talsh123/tokenizer-vivado/HANDOFF.md

# Continuation prompt (RTFC) — FPGA WordPiece Tokenizer

Paste this into the new chat, or just tell the new chat: "read HANDOFF.md and continue."
(RTFC = Role · Task · Format · Context.)

---

## ⭐⭐⭐ CURRENT STATUS — 2026-06-22 (FINAL; READ THIS FIRST; supersedes everything below)

**The #2 correctness fix is VERIFIED ON SILICON — 66/66. The TEMAC license blocker is cleared and the
hardening pass is complete on hardware.** What happened:
- **License:** the build failed only because the Tri-Mode Ethernet MAC **Hardware-Eval** license wasn't
  active at build time. The node-locked eval (`IP:Hardware_Eval`, valid to 19-oct-2026, Version Limit
  2026.10) covers Vivado 2025.2; after a relaunch it was honored. `get_license_status` is not a Tcl
  command in 2025.2 — use the GUI License Manager.
- **Build:** full non-incremental run; `write_bitstream` succeeded (`design_1_wrapper.bit`, 9.7 MB).
  Netlist check: `word_done_count` cells = 6 (>0), `word_done_pending` = 0.
- **On-board (port 7):** all golden vectors correct; **#2 proofs pass** — `summarize a long`→
  `7680 7849 4697 1037 2146` (1037 alone), `vocab t vocab`→`29536 3540 2497 1056 29536 3540 2497`
  (1056 alone). #7 robustness confirmed (empty/punct-only → `boundary-only, skipped`, no hang).
- **Remaining:** apply the book §6 corrections (now real: 64/66→66/66, `word_done_pending`→
  `word_done_count`, 2 reversed vectors, stale file:line cites); user to push the local commits.

Full detail in `JOURNAL.md` → "#2 fix VERIFIED ON SILICON — 66/66".

---

## ⭐⭐ STATUS — 2026-06-22 (earlier; superseded by the FINAL block above)

**The #2 correctness fix is sim-verified 66/66 but NOT yet on silicon. One live blocker: the Ethernet
MAC license.** See `CONTINUATION_PROMPT.md` for the full pick-up brief. Quick state:

- **#2 fix** (`word_done_pending` 1-bit → `word_done_count` 2-bit saturating counter in `trie_engine.v`):
  sim-verified **66/66** (`tb_word_boundary` 8/8, full corpus 66/66, `inspect_mismatch.py` 0). The board
  still runs the **pre-fix** bitstream (returns `along`/`tvocab` for `summarize a long`/`vocab t vocab`).
- **Why not on silicon yet — two build problems, in order:**
  1. **Auto-incremental synthesis** was reusing a pre-fix tokenizer partition → bitstream kept old logic
     even after a "clean" rebuild. FIXED: deleted the stale reference
     `uart.srcs/utils_1/imports/synth_1/design_1_wrapper.dcp` + disable incremental
     (`set_property AUTO_INCREMENTAL_CHECKPOINT 0 [get_runs synth_1]`).
  2. **TEMAC license (LIVE BLOCKER):** the full re-synthesis re-processed `axi_ethernet_0`;
     `write_bitstream` fails `[Common 17-69] tri_mode_eth_mac requires > Design Linking license`. Need the
     free **Tri-Mode Ethernet MAC hardware-evaluation** license (AMD Product Licensing → add eval core →
     node-locked `.lic` → Vivado Help → Manage License → Load License). Eval = time-limited bitstream
     (fine for demo).
- **Verify the fix is in the bitstream BEFORE flashing** (the reliable way — do NOT grep `uart.runs`,
  the `.rpx` reports are binary): `open_run impl_1` then
  `get_cells -hierarchical -filter {NAME =~ *word_done_count*}` must be > 0.
- **Vitis #7/#8/#10** coded + committed (`a403add`, `7b400dc`); pending on-board reverify after the new
  `.xsa`/BSP rebuild (re-run `lwip_echo_server/src/phy_patch/apply_phy_patch.ps1` if the BSP regenerates).
- **Book** (`final_project_book.pdf`) audited: 2 reversed vectors (`tokenization`→`19204 3989`,
  `internationalization`→`2248 3989`), and it describes the pre-fix 64/66 state — update to 66/66 once on
  silicon. Detail in `JOURNAL.md` "Build saga + book verification".

**Next action:** load the TEMAC eval license → `reset_target all [get_files design_1.bd]` →
`generate_target all …` (do not interrupt) → build → `get_cells` check → flash → on-board reverify
(`summarize a long`→`7680 7849 4697 1037 2146`, `vocab t vocab`→`29536 3540 2497 1056 29536 3540 2497`).

---

## ⭐ CURRENT STATUS — 2026-06-21 (read this first; the RTFC below is the original, now stale)

**The entire code review is DONE and VERIFIED ON SILICON — H1, H2, M1, M2, M3, M4, P1, L1, L2, L3 —
plus the embed-class boundary fix and two synthesis-warning cleanups.** Full per-problem record with
verification evidence is in `JOURNAL.md`. Headlines:

- **RTL** (`trie_engine.v`, `pre_tokenizer.v`, `tokenizer_axi_lite.v`): H1/H2/M1 (trie greedy-match
  corner cases), M2 (output-FIFO overflow detect, STATUS bit 2), P1 (pure valid/ready flow control +
  trie input skid + boundary char capture — closes the wasted-handshake-cycles issue), M4 RTL
  (`pipeline_busy` STATUS bit 3), L3 (AXI read `read_addr_serviced` gate), plus the char_buf and
  tok_word_busy synthesis-warning cleanups.
- **Firmware** `echo.c`: M3 (raw-byte forwarding, no synthetic boundary) + M4 (drain-on-
  `pipeline_busy`, boundary-aware final drain — the blind ~500 µs delay is gone).
- **Memory generator** `vocab_parser.py` (in `...\OneDrive\...\BERT\flat_trie_compression`): L1
  (token-id `.mem` written 4-hex to match the 16-bit register).
- **Verification:** `tb_axi_pipeline` green (slow-cadence + new digit cases included); full xsim suite
  passes; **on-board over TCP every known vector is correct** and `2024`→`16798 2549`,
  `abc123`→`5925 12521 2509` match sim exactly with no `[UNK]`. Timing closes clean; the 32 char_buf
  and the token-id width synth warnings are gone.

**⭐ Optimization R2 (AXI-Stream + AXI DMA datapath) is DONE and VERIFIED ON-BOARD (2026-06-21).**
The byte-by-byte AXI-Lite send/drain in `echo.c` is replaced by an AXI DMA: MM2S streams bytes into
the tokenizer's new 8-bit `s_axis`, the 16-bit `m_axis` streams tokens back to S2MM, and firmware
reads the new `TOKEN_COUNT (0x0C)` register for the count. On-board, every golden vector is correct
and latency is **~14× faster than MMIO on the pangram** (~1000 µs → **70 µs**), with the gap widening
on longer input (DMA latency is *flat* ~54–72 µs; MMIO grew linearly). Full record — firmware final
form, the two bring-up bugs, and the results table — is in `JOURNAL.md` (“On-board bring-up &
verification (R2 complete)”). Two bring-up lessons worth carrying forward:
- **Stale/old bitstream masquerades as a hardware fault.** R2 first failed with `TOK_COUNT=0` exactly
  like a broken `s_axis`; two temporary firmware self-tests (MMIO-feed core test + DMA-from-known-DDR
  test) plus a `design_1.hwh` connectivity check proved the hardware was sound — the programmed
  bitstream simply wasn't the final one. Regenerate → re-read `.xsa` → re-apply PHY patches → rebuild.
- **Zero-token transfers hang the DMA.** `m_axis_tlast` rides on a token, so a boundary-only segment
  (telnet sends a word and its `\r\n` as separate TCP segments) produces no token → no TLAST → S2MM
  waits → the lwIP callback stalls → connection abort. Fix: `recv_callback` skips any segment with no
  word character (never launches a 0-token DMA), and the poll timeout was cut 100M→1M as a backstop.

**⭐ FPGA-vs-CPU evaluation is DONE (the report's "why FPGA" data, 2026-06-21).** Full pipeline in
`analysis/` (one shared 66-line corpus → CPU HuggingFace benchmark + FPGA xsim measurement TB →
merge → 5 figures). Headlines: **97% exact word-token match** vs bert-base-uncased (FPGA omits
13.6% punctuation tokens by design); CPU jitter up to **~255 µs** spikes vs FPGA **zero** (cycle-exact
determinism); and energy **~150–285× better per token** (tokenizer fabric **51 mW** via `report_power`
vs measured **~30 W** CPU package on a Ryzen 7 7435HS; 24.0 M vs 84.3 k tokens/Joule). Detail +
numbers + the figure list are in `JOURNAL.md` ("Power / energy result + plots"). **Known limitation
documented:** a one-character word immediately following a multi-subword word is merged with the next
word (`a long`→`along`, hit 2/66 lines) — residual backtracking/boundary state, an H1-class sibling;
deferred as optional (a fix only needs an xsim re-run, no re-flash).

**The embed `[UNK]` "open issue" from the previous handoff is RESOLVED — and it was never an RTL
bug.** The board was running a STALE bitstream: the Vitis run configuration programs a cached
`lwip_echo_server/_ide/bitstream/design_1_wrapper.bit` (it was a month old) while loading a fresh
ELF. **Lesson for next time: when on-board behavior contradicts a clean xsim run, suspect the
programmed bitstream first** — point the Vitis launch config at `uart.runs/impl_1/design_1_wrapper.bit`.

**BSP PHY patches — RE-APPLY AFTER EVERY BSP REGEN (a `.xsa` re-read wipes them):** `xadapter.c`
(`axieth_link_status` first_link/hardcode-100) and `xaxiemacif_physpeed.c` (`get_IEEE_phy_speed`
Realtek `0x001c` branch). Confirm before every board build.

---

## ⭐ HARDENING PASS (2026-06-21): #2 fixed, batch sealed, Vitis items pending

A six-item triage (#1 timing, #2 correctness, #7 zero-token DMA, #8 cache, #9 calib reset, #10 PHY).
Rule: verify all RTL/BD in sim → ONE implementation run → Vitis items. Status:

| # | Item | Resolution |
|---|---|---|
| #2 | 1-char-word merge | **FIXED, VERIFIED ON SILICON 66/66** (2026-06-22, `word_done_count` counter). |
| #1 | WNS −0.374 ns | **Documented benign** — ASYNC_REG CDC syncs inside the AMD Ethernet MAC; user logic +0.6 ns. No change. |
| #7 | zero-token DMA TLAST | **DONE in `echo.c`** (Vitis `a403add`): `has_word` guard kept + `tokenizer_dma_recover()` resets the DMA on MM2S/S2MM timeout. Pending on-board verify. |
| #9 | `init_calib_complete` | **DEFERRED** — correct fix is AND it with `clk_wiz_1/locked` into `rst_clk_wiz_1_100M/dcm_locked` (NOT the MIG reset block); reset surgery, theoretical race, deferred to protect the one run. BD restored to known-good. |
| #8 | cache invalidate `ntok×2` | **DONE in `echo.c`** (Vitis `a403add`): post-transfer invalidate sized to `ntok×2` (TOK_COUNT read first), not the full 2 KB. Pending on-board verify. |
| #10 | durable PHY patch | **DONE** (Vitis `a403add`/`7b400dc`): canonical `*.c.golden` copies in `lwip_echo_server/src/phy_patch/` + `apply_phy_patch.ps1` one-command re-apply after any BSP regen (`.golden` ext stops the IDE auto-adding them → would dup-link). |

**Phase-1 Vivado batch = just #2; Vitis #7/#8/#10 are coded + committed.**

**⚠️ CRITICAL build step (cost a whole build+flash cycle on 2026-06-21):** the tokenizer is a Vivado
`module_ref`. After editing `trie_engine.v`/`pre_tokenizer.v`/`tokenizer_axi_lite.v`, **Reset Output
Products → Generate Output Products (Global) → `reset_run synth_1`** BEFORE Generate Bitstream — else
synthesis reuses the cached pre-edit netlist and the bitstream silently keeps OLD logic (source + sim
look fixed; the board runs old behavior, and golden vectors mask it). **Verify before flashing** (use
`get_cells`, NOT grep — the `.rpx` reports are binary and false-match): `open_run impl_1` then
`get_cells -hierarchical -filter {NAME =~ *word_done_count*}` must be >0 and `*word_done_pending*` must
be 0. The actual root cause turned out to be auto-incremental synthesis (not module-ref caching) — see
memory `vivado-module-ref-stale-synth` and JOURNAL "stale module-ref synthesis catch".

**On-board reverify status — DONE (2026-06-22):** golden vectors confirmed on silicon
(tokenizer/DMA/Ethernet all good) **and** the #2 fix verified on the board —
`summarize a long`→`7680 7849 4697 1037 2146` and `vocab t vocab`→`29536 3540 2497 1056 29536 3540 2497`
(1037/1056 standing alone). **66/66 on silicon.** Full detail in `JOURNAL.md` ("#2 fix VERIFIED ON
SILICON" + "On-board reverify" + "Bug #2 fixed" + "Vitis hardening").

**Tooling (in `analysis/`):** `run_all_tbs.tcl` runs all 12 testbenches in one action with a PASS/FAIL
summary; `gen_reports.tcl` regenerates post-impl utilization + timing (+ copies the `constrs_1` xdc).
If a Generate-Bitstream run shows `CRITICAL WARNING [BD 41-759] … s_axis_tvalid tied-off`, the
DMA→tokenizer input came unwired (module-ref staleness) — reconnect `axi_dma_0/M_AXIS_MM2S →
tokenizer_axi_lite_0/s_axis` and re-validate before flashing.

---

## ⭐ STAGE 5 — Partner evidence pack (2026-06-21): WHERE EVERYTHING RAFI ASKED FOR IS SAVED

**All P0 (book-blocking) deliverables are DONE, plus P1 #11 (waveform).** The single source of truth
is **`analysis/evidence/EVIDENCE_INDEX.md`** — it maps every deliverable → status → file → book
chapter, and has a capture-checklist for anything still outstanding. Quick access map:

| Rafi's deliverable | Saved at | How to open / regenerate |
|---|---|---|
| Six graphs (data + scripts) | `analysis/figures/*.png`, data `analysis/results/*.csv`, scripts `analysis/*.py` | `py ./plot_results.py` (figures); §A of the index maps each figure→CSV→script |
| Energy calculation sheet | `analysis/evidence/ENERGY_CALCULATION.md` | open in any markdown viewer; inputs in `results/power.csv` + `results/power_fpga.rpt` |
| DMA latency sweep | sim: `analysis/results/fpga_results.csv` (66-pt); board: 54–72 µs (JOURNAL "R2 complete") | `py ./gen_corpus_tb.py` → run `tb_corpus_perf` in xsim |
| CPU benchmark (script/log/settings) | `analysis/evidence/BENCHMARK_SETUP.md` + `analysis/cpu_tokenizer_benchmark.py` + `results/cpu_results.csv`, `results/cpu_throughput.csv` | `py ./cpu_tokenizer_benchmark.py` |
| Corpus + 2/66 mismatch list | `analysis/corpus.txt` + `analysis/evidence/MISMATCH_REPORT.md` | `py ./inspect_mismatch.py` to re-decode |
| `report_utilization` | `analysis/results/utilization_impl.rpt`, `utilization_hier.rpt` | `source analysis/gen_reports.tcl` (Vivado, project open) |
| `report_timing_summary` + `.xdc` | `analysis/results/timing_summary.rpt`, `timing_worst_paths.rpt`, `Nexys-Video-Master.xdc` | same script; WNS **−0.374 ns** (does not fully close — see below) |
| Block design screenshot | `analysis/figures/block_design.jpg` | open image |
| Address Editor screenshot | `analysis/figures/address_editor.jpg` | open image |
| `tb_axi_dma` PASS transcript | `analysis/evidence/tb_axi_dma_transcript.txt` | re-run: set `tb_axi_dma` top → `restart; run all` (NOT a bare `run all` — that hits a stale-snapshot 5 ms timeout) |
| DMA waveform (m_axis_tlast/TOKEN_COUNT) | `analysis/figures/waveform.jpg` | open image |

**One-shot Vivado report dump:** `source c:/Users/talsh/.Xilinx/projects/uart/analysis/gen_reports.tcl`
(writes utilization + timing + copies the user `.xdc` into `analysis/results/`, prints headline WNS).

### Stage 5 OPEN ITEMS (remaining — none block the P0 book chapters)
- **P1 #12 — board TCP regression log:** optional; telnet the corpus, capture the UART `DMA total: …
  µs | Tokens: …` lines → `analysis/evidence/board_tcp_regression.txt`. Turns the 3-point board
  latency into a real sweep.
- **P1 #13 — Route B (Quartus/Icarus) artifacts:** the partner's *other* implementation route, NOT in
  this repo. Rafi/partner owns this.
- **P1 #14 — Mermaid → PNG/SVG:** the architecture diagrams live in the **book draft**, not this repo;
  export each via mermaid.live (PNG **and** SVG) for Word/PDF. Book-side task.
- **P2 #15 — board photo + demo screenshot:** optional, for the defense.
- **Waveform input EOP (cosmetic):** `figures/waveform.jpg` shows the output `m_axis_tlast`; an
  optional left-scroll snip of the input burst would also show `s_axis_tlast`.

### Documented honest limitation (state, don't hide, in the report)
1. **Timing does not fully close:** WNS −0.374 ns on 2 of 87,343 endpoints. The board runs correctly
   (those paths have margin under real conditions); full closure is future work. Inspect with
   `analysis/results/timing_worst_paths.rpt`.

(The former item 2 — the 1-char-word-after-multipiece bug, `a long`→`along`, `t vocab`→`tvocab` — is
**no longer a limitation: fixed and verified on silicon 2026-06-22** (`word_done_count` counter,
66/66). Detail in `MISMATCH_REPORT.md` and JOURNAL "#2 fix VERIFIED ON SILICON".)

---

## 🔜 OPEN ITEMS — handoff to Rafi

**✅ DONE — DMA instead of byte-by-byte AXI-Lite polling (optimization R2).** Verified on-board
2026-06-21 (~14× faster on the pangram; details above and in `JOURNAL.md`). The byte-banging is gone:
the tokenizer IP has 8-bit `s_axis` / 16-bit `m_axis` stream ports + a `TOKEN_COUNT (0x0C)` register,
an AXI DMA moves bytes/tokens, and `echo.c`'s `recv_callback` does one DMA round-trip per segment.
The remaining R2-adjacent niceties are optional (see below).

**✅ DONE — the three final-report "why FPGA" deliverables below are all COMPLETE** (2026-06-21; data
+ figures in `analysis/`, numbers in `JOURNAL.md` → "Power / energy result + plots"). The original
task descriptions are kept here for reference; what's left is report write-up only. Quick status:
(1) performance comparison ✅ (latency core-vs-overhead + throughput + jitter, real corpus);
(2) power/energy ✅ (`report_power` 51 mW vs measured CPU ~30 W → ~150–285× tokens/Joule);
(3) measurement→CSV→plots pipeline ✅ (`analysis/*.py`, `results/*.csv`, `figures/*.png`).

**Original task detail (now done — for reference; these were the report's "why FPGA" argument).
The CPU-vs-FPGA benchmark script lives at `analysis/cpu_tokenizer_benchmark.py`:**

1. **Fair FPGA-vs-CPU performance comparison (apples-to-apples).** The existing `tb_perf_measurement`
   number is NOT pure fabric latency despite its header: `hw_cycles` includes the AXI-Lite send
   cadence (`tok_send_byte` ~10 cyc/byte) and fixed `repeat(500)`/`repeat(2000)` wait loops, so it
   *over*-states FPGA latency (the real win is bigger). To make it fair:
   - **FPGA side:** measure the *true fabric latency* — first character into the trie
     (`pt_out_char_valid`) to the last token emitted (`tok_out_valid`), with input fed at full speed
     (1 byte/clock via the `s_axis` stream / DMA), not the slow AXI-Lite send. Needs a clean
     measurement TB (can reuse the 3 sentences below and the internal-signal probe approach).
   - **CPU side:** the benchmark script uses `BertTokenizer` (the SLOW pure-Python tokenizer) but the
     write-up calls it "Rust-accelerated" — that's `BertTokenizerFast`. Use `BertTokenizerFast` (or
     `AutoTokenizer`) for the fair comparison and **attach the actual console output** to the report.
   - **Framing:** state the CPU clock (~3-5 GHz) next to the FPGA's 100 MHz (the headline is
     specialized HW winning at ~1/30th the clock); fold in the Test-2 16-vs-15 sim artifact as a
     noted caveat (it inflates that test's cycle count).
   - Same 3 sentences as `tb_perf_measurement`: pangram (9 tok), "unquestionably the embedding..."
     (15 tok), "machine learning..." (44 tok). CPU baselines used so far: 26.7 / 99.5 / 180.4 us.

2. **Power-consumption comparison (perf-per-watt is the real FPGA argument).** Latency is only half
   the story; the stronger case for a specialized datapath is energy. To do:
   - **FPGA side:** Vivado **`report_power`** (post-implementation, ideally with realistic switching
     activity / a SAIF captured from the perf simulation) for the tokenizer's dynamic + static power;
     a board-level measurement if feasible.
   - **CPU side:** the CPU's power during tokenization (package power / TDP, or a measured figure).
   - Report it as **energy per tokenization** (latency x power) or tokens/Joule, not just watts — a
     100 MHz datapath should crush a multi-GHz CPU on energy even where latency is close.

3. **Automated measurement -> CSV -> plotting pipeline (the report's figures).** Tie tasks 1 and 2
   together with reproducible data + graphs:
   - **TB -> CSV:** the measurement testbench uses `$fopen`/`$fwrite`/`$fclose` to emit one row per
     test -- sentence name, char count, token count, fabric cycles, fabric latency (ns @ 100 MHz),
     throughput (chars/s, tokens/s). NOTE: the FPGA fabric is **deterministic** (identical cycle
     count every run -> zero jitter; a hard real-time guarantee). **Jitter is a CPU metric** -- get
     it from the Python benchmark's distribution (min/max/std over the 10000 runs).
   - **Python benchmark -> CSV:** per sentence, the `BertTokenizerFast` latency stats (avg, min, max,
     std).
   - **Vivado `report_power` -> FPGA power**; CPU package power/TDP for the CPU side (power is NOT
     available from simulation -- separate source merged in the script).
   - **Plotting script (pandas + matplotlib):** latency FPGA-vs-CPU (CPU with jitter error bars,
     FPGA as a deterministic point/line), speedup vs input length, and energy-per-tokenization /
     tokens-per-Joule. These become the headline report figures.

**OPTIONAL — NOT required for the final report (do only if time allows):**
- **R2 follow-up — tighten the post-transfer cache invalidate.** `tokenizer_dma_run` invalidates the
  full 2 KB token buffer (`MAX_TOKENS*2`) every call; invalidating only `ntok*2` bytes after the
  count is known would cut the fixed overhead that dominates the small-input latency (the flat
  ~54–72 µs), sharpening the DMA-vs-MMIO curve for the report.
- **R2 follow-up — cross-segment word reassembly in DMA mode.** The DMA `recv_callback` treats each
  TCP segment as self-contained (it appends `\n` to flush a mid-word segment), so a word *deliberately*
  split across two TCP segments tokenizes per-segment instead of being rejoined (the old MMIO M3
  behavior). Telnet/line-buffered input is unaffected; only matters for clients that split a word.
  Re-add by buffering received bytes until a real boundary before launching the DMA.
- **Connect `init_calib_complete`** in the Vivado block design (currently floating). Wiring it in —
  e.g. gating the processor/system reset — prevents the CPU touching DDR3 before the MIG finishes
  calibration. Real robustness fix, BD-level.
- **`tb_perf_measurement` Test 2 = 16 tokens vs 15** — a simulation-only timing artifact (hardware
  gives the correct 15). Now folded into the performance-comparison task above (note it as a caveat
  or fix the TB timing when redoing the measurement).
- **Elegant RTL8211E PHY bring-up** — the BSP patches are the pragmatic fix; a proper fix implements
  the full RTL8211E auto-negotiation register sequence so the stock-BSP-vs-RTL8211E mismatch is
  handled cleanly. Future work / report discussion only.
- **Relocate the 9 `.mem` files out of `C:/Users/talsh/Downloads/`** into the project tree. The
  `.xpr` sources them from `$PPRDIR/../../../Downloads/*.mem` — functional but fragile (a cleared
  Downloads folder breaks the build). Recommended before final submission.
- Cosmetic: remove the `===== TEMP DEBUG PROBE =====` block in `tb_axi_pipeline.v` for the final
  clean version (kept for now; harmless).

**Vivado/Vitis gotchas (still apply):** the editor buffer can overwrite disk on sim launch and xsim
reuses stale compiled snapshots — **Reset** the sim/run to force a real recompile, and close a file
in the Vivado editor before editing it externally. After any RTL change: regenerate the bitstream,
re-export the `.xsa`, AND re-point the Vitis launch config at the fresh
`impl_1/design_1_wrapper.bit` before programming (re-applying the BSP PHY patches after the BSP regen).

---

## ROLE
You are an experienced FPGA / digital-design and embedded-firmware engineer taking
over an in-progress hardening + optimization effort on a hardware **BERT WordPiece
tokenizer**. You think in clock cycles, FSM states, BRAM ports, and AXI handshakes;
you write synthesizable Verilog and MicroBlaze C; you work **one problem at a time**
and keep an engineering journal for the user's final report (the user is a student;
their partner and professor will read the code and journal).

## TASK
Continue the work.

**Immediate step:** the user is re-running `tb_axi_pipeline` in Vivado after a fix.
Interpret that transcript first.
- If it prints `AXI PIPELINE TESTS PASSED`: mark **P1** and **M4** verified in
  `JOURNAL.md`, then move to the next pending item.
- If it fails: the TB now prints the actual token IDs per test and flushes leftovers
  between tests, so use the printed values to tell apart (a) a remaining
  `pipeline_busy` timing issue from (b) a real tokenization regression in the **P1**
  pre-tokenizer redesign (a duplicated/lost character shows as specific wrong IDs),
  and fix it.

Then continue the remaining items (see Context → PENDING). For every new problem:
give the user a short plain-language **background + which engineering field it
belongs to**, apply a **surgical** fix, add a `JOURNAL.md` entry, and (for RTL)
write/extend a self-checking testbench.

## FORMAT
- Per problem: (1) plain background + engineering discipline; (2) the fix as
  minimal RTL/C edits; (3) a `JOURNAL.md` entry (engineering field, background,
  defect, fix, verification plan, status); (4) a Vivado/board verification plan
  (+ testbench if RTL).
- Be concise; recommend a path, don't over-survey.
- **Verification is ALWAYS done by the user** — Vivado xsim for RTL, board + TCP
  (telnet/netcat to port 7) for firmware. You author tests and instructions; the
  user runs them and pastes results. After each result, update the journal status.

## CONTEXT

**Working dir:** `c:\Users\ENTEL\FPGA tal` (NOT a git repo). Three sub-projects:
- `tokenizer-vivado/` — the RTL. Custom IP `tokenizer_axi_lite` wraps
  `top_tokenizer` → `pre_tokenizer` + `trie_engine`. Hand-written sources in
  `uart.srcs/sources_1/new/`, testbenches in `uart.srcs/sim_1/new/`.
- `tokenizer-csr/` — Python `vocab_parser.py` builds the dual CSR tries and emits
  the `.mem` files from `vocab.txt` (bert-base-uncased, 30,522 tokens).
- `tokenizer-vitis/` — MicroBlaze firmware `lwip_echo_server/src/echo.c`: a TCP
  server on port 7 that streams text to the IP and returns token IDs.

**READ THESE FIRST (source of truth, in the working dir):**
- `JOURNAL.md` — full per-problem record (every fix, with verification + status).
- `CODE_REVIEW.md` — the original findings (H1, H2, M1–M4, L1–L3).
- `OPTIMIZATION_OPTIONS.md` — speed/efficiency options (F1 done; A1, A2, A3, C1,
  D1, R1, R2, F2, F3, E1 pending — pursue only if the user asks).
- The auto-loaded memory files (`toolchain-vivado-only`,
  `comment-style-no-internal-ids`).

**HARD CONVENTIONS (also in memory — do not violate):**
- **Vivado only.** Do NOT run the locally-installed ModelSim/Intel tools (not even
  for a syntax check). Do NOT alter the canonical `tokenizer-csr/*.mem` files for
  any simulator's sake.
- **Comments in synthesizable RTL** must be plain and self-explanatory for the
  partner/professor — **no internal IDs** (no `H1`/`M1`/`FIX:`/`(M2)` etc.). The
  bug→fix mapping lives in `JOURNAL.md`. Testbenches may keep their `H1/M1/M2`
  labels (the user chose to leave those).
- **Output token IDs must always stay identical to HuggingFace bert-base-uncased.**
- Verify edits by re-reading; check `begin/end`, `task/endtask`, `module/endmodule`
  balance (e.g. `sed 's://.*::' f.v | grep -ow begin|wc -l`) since you can't run a
  compiler here.

**ARCHITECTURE (quick):** TCP → input FIFO (256×8) → `pre_tokenizer` (lowercase,
10-bit char map, boundary detect, **pure valid/ready flow control**) → `trie_engine`
(greedy longest-match WordPiece over two CSR tries — root 56,719 nodes/56,718 edges,
continuation 7,864/7,863; per trie 4 BRAM arrays: row_ptr 32b, edges 32b,
is_terminal 8b, token_ids 16b; 10-state FSM doing a binary search per node; 32×10
LUTRAM backtracking buffer) → output FIFO (256×16) → AXI-Lite → MicroBlaze.
**STATUS register bits:** 0 = input has space, 1 = token available, 2 = output
overflow (sticky; write to STATUS clears it), 3 = pipeline_busy.

**DONE & VERIFIED in Vivado (details in JOURNAL):**
- **H1** spurious `[UNK]`/dropped token at a word boundary during backtracking (trie FSM).
- **H2** binary-search index underflow at node 0 (trie).
- **M1** word longer than the 32-entry buffer → safe single `[UNK]` (trie).
- **M2** silent output-FIFO overflow → sticky detect flag on STATUS bit 2 (axi wrapper).

**DONE, AWAITING VERIFICATION:**
- **M3** (`echo.c`): forward raw bytes, no per-TCP-segment synthetic boundary →
  words split across segments tokenize correctly. Needs an on-board TCP check.
- **M4** (`echo.c` + RTL): replaced the ~500 µs blind drain delay with a real
  `pipeline_busy` (STATUS bit 3) + drain-while-sending; this also closes M2's
  *prevention* side. Needs Vivado + on-board check.
- **P1** (`pre_tokenizer` + `trie_engine`): removed the pre-tokenizer's two-phase
  word-boundary ack handshake (now pure valid/ready flow control); the trie lowers
  `ready` on `S_IDLE→S_EMIT`; the trie exposes a `busy` output.
- **CURRENT DEBUG STATE:** `tb_axi_pipeline`'s first run FAILED → diagnosed a
  1-cycle `pipeline_busy` *false-idle* at word boundaries (the `out_word_done`
  pulse ended at cycle T but the trie lowered `ready` only at T+2) → **fixed** by
  driving `pipeline_busy` from the trie's new
  `busy = (state!=S_IDLE) || !ready || replaying || word_done_pending`
  (`top_tokenizer`: `pipeline_busy = pt_busy || trie_busy`). TB hardened to print
  token IDs and isolate tests. **Re-run is pending — interpret it before anything else.**

**TESTBENCHES** (`uart.srcs/sim_1/new/`): `tb_fixes.v` (H1/H2/M1 — passed),
`tb_m2_overflow.v` (M2 — passed), `tb_axi_pipeline.v` (P1/M4 — re-run pending).
The original tbs (`tb_trie_engine`, `tb_top_tokenizer`, `tb_tokenizer_axi_lite`,
`tb_pre_tokenizer`, `tb_perf_measurement`) are unchanged; note `pre_tokenizer` and
`top_tokenizer` gained output ports, so those two original tbs now show a harmless
"unconnected output" warning.

**PENDING after `tb_axi_pipeline`:**
1. On-board (TCP) verification of M3 + M4 (latency drop vs old build; split-word
   correctness — e.g. send `embed`, pause, `ding\n` → expect `embedding`).
2. Remaining review items: **L1** (`.mem` hex widths don't match reg widths —
   cosmetic in Vivado, only via the Python generator), **L3** (AXI read re-triggers
   if a master holds `arvalid` — minor robustness).
3. Optional optimizations from `OPTIMIZATION_OPTIONS.md` — only if the user asks.

**Known-good token vectors** (for tests): `hello`→7592; `hardware`→8051;
`embedding`→7861 8270 4667; `unquestionably`→4895 15500 3258 8231;
`hello hardware`→7592 8051; `the quick brown fox jumps over the lazy dog`→
1996 4248 2829 4419 14523 2058 1996 13971 3899.
