talsh123/tokenizer-vivado/analysis/figures/address_editor.jpg

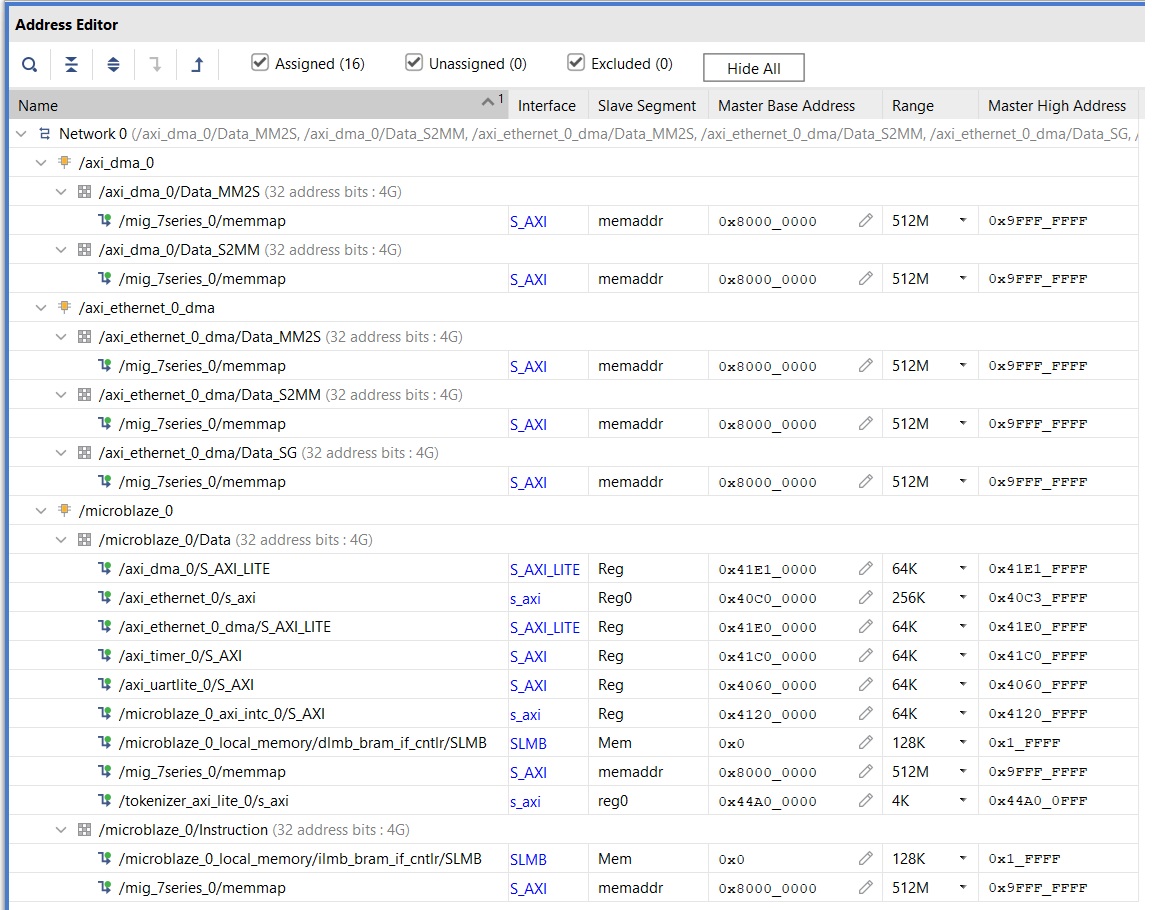
analysis/figures/address_editor.jpg
