talsh123/tokenizer-vivado/analysis/figures/block_design.jpg

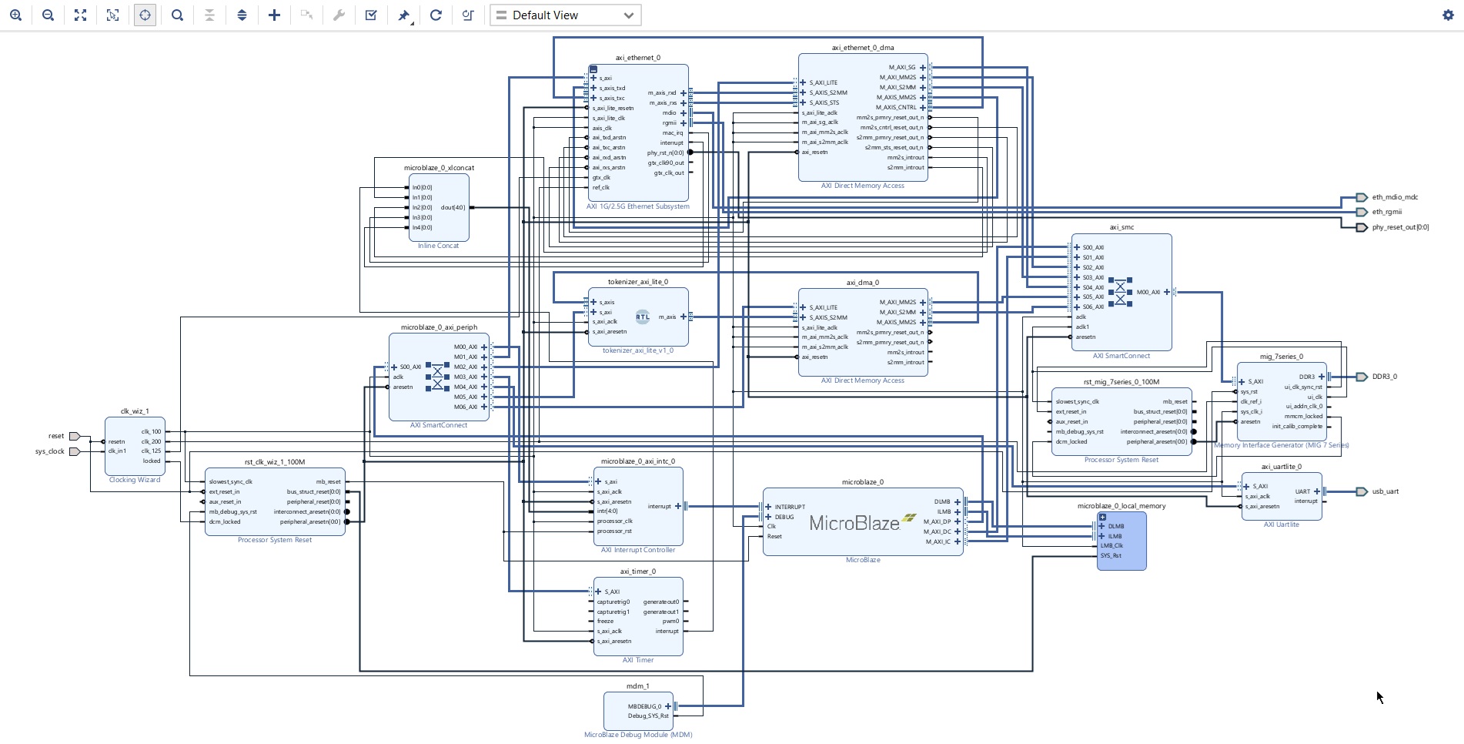
analysis/figures/block_design.jpg
