talsh123/tokenizer-vivado/analysis/figures/correctness.png

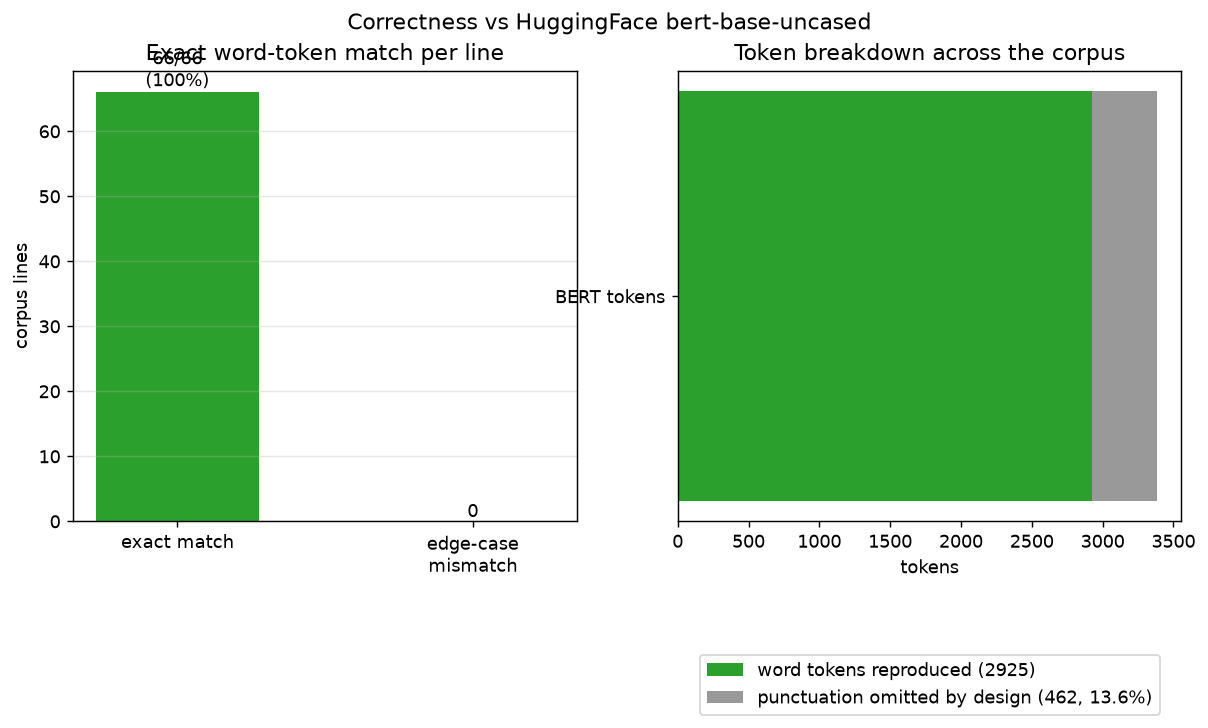
analysis/figures/correctness.png
