talsh123/tokenizer-vivado/analysis/figures/energy_per_million.png

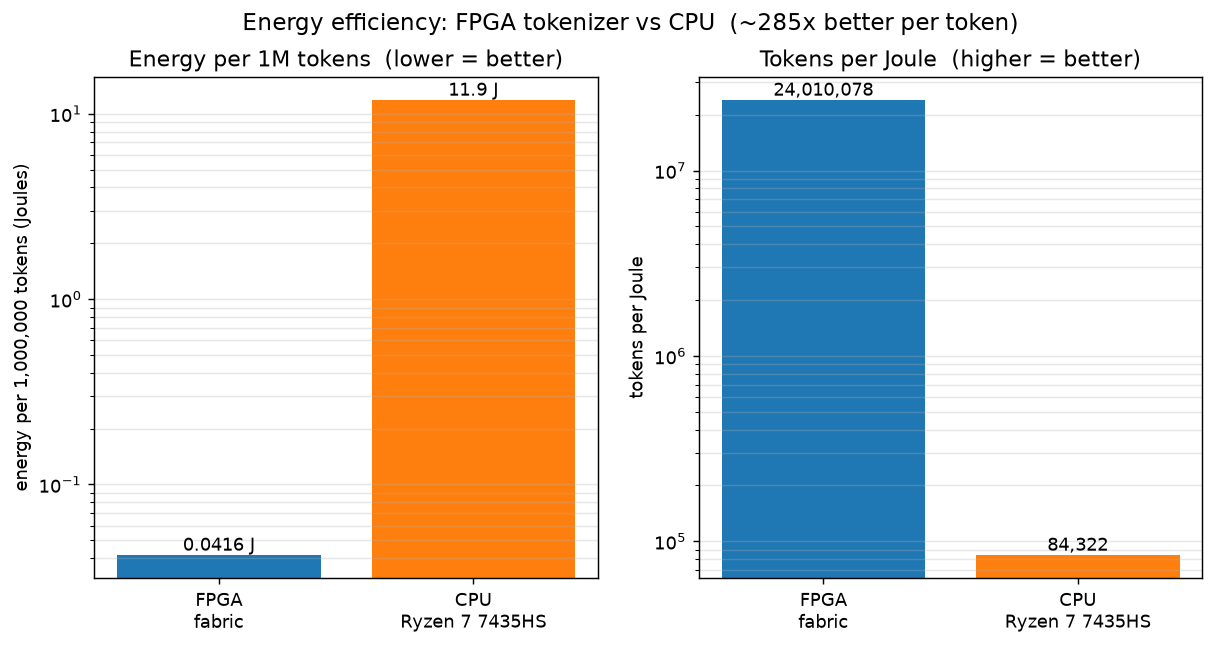
analysis/figures/energy_per_million.png
