talsh123/tokenizer-vivado/analysis/figures/jitter_vs_length.png

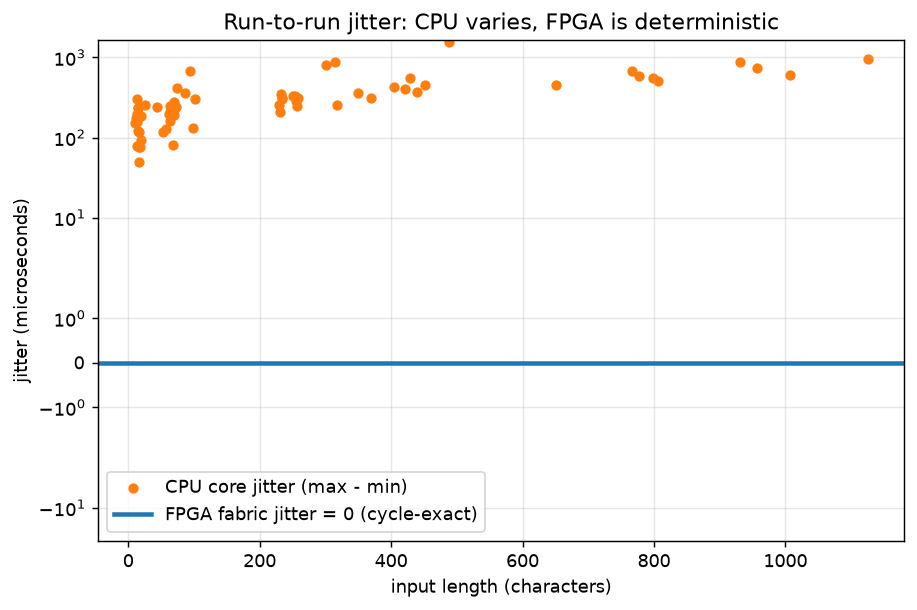
analysis/figures/jitter_vs_length.png
