talsh123/tokenizer-vivado/analysis/figures/latency_vs_length.png

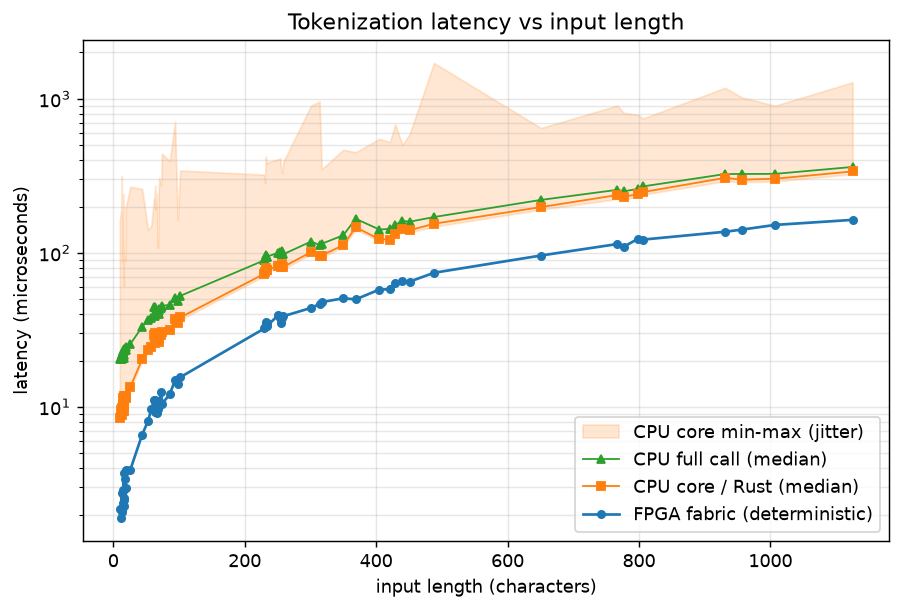
analysis/figures/latency_vs_length.png
