talsh123/tokenizer-vivado/analysis/figures/throughput.png

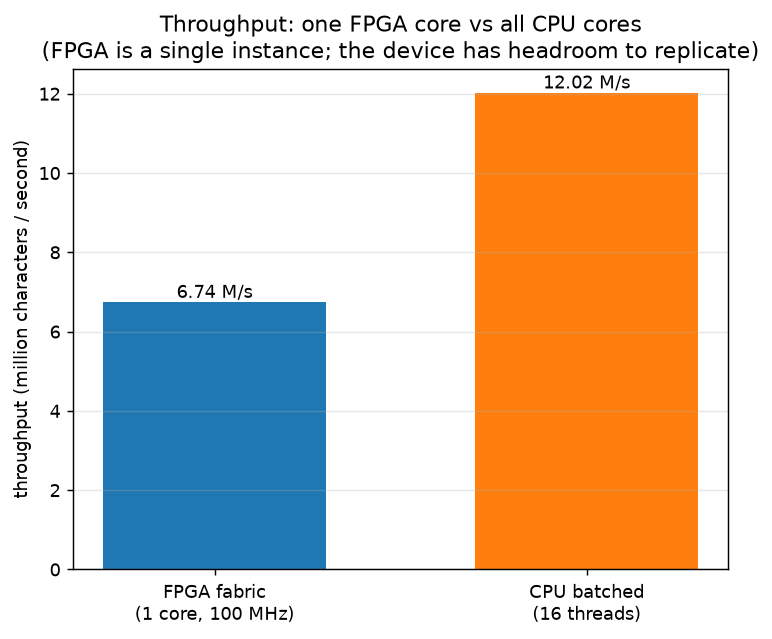
analysis/figures/throughput.png
