talsh123/tokenizer-vivado/analysis/figures/waveform.jpg

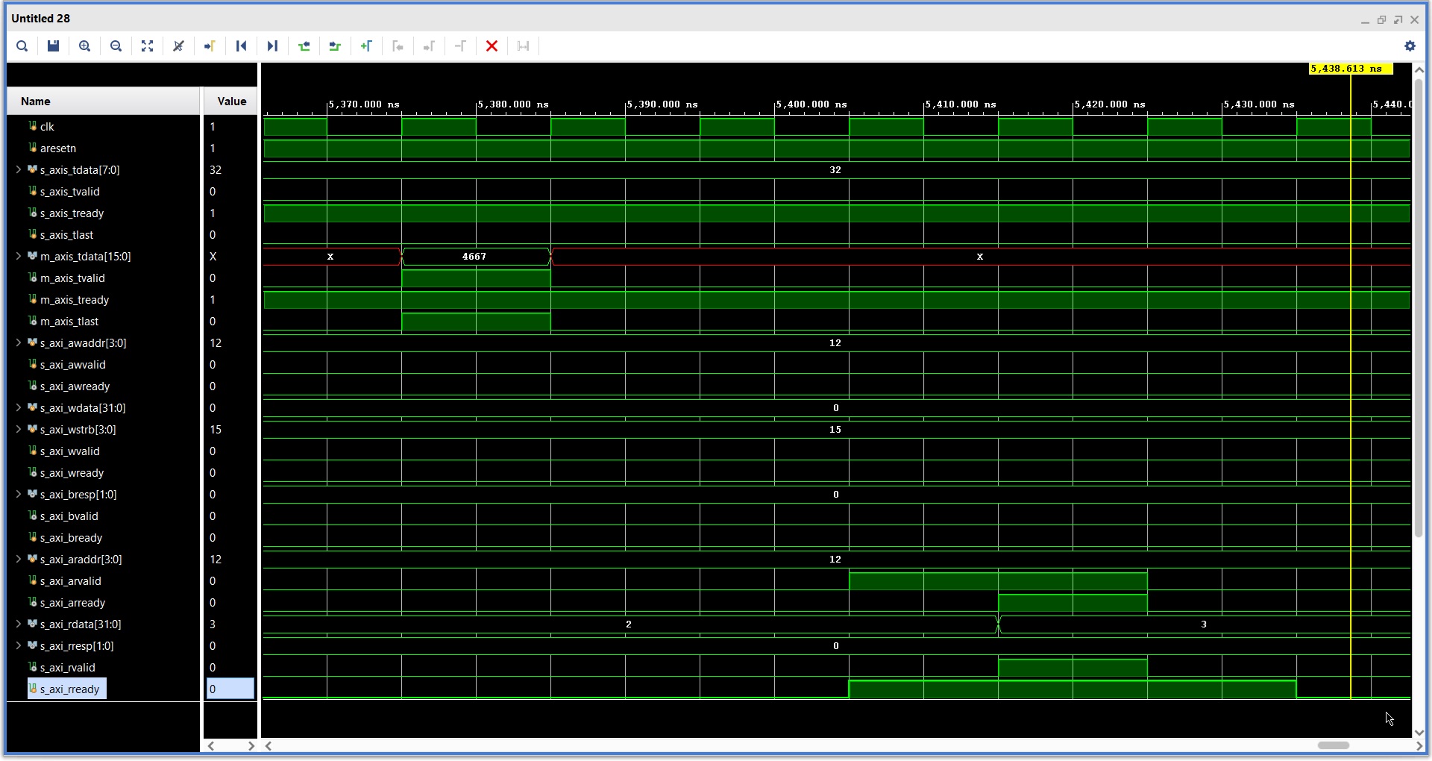
analysis/figures/waveform.jpg
