talsh123/tokenizer-vivado/analysis/results/cpu_throughput.csv

cpu | threads | tokens_per_sec | chars_per_sec | batch_reps | corpus_lines
AMD64 Family 25 Model 68 Stepping 1, AuthenticAMD | 16 | 2529664.0 | 12023932.8 | 100 | 66
