talsh123/tokenizer-vivado/analysis/tokenizer_benchmark.csv

text | chars | tokens | cpu_fast_us | cpu_slow_us | fpga_dma_us
pangram | 43 | 9 | 31.5 | 31.6 | 70.0
subword | 69 | 11 | 37.0 | 36.9 | 54.0
paragraph | 156 | 24 | 62.6 | 62.4 | 72.0
