talsh123/tokenizer-vivado/analysis/results/comparison.csv

idx | chars | bert_tokens | expected_tokens | fpga_tokens | punct_tokens | match | cpu_core_us | cpu_core_min_us | cpu_core_max_us | cpu_core_jitter_us | cpu_ovh_us | cpu_ovh_jitter_us | fpga_cycles | fpga_us
0 | 16 | 5 | 5 | 5 | 0 | 1 | 11.8 | 11.4 | 61.3 | 49.9 | 23.9 | 155.3 | 256 | 2.56
1 | 19 | 4 | 4 | 4 | 0 | 1 | 11.4 | 11.1 | 103.4 | 92.3 | 23.4 | 216.4 | 298 | 2.98
2 | 14 | 3 | 3 | 3 | 0 | 1 | 9.2 | 8.8 | 163.3 | 154.5 | 21.3 | 95.2 | 277 | 2.77
3 | 16 | 5 | 5 | 5 | 0 | 1 | 10.9 | 10.6 | 86.4 | 75.8 | 23.1 | 304.1 | 375 | 3.75
4 | 26 | 6 | 4 | 4 | 2 | 1 | 13.5 | 13.0 | 268.5 | 255.5 | 25.6 | 205.1 | 391 | 3.91
5 | 19 | 5 | 5 | 5 | 0 | 1 | 11.7 | 11.3 | 195.5 | 184.2 | 24.4 | 233.7 | 388 | 3.88
6 | 44 | 10 | 9 | 9 | 1 | 1 | 20.4 | 19.8 | 260.0 | 240.2 | 33.1 | 342.8 | 661 | 6.61
7 | 94 | 22 | 20 | 20 | 2 | 1 | 37.0 | 35.9 | 712.4 | 676.5 | 51.2 | 238.6 | 1492 | 14.92
8 | 62 | 23 | 18 | 18 | 5 | 1 | 29.2 | 28.2 | 223.6 | 195.4 | 44.5 | 424.3 | 1106 | 11.06
9 | 86 | 15 | 14 | 14 | 1 | 1 | 31.6 | 30.6 | 393.1 | 362.5 | 45.9 | 603.1 | 1207 | 12.07
10 | 102 | 22 | 20 | 20 | 2 | 1 | 38.1 | 36.8 | 342.8 | 306.0 | 52.6 | 278.5 | 1559 | 15.59
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
