talsh123/tokenizer-vivado/analysis/results/cpu_results.csv

idx | chars | bert_tokens | fpga_expected_tokens | punct_tokens | core_median_us | core_min_us | core_max_us | core_std_us | core_p99_us | core_jitter_us | ovh_median_us | ovh_min_us | ovh_max_us | ovh_std_us | ovh_p99_us | ovh_jitter_us | bert_ids | fpga_expected_ids
0 | 16 | 5 | 5 | 0 | 11.8 | 11.4 | 61.3 | 1.923 | 19.6 | 49.9 | 23.9 | 22.9 | 178.2 | 5.628 | 52.3 | 155.3 | 2129 2000 5495 1037 5495 | 2129 2000 5495 1037 5495
1 | 19 | 4 | 4 | 0 | 11.4 | 11.1 | 103.4 | 3.317 | 24.0 | 92.3 | 23.4 | 22.3 | 238.7 | 7.712 | 55.1 | 216.4 | 4633 1999 2047 2259 | 4633 1999 2047 2259
2 | 14 | 3 | 3 | 0 | 9.2 | 8.8 | 163.3 | 3.729 | 18.7 | 154.5 | 21.3 | 20.3 | 115.5 | 5.321 | 51.3 | 95.2 | 3945 2397 9407 | 3945 2397 9407
3 | 16 | 5 | 5 | 0 | 10.9 | 10.6 | 86.4 | 2.716 | 22.7 | 75.8 | 23.1 | 21.9 | 326.0 | 7.584 | 54.4 | 304.1 | 5310 4748 10020 8833 2378 | 5310 4748 10020 8833 2378
4 | 26 | 6 | 4 | 2 | 13.5 | 13.0 | 268.5 | 4.593 | 27.1 | 255.5 | 25.6 | 24.5 | 229.6 | 9.275 | 62.3 | 205.1 | 2307 4031 1010 2573 2092 999 | 2307 4031 2573 2092
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
