talsh123/tokenizer-vivado/analysis/results/fpga_results.csv

idx | chars | tokens | fabric_cycles | input_cycles | fpga_ids
0 | 16 | 5 | 256 | 17 | 2129 2000 5495 1037 5495
1 | 19 | 4 | 298 | 20 | 4633 1999 2047 2259
2 | 14 | 3 | 277 | 15 | 3945 2397 9407
3 | 16 | 5 | 375 | 17 | 5310 4748 10020 8833 2378
4 | 26 | 4 | 391 | 27 | 2307 4031 2573 2092
5 | 19 | 5 | 388 | 20 | 2707 1996 4773 8043 6299
6 | 44 | 9 | 661 | 45 | 1996 4248 2829 4419 14523 2058 1996 13971 3899
7 | 94 | 20 | 1492 | 95 | 1045 4149 2023 12586 2121 2197 2733 1998 1996 5013 5296 2041 2006 1996 2034 2224 4468 2012 2035 5366
8 | 62 | 18 | 1106 | 63 | 7561 1014 2595 2509 2497 4434 2051 5833 2012 17613 16923 1015 1019 4008 2509 2044 11910 5244
9 | 86 | 14 | 1207 | 87 | 2425 2033 1037 8257 2055 1037 20273 2040 2515 2025 3305 8051 10984 14679
10 | 102 | 20 | 1559 | 103 | 2000 3183 2009 2089 5142 1045 2572 3015 2000 1999 15549 2890 2055 1996 2330 2597 1999 1996 3330 2533
11 | 98 | 16 | 1415 | 99 | 2291 5060 5115 6032 2097 5258 2012 7090 5987 2039 2000 2702 2781 1997 2091 7292
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
