talsh123/tokenizer-vivado/uart.gen/sources_1/bd/design_1/synth/design_1.v

//Copyright 1986-2022 Xilinx, Inc. All Rights Reserved.
//Copyright 2022-2025 Advanced Micro Devices, Inc. All Rights Reserved.
//--------------------------------------------------------------------------------
//Tool Version: Vivado v.2025.2 (win64) Build 6299465 Fri Nov 14 19:35:11 GMT 2025
//Date        : Mon Jun 22 01:51:42 2026
//Host        : Talsh running 64-bit major release  (build 9200)
//Command     : generate_target design_1.bd
//Design      : design_1
//Purpose     : IP block netlist
//--------------------------------------------------------------------------------
`timescale 1 ps / 1 ps

(* CORE_GENERATION_INFO = "design_1,IP_Integrator,{x_ipVendor=xilinx.com,x_ipLibrary=BlockDiagram,x_ipName=design_1,x_ipVersion=1.00.a,x_ipLanguage=VERILOG,numBlks=22,numReposBlks=21,numNonXlnxBlks=0,numHierBlks=1,maxHierDepth=1,numSysgenBlks=0,numHlsBlks=0,numHdlrefBlks=1,numPkgbdBlks=0,bdsource=USER,da_aeth_cnt=1,da_axi4_cnt=3,da_board_cnt=1,da_clkrst_cnt=3,da_mb_cnt=4,synth_mode=None}" *) (* HW_HANDOFF = "design_1.hwdef" *) 
module design_1
   (DDR3_0_addr,
    DDR3_0_ba,
    DDR3_0_cas_n,
    DDR3_0_ck_n,
    DDR3_0_ck_p,
    DDR3_0_cke,
    DDR3_0_dm,
    DDR3_0_dq,
    DDR3_0_dqs_n,
    DDR3_0_dqs_p,
    DDR3_0_odt,
    DDR3_0_ras_n,
    DDR3_0_reset_n,
    DDR3_0_we_n,
    eth_mdio_mdc_mdc,
    eth_mdio_mdc_mdio_i,
    eth_mdio_mdc_mdio_o,
    eth_mdio_mdc_mdio_t,
    eth_rgmii_rd,
    eth_rgmii_rx_ctl,
    eth_rgmii_rxc,
    eth_rgmii_td,
    eth_rgmii_tx_ctl,
    eth_rgmii_txc,
    phy_reset_out,
    reset,
    sys_clock,
    usb_uart_rxd,
    usb_uart_txd);
  (* X_INTERFACE_INFO = "xilinx.com:interface:ddrx:1.0 DDR3_0 ADDR" *) (* X_INTERFACE_MODE = "Master" *) (* X_INTERFACE_PARAMETER = "XIL_INTERFACENAME DDR3_0, AXI_ARBITRATION_SCHEME TDM, BURST_LENGTH 8, CAN_DEBUG false, CAS_LATENCY 11, CAS_WRITE_LATENCY 11, CS_ENABLED true, DATA_MASK_ENABLED true, DATA_WIDTH 8, MEMORY_TYPE COMPONENTS, MEM_ADDR_MAP ROW_COLUMN_BANK, SLOT Single, TIMEPERIOD_PS 1250" *) output [14:0]DDR3_0_addr;
  (* X_INTERFACE_INFO = "xilinx.com:interface:ddrx:1.0 DDR3_0 BA" *) output [2:0]DDR3_0_ba;
  (* X_INTERFACE_INFO = "xilinx.com:interface:ddrx:1.0 DDR3_0 CAS_N" *) output DDR3_0_cas_n;
  (* X_INTERFACE_INFO = "xilinx.com:interface:ddrx:1.0 DDR3_0 CK_N" *) output [0:0]DDR3_0_ck_n;
  (* X_INTERFACE_INFO = "xilinx.com:interface:ddrx:1.0 DDR3_0 CK_P" *) output [0:0]DDR3_0_ck_p;
  (* X_INTERFACE_INFO = "xilinx.com:interface:ddrx:1.0 DDR3_0 CKE" *) output [0:0]DDR3_0_cke;
  (* X_INTERFACE_INFO = "xilinx.com:interface:ddrx:1.0 DDR3_0 DM" *) output [1:0]DDR3_0_dm;
  (* X_INTERFACE_INFO = "xilinx.com:interface:ddrx:1.0 DDR3_0 DQ" *) inout [15:0]DDR3_0_dq;
  (* X_INTERFACE_INFO = "xilinx.com:interface:ddrx:1.0 DDR3_0 DQS_N" *) inout [1:0]DDR3_0_dqs_n;
  (* X_INTERFACE_INFO = "xilinx.com:interface:ddrx:1.0 DDR3_0 DQS_P" *) inout [1:0]DDR3_0_dqs_p;
  (* X_INTERFACE_INFO = "xilinx.com:interface:ddrx:1.0 DDR3_0 ODT" *) output [0:0]DDR3_0_odt;
  (* X_INTERFACE_INFO = "xilinx.com:interface:ddrx:1.0 DDR3_0 RAS_N" *) output DDR3_0_ras_n;
  (* X_INTERFACE_INFO = "xilinx.com:interface:ddrx:1.0 DDR3_0 RESET_N" *) output DDR3_0_reset_n;
  (* X_INTERFACE_INFO = "xilinx.com:interface:ddrx:1.0 DDR3_0 WE_N" *) output DDR3_0_we_n;
  (* X_INTERFACE_INFO = "xilinx.com:interface:mdio:1.0 eth_mdio_mdc MDC" *) (* X_INTERFACE_MODE = "Master" *) (* X_INTERFACE_PARAMETER = "XIL_INTERFACENAME eth_mdio_mdc, CAN_DEBUG false" *) output eth_mdio_mdc_mdc;
  (* X_INTERFACE_INFO = "xilinx.com:interface:mdio:1.0 eth_mdio_mdc MDIO_I" *) input eth_mdio_mdc_mdio_i;
  (* X_INTERFACE_INFO = "xilinx.com:interface:mdio:1.0 eth_mdio_mdc MDIO_O" *) output eth_mdio_mdc_mdio_o;
  (* X_INTERFACE_INFO = "xilinx.com:interface:mdio:1.0 eth_mdio_mdc MDIO_T" *) output eth_mdio_mdc_mdio_t;
  (* X_INTERFACE_INFO = "xilinx.com:interface:rgmii:1.0 eth_rgmii RD" *) (* X_INTERFACE_MODE = "Master" *) input [3:0]eth_rgmii_rd;
  (* X_INTERFACE_INFO = "xilinx.com:interface:rgmii:1.0 eth_rgmii RX_CTL" *) input eth_rgmii_rx_ctl;
  (* X_INTERFACE_INFO = "xilinx.com:interface:rgmii:1.0 eth_rgmii RXC" *) input eth_rgmii_rxc;
  (* X_INTERFACE_INFO = "xilinx.com:interface:rgmii:1.0 eth_rgmii TD" *) output [3:0]eth_rgmii_td;
  (* X_INTERFACE_INFO = "xilinx.com:interface:rgmii:1.0 eth_rgmii TX_CTL" *) output eth_rgmii_tx_ctl;
  (* X_INTERFACE_INFO = "xilinx.com:interface:rgmii:1.0 eth_rgmii TXC" *) output eth_rgmii_txc;
  (* X_INTERFACE_INFO = "xilinx.com:signal:reset:1.0 RST.PHY_RESET_OUT RST" *) (* X_INTERFACE_PARAMETER = "XIL_INTERFACENAME RST.PHY_RESET_OUT, INSERT_VIP 0, POLARITY ACTIVE_LOW" *) output [0:0]phy_reset_out;
  (* X_INTERFACE_INFO = "xilinx.com:signal:reset:1.0 RST.RESET RST" *) (* X_INTERFACE_PARAMETER = "XIL_INTERFACENAME RST.RESET, INSERT_VIP 0, POLARITY ACTIVE_LOW" *) input reset;
  (* X_INTERFACE_INFO = "xilinx.com:signal:clock:1.0 CLK.SYS_CLOCK CLK" *) (* X_INTERFACE_PARAMETER = "XIL_INTERFACENAME CLK.SYS_CLOCK, ASSOCIATED_RESET phy_reset_out, CLK_DOMAIN design_1_sys_clock, FREQ_HZ 100000000, FREQ_TOLERANCE_HZ 0, INSERT_VIP 0, PHASE 0.0" *) input sys_clock;
  (* X_INTERFACE_INFO = "xilinx.com:interface:uart:1.0 usb_uart RxD" *) (* X_INTERFACE_MODE = "Master" *) input usb_uart_rxd;
  (* X_INTERFACE_INFO = "xilinx.com:interface:uart:1.0 usb_uart TxD" *) output usb_uart_txd;

  wire [14:0]DDR3_0_addr;
  wire [2:0]DDR3_0_ba;
  wire DDR3_0_cas_n;
  wire [0:0]DDR3_0_ck_n;
  wire [0:0]DDR3_0_ck_p;
  wire [0:0]DDR3_0_cke;
  wire [1:0]DDR3_0_dm;
  wire [15:0]DDR3_0_dq;
  wire [1:0]DDR3_0_dqs_n;
  wire [1:0]DDR3_0_dqs_p;
  wire [0:0]DDR3_0_odt;
  wire DDR3_0_ras_n;
  wire DDR3_0_reset_n;
  wire DDR3_0_we_n;
  wire [7:0]axi_dma_0_M_AXIS_MM2S_TDATA;
  wire axi_dma_0_M_AXIS_MM2S_TLAST;
  wire axi_dma_0_M_AXIS_MM2S_TREADY;
  wire axi_dma_0_M_AXIS_MM2S_TVALID;
  wire [31:0]axi_dma_0_M_AXI_MM2S_ARADDR;
  wire [1:0]axi_dma_0_M_AXI_MM2S_ARBURST;
  wire [3:0]axi_dma_0_M_AXI_MM2S_ARCACHE;
  wire [7:0]axi_dma_0_M_AXI_MM2S_ARLEN;
  wire [2:0]axi_dma_0_M_AXI_MM2S_ARPROT;
  wire axi_dma_0_M_AXI_MM2S_ARREADY;
  wire [2:0]axi_dma_0_M_AXI_MM2S_ARSIZE;
  wire axi_dma_0_M_AXI_MM2S_ARVALID;
  wire [31:0]axi_dma_0_M_AXI_MM2S_RDATA;
  wire axi_dma_0_M_AXI_MM2S_RLAST;
  wire axi_dma_0_M_AXI_MM2S_RREADY;
  wire [1:0]axi_dma_0_M_AXI_MM2S_RRESP;
  wire axi_dma_0_M_AXI_MM2S_RVALID;
  wire [31:0]axi_dma_0_M_AXI_S2MM_AWADDR;
  wire [1:0]axi_dma_0_M_AXI_S2MM_AWBURST;
  wire [3:0]axi_dma_0_M_AXI_S2MM_AWCACHE;
  wire [7:0]axi_dma_0_M_AXI_S2MM_AWLEN;
  wire [2:0]axi_dma_0_M_AXI_S2MM_AWPROT;
  wire axi_dma_0_M_AXI_S2MM_AWREADY;
  wire [2:0]axi_dma_0_M_AXI_S2MM_AWSIZE;
  wire axi_dma_0_M_AXI_S2MM_AWVALID;
  wire axi_dma_0_M_AXI_S2MM_BREADY;
  wire [1:0]axi_dma_0_M_AXI_S2MM_BRESP;
  wire axi_dma_0_M_AXI_S2MM_BVALID;
  wire [31:0]axi_dma_0_M_AXI_S2MM_WDATA;
  wire axi_dma_0_M_AXI_S2MM_WLAST;
  wire axi_dma_0_M_AXI_S2MM_WREADY;
  wire [3:0]axi_dma_0_M_AXI_S2MM_WSTRB;
  wire axi_dma_0_M_AXI_S2MM_WVALID;
  wire [31:0]axi_ethernet_0_dma_M_AXIS_CNTRL_TDATA;
  wire [3:0]axi_ethernet_0_dma_M_AXIS_CNTRL_TKEEP;
  wire axi_ethernet_0_dma_M_AXIS_CNTRL_TLAST;
  wire axi_ethernet_0_dma_M_AXIS_CNTRL_TREADY;
  wire axi_ethernet_0_dma_M_AXIS_CNTRL_TVALID;
  wire [31:0]axi_ethernet_0_dma_M_AXIS_MM2S_TDATA;
  wire [3:0]axi_ethernet_0_dma_M_AXIS_MM2S_TKEEP;
  wire axi_ethernet_0_dma_M_AXIS_MM2S_TLAST;
  wire axi_ethernet_0_dma_M_AXIS_MM2S_TREADY;
  wire axi_ethernet_0_dma_M_AXIS_MM2S_TVALID;
  wire [31:0]axi_ethernet_0_dma_M_AXI_MM2S_ARADDR;
  wire [1:0]axi_ethernet_0_dma_M_AXI_MM2S_ARBURST;
  wire [3:0]axi_ethernet_0_dma_M_AXI_MM2S_ARCACHE;
  wire [7:0]axi_ethernet_0_dma_M_AXI_MM2S_ARLEN;
  wire [2:0]axi_ethernet_0_dma_M_AXI_MM2S_ARPROT;
  wire axi_ethernet_0_dma_M_AXI_MM2S_ARREADY;
  wire [2:0]axi_ethernet_0_dma_M_AXI_MM2S_ARSIZE;
  wire axi_ethernet_0_dma_M_AXI_MM2S_ARVALID;
  wire [31:0]axi_ethernet_0_dma_M_AXI_MM2S_RDATA;
  wire axi_ethernet_0_dma_M_AXI_MM2S_RLAST;
  wire axi_ethernet_0_dma_M_AXI_MM2S_RREADY;
  wire [1:0]axi_ethernet_0_dma_M_AXI_MM2S_RRESP;
  wire axi_ethernet_0_dma_M_AXI_MM2S_RVALID;
  wire [31:0]axi_ethernet_0_dma_M_AXI_S2MM_AWADDR;
  wire [1:0]axi_ethernet_0_dma_M_AXI_S2MM_AWBURST;
  wire [3:0]axi_ethernet_0_dma_M_AXI_S2MM_AWCACHE;
  wire [7:0]axi_ethernet_0_dma_M_AXI_S2MM_AWLEN;
  wire [2:0]axi_ethernet_0_dma_M_AXI_S2MM_AWPROT;
  wire axi_ethernet_0_dma_M_AXI_S2MM_AWREADY;
  wire [2:0]axi_ethernet_0_dma_M_AXI_S2MM_AWSIZE;
  wire axi_ethernet_0_dma_M_AXI_S2MM_AWVALID;
  wire axi_ethernet_0_dma_M_AXI_S2MM_BREADY;
  wire [1:0]axi_ethernet_0_dma_M_AXI_S2MM_BRESP;
  wire axi_ethernet_0_dma_M_AXI_S2MM_BVALID;
  wire [31:0]axi_ethernet_0_dma_M_AXI_S2MM_WDATA;
  wire axi_ethernet_0_dma_M_AXI_S2MM_WLAST;
  wire axi_ethernet_0_dma_M_AXI_S2MM_WREADY;
  wire [3:0]axi_ethernet_0_dma_M_AXI_S2MM_WSTRB;
  wire axi_ethernet_0_dma_M_AXI_S2MM_WVALID;
  wire [31:0]axi_ethernet_0_dma_M_AXI_SG_ARADDR;
  wire [1:0]axi_ethernet_0_dma_M_AXI_SG_ARBURST;
  wire [3:0]axi_ethernet_0_dma_M_AXI_SG_ARCACHE;
  wire [7:0]axi_ethernet_0_dma_M_AXI_SG_ARLEN;
  wire [2:0]axi_ethernet_0_dma_M_AXI_SG_ARPROT;
  wire axi_ethernet_0_dma_M_AXI_SG_ARREADY;
  wire [2:0]axi_ethernet_0_dma_M_AXI_SG_ARSIZE;
  wire axi_ethernet_0_dma_M_AXI_SG_ARVALID;
  wire [31:0]axi_ethernet_0_dma_M_AXI_SG_AWADDR;
  wire [1:0]axi_ethernet_0_dma_M_AXI_SG_AWBURST;
  wire [3:0]axi_ethernet_0_dma_M_AXI_SG_AWCACHE;
  wire [7:0]axi_ethernet_0_dma_M_AXI_SG_AWLEN;
  wire [2:0]axi_ethernet_0_dma_M_AXI_SG_AWPROT;
  wire axi_ethernet_0_dma_M_AXI_SG_AWREADY;
  wire [2:0]axi_ethernet_0_dma_M_AXI_SG_AWSIZE;
  wire axi_ethernet_0_dma_M_AXI_SG_AWVALID;
  wire axi_ethernet_0_dma_M_AXI_SG_BREADY;
  wire [1:0]axi_ethernet_0_dma_M_AXI_SG_BRESP;
  wire axi_ethernet_0_dma_M_AXI_SG_BVALID;
  wire [31:0]axi_ethernet_0_dma_M_AXI_SG_RDATA;
  wire axi_ethernet_0_dma_M_AXI_SG_RLAST;
  wire axi_ethernet_0_dma_M_AXI_SG_RREADY;
  wire [1:0]axi_ethernet_0_dma_M_AXI_SG_RRESP;
  wire axi_ethernet_0_dma_M_AXI_SG_RVALID;
  wire [31:0]axi_ethernet_0_dma_M_AXI_SG_WDATA;
  wire axi_ethernet_0_dma_M_AXI_SG_WLAST;
  wire axi_ethernet_0_dma_M_AXI_SG_WREADY;
  wire [3:0]axi_ethernet_0_dma_M_AXI_SG_WSTRB;
  wire axi_ethernet_0_dma_M_AXI_SG_WVALID;
  wire axi_ethernet_0_dma_mm2s_cntrl_reset_out_n;
  wire axi_ethernet_0_dma_mm2s_introut;
  wire axi_ethernet_0_dma_mm2s_prmry_reset_out_n;
  wire axi_ethernet_0_dma_s2mm_introut;
  wire axi_ethernet_0_dma_s2mm_prmry_reset_out_n;
  wire axi_ethernet_0_dma_s2mm_sts_reset_out_n;
  wire axi_ethernet_0_interrupt;
  wire [31:0]axi_ethernet_0_m_axis_rxd_TDATA;
  wire [3:0]axi_ethernet_0_m_axis_rxd_TKEEP;
  wire axi_ethernet_0_m_axis_rxd_TLAST;
  wire axi_ethernet_0_m_axis_rxd_TREADY;
  wire axi_ethernet_0_m_axis_rxd_TVALID;
  wire [31:0]axi_ethernet_0_m_axis_rxs_TDATA;
  wire [3:0]axi_ethernet_0_m_axis_rxs_TKEEP;
  wire axi_ethernet_0_m_axis_rxs_TLAST;
  wire axi_ethernet_0_m_axis_rxs_TREADY;
  wire axi_ethernet_0_m_axis_rxs_TVALID;
  wire axi_ethernet_0_mac_irq;
  wire axi_ethernet_0_refclk_clk_200;
  wire axi_ethernet_0_refclk_locked;
  wire [0:1]axi_intc_0_interrupt_ACK;
  wire [31:0]axi_intc_0_interrupt_ADDRESS;
  wire axi_intc_0_interrupt_INTERRUPT;
  wire [28:0]axi_smc_M00_AXI_ARADDR;
  wire [1:0]axi_smc_M00_AXI_ARBURST;
  wire [3:0]axi_smc_M00_AXI_ARCACHE;
  wire [7:0]axi_smc_M00_AXI_ARLEN;
  wire [0:0]axi_smc_M00_AXI_ARLOCK;
  wire [2:0]axi_smc_M00_AXI_ARPROT;
  wire [3:0]axi_smc_M00_AXI_ARQOS;
  wire axi_smc_M00_AXI_ARREADY;
  wire [2:0]axi_smc_M00_AXI_ARSIZE;
  wire axi_smc_M00_AXI_ARVALID;
  wire [28:0]axi_smc_M00_AXI_AWADDR;
  wire [1:0]axi_smc_M00_AXI_AWBURST;
  wire [3:0]axi_smc_M00_AXI_AWCACHE;
  wire [7:0]axi_smc_M00_AXI_AWLEN;
  wire [0:0]axi_smc_M00_AXI_AWLOCK;
  wire [2:0]axi_smc_M00_AXI_AWPROT;
  wire [3:0]axi_smc_M00_AXI_AWQOS;
  wire axi_smc_M00_AXI_AWREADY;
  wire [2:0]axi_smc_M00_AXI_AWSIZE;
  wire axi_smc_M00_AXI_AWVALID;
  wire axi_smc_M00_AXI_BREADY;
  wire [1:0]axi_smc_M00_AXI_BRESP;
  wire axi_smc_M00_AXI_BVALID;
  wire [31:0]axi_smc_M00_AXI_RDATA;
  wire axi_smc_M00_AXI_RLAST;
  wire axi_smc_M00_AXI_RREADY;
  wire [1:0]axi_smc_M00_AXI_RRESP;
  wire axi_smc_M00_AXI_RVALID;
  wire [31:0]axi_smc_M00_AXI_WDATA;
  wire axi_smc_M00_AXI_WLAST;
  wire axi_smc_M00_AXI_WREADY;
  wire [3:0]axi_smc_M00_AXI_WSTRB;
  wire axi_smc_M00_AXI_WVALID;
  wire axi_timer_0_interrupt;
  wire clk_wiz_1_clk_125;
  wire clk_wiz_1_clk_200;
  wire eth_mdio_mdc_mdc;
  wire eth_mdio_mdc_mdio_i;
  wire eth_mdio_mdc_mdio_o;
  wire eth_mdio_mdc_mdio_t;
  wire [3:0]eth_rgmii_rd;
  wire eth_rgmii_rx_ctl;
  wire eth_rgmii_rxc;
  wire [3:0]eth_rgmii_td;
  wire eth_rgmii_tx_ctl;
  wire eth_rgmii_txc;
  wire mdm_1_Debug_SYS_Rst;
  wire [31:0]microblaze_0_M_AXI_DC_ARADDR;
  wire [1:0]microblaze_0_M_AXI_DC_ARBURST;
  wire [3:0]microblaze_0_M_AXI_DC_ARCACHE;
  wire [7:0]microblaze_0_M_AXI_DC_ARLEN;
  wire microblaze_0_M_AXI_DC_ARLOCK;
  wire [2:0]microblaze_0_M_AXI_DC_ARPROT;
  wire [3:0]microblaze_0_M_AXI_DC_ARQOS;
  wire microblaze_0_M_AXI_DC_ARREADY;
  wire [2:0]microblaze_0_M_AXI_DC_ARSIZE;
  wire microblaze_0_M_AXI_DC_ARVALID;
  wire [31:0]microblaze_0_M_AXI_DC_AWADDR;
  wire [1:0]microblaze_0_M_AXI_DC_AWBURST;
  wire [3:0]microblaze_0_M_AXI_DC_AWCACHE;
  wire [7:0]microblaze_0_M_AXI_DC_AWLEN;
  wire microblaze_0_M_AXI_DC_AWLOCK;
  wire [2:0]microblaze_0_M_AXI_DC_AWPROT;
  wire [3:0]microblaze_0_M_AXI_DC_AWQOS;
  wire microblaze_0_M_AXI_DC_AWREADY;
  wire [2:0]microblaze_0_M_AXI_DC_AWSIZE;
  wire microblaze_0_M_AXI_DC_AWVALID;
  wire microblaze_0_M_AXI_DC_BREADY;
  wire [1:0]microblaze_0_M_AXI_DC_BRESP;
  wire microblaze_0_M_AXI_DC_BVALID;
  wire [31:0]microblaze_0_M_AXI_DC_RDATA;
  wire microblaze_0_M_AXI_DC_RLAST;
  wire microblaze_0_M_AXI_DC_RREADY;
  wire [1:0]microblaze_0_M_AXI_DC_RRESP;
  wire microblaze_0_M_AXI_DC_RVALID;
  wire [31:0]microblaze_0_M_AXI_DC_WDATA;
  wire microblaze_0_M_AXI_DC_WLAST;
  wire microblaze_0_M_AXI_DC_WREADY;
  wire [3:0]microblaze_0_M_AXI_DC_WSTRB;
  wire microblaze_0_M_AXI_DC_WVALID;
  wire [31:0]microblaze_0_M_AXI_DP_ARADDR;
  wire [2:0]microblaze_0_M_AXI_DP_ARPROT;
  wire microblaze_0_M_AXI_DP_ARREADY;
  wire microblaze_0_M_AXI_DP_ARVALID;
  wire [31:0]microblaze_0_M_AXI_DP_AWADDR;
  wire [2:0]microblaze_0_M_AXI_DP_AWPROT;
  wire microblaze_0_M_AXI_DP_AWREADY;
  wire microblaze_0_M_AXI_DP_AWVALID;
  wire microblaze_0_M_AXI_DP_BREADY;
  wire [1:0]microblaze_0_M_AXI_DP_BRESP;
  wire microblaze_0_M_AXI_DP_BVALID;
  wire [31:0]microblaze_0_M_AXI_DP_RDATA;
  wire microblaze_0_M_AXI_DP_RREADY;
  wire [1:0]microblaze_0_M_AXI_DP_RRESP;
  wire microblaze_0_M_AXI_DP_RVALID;
  wire [31:0]microblaze_0_M_AXI_DP_WDATA;
  wire microblaze_0_M_AXI_DP_WREADY;
  wire [3:0]microblaze_0_M_AXI_DP_WSTRB;
  wire microblaze_0_M_AXI_DP_WVALID;
  wire [31:0]microblaze_0_M_AXI_IC_ARADDR;
  wire [1:0]microblaze_0_M_AXI_IC_ARBURST;
  wire [3:0]microblaze_0_M_AXI_IC_ARCACHE;
  wire [7:0]microblaze_0_M_AXI_IC_ARLEN;
  wire microblaze_0_M_AXI_IC_ARLOCK;
  wire [2:0]microblaze_0_M_AXI_IC_ARPROT;
  wire [3:0]microblaze_0_M_AXI_IC_ARQOS;
  wire microblaze_0_M_AXI_IC_ARREADY;
  wire [2:0]microblaze_0_M_AXI_IC_ARSIZE;
  wire microblaze_0_M_AXI_IC_ARVALID;
  wire [31:0]microblaze_0_M_AXI_IC_RDATA;
  wire microblaze_0_M_AXI_IC_RLAST;
  wire microblaze_0_M_AXI_IC_RREADY;
  wire [1:0]microblaze_0_M_AXI_IC_RRESP;
  wire microblaze_0_M_AXI_IC_RVALID;
  wire [8:0]microblaze_0_axi_periph_M00_AXI_ARADDR;
  wire microblaze_0_axi_periph_M00_AXI_ARREADY;
  wire microblaze_0_axi_periph_M00_AXI_ARVALID;
  wire [8:0]microblaze_0_axi_periph_M00_AXI_AWADDR;
  wire microblaze_0_axi_periph_M00_AXI_AWREADY;
  wire microblaze_0_axi_periph_M00_AXI_AWVALID;
  wire microblaze_0_axi_periph_M00_AXI_BREADY;
  wire [1:0]microblaze_0_axi_periph_M00_AXI_BRESP;
  wire microblaze_0_axi_periph_M00_AXI_BVALID;
  wire [31:0]microblaze_0_axi_periph_M00_AXI_RDATA;
  wire microblaze_0_axi_periph_M00_AXI_RREADY;
  wire [1:0]microblaze_0_axi_periph_M00_AXI_RRESP;
  wire microblaze_0_axi_periph_M00_AXI_RVALID;
  wire [31:0]microblaze_0_axi_periph_M00_AXI_WDATA;
  wire microblaze_0_axi_periph_M00_AXI_WREADY;
  wire [3:0]microblaze_0_axi_periph_M00_AXI_WSTRB;
  wire microblaze_0_axi_periph_M00_AXI_WVALID;
  wire [17:0]microblaze_0_axi_periph_M01_AXI_ARADDR;
  wire microblaze_0_axi_periph_M01_AXI_ARREADY;
  wire microblaze_0_axi_periph_M01_AXI_ARVALID;
  wire [17:0]microblaze_0_axi_periph_M01_AXI_AWADDR;
  wire microblaze_0_axi_periph_M01_AXI_AWREADY;
  wire microblaze_0_axi_periph_M01_AXI_AWVALID;
  wire microblaze_0_axi_periph_M01_AXI_BREADY;
  wire [1:0]microblaze_0_axi_periph_M01_AXI_BRESP;
  wire microblaze_0_axi_periph_M01_AXI_BVALID;
  wire [31:0]microblaze_0_axi_periph_M01_AXI_RDATA;
  wire microblaze_0_axi_periph_M01_AXI_RREADY;
  wire [1:0]microblaze_0_axi_periph_M01_AXI_RRESP;
  wire microblaze_0_axi_periph_M01_AXI_RVALID;
  wire [31:0]microblaze_0_axi_periph_M01_AXI_WDATA;
  wire microblaze_0_axi_periph_M01_AXI_WREADY;
  wire [3:0]microblaze_0_axi_periph_M01_AXI_WSTRB;
  wire microblaze_0_axi_periph_M01_AXI_WVALID;
  wire [9:0]microblaze_0_axi_periph_M02_AXI_ARADDR;
  wire microblaze_0_axi_periph_M02_AXI_ARREADY;
  wire microblaze_0_axi_periph_M02_AXI_ARVALID;
  wire [9:0]microblaze_0_axi_periph_M02_AXI_AWADDR;
  wire microblaze_0_axi_periph_M02_AXI_AWREADY;
  wire microblaze_0_axi_periph_M02_AXI_AWVALID;
  wire microblaze_0_axi_periph_M02_AXI_BREADY;
  wire [1:0]microblaze_0_axi_periph_M02_AXI_BRESP;
  wire microblaze_0_axi_periph_M02_AXI_BVALID;
  wire [31:0]microblaze_0_axi_periph_M02_AXI_RDATA;
  wire microblaze_0_axi_periph_M02_AXI_RREADY;
  wire [1:0]microblaze_0_axi_periph_M02_AXI_RRESP;
  wire microblaze_0_axi_periph_M02_AXI_RVALID;
  wire [31:0]microblaze_0_axi_periph_M02_AXI_WDATA;
  wire microblaze_0_axi_periph_M02_AXI_WREADY;
  wire microblaze_0_axi_periph_M02_AXI_WVALID;
  wire [4:0]microblaze_0_axi_periph_M03_AXI_ARADDR;
  wire microblaze_0_axi_periph_M03_AXI_ARREADY;
  wire microblaze_0_axi_periph_M03_AXI_ARVALID;
  wire [4:0]microblaze_0_axi_periph_M03_AXI_AWADDR;
  wire microblaze_0_axi_periph_M03_AXI_AWREADY;
  wire microblaze_0_axi_periph_M03_AXI_AWVALID;
  wire microblaze_0_axi_periph_M03_AXI_BREADY;
  wire [1:0]microblaze_0_axi_periph_M03_AXI_BRESP;
  wire microblaze_0_axi_periph_M03_AXI_BVALID;
  wire [31:0]microblaze_0_axi_periph_M03_AXI_RDATA;
  wire microblaze_0_axi_periph_M03_AXI_RREADY;
  wire [1:0]microblaze_0_axi_periph_M03_AXI_RRESP;
  wire microblaze_0_axi_periph_M03_AXI_RVALID;
  wire [31:0]microblaze_0_axi_periph_M03_AXI_WDATA;
  wire microblaze_0_axi_periph_M03_AXI_WREADY;
  wire [3:0]microblaze_0_axi_periph_M03_AXI_WSTRB;
  wire microblaze_0_axi_periph_M03_AXI_WVALID;
  wire [3:0]microblaze_0_axi_periph_M04_AXI_ARADDR;
  wire microblaze_0_axi_periph_M04_AXI_ARREADY;
  wire microblaze_0_axi_periph_M04_AXI_ARVALID;
  wire [3:0]microblaze_0_axi_periph_M04_AXI_AWADDR;
  wire microblaze_0_axi_periph_M04_AXI_AWREADY;
  wire microblaze_0_axi_periph_M04_AXI_AWVALID;
  wire microblaze_0_axi_periph_M04_AXI_BREADY;
  wire [1:0]microblaze_0_axi_periph_M04_AXI_BRESP;
  wire microblaze_0_axi_periph_M04_AXI_BVALID;
  wire [31:0]microblaze_0_axi_periph_M04_AXI_RDATA;
  wire microblaze_0_axi_periph_M04_AXI_RREADY;
  wire [1:0]microblaze_0_axi_periph_M04_AXI_RRESP;
  wire microblaze_0_axi_periph_M04_AXI_RVALID;
  wire [31:0]microblaze_0_axi_periph_M04_AXI_WDATA;
  wire microblaze_0_axi_periph_M04_AXI_WREADY;
  wire [3:0]microblaze_0_axi_periph_M04_AXI_WSTRB;
  wire microblaze_0_axi_periph_M04_AXI_WVALID;
  wire [3:0]microblaze_0_axi_periph_M05_AXI_ARADDR;
  wire microblaze_0_axi_periph_M05_AXI_ARREADY;
  wire microblaze_0_axi_periph_M05_AXI_ARVALID;
  wire [3:0]microblaze_0_axi_periph_M05_AXI_AWADDR;
  wire microblaze_0_axi_periph_M05_AXI_AWREADY;
  wire microblaze_0_axi_periph_M05_AXI_AWVALID;
  wire microblaze_0_axi_periph_M05_AXI_BREADY;
  wire [1:0]microblaze_0_axi_periph_M05_AXI_BRESP;
  wire microblaze_0_axi_periph_M05_AXI_BVALID;
  wire [31:0]microblaze_0_axi_periph_M05_AXI_RDATA;
  wire microblaze_0_axi_periph_M05_AXI_RREADY;
  wire [1:0]microblaze_0_axi_periph_M05_AXI_RRESP;
  wire microblaze_0_axi_periph_M05_AXI_RVALID;
  wire [31:0]microblaze_0_axi_periph_M05_AXI_WDATA;
  wire microblaze_0_axi_periph_M05_AXI_WREADY;
  wire [3:0]microblaze_0_axi_periph_M05_AXI_WSTRB;
  wire microblaze_0_axi_periph_M05_AXI_WVALID;
  wire [9:0]microblaze_0_axi_periph_M06_AXI_ARADDR;
  wire microblaze_0_axi_periph_M06_AXI_ARREADY;
  wire microblaze_0_axi_periph_M06_AXI_ARVALID;
  wire [9:0]microblaze_0_axi_periph_M06_AXI_AWADDR;
  wire microblaze_0_axi_periph_M06_AXI_AWREADY;
  wire microblaze_0_axi_periph_M06_AXI_AWVALID;
  wire microblaze_0_axi_periph_M06_AXI_BREADY;
  wire [1:0]microblaze_0_axi_periph_M06_AXI_BRESP;
  wire microblaze_0_axi_periph_M06_AXI_BVALID;
  wire [31:0]microblaze_0_axi_periph_M06_AXI_RDATA;
  wire microblaze_0_axi_periph_M06_AXI_RREADY;
  wire [1:0]microblaze_0_axi_periph_M06_AXI_RRESP;
  wire microblaze_0_axi_periph_M06_AXI_RVALID;
  wire [31:0]microblaze_0_axi_periph_M06_AXI_WDATA;
  wire microblaze_0_axi_periph_M06_AXI_WREADY;
  wire microblaze_0_axi_periph_M06_AXI_WVALID;
  wire microblaze_0_debug_CAPTURE;
  wire microblaze_0_debug_CLK;
  wire microblaze_0_debug_DISABLE;
  wire [0:7]microblaze_0_debug_REG_EN;
  wire microblaze_0_debug_RST;
  wire microblaze_0_debug_SHIFT;
  wire microblaze_0_debug_TDI;
  wire microblaze_0_debug_TDO;
  wire microblaze_0_debug_UPDATE;
  wire [0:31]microblaze_0_dlmb_1_ABUS;
  wire microblaze_0_dlmb_1_ADDRSTROBE;
  wire [0:3]microblaze_0_dlmb_1_BE;
  wire microblaze_0_dlmb_1_CE;
  wire [0:31]microblaze_0_dlmb_1_READDBUS;
  wire microblaze_0_dlmb_1_READSTROBE;
  wire microblaze_0_dlmb_1_READY;
  wire microblaze_0_dlmb_1_UE;
  wire microblaze_0_dlmb_1_WAIT;
  wire [0:31]microblaze_0_dlmb_1_WRITEDBUS;
  wire microblaze_0_dlmb_1_WRITESTROBE;
  wire [0:31]microblaze_0_ilmb_1_ABUS;
  wire microblaze_0_ilmb_1_ADDRSTROBE;
  wire microblaze_0_ilmb_1_CE;
  wire [0:31]microblaze_0_ilmb_1_READDBUS;
  wire microblaze_0_ilmb_1_READSTROBE;
  wire microblaze_0_ilmb_1_READY;
  wire microblaze_0_ilmb_1_UE;
  wire microblaze_0_ilmb_1_WAIT;
  wire [4:0]microblaze_0_xlconcat_dout;
  wire mig_7series_0_mmcm_locked;
  wire mig_7series_0_ui_clk;
  wire mig_7series_0_ui_clk_sync_rst;
  wire [0:0]phy_reset_out;
  wire reset;
  wire [0:0]rst_clk_wiz_1_100M_bus_struct_reset;
  wire rst_clk_wiz_1_100M_mb_reset;
  wire [0:0]rst_mig_7series_0_100M_peripheral_aresetn;
  wire [0:0]rst_mig_7series_0_100M_peripheral_aresetn1;
  wire sys_clock;
  wire [15:0]tokenizer_axi_lite_0_m_axis_TDATA;
  wire tokenizer_axi_lite_0_m_axis_TLAST;
  wire tokenizer_axi_lite_0_m_axis_TREADY;
  wire tokenizer_axi_lite_0_m_axis_TVALID;
  wire usb_uart_rxd;
  wire usb_uart_txd;

  design_1_axi_dma_0_0 axi_dma_0
       (.axi_resetn(rst_mig_7series_0_100M_peripheral_aresetn),
        .m_axi_mm2s_aclk(axi_ethernet_0_refclk_clk_200),
        .m_axi_mm2s_araddr(axi_dma_0_M_AXI_MM2S_ARADDR),
        .m_axi_mm2s_arburst(axi_dma_0_M_AXI_MM2S_ARBURST),
        .m_axi_mm2s_arcache(axi_dma_0_M_AXI_MM2S_ARCACHE),
        .m_axi_mm2s_arlen(axi_dma_0_M_AXI_MM2S_ARLEN),
        .m_axi_mm2s_arprot(axi_dma_0_M_AXI_MM2S_ARPROT),
        .m_axi_mm2s_arready(axi_dma_0_M_AXI_MM2S_ARREADY),
        .m_axi_mm2s_arsize(axi_dma_0_M_AXI_MM2S_ARSIZE),
        .m_axi_mm2s_arvalid(axi_dma_0_M_AXI_MM2S_ARVALID),
        .m_axi_mm2s_rdata(axi_dma_0_M_AXI_MM2S_RDATA),
        .m_axi_mm2s_rlast(axi_dma_0_M_AXI_MM2S_RLAST),
        .m_axi_mm2s_rready(axi_dma_0_M_AXI_MM2S_RREADY),
        .m_axi_mm2s_rresp(axi_dma_0_M_AXI_MM2S_RRESP),
        .m_axi_mm2s_rvalid(axi_dma_0_M_AXI_MM2S_RVALID),
        .m_axi_s2mm_aclk(axi_ethernet_0_refclk_clk_200),
        .m_axi_s2mm_awaddr(axi_dma_0_M_AXI_S2MM_AWADDR),
        .m_axi_s2mm_awburst(axi_dma_0_M_AXI_S2MM_AWBURST),
        .m_axi_s2mm_awcache(axi_dma_0_M_AXI_S2MM_AWCACHE),
        .m_axi_s2mm_awlen(axi_dma_0_M_AXI_S2MM_AWLEN),
        .m_axi_s2mm_awprot(axi_dma_0_M_AXI_S2MM_AWPROT),
        .m_axi_s2mm_awready(axi_dma_0_M_AXI_S2MM_AWREADY),
        .m_axi_s2mm_awsize(axi_dma_0_M_AXI_S2MM_AWSIZE),
        .m_axi_s2mm_awvalid(axi_dma_0_M_AXI_S2MM_AWVALID),
        .m_axi_s2mm_bready(axi_dma_0_M_AXI_S2MM_BREADY),
        .m_axi_s2mm_bresp(axi_dma_0_M_AXI_S2MM_BRESP),
        .m_axi_s2mm_bvalid(axi_dma_0_M_AXI_S2MM_BVALID),
        .m_axi_s2mm_wdata(axi_dma_0_M_AXI_S2MM_WDATA),
        .m_axi_s2mm_wlast(axi_dma_0_M_AXI_S2MM_WLAST),
        .m_axi_s2mm_wready(axi_dma_0_M_AXI_S2MM_WREADY),
        .m_axi_s2mm_wstrb(axi_dma_0_M_AXI_S2MM_WSTRB),
        .m_axi_s2mm_wvalid(axi_dma_0_M_AXI_S2MM_WVALID),
        .m_axis_mm2s_tdata(axi_dma_0_M_AXIS_MM2S_TDATA),
        .m_axis_mm2s_tlast(axi_dma_0_M_AXIS_MM2S_TLAST),
        .m_axis_mm2s_tready(axi_dma_0_M_AXIS_MM2S_TREADY),
        .m_axis_mm2s_tvalid(axi_dma_0_M_AXIS_MM2S_TVALID),
        .s_axi_lite_aclk(axi_ethernet_0_refclk_clk_200),
        .s_axi_lite_araddr(microblaze_0_axi_periph_M06_AXI_ARADDR),
        .s_axi_lite_arready(microblaze_0_axi_periph_M06_AXI_ARREADY),
        .s_axi_lite_arvalid(microblaze_0_axi_periph_M06_AXI_ARVALID),
        .s_axi_lite_awaddr(microblaze_0_axi_periph_M06_AXI_AWADDR),
        .s_axi_lite_awready(microblaze_0_axi_periph_M06_AXI_AWREADY),
        .s_axi_lite_awvalid(microblaze_0_axi_periph_M06_AXI_AWVALID),
        .s_axi_lite_bready(microblaze_0_axi_periph_M06_AXI_BREADY),
        .s_axi_lite_bresp(microblaze_0_axi_periph_M06_AXI_BRESP),
        .s_axi_lite_bvalid(microblaze_0_axi_periph_M06_AXI_BVALID),
        .s_axi_lite_rdata(microblaze_0_axi_periph_M06_AXI_RDATA),
        .s_axi_lite_rready(microblaze_0_axi_periph_M06_AXI_RREADY),
        .s_axi_lite_rresp(microblaze_0_axi_periph_M06_AXI_RRESP),
        .s_axi_lite_rvalid(microblaze_0_axi_periph_M06_AXI_RVALID),
        .s_axi_lite_wdata(microblaze_0_axi_periph_M06_AXI_WDATA),
        .s_axi_lite_wready(microblaze_0_axi_periph_M06_AXI_WREADY),
        .s_axi_lite_wvalid(microblaze_0_axi_periph_M06_AXI_WVALID),
        .s_axis_s2mm_tdata(tokenizer_axi_lite_0_m_axis_TDATA),
        .s_axis_s2mm_tkeep({1'b1,1'b1}),
        .s_axis_s2mm_tlast(tokenizer_axi_lite_0_m_axis_TLAST),
        .s_axis_s2mm_tready(tokenizer_axi_lite_0_m_axis_TREADY),
        .s_axis_s2mm_tvalid(tokenizer_axi_lite_0_m_axis_TVALID));
  design_1_axi_ethernet_0_0 axi_ethernet_0
       (.axi_rxd_arstn(axi_ethernet_0_dma_s2mm_prmry_reset_out_n),
        .axi_rxs_arstn(axi_ethernet_0_dma_s2mm_sts_reset_out_n),
        .axi_txc_arstn(axi_ethernet_0_dma_mm2s_cntrl_reset_out_n),
        .axi_txd_arstn(axi_ethernet_0_dma_mm2s_prmry_reset_out_n),
        .axis_clk(axi_ethernet_0_refclk_clk_200),
        .gtx_clk(clk_wiz_1_clk_125),
        .interrupt(axi_ethernet_0_interrupt),
        .m_axis_rxd_tdata(axi_ethernet_0_m_axis_rxd_TDATA),
        .m_axis_rxd_tkeep(axi_ethernet_0_m_axis_rxd_TKEEP),
        .m_axis_rxd_tlast(axi_ethernet_0_m_axis_rxd_TLAST),
        .m_axis_rxd_tready(axi_ethernet_0_m_axis_rxd_TREADY),
        .m_axis_rxd_tvalid(axi_ethernet_0_m_axis_rxd_TVALID),
        .m_axis_rxs_tdata(axi_ethernet_0_m_axis_rxs_TDATA),
        .m_axis_rxs_tkeep(axi_ethernet_0_m_axis_rxs_TKEEP),
        .m_axis_rxs_tlast(axi_ethernet_0_m_axis_rxs_TLAST),
        .m_axis_rxs_tready(axi_ethernet_0_m_axis_rxs_TREADY),
        .m_axis_rxs_tvalid(axi_ethernet_0_m_axis_rxs_TVALID),
        .mac_irq(axi_ethernet_0_mac_irq),
        .mdio_mdc(eth_mdio_mdc_mdc),
        .mdio_mdio_i(eth_mdio_mdc_mdio_i),
        .mdio_mdio_o(eth_mdio_mdc_mdio_o),
        .mdio_mdio_t(eth_mdio_mdc_mdio_t),
        .phy_rst_n(phy_reset_out),
        .ref_clk(clk_wiz_1_clk_200),
        .rgmii_rd(eth_rgmii_rd),
        .rgmii_rx_ctl(eth_rgmii_rx_ctl),
        .rgmii_rxc(eth_rgmii_rxc),
        .rgmii_td(eth_rgmii_td),
        .rgmii_tx_ctl(eth_rgmii_tx_ctl),
        .rgmii_txc(eth_rgmii_txc),
        .s_axi_araddr(microblaze_0_axi_periph_M01_AXI_ARADDR),
        .s_axi_arready(microblaze_0_axi_periph_M01_AXI_ARREADY),
        .s_axi_arvalid(microblaze_0_axi_periph_M01_AXI_ARVALID),
        .s_axi_awaddr(microblaze_0_axi_periph_M01_AXI_AWADDR),
        .s_axi_awready(microblaze_0_axi_periph_M01_AXI_AWREADY),
        .s_axi_awvalid(microblaze_0_axi_periph_M01_AXI_AWVALID),
        .s_axi_bready(microblaze_0_axi_periph_M01_AXI_BREADY),
        .s_axi_bresp(microblaze_0_axi_periph_M01_AXI_BRESP),
        .s_axi_bvalid(microblaze_0_axi_periph_M01_AXI_BVALID),
        .s_axi_lite_clk(axi_ethernet_0_refclk_clk_200),
        .s_axi_lite_resetn(rst_mig_7series_0_100M_peripheral_aresetn),
        .s_axi_rdata(microblaze_0_axi_periph_M01_AXI_RDATA),
        .s_axi_rready(microblaze_0_axi_periph_M01_AXI_RREADY),
        .s_axi_rresp(microblaze_0_axi_periph_M01_AXI_RRESP),
        .s_axi_rvalid(microblaze_0_axi_periph_M01_AXI_RVALID),
        .s_axi_wdata(microblaze_0_axi_periph_M01_AXI_WDATA),
        .s_axi_wready(microblaze_0_axi_periph_M01_AXI_WREADY),
        .s_axi_wstrb(microblaze_0_axi_periph_M01_AXI_WSTRB),
        .s_axi_wvalid(microblaze_0_axi_periph_M01_AXI_WVALID),
        .s_axis_txc_tdata(axi_ethernet_0_dma_M_AXIS_CNTRL_TDATA),
        .s_axis_txc_tkeep(axi_ethernet_0_dma_M_AXIS_CNTRL_TKEEP),
        .s_axis_txc_tlast(axi_ethernet_0_dma_M_AXIS_CNTRL_TLAST),
        .s_axis_txc_tready(axi_ethernet_0_dma_M_AXIS_CNTRL_TREADY),
        .s_axis_txc_tvalid(axi_ethernet_0_dma_M_AXIS_CNTRL_TVALID),
        .s_axis_txd_tdata(axi_ethernet_0_dma_M_AXIS_MM2S_TDATA),
        .s_axis_txd_tkeep(axi_ethernet_0_dma_M_AXIS_MM2S_TKEEP),
        .s_axis_txd_tlast(axi_ethernet_0_dma_M_AXIS_MM2S_TLAST),
        .s_axis_txd_tready(axi_ethernet_0_dma_M_AXIS_MM2S_TREADY),
        .s_axis_txd_tvalid(axi_ethernet_0_dma_M_AXIS_MM2S_TVALID));
  design_1_axi_ethernet_0_dma_0 axi_ethernet_0_dma
       (.axi_resetn(rst_mig_7series_0_100M_peripheral_aresetn),
        .m_axi_mm2s_aclk(axi_ethernet_0_refclk_clk_200),
        .m_axi_mm2s_araddr(axi_ethernet_0_dma_M_AXI_MM2S_ARADDR),
        .m_axi_mm2s_arburst(axi_ethernet_0_dma_M_AXI_MM2S_ARBURST),
        .m_axi_mm2s_arcache(axi_ethernet_0_dma_M_AXI_MM2S_ARCACHE),
        .m_axi_mm2s_arlen(axi_ethernet_0_dma_M_AXI_MM2S_ARLEN),
        .m_axi_mm2s_arprot(axi_ethernet_0_dma_M_AXI_MM2S_ARPROT),
        .m_axi_mm2s_arready(axi_ethernet_0_dma_M_AXI_MM2S_ARREADY),
        .m_axi_mm2s_arsize(axi_ethernet_0_dma_M_AXI_MM2S_ARSIZE),
        .m_axi_mm2s_arvalid(axi_ethernet_0_dma_M_AXI_MM2S_ARVALID),
        .m_axi_mm2s_rdata(axi_ethernet_0_dma_M_AXI_MM2S_RDATA),
        .m_axi_mm2s_rlast(axi_ethernet_0_dma_M_AXI_MM2S_RLAST),
        .m_axi_mm2s_rready(axi_ethernet_0_dma_M_AXI_MM2S_RREADY),
        .m_axi_mm2s_rresp(axi_ethernet_0_dma_M_AXI_MM2S_RRESP),
        .m_axi_mm2s_rvalid(axi_ethernet_0_dma_M_AXI_MM2S_RVALID),
        .m_axi_s2mm_aclk(axi_ethernet_0_refclk_clk_200),
        .m_axi_s2mm_awaddr(axi_ethernet_0_dma_M_AXI_S2MM_AWADDR),
        .m_axi_s2mm_awburst(axi_ethernet_0_dma_M_AXI_S2MM_AWBURST),
        .m_axi_s2mm_awcache(axi_ethernet_0_dma_M_AXI_S2MM_AWCACHE),
        .m_axi_s2mm_awlen(axi_ethernet_0_dma_M_AXI_S2MM_AWLEN),
        .m_axi_s2mm_awprot(axi_ethernet_0_dma_M_AXI_S2MM_AWPROT),
        .m_axi_s2mm_awready(axi_ethernet_0_dma_M_AXI_S2MM_AWREADY),
        .m_axi_s2mm_awsize(axi_ethernet_0_dma_M_AXI_S2MM_AWSIZE),
        .m_axi_s2mm_awvalid(axi_ethernet_0_dma_M_AXI_S2MM_AWVALID),
        .m_axi_s2mm_bready(axi_ethernet_0_dma_M_AXI_S2MM_BREADY),
        .m_axi_s2mm_bresp(axi_ethernet_0_dma_M_AXI_S2MM_BRESP),
        .m_axi_s2mm_bvalid(axi_ethernet_0_dma_M_AXI_S2MM_BVALID),
        .m_axi_s2mm_wdata(axi_ethernet_0_dma_M_AXI_S2MM_WDATA),
        .m_axi_s2mm_wlast(axi_ethernet_0_dma_M_AXI_S2MM_WLAST),
        .m_axi_s2mm_wready(axi_ethernet_0_dma_M_AXI_S2MM_WREADY),
        .m_axi_s2mm_wstrb(axi_ethernet_0_dma_M_AXI_S2MM_WSTRB),
        .m_axi_s2mm_wvalid(axi_ethernet_0_dma_M_AXI_S2MM_WVALID),
        .m_axi_sg_aclk(axi_ethernet_0_refclk_clk_200),
        .m_axi_sg_araddr(axi_ethernet_0_dma_M_AXI_SG_ARADDR),
        .m_axi_sg_arburst(axi_ethernet_0_dma_M_AXI_SG_ARBURST),
        .m_axi_sg_arcache(axi_ethernet_0_dma_M_AXI_SG_ARCACHE),
        .m_axi_sg_arlen(axi_ethernet_0_dma_M_AXI_SG_ARLEN),
        .m_axi_sg_arprot(axi_ethernet_0_dma_M_AXI_SG_ARPROT),
        .m_axi_sg_arready(axi_ethernet_0_dma_M_AXI_SG_ARREADY),
        .m_axi_sg_arsize(axi_ethernet_0_dma_M_AXI_SG_ARSIZE),
        .m_axi_sg_arvalid(axi_ethernet_0_dma_M_AXI_SG_ARVALID),
        .m_axi_sg_awaddr(axi_ethernet_0_dma_M_AXI_SG_AWADDR),
        .m_axi_sg_awburst(axi_ethernet_0_dma_M_AXI_SG_AWBURST),
        .m_axi_sg_awcache(axi_ethernet_0_dma_M_AXI_SG_AWCACHE),
        .m_axi_sg_awlen(axi_ethernet_0_dma_M_AXI_SG_AWLEN),
        .m_axi_sg_awprot(axi_ethernet_0_dma_M_AXI_SG_AWPROT),
        .m_axi_sg_awready(axi_ethernet_0_dma_M_AXI_SG_AWREADY),
        .m_axi_sg_awsize(axi_ethernet_0_dma_M_AXI_SG_AWSIZE),
        .m_axi_sg_awvalid(axi_ethernet_0_dma_M_AXI_SG_AWVALID),
        .m_axi_sg_bready(axi_ethernet_0_dma_M_AXI_SG_BREADY),
        .m_axi_sg_bresp(axi_ethernet_0_dma_M_AXI_SG_BRESP),
        .m_axi_sg_bvalid(axi_ethernet_0_dma_M_AXI_SG_BVALID),
        .m_axi_sg_rdata(axi_ethernet_0_dma_M_AXI_SG_RDATA),
        .m_axi_sg_rlast(axi_ethernet_0_dma_M_AXI_SG_RLAST),
        .m_axi_sg_rready(axi_ethernet_0_dma_M_AXI_SG_RREADY),
        .m_axi_sg_rresp(axi_ethernet_0_dma_M_AXI_SG_RRESP),
        .m_axi_sg_rvalid(axi_ethernet_0_dma_M_AXI_SG_RVALID),
        .m_axi_sg_wdata(axi_ethernet_0_dma_M_AXI_SG_WDATA),
        .m_axi_sg_wlast(axi_ethernet_0_dma_M_AXI_SG_WLAST),
        .m_axi_sg_wready(axi_ethernet_0_dma_M_AXI_SG_WREADY),
        .m_axi_sg_wstrb(axi_ethernet_0_dma_M_AXI_SG_WSTRB),
        .m_axi_sg_wvalid(axi_ethernet_0_dma_M_AXI_SG_WVALID),
        .m_axis_mm2s_cntrl_tdata(axi_ethernet_0_dma_M_AXIS_CNTRL_TDATA),
        .m_axis_mm2s_cntrl_tkeep(axi_ethernet_0_dma_M_AXIS_CNTRL_TKEEP),
        .m_axis_mm2s_cntrl_tlast(axi_ethernet_0_dma_M_AXIS_CNTRL_TLAST),
        .m_axis_mm2s_cntrl_tready(axi_ethernet_0_dma_M_AXIS_CNTRL_TREADY),
        .m_axis_mm2s_cntrl_tvalid(axi_ethernet_0_dma_M_AXIS_CNTRL_TVALID),
        .m_axis_mm2s_tdata(axi_ethernet_0_dma_M_AXIS_MM2S_TDATA),
        .m_axis_mm2s_tkeep(axi_ethernet_0_dma_M_AXIS_MM2S_TKEEP),
        .m_axis_mm2s_tlast(axi_ethernet_0_dma_M_AXIS_MM2S_TLAST),
        .m_axis_mm2s_tready(axi_ethernet_0_dma_M_AXIS_MM2S_TREADY),
        .m_axis_mm2s_tvalid(axi_ethernet_0_dma_M_AXIS_MM2S_TVALID),
        .mm2s_cntrl_reset_out_n(axi_ethernet_0_dma_mm2s_cntrl_reset_out_n),
        .mm2s_introut(axi_ethernet_0_dma_mm2s_introut),
        .mm2s_prmry_reset_out_n(axi_ethernet_0_dma_mm2s_prmry_reset_out_n),
        .s2mm_introut(axi_ethernet_0_dma_s2mm_introut),
        .s2mm_prmry_reset_out_n(axi_ethernet_0_dma_s2mm_prmry_reset_out_n),
        .s2mm_sts_reset_out_n(axi_ethernet_0_dma_s2mm_sts_reset_out_n),
        .s_axi_lite_aclk(axi_ethernet_0_refclk_clk_200),
        .s_axi_lite_araddr(microblaze_0_axi_periph_M02_AXI_ARADDR),
        .s_axi_lite_arready(microblaze_0_axi_periph_M02_AXI_ARREADY),
        .s_axi_lite_arvalid(microblaze_0_axi_periph_M02_AXI_ARVALID),
        .s_axi_lite_awaddr(microblaze_0_axi_periph_M02_AXI_AWADDR),
        .s_axi_lite_awready(microblaze_0_axi_periph_M02_AXI_AWREADY),
        .s_axi_lite_awvalid(microblaze_0_axi_periph_M02_AXI_AWVALID),
        .s_axi_lite_bready(microblaze_0_axi_periph_M02_AXI_BREADY),
        .s_axi_lite_bresp(microblaze_0_axi_periph_M02_AXI_BRESP),
        .s_axi_lite_bvalid(microblaze_0_axi_periph_M02_AXI_BVALID),
        .s_axi_lite_rdata(microblaze_0_axi_periph_M02_AXI_RDATA),
        .s_axi_lite_rready(microblaze_0_axi_periph_M02_AXI_RREADY),
        .s_axi_lite_rresp(microblaze_0_axi_periph_M02_AXI_RRESP),
        .s_axi_lite_rvalid(microblaze_0_axi_periph_M02_AXI_RVALID),
        .s_axi_lite_wdata(microblaze_0_axi_periph_M02_AXI_WDATA),
        .s_axi_lite_wready(microblaze_0_axi_periph_M02_AXI_WREADY),
        .s_axi_lite_wvalid(microblaze_0_axi_periph_M02_AXI_WVALID),
        .s_axis_s2mm_sts_tdata(axi_ethernet_0_m_axis_rxs_TDATA),
        .s_axis_s2mm_sts_tkeep(axi_ethernet_0_m_axis_rxs_TKEEP),
        .s_axis_s2mm_sts_tlast(axi_ethernet_0_m_axis_rxs_TLAST),
        .s_axis_s2mm_sts_tready(axi_ethernet_0_m_axis_rxs_TREADY),
        .s_axis_s2mm_sts_tvalid(axi_ethernet_0_m_axis_rxs_TVALID),
        .s_axis_s2mm_tdata(axi_ethernet_0_m_axis_rxd_TDATA),
        .s_axis_s2mm_tkeep(axi_ethernet_0_m_axis_rxd_TKEEP),
        .s_axis_s2mm_tlast(axi_ethernet_0_m_axis_rxd_TLAST),
        .s_axis_s2mm_tready(axi_ethernet_0_m_axis_rxd_TREADY),
        .s_axis_s2mm_tvalid(axi_ethernet_0_m_axis_rxd_TVALID));
  design_1_smartconnect_0_1 axi_smc
       (.M00_AXI_araddr(axi_smc_M00_AXI_ARADDR),
        .M00_AXI_arburst(axi_smc_M00_AXI_ARBURST),
        .M00_AXI_arcache(axi_smc_M00_AXI_ARCACHE),
        .M00_AXI_arlen(axi_smc_M00_AXI_ARLEN),
        .M00_AXI_arlock(axi_smc_M00_AXI_ARLOCK),
        .M00_AXI_arprot(axi_smc_M00_AXI_ARPROT),
        .M00_AXI_arqos(axi_smc_M00_AXI_ARQOS),
        .M00_AXI_arready(axi_smc_M00_AXI_ARREADY),
        .M00_AXI_arsize(axi_smc_M00_AXI_ARSIZE),
        .M00_AXI_arvalid(axi_smc_M00_AXI_ARVALID),
        .M00_AXI_awaddr(axi_smc_M00_AXI_AWADDR),
        .M00_AXI_awburst(axi_smc_M00_AXI_AWBURST),
        .M00_AXI_awcache(axi_smc_M00_AXI_AWCACHE),
        .M00_AXI_awlen(axi_smc_M00_AXI_AWLEN),
        .M00_AXI_awlock(axi_smc_M00_AXI_AWLOCK),
        .M00_AXI_awprot(axi_smc_M00_AXI_AWPROT),
        .M00_AXI_awqos(axi_smc_M00_AXI_AWQOS),
        .M00_AXI_awready(axi_smc_M00_AXI_AWREADY),
        .M00_AXI_awsize(axi_smc_M00_AXI_AWSIZE),
        .M00_AXI_awvalid(axi_smc_M00_AXI_AWVALID),
        .M00_AXI_bready(axi_smc_M00_AXI_BREADY),
        .M00_AXI_bresp(axi_smc_M00_AXI_BRESP),
        .M00_AXI_bvalid(axi_smc_M00_AXI_BVALID),
        .M00_AXI_rdata(axi_smc_M00_AXI_RDATA),
        .M00_AXI_rlast(axi_smc_M00_AXI_RLAST),
        .M00_AXI_rready(axi_smc_M00_AXI_RREADY),
        .M00_AXI_rresp(axi_smc_M00_AXI_RRESP),
        .M00_AXI_rvalid(axi_smc_M00_AXI_RVALID),
        .M00_AXI_wdata(axi_smc_M00_AXI_WDATA),
        .M00_AXI_wlast(axi_smc_M00_AXI_WLAST),
        .M00_AXI_wready(axi_smc_M00_AXI_WREADY),
        .M00_AXI_wstrb(axi_smc_M00_AXI_WSTRB),
        .M00_AXI_wvalid(axi_smc_M00_AXI_WVALID),
        .S00_AXI_araddr(microblaze_0_M_AXI_DC_ARADDR),
        .S00_AXI_arburst(microblaze_0_M_AXI_DC_ARBURST),
        .S00_AXI_arcache(microblaze_0_M_AXI_DC_ARCACHE),
        .S00_AXI_arlen(microblaze_0_M_AXI_DC_ARLEN),
        .S00_AXI_arlock(microblaze_0_M_AXI_DC_ARLOCK),
        .S00_AXI_arprot(microblaze_0_M_AXI_DC_ARPROT),
        .S00_AXI_arqos(microblaze_0_M_AXI_DC_ARQOS),
        .S00_AXI_arready(microblaze_0_M_AXI_DC_ARREADY),
        .S00_AXI_arsize(microblaze_0_M_AXI_DC_ARSIZE),
        .S00_AXI_arvalid(microblaze_0_M_AXI_DC_ARVALID),
        .S00_AXI_awaddr(microblaze_0_M_AXI_DC_AWADDR),
        .S00_AXI_awburst(microblaze_0_M_AXI_DC_AWBURST),
        .S00_AXI_awcache(microblaze_0_M_AXI_DC_AWCACHE),
        .S00_AXI_awlen(microblaze_0_M_AXI_DC_AWLEN),
        .S00_AXI_awlock(microblaze_0_M_AXI_DC_AWLOCK),
        .S00_AXI_awprot(microblaze_0_M_AXI_DC_AWPROT),
        .S00_AXI_awqos(microblaze_0_M_AXI_DC_AWQOS),
        .S00_AXI_awready(microblaze_0_M_AXI_DC_AWREADY),
        .S00_AXI_awsize(microblaze_0_M_AXI_DC_AWSIZE),
        .S00_AXI_awvalid(microblaze_0_M_AXI_DC_AWVALID),
        .S00_AXI_bready(microblaze_0_M_AXI_DC_BREADY),
        .S00_AXI_bresp(microblaze_0_M_AXI_DC_BRESP),
        .S00_AXI_bvalid(microblaze_0_M_AXI_DC_BVALID),
        .S00_AXI_rdata(microblaze_0_M_AXI_DC_RDATA),
        .S00_AXI_rlast(microblaze_0_M_AXI_DC_RLAST),
        .S00_AXI_rready(microblaze_0_M_AXI_DC_RREADY),
        .S00_AXI_rresp(microblaze_0_M_AXI_DC_RRESP),
        .S00_AXI_rvalid(microblaze_0_M_AXI_DC_RVALID),
        .S00_AXI_wdata(microblaze_0_M_AXI_DC_WDATA),
        .S00_AXI_wlast(microblaze_0_M_AXI_DC_WLAST),
        .S00_AXI_wready(microblaze_0_M_AXI_DC_WREADY),
        .S00_AXI_wstrb(microblaze_0_M_AXI_DC_WSTRB),
        .S00_AXI_wvalid(microblaze_0_M_AXI_DC_WVALID),
        .S01_AXI_araddr(microblaze_0_M_AXI_IC_ARADDR),
        .S01_AXI_arburst(microblaze_0_M_AXI_IC_ARBURST),
        .S01_AXI_arcache(microblaze_0_M_AXI_IC_ARCACHE),
        .S01_AXI_arlen(microblaze_0_M_AXI_IC_ARLEN),
        .S01_AXI_arlock(microblaze_0_M_AXI_IC_ARLOCK),
        .S01_AXI_arprot(microblaze_0_M_AXI_IC_ARPROT),
        .S01_AXI_arqos(microblaze_0_M_AXI_IC_ARQOS),
        .S01_AXI_arready(microblaze_0_M_AXI_IC_ARREADY),
        .S01_AXI_arsize(microblaze_0_M_AXI_IC_ARSIZE),
        .S01_AXI_arvalid(microblaze_0_M_AXI_IC_ARVALID),
        .S01_AXI_rdata(microblaze_0_M_AXI_IC_RDATA),
        .S01_AXI_rlast(microblaze_0_M_AXI_IC_RLAST),
        .S01_AXI_rready(microblaze_0_M_AXI_IC_RREADY),
        .S01_AXI_rresp(microblaze_0_M_AXI_IC_RRESP),
        .S01_AXI_rvalid(microblaze_0_M_AXI_IC_RVALID),
        .S02_AXI_araddr(axi_ethernet_0_dma_M_AXI_MM2S_ARADDR),
        .S02_AXI_arburst(axi_ethernet_0_dma_M_AXI_MM2S_ARBURST),
        .S02_AXI_arcache(axi_ethernet_0_dma_M_AXI_MM2S_ARCACHE),
        .S02_AXI_arlen(axi_ethernet_0_dma_M_AXI_MM2S_ARLEN),
        .S02_AXI_arlock(1'b0),
        .S02_AXI_arprot(axi_ethernet_0_dma_M_AXI_MM2S_ARPROT),
        .S02_AXI_arqos({1'b0,1'b0,1'b0,1'b0}),
        .S02_AXI_arready(axi_ethernet_0_dma_M_AXI_MM2S_ARREADY),
        .S02_AXI_arsize(axi_ethernet_0_dma_M_AXI_MM2S_ARSIZE),
        .S02_AXI_arvalid(axi_ethernet_0_dma_M_AXI_MM2S_ARVALID),
        .S02_AXI_rdata(axi_ethernet_0_dma_M_AXI_MM2S_RDATA),
        .S02_AXI_rlast(axi_ethernet_0_dma_M_AXI_MM2S_RLAST),
        .S02_AXI_rready(axi_ethernet_0_dma_M_AXI_MM2S_RREADY),
        .S02_AXI_rresp(axi_ethernet_0_dma_M_AXI_MM2S_RRESP),
        .S02_AXI_rvalid(axi_ethernet_0_dma_M_AXI_MM2S_RVALID),
        .S03_AXI_awaddr(axi_ethernet_0_dma_M_AXI_S2MM_AWADDR),
        .S03_AXI_awburst(axi_ethernet_0_dma_M_AXI_S2MM_AWBURST),
        .S03_AXI_awcache(axi_ethernet_0_dma_M_AXI_S2MM_AWCACHE),
        .S03_AXI_awlen(axi_ethernet_0_dma_M_AXI_S2MM_AWLEN),
        .S03_AXI_awlock(1'b0),
        .S03_AXI_awprot(axi_ethernet_0_dma_M_AXI_S2MM_AWPROT),
        .S03_AXI_awqos({1'b0,1'b0,1'b0,1'b0}),
        .S03_AXI_awready(axi_ethernet_0_dma_M_AXI_S2MM_AWREADY),
        .S03_AXI_awsize(axi_ethernet_0_dma_M_AXI_S2MM_AWSIZE),
        .S03_AXI_awvalid(axi_ethernet_0_dma_M_AXI_S2MM_AWVALID),
        .S03_AXI_bready(axi_ethernet_0_dma_M_AXI_S2MM_BREADY),
        .S03_AXI_bresp(axi_ethernet_0_dma_M_AXI_S2MM_BRESP),
        .S03_AXI_bvalid(axi_ethernet_0_dma_M_AXI_S2MM_BVALID),
        .S03_AXI_wdata(axi_ethernet_0_dma_M_AXI_S2MM_WDATA),
        .S03_AXI_wlast(axi_ethernet_0_dma_M_AXI_S2MM_WLAST),
        .S03_AXI_wready(axi_ethernet_0_dma_M_AXI_S2MM_WREADY),
        .S03_AXI_wstrb(axi_ethernet_0_dma_M_AXI_S2MM_WSTRB),
        .S03_AXI_wvalid(axi_ethernet_0_dma_M_AXI_S2MM_WVALID),
        .S04_AXI_araddr(axi_ethernet_0_dma_M_AXI_SG_ARADDR),
        .S04_AXI_arburst(axi_ethernet_0_dma_M_AXI_SG_ARBURST),
        .S04_AXI_arcache(axi_ethernet_0_dma_M_AXI_SG_ARCACHE),
        .S04_AXI_arlen(axi_ethernet_0_dma_M_AXI_SG_ARLEN),
        .S04_AXI_arlock(1'b0),
        .S04_AXI_arprot(axi_ethernet_0_dma_M_AXI_SG_ARPROT),
        .S04_AXI_arqos({1'b0,1'b0,1'b0,1'b0}),
        .S04_AXI_arready(axi_ethernet_0_dma_M_AXI_SG_ARREADY),
        .S04_AXI_arsize(axi_ethernet_0_dma_M_AXI_SG_ARSIZE),
        .S04_AXI_arvalid(axi_ethernet_0_dma_M_AXI_SG_ARVALID),
        .S04_AXI_awaddr(axi_ethernet_0_dma_M_AXI_SG_AWADDR),
        .S04_AXI_awburst(axi_ethernet_0_dma_M_AXI_SG_AWBURST),
        .S04_AXI_awcache(axi_ethernet_0_dma_M_AXI_SG_AWCACHE),
        .S04_AXI_awlen(axi_ethernet_0_dma_M_AXI_SG_AWLEN),
        .S04_AXI_awlock(1'b0),
        .S04_AXI_awprot(axi_ethernet_0_dma_M_AXI_SG_AWPROT),
        .S04_AXI_awqos({1'b0,1'b0,1'b0,1'b0}),
        .S04_AXI_awready(axi_ethernet_0_dma_M_AXI_SG_AWREADY),
        .S04_AXI_awsize(axi_ethernet_0_dma_M_AXI_SG_AWSIZE),
        .S04_AXI_awvalid(axi_ethernet_0_dma_M_AXI_SG_AWVALID),
        .S04_AXI_bready(axi_ethernet_0_dma_M_AXI_SG_BREADY),
        .S04_AXI_bresp(axi_ethernet_0_dma_M_AXI_SG_BRESP),
        .S04_AXI_bvalid(axi_ethernet_0_dma_M_AXI_SG_BVALID),
        .S04_AXI_rdata(axi_ethernet_0_dma_M_AXI_SG_RDATA),
        .S04_AXI_rlast(axi_ethernet_0_dma_M_AXI_SG_RLAST),
        .S04_AXI_rready(axi_ethernet_0_dma_M_AXI_SG_RREADY),
        .S04_AXI_rresp(axi_ethernet_0_dma_M_AXI_SG_RRESP),
        .S04_AXI_rvalid(axi_ethernet_0_dma_M_AXI_SG_RVALID),
        .S04_AXI_wdata(axi_ethernet_0_dma_M_AXI_SG_WDATA),
        .S04_AXI_wlast(axi_ethernet_0_dma_M_AXI_SG_WLAST),
        .S04_AXI_wready(axi_ethernet_0_dma_M_AXI_SG_WREADY),
        .S04_AXI_wstrb(axi_ethernet_0_dma_M_AXI_SG_WSTRB),
        .S04_AXI_wvalid(axi_ethernet_0_dma_M_AXI_SG_WVALID),
        .S05_AXI_araddr(axi_dma_0_M_AXI_MM2S_ARADDR),
        .S05_AXI_arburst(axi_dma_0_M_AXI_MM2S_ARBURST),
        .S05_AXI_arcache(axi_dma_0_M_AXI_MM2S_ARCACHE),
        .S05_AXI_arlen(axi_dma_0_M_AXI_MM2S_ARLEN),
        .S05_AXI_arlock(1'b0),
        .S05_AXI_arprot(axi_dma_0_M_AXI_MM2S_ARPROT),
        .S05_AXI_arqos({1'b0,1'b0,1'b0,1'b0}),
        .S05_AXI_arready(axi_dma_0_M_AXI_MM2S_ARREADY),
        .S05_AXI_arsize(axi_dma_0_M_AXI_MM2S_ARSIZE),
        .S05_AXI_arvalid(axi_dma_0_M_AXI_MM2S_ARVALID),
        .S05_AXI_rdata(axi_dma_0_M_AXI_MM2S_RDATA),
        .S05_AXI_rlast(axi_dma_0_M_AXI_MM2S_RLAST),
        .S05_AXI_rready(axi_dma_0_M_AXI_MM2S_RREADY),
        .S05_AXI_rresp(axi_dma_0_M_AXI_MM2S_RRESP),
        .S05_AXI_rvalid(axi_dma_0_M_AXI_MM2S_RVALID),
        .S06_AXI_awaddr(axi_dma_0_M_AXI_S2MM_AWADDR),
        .S06_AXI_awburst(axi_dma_0_M_AXI_S2MM_AWBURST),
        .S06_AXI_awcache(axi_dma_0_M_AXI_S2MM_AWCACHE),
        .S06_AXI_awlen(axi_dma_0_M_AXI_S2MM_AWLEN),
        .S06_AXI_awlock(1'b0),
        .S06_AXI_awprot(axi_dma_0_M_AXI_S2MM_AWPROT),
        .S06_AXI_awqos({1'b0,1'b0,1'b0,1'b0}),
        .S06_AXI_awready(axi_dma_0_M_AXI_S2MM_AWREADY),
        .S06_AXI_awsize(axi_dma_0_M_AXI_S2MM_AWSIZE),
        .S06_AXI_awvalid(axi_dma_0_M_AXI_S2MM_AWVALID),
        .S06_AXI_bready(axi_dma_0_M_AXI_S2MM_BREADY),
        .S06_AXI_bresp(axi_dma_0_M_AXI_S2MM_BRESP),
        .S06_AXI_bvalid(axi_dma_0_M_AXI_S2MM_BVALID),
        .S06_AXI_wdata(axi_dma_0_M_AXI_S2MM_WDATA),
        .S06_AXI_wlast(axi_dma_0_M_AXI_S2MM_WLAST),
        .S06_AXI_wready(axi_dma_0_M_AXI_S2MM_WREADY),
        .S06_AXI_wstrb(axi_dma_0_M_AXI_S2MM_WSTRB),
        .S06_AXI_wvalid(axi_dma_0_M_AXI_S2MM_WVALID),
        .aclk(axi_ethernet_0_refclk_clk_200),
        .aclk1(mig_7series_0_ui_clk),
        .aresetn(rst_mig_7series_0_100M_peripheral_aresetn));
  design_1_axi_timer_0_1 axi_timer_0
       (.capturetrig0(1'b0),
        .capturetrig1(1'b0),
        .freeze(1'b0),
        .interrupt(axi_timer_0_interrupt),
        .s_axi_aclk(axi_ethernet_0_refclk_clk_200),
        .s_axi_araddr(microblaze_0_axi_periph_M03_AXI_ARADDR),
        .s_axi_aresetn(rst_mig_7series_0_100M_peripheral_aresetn),
        .s_axi_arready(microblaze_0_axi_periph_M03_AXI_ARREADY),
        .s_axi_arvalid(microblaze_0_axi_periph_M03_AXI_ARVALID),
        .s_axi_awaddr(microblaze_0_axi_periph_M03_AXI_AWADDR),
        .s_axi_awready(microblaze_0_axi_periph_M03_AXI_AWREADY),
        .s_axi_awvalid(microblaze_0_axi_periph_M03_AXI_AWVALID),
        .s_axi_bready(microblaze_0_axi_periph_M03_AXI_BREADY),
        .s_axi_bresp(microblaze_0_axi_periph_M03_AXI_BRESP),
        .s_axi_bvalid(microblaze_0_axi_periph_M03_AXI_BVALID),
        .s_axi_rdata(microblaze_0_axi_periph_M03_AXI_RDATA),
        .s_axi_rready(microblaze_0_axi_periph_M03_AXI_RREADY),
        .s_axi_rresp(microblaze_0_axi_periph_M03_AXI_RRESP),
        .s_axi_rvalid(microblaze_0_axi_periph_M03_AXI_RVALID),
        .s_axi_wdata(microblaze_0_axi_periph_M03_AXI_WDATA),
        .s_axi_wready(microblaze_0_axi_periph_M03_AXI_WREADY),
        .s_axi_wstrb(microblaze_0_axi_periph_M03_AXI_WSTRB),
        .s_axi_wvalid(microblaze_0_axi_periph_M03_AXI_WVALID));
  design_1_axi_uartlite_0_2 axi_uartlite_0
       (.rx(usb_uart_rxd),
        .s_axi_aclk(axi_ethernet_0_refclk_clk_200),
        .s_axi_araddr(microblaze_0_axi_periph_M04_AXI_ARADDR),
        .s_axi_aresetn(rst_mig_7series_0_100M_peripheral_aresetn),
        .s_axi_arready(microblaze_0_axi_periph_M04_AXI_ARREADY),
        .s_axi_arvalid(microblaze_0_axi_periph_M04_AXI_ARVALID),
        .s_axi_awaddr(microblaze_0_axi_periph_M04_AXI_AWADDR),
        .s_axi_awready(microblaze_0_axi_periph_M04_AXI_AWREADY),
        .s_axi_awvalid(microblaze_0_axi_periph_M04_AXI_AWVALID),
        .s_axi_bready(microblaze_0_axi_periph_M04_AXI_BREADY),
        .s_axi_bresp(microblaze_0_axi_periph_M04_AXI_BRESP),
        .s_axi_bvalid(microblaze_0_axi_periph_M04_AXI_BVALID),
        .s_axi_rdata(microblaze_0_axi_periph_M04_AXI_RDATA),
        .s_axi_rready(microblaze_0_axi_periph_M04_AXI_RREADY),
        .s_axi_rresp(microblaze_0_axi_periph_M04_AXI_RRESP),
        .s_axi_rvalid(microblaze_0_axi_periph_M04_AXI_RVALID),
        .s_axi_wdata(microblaze_0_axi_periph_M04_AXI_WDATA),
        .s_axi_wready(microblaze_0_axi_periph_M04_AXI_WREADY),
        .s_axi_wstrb(microblaze_0_axi_periph_M04_AXI_WSTRB),
        .s_axi_wvalid(microblaze_0_axi_periph_M04_AXI_WVALID),
        .tx(usb_uart_txd));
  design_1_axi_ethernet_0_gtxclk_0 clk_wiz_1
       (.clk_100(axi_ethernet_0_refclk_clk_200),
        .clk_125(clk_wiz_1_clk_125),
        .clk_200(clk_wiz_1_clk_200),
        .clk_in1(sys_clock),
        .locked(axi_ethernet_0_refclk_locked),
        .resetn(reset));
  design_1_mdm_1_1 mdm_1
       (.Dbg_Capture_0(microblaze_0_debug_CAPTURE),
        .Dbg_Clk_0(microblaze_0_debug_CLK),
        .Dbg_Disable_0(microblaze_0_debug_DISABLE),
        .Dbg_Reg_En_0(microblaze_0_debug_REG_EN),
        .Dbg_Rst_0(microblaze_0_debug_RST),
        .Dbg_Shift_0(microblaze_0_debug_SHIFT),
        .Dbg_TDI_0(microblaze_0_debug_TDI),
        .Dbg_TDO_0(microblaze_0_debug_TDO),
        .Dbg_Update_0(microblaze_0_debug_UPDATE),
        .Debug_SYS_Rst(mdm_1_Debug_SYS_Rst));
  (* BMM_INFO_PROCESSOR = "microblaze-le > design_1 microblaze_0_local_memory/dlmb_bram_if_cntlr" *) 
  (* KEEP_HIERARCHY = "YES" *) 
  design_1_microblaze_0_1 microblaze_0
       (.Byte_Enable(microblaze_0_dlmb_1_BE),
        .Clk(axi_ethernet_0_refclk_clk_200),
        .DCE(microblaze_0_dlmb_1_CE),
        .DReady(microblaze_0_dlmb_1_READY),
        .DUE(microblaze_0_dlmb_1_UE),
        .DWait(microblaze_0_dlmb_1_WAIT),
        .D_AS(microblaze_0_dlmb_1_ADDRSTROBE),
        .Data_Addr(microblaze_0_dlmb_1_ABUS),
        .Data_Read(microblaze_0_dlmb_1_READDBUS),
        .Data_Write(microblaze_0_dlmb_1_WRITEDBUS),
        .Dbg_Capture(microblaze_0_debug_CAPTURE),
        .Dbg_Clk(microblaze_0_debug_CLK),
        .Dbg_Disable(microblaze_0_debug_DISABLE),
        .Dbg_Reg_En(microblaze_0_debug_REG_EN),
        .Dbg_Shift(microblaze_0_debug_SHIFT),
        .Dbg_TDI(microblaze_0_debug_TDI),
        .Dbg_TDO(microblaze_0_debug_TDO),
        .Dbg_Update(microblaze_0_debug_UPDATE),
        .Debug_Rst(microblaze_0_debug_RST),
        .ICE(microblaze_0_ilmb_1_CE),
        .IFetch(microblaze_0_ilmb_1_READSTROBE),
        .IReady(microblaze_0_ilmb_1_READY),
        .IUE(microblaze_0_ilmb_1_UE),
        .IWAIT(microblaze_0_ilmb_1_WAIT),
        .I_AS(microblaze_0_ilmb_1_ADDRSTROBE),
        .Instr(microblaze_0_ilmb_1_READDBUS),
        .Instr_Addr(microblaze_0_ilmb_1_ABUS),
        .Interrupt(axi_intc_0_interrupt_INTERRUPT),
        .Interrupt_Ack(axi_intc_0_interrupt_ACK),
        .Interrupt_Address({axi_intc_0_interrupt_ADDRESS[31],axi_intc_0_interrupt_ADDRESS[30],axi_intc_0_interrupt_ADDRESS[29],axi_intc_0_interrupt_ADDRESS[28],axi_intc_0_interrupt_ADDRESS[27],axi_intc_0_interrupt_ADDRESS[26],axi_intc_0_interrupt_ADDRESS[25],axi_intc_0_interrupt_ADDRESS[24],axi_intc_0_interrupt_ADDRESS[23],axi_intc_0_interrupt_ADDRESS[22],axi_intc_0_interrupt_ADDRESS[21],axi_intc_0_interrupt_ADDRESS[20],axi_intc_0_interrupt_ADDRESS[19],axi_intc_0_interrupt_ADDRESS[18],axi_intc_0_interrupt_ADDRESS[17],axi_intc_0_interrupt_ADDRESS[16],axi_intc_0_interrupt_ADDRESS[15],axi_intc_0_interrupt_ADDRESS[14],axi_intc_0_interrupt_ADDRESS[13],axi_intc_0_interrupt_ADDRESS[12],axi_intc_0_interrupt_ADDRESS[11],axi_intc_0_interrupt_ADDRESS[10],axi_intc_0_interrupt_ADDRESS[9],axi_intc_0_interrupt_ADDRESS[8],axi_intc_0_interrupt_ADDRESS[7],axi_intc_0_interrupt_ADDRESS[6],axi_intc_0_interrupt_ADDRESS[5],axi_intc_0_interrupt_ADDRESS[4],axi_intc_0_interrupt_ADDRESS[3],axi_intc_0_interrupt_ADDRESS[2],axi_intc_0_interrupt_ADDRESS[1],axi_intc_0_interrupt_ADDRESS[0]}),
        .M_AXI_DC_ARADDR(microblaze_0_M_AXI_DC_ARADDR),
        .M_AXI_DC_ARBURST(microblaze_0_M_AXI_DC_ARBURST),
        .M_AXI_DC_ARCACHE(microblaze_0_M_AXI_DC_ARCACHE),
        .M_AXI_DC_ARLEN(microblaze_0_M_AXI_DC_ARLEN),
        .M_AXI_DC_ARLOCK(microblaze_0_M_AXI_DC_ARLOCK),
        .M_AXI_DC_ARPROT(microblaze_0_M_AXI_DC_ARPROT),
        .M_AXI_DC_ARQOS(microblaze_0_M_AXI_DC_ARQOS),
        .M_AXI_DC_ARREADY(microblaze_0_M_AXI_DC_ARREADY),
        .M_AXI_DC_ARSIZE(microblaze_0_M_AXI_DC_ARSIZE),
        .M_AXI_DC_ARVALID(microblaze_0_M_AXI_DC_ARVALID),
        .M_AXI_DC_AWADDR(microblaze_0_M_AXI_DC_AWADDR),
        .M_AXI_DC_AWBURST(microblaze_0_M_AXI_DC_AWBURST),
        .M_AXI_DC_AWCACHE(microblaze_0_M_AXI_DC_AWCACHE),
        .M_AXI_DC_AWLEN(microblaze_0_M_AXI_DC_AWLEN),
        .M_AXI_DC_AWLOCK(microblaze_0_M_AXI_DC_AWLOCK),
        .M_AXI_DC_AWPROT(microblaze_0_M_AXI_DC_AWPROT),
        .M_AXI_DC_AWQOS(microblaze_0_M_AXI_DC_AWQOS),
        .M_AXI_DC_AWREADY(microblaze_0_M_AXI_DC_AWREADY),
        .M_AXI_DC_AWSIZE(microblaze_0_M_AXI_DC_AWSIZE),
        .M_AXI_DC_AWVALID(microblaze_0_M_AXI_DC_AWVALID),
        .M_AXI_DC_BID(1'b0),
        .M_AXI_DC_BREADY(microblaze_0_M_AXI_DC_BREADY),
        .M_AXI_DC_BRESP(microblaze_0_M_AXI_DC_BRESP),
        .M_AXI_DC_BVALID(microblaze_0_M_AXI_DC_BVALID),
        .M_AXI_DC_RDATA(microblaze_0_M_AXI_DC_RDATA),
        .M_AXI_DC_RID(1'b0),
        .M_AXI_DC_RLAST(microblaze_0_M_AXI_DC_RLAST),
        .M_AXI_DC_RREADY(microblaze_0_M_AXI_DC_RREADY),
        .M_AXI_DC_RRESP(microblaze_0_M_AXI_DC_RRESP),
        .M_AXI_DC_RVALID(microblaze_0_M_AXI_DC_RVALID),
        .M_AXI_DC_WDATA(microblaze_0_M_AXI_DC_WDATA),
        .M_AXI_DC_WLAST(microblaze_0_M_AXI_DC_WLAST),
        .M_AXI_DC_WREADY(microblaze_0_M_AXI_DC_WREADY),
        .M_AXI_DC_WSTRB(microblaze_0_M_AXI_DC_WSTRB),
        .M_AXI_DC_WVALID(microblaze_0_M_AXI_DC_WVALID),
        .M_AXI_DP_ARADDR(microblaze_0_M_AXI_DP_ARADDR),
        .M_AXI_DP_ARPROT(microblaze_0_M_AXI_DP_ARPROT),
        .M_AXI_DP_ARREADY(microblaze_0_M_AXI_DP_ARREADY),
        .M_AXI_DP_ARVALID(microblaze_0_M_AXI_DP_ARVALID),
        .M_AXI_DP_AWADDR(microblaze_0_M_AXI_DP_AWADDR),
        .M_AXI_DP_AWPROT(microblaze_0_M_AXI_DP_AWPROT),
        .M_AXI_DP_AWREADY(microblaze_0_M_AXI_DP_AWREADY),
        .M_AXI_DP_AWVALID(microblaze_0_M_AXI_DP_AWVALID),
        .M_AXI_DP_BREADY(microblaze_0_M_AXI_DP_BREADY),
        .M_AXI_DP_BRESP(microblaze_0_M_AXI_DP_BRESP),
        .M_AXI_DP_BVALID(microblaze_0_M_AXI_DP_BVALID),
        .M_AXI_DP_RDATA(microblaze_0_M_AXI_DP_RDATA),
        .M_AXI_DP_RREADY(microblaze_0_M_AXI_DP_RREADY),
        .M_AXI_DP_RRESP(microblaze_0_M_AXI_DP_RRESP),
        .M_AXI_DP_RVALID(microblaze_0_M_AXI_DP_RVALID),
        .M_AXI_DP_WDATA(microblaze_0_M_AXI_DP_WDATA),
        .M_AXI_DP_WREADY(microblaze_0_M_AXI_DP_WREADY),
        .M_AXI_DP_WSTRB(microblaze_0_M_AXI_DP_WSTRB),
        .M_AXI_DP_WVALID(microblaze_0_M_AXI_DP_WVALID),
        .M_AXI_IC_ARADDR(microblaze_0_M_AXI_IC_ARADDR),
        .M_AXI_IC_ARBURST(microblaze_0_M_AXI_IC_ARBURST),
        .M_AXI_IC_ARCACHE(microblaze_0_M_AXI_IC_ARCACHE),
        .M_AXI_IC_ARLEN(microblaze_0_M_AXI_IC_ARLEN),
        .M_AXI_IC_ARLOCK(microblaze_0_M_AXI_IC_ARLOCK),
        .M_AXI_IC_ARPROT(microblaze_0_M_AXI_IC_ARPROT),
        .M_AXI_IC_ARQOS(microblaze_0_M_AXI_IC_ARQOS),
        .M_AXI_IC_ARREADY(microblaze_0_M_AXI_IC_ARREADY),
        .M_AXI_IC_ARSIZE(microblaze_0_M_AXI_IC_ARSIZE),
        .M_AXI_IC_ARVALID(microblaze_0_M_AXI_IC_ARVALID),
        .M_AXI_IC_AWREADY(1'b0),
        .M_AXI_IC_BID(1'b0),
        .M_AXI_IC_BRESP({1'b0,1'b0}),
        .M_AXI_IC_BVALID(1'b0),
        .M_AXI_IC_RDATA(microblaze_0_M_AXI_IC_RDATA),
        .M_AXI_IC_RID(1'b0),
        .M_AXI_IC_RLAST(microblaze_0_M_AXI_IC_RLAST),
        .M_AXI_IC_RREADY(microblaze_0_M_AXI_IC_RREADY),
        .M_AXI_IC_RRESP(microblaze_0_M_AXI_IC_RRESP),
        .M_AXI_IC_RVALID(microblaze_0_M_AXI_IC_RVALID),
        .M_AXI_IC_WREADY(1'b0),
        .Read_Strobe(microblaze_0_dlmb_1_READSTROBE),
        .Reset(rst_clk_wiz_1_100M_mb_reset),
        .Write_Strobe(microblaze_0_dlmb_1_WRITESTROBE));
  design_1_axi_intc_0_0 microblaze_0_axi_intc_0
       (.interrupt_address(axi_intc_0_interrupt_ADDRESS),
        .intr(microblaze_0_xlconcat_dout),
        .irq(axi_intc_0_interrupt_INTERRUPT),
        .processor_ack({axi_intc_0_interrupt_ACK[0],axi_intc_0_interrupt_ACK[1]}),
        .processor_clk(axi_ethernet_0_refclk_clk_200),
        .processor_rst(rst_clk_wiz_1_100M_mb_reset),
        .s_axi_aclk(axi_ethernet_0_refclk_clk_200),
        .s_axi_araddr(microblaze_0_axi_periph_M00_AXI_ARADDR),
        .s_axi_aresetn(rst_mig_7series_0_100M_peripheral_aresetn),
        .s_axi_arready(microblaze_0_axi_periph_M00_AXI_ARREADY),
        .s_axi_arvalid(microblaze_0_axi_periph_M00_AXI_ARVALID),
        .s_axi_awaddr(microblaze_0_axi_periph_M00_AXI_AWADDR),
        .s_axi_awready(microblaze_0_axi_periph_M00_AXI_AWREADY),
        .s_axi_awvalid(microblaze_0_axi_periph_M00_AXI_AWVALID),
        .s_axi_bready(microblaze_0_axi_periph_M00_AXI_BREADY),
        .s_axi_bresp(microblaze_0_axi_periph_M00_AXI_BRESP),
        .s_axi_bvalid(microblaze_0_axi_periph_M00_AXI_BVALID),
        .s_axi_rdata(microblaze_0_axi_periph_M00_AXI_RDATA),
        .s_axi_rready(microblaze_0_axi_periph_M00_AXI_RREADY),
        .s_axi_rresp(microblaze_0_axi_periph_M00_AXI_RRESP),
        .s_axi_rvalid(microblaze_0_axi_periph_M00_AXI_RVALID),
        .s_axi_wdata(microblaze_0_axi_periph_M00_AXI_WDATA),
        .s_axi_wready(microblaze_0_axi_periph_M00_AXI_WREADY),
        .s_axi_wstrb(microblaze_0_axi_periph_M00_AXI_WSTRB),
        .s_axi_wvalid(microblaze_0_axi_periph_M00_AXI_WVALID));
  design_1_smartconnect_0_0 microblaze_0_axi_periph
       (.M00_AXI_araddr(microblaze_0_axi_periph_M00_AXI_ARADDR),
        .M00_AXI_arready(microblaze_0_axi_periph_M00_AXI_ARREADY),
        .M00_AXI_arvalid(microblaze_0_axi_periph_M00_AXI_ARVALID),
        .M00_AXI_awaddr(microblaze_0_axi_periph_M00_AXI_AWADDR),
        .M00_AXI_awready(microblaze_0_axi_periph_M00_AXI_AWREADY),
        .M00_AXI_awvalid(microblaze_0_axi_periph_M00_AXI_AWVALID),
        .M00_AXI_bready(microblaze_0_axi_periph_M00_AXI_BREADY),
        .M00_AXI_bresp(microblaze_0_axi_periph_M00_AXI_BRESP),
        .M00_AXI_bvalid(microblaze_0_axi_periph_M00_AXI_BVALID),
        .M00_AXI_rdata(microblaze_0_axi_periph_M00_AXI_RDATA),
        .M00_AXI_rready(microblaze_0_axi_periph_M00_AXI_RREADY),
        .M00_AXI_rresp(microblaze_0_axi_periph_M00_AXI_RRESP),
        .M00_AXI_rvalid(microblaze_0_axi_periph_M00_AXI_RVALID),
        .M00_AXI_wdata(microblaze_0_axi_periph_M00_AXI_WDATA),
        .M00_AXI_wready(microblaze_0_axi_periph_M00_AXI_WREADY),
        .M00_AXI_wstrb(microblaze_0_axi_periph_M00_AXI_WSTRB),
        .M00_AXI_wvalid(microblaze_0_axi_periph_M00_AXI_WVALID),
        .M01_AXI_araddr(microblaze_0_axi_periph_M01_AXI_ARADDR),
        .M01_AXI_arready(microblaze_0_axi_periph_M01_AXI_ARREADY),
        .M01_AXI_arvalid(microblaze_0_axi_periph_M01_AXI_ARVALID),
        .M01_AXI_awaddr(microblaze_0_axi_periph_M01_AXI_AWADDR),
        .M01_AXI_awready(microblaze_0_axi_periph_M01_AXI_AWREADY),
        .M01_AXI_awvalid(microblaze_0_axi_periph_M01_AXI_AWVALID),
        .M01_AXI_bready(microblaze_0_axi_periph_M01_AXI_BREADY),
        .M01_AXI_bresp(microblaze_0_axi_periph_M01_AXI_BRESP),
        .M01_AXI_bvalid(microblaze_0_axi_periph_M01_AXI_BVALID),
        .M01_AXI_rdata(microblaze_0_axi_periph_M01_AXI_RDATA),
        .M01_AXI_rready(microblaze_0_axi_periph_M01_AXI_RREADY),
        .M01_AXI_rresp(microblaze_0_axi_periph_M01_AXI_RRESP),
        .M01_AXI_rvalid(microblaze_0_axi_periph_M01_AXI_RVALID),
        .M01_AXI_wdata(microblaze_0_axi_periph_M01_AXI_WDATA),
        .M01_AXI_wready(microblaze_0_axi_periph_M01_AXI_WREADY),
        .M01_AXI_wstrb(microblaze_0_axi_periph_M01_AXI_WSTRB),
        .M01_AXI_wvalid(microblaze_0_axi_periph_M01_AXI_WVALID),
        .M02_AXI_araddr(microblaze_0_axi_periph_M02_AXI_ARADDR),
        .M02_AXI_arready(microblaze_0_axi_periph_M02_AXI_ARREADY),
        .M02_AXI_arvalid(microblaze_0_axi_periph_M02_AXI_ARVALID),
        .M02_AXI_awaddr(microblaze_0_axi_periph_M02_AXI_AWADDR),
        .M02_AXI_awready(microblaze_0_axi_periph_M02_AXI_AWREADY),
        .M02_AXI_awvalid(microblaze_0_axi_periph_M02_AXI_AWVALID),
        .M02_AXI_bready(microblaze_0_axi_periph_M02_AXI_BREADY),
        .M02_AXI_bresp(microblaze_0_axi_periph_M02_AXI_BRESP),
        .M02_AXI_bvalid(microblaze_0_axi_periph_M02_AXI_BVALID),
        .M02_AXI_rdata(microblaze_0_axi_periph_M02_AXI_RDATA),
        .M02_AXI_rready(microblaze_0_axi_periph_M02_AXI_RREADY),
        .M02_AXI_rresp(microblaze_0_axi_periph_M02_AXI_RRESP),
        .M02_AXI_rvalid(microblaze_0_axi_periph_M02_AXI_RVALID),
        .M02_AXI_wdata(microblaze_0_axi_periph_M02_AXI_WDATA),
        .M02_AXI_wready(microblaze_0_axi_periph_M02_AXI_WREADY),
        .M02_AXI_wvalid(microblaze_0_axi_periph_M02_AXI_WVALID),
        .M03_AXI_araddr(microblaze_0_axi_periph_M03_AXI_ARADDR),
        .M03_AXI_arready(microblaze_0_axi_periph_M03_AXI_ARREADY),
        .M03_AXI_arvalid(microblaze_0_axi_periph_M03_AXI_ARVALID),
        .M03_AXI_awaddr(microblaze_0_axi_periph_M03_AXI_AWADDR),
        .M03_AXI_awready(microblaze_0_axi_periph_M03_AXI_AWREADY),
        .M03_AXI_awvalid(microblaze_0_axi_periph_M03_AXI_AWVALID),
        .M03_AXI_bready(microblaze_0_axi_periph_M03_AXI_BREADY),
        .M03_AXI_bresp(microblaze_0_axi_periph_M03_AXI_BRESP),
        .M03_AXI_bvalid(microblaze_0_axi_periph_M03_AXI_BVALID),
        .M03_AXI_rdata(microblaze_0_axi_periph_M03_AXI_RDATA),
        .M03_AXI_rready(microblaze_0_axi_periph_M03_AXI_RREADY),
        .M03_AXI_rresp(microblaze_0_axi_periph_M03_AXI_RRESP),
        .M03_AXI_rvalid(microblaze_0_axi_periph_M03_AXI_RVALID),
        .M03_AXI_wdata(microblaze_0_axi_periph_M03_AXI_WDATA),
        .M03_AXI_wready(microblaze_0_axi_periph_M03_AXI_WREADY),
        .M03_AXI_wstrb(microblaze_0_axi_periph_M03_AXI_WSTRB),
        .M03_AXI_wvalid(microblaze_0_axi_periph_M03_AXI_WVALID),
        .M04_AXI_araddr(microblaze_0_axi_periph_M04_AXI_ARADDR),
        .M04_AXI_arready(microblaze_0_axi_periph_M04_AXI_ARREADY),
        .M04_AXI_arvalid(microblaze_0_axi_periph_M04_AXI_ARVALID),
        .M04_AXI_awaddr(microblaze_0_axi_periph_M04_AXI_AWADDR),
        .M04_AXI_awready(microblaze_0_axi_periph_M04_AXI_AWREADY),
        .M04_AXI_awvalid(microblaze_0_axi_periph_M04_AXI_AWVALID),
        .M04_AXI_bready(microblaze_0_axi_periph_M04_AXI_BREADY),
        .M04_AXI_bresp(microblaze_0_axi_periph_M04_AXI_BRESP),
        .M04_AXI_bvalid(microblaze_0_axi_periph_M04_AXI_BVALID),
        .M04_AXI_rdata(microblaze_0_axi_periph_M04_AXI_RDATA),
        .M04_AXI_rready(microblaze_0_axi_periph_M04_AXI_RREADY),
        .M04_AXI_rresp(microblaze_0_axi_periph_M04_AXI_RRESP),
        .M04_AXI_rvalid(microblaze_0_axi_periph_M04_AXI_RVALID),
        .M04_AXI_wdata(microblaze_0_axi_periph_M04_AXI_WDATA),
        .M04_AXI_wready(microblaze_0_axi_periph_M04_AXI_WREADY),
        .M04_AXI_wstrb(microblaze_0_axi_periph_M04_AXI_WSTRB),
        .M04_AXI_wvalid(microblaze_0_axi_periph_M04_AXI_WVALID),
        .M05_AXI_araddr(microblaze_0_axi_periph_M05_AXI_ARADDR),
        .M05_AXI_arready(microblaze_0_axi_periph_M05_AXI_ARREADY),
        .M05_AXI_arvalid(microblaze_0_axi_periph_M05_AXI_ARVALID),
        .M05_AXI_awaddr(microblaze_0_axi_periph_M05_AXI_AWADDR),
        .M05_AXI_awready(microblaze_0_axi_periph_M05_AXI_AWREADY),
        .M05_AXI_awvalid(microblaze_0_axi_periph_M05_AXI_AWVALID),
        .M05_AXI_bready(microblaze_0_axi_periph_M05_AXI_BREADY),
        .M05_AXI_bresp(microblaze_0_axi_periph_M05_AXI_BRESP),
        .M05_AXI_bvalid(microblaze_0_axi_periph_M05_AXI_BVALID),
        .M05_AXI_rdata(microblaze_0_axi_periph_M05_AXI_RDATA),
        .M05_AXI_rready(microblaze_0_axi_periph_M05_AXI_RREADY),
        .M05_AXI_rresp(microblaze_0_axi_periph_M05_AXI_RRESP),
        .M05_AXI_rvalid(microblaze_0_axi_periph_M05_AXI_RVALID),
        .M05_AXI_wdata(microblaze_0_axi_periph_M05_AXI_WDATA),
        .M05_AXI_wready(microblaze_0_axi_periph_M05_AXI_WREADY),
        .M05_AXI_wstrb(microblaze_0_axi_periph_M05_AXI_WSTRB),
        .M05_AXI_wvalid(microblaze_0_axi_periph_M05_AXI_WVALID),
        .M06_AXI_araddr(microblaze_0_axi_periph_M06_AXI_ARADDR),
        .M06_AXI_arready(microblaze_0_axi_periph_M06_AXI_ARREADY),
        .M06_AXI_arvalid(microblaze_0_axi_periph_M06_AXI_ARVALID),
        .M06_AXI_awaddr(microblaze_0_axi_periph_M06_AXI_AWADDR),
        .M06_AXI_awready(microblaze_0_axi_periph_M06_AXI_AWREADY),
        .M06_AXI_awvalid(microblaze_0_axi_periph_M06_AXI_AWVALID),
        .M06_AXI_bready(microblaze_0_axi_periph_M06_AXI_BREADY),
        .M06_AXI_bresp(microblaze_0_axi_periph_M06_AXI_BRESP),
        .M06_AXI_bvalid(microblaze_0_axi_periph_M06_AXI_BVALID),
        .M06_AXI_rdata(microblaze_0_axi_periph_M06_AXI_RDATA),
        .M06_AXI_rready(microblaze_0_axi_periph_M06_AXI_RREADY),
        .M06_AXI_rresp(microblaze_0_axi_periph_M06_AXI_RRESP),
        .M06_AXI_rvalid(microblaze_0_axi_periph_M06_AXI_RVALID),
        .M06_AXI_wdata(microblaze_0_axi_periph_M06_AXI_WDATA),
        .M06_AXI_wready(microblaze_0_axi_periph_M06_AXI_WREADY),
        .M06_AXI_wvalid(microblaze_0_axi_periph_M06_AXI_WVALID),
        .S00_AXI_araddr(microblaze_0_M_AXI_DP_ARADDR),
        .S00_AXI_arprot(microblaze_0_M_AXI_DP_ARPROT),
        .S00_AXI_arready(microblaze_0_M_AXI_DP_ARREADY),
        .S00_AXI_arvalid(microblaze_0_M_AXI_DP_ARVALID),
        .S00_AXI_awaddr(microblaze_0_M_AXI_DP_AWADDR),
        .S00_AXI_awprot(microblaze_0_M_AXI_DP_AWPROT),
        .S00_AXI_awready(microblaze_0_M_AXI_DP_AWREADY),
        .S00_AXI_awvalid(microblaze_0_M_AXI_DP_AWVALID),
        .S00_AXI_bready(microblaze_0_M_AXI_DP_BREADY),
        .S00_AXI_bresp(microblaze_0_M_AXI_DP_BRESP),
        .S00_AXI_bvalid(microblaze_0_M_AXI_DP_BVALID),
        .S00_AXI_rdata(microblaze_0_M_AXI_DP_RDATA),
        .S00_AXI_rready(microblaze_0_M_AXI_DP_RREADY),
        .S00_AXI_rresp(microblaze_0_M_AXI_DP_RRESP),
        .S00_AXI_rvalid(microblaze_0_M_AXI_DP_RVALID),
        .S00_AXI_wdata(microblaze_0_M_AXI_DP_WDATA),
        .S00_AXI_wready(microblaze_0_M_AXI_DP_WREADY),
        .S00_AXI_wstrb(microblaze_0_M_AXI_DP_WSTRB),
        .S00_AXI_wvalid(microblaze_0_M_AXI_DP_WVALID),
        .aclk(axi_ethernet_0_refclk_clk_200),
        .aresetn(rst_mig_7series_0_100M_peripheral_aresetn));
  microblaze_0_local_memory_imp_1K0VQXK microblaze_0_local_memory
       (.DLMB_abus(microblaze_0_dlmb_1_ABUS),
        .DLMB_addrstrobe(microblaze_0_dlmb_1_ADDRSTROBE),
        .DLMB_be(microblaze_0_dlmb_1_BE),
        .DLMB_ce(microblaze_0_dlmb_1_CE),
        .DLMB_readdbus(microblaze_0_dlmb_1_READDBUS),
        .DLMB_readstrobe(microblaze_0_dlmb_1_READSTROBE),
        .DLMB_ready(microblaze_0_dlmb_1_READY),
        .DLMB_ue(microblaze_0_dlmb_1_UE),
        .DLMB_wait(microblaze_0_dlmb_1_WAIT),
        .DLMB_writedbus(microblaze_0_dlmb_1_WRITEDBUS),
        .DLMB_writestrobe(microblaze_0_dlmb_1_WRITESTROBE),
        .ILMB_abus(microblaze_0_ilmb_1_ABUS),
        .ILMB_addrstrobe(microblaze_0_ilmb_1_ADDRSTROBE),
        .ILMB_ce(microblaze_0_ilmb_1_CE),
        .ILMB_readdbus(microblaze_0_ilmb_1_READDBUS),
        .ILMB_readstrobe(microblaze_0_ilmb_1_READSTROBE),
        .ILMB_ready(microblaze_0_ilmb_1_READY),
        .ILMB_ue(microblaze_0_ilmb_1_UE),
        .ILMB_wait(microblaze_0_ilmb_1_WAIT),
        .LMB_Clk(axi_ethernet_0_refclk_clk_200),
        .SYS_Rst(rst_clk_wiz_1_100M_bus_struct_reset));
  assign microblaze_0_xlconcat_dout = {axi_ethernet_0_interrupt, axi_ethernet_0_mac_irq, axi_ethernet_0_dma_s2mm_introut, axi_ethernet_0_dma_mm2s_introut, axi_timer_0_interrupt};
  design_1_mig_7series_0_1 mig_7series_0
       (.aresetn(rst_mig_7series_0_100M_peripheral_aresetn1),
        .clk_ref_i(clk_wiz_1_clk_200),
        .ddr3_addr(DDR3_0_addr),
        .ddr3_ba(DDR3_0_ba),
        .ddr3_cas_n(DDR3_0_cas_n),
        .ddr3_ck_n(DDR3_0_ck_n),
        .ddr3_ck_p(DDR3_0_ck_p),
        .ddr3_cke(DDR3_0_cke),
        .ddr3_dm(DDR3_0_dm),
        .ddr3_dq(DDR3_0_dq),
        .ddr3_dqs_n(DDR3_0_dqs_n),
        .ddr3_dqs_p(DDR3_0_dqs_p),
        .ddr3_odt(DDR3_0_odt),
        .ddr3_ras_n(DDR3_0_ras_n),
        .ddr3_reset_n(DDR3_0_reset_n),
        .ddr3_we_n(DDR3_0_we_n),
        .mmcm_locked(mig_7series_0_mmcm_locked),
        .s_axi_araddr(axi_smc_M00_AXI_ARADDR),
        .s_axi_arburst(axi_smc_M00_AXI_ARBURST),
        .s_axi_arcache(axi_smc_M00_AXI_ARCACHE),
        .s_axi_arid({1'b0,1'b0,1'b0}),
        .s_axi_arlen(axi_smc_M00_AXI_ARLEN),
        .s_axi_arlock(axi_smc_M00_AXI_ARLOCK),
        .s_axi_arprot(axi_smc_M00_AXI_ARPROT),
        .s_axi_arqos(axi_smc_M00_AXI_ARQOS),
        .s_axi_arready(axi_smc_M00_AXI_ARREADY),
        .s_axi_arsize(axi_smc_M00_AXI_ARSIZE),
        .s_axi_arvalid(axi_smc_M00_AXI_ARVALID),
        .s_axi_awaddr(axi_smc_M00_AXI_AWADDR),
        .s_axi_awburst(axi_smc_M00_AXI_AWBURST),
        .s_axi_awcache(axi_smc_M00_AXI_AWCACHE),
        .s_axi_awid({1'b0,1'b0,1'b0}),
        .s_axi_awlen(axi_smc_M00_AXI_AWLEN),
        .s_axi_awlock(axi_smc_M00_AXI_AWLOCK),
        .s_axi_awprot(axi_smc_M00_AXI_AWPROT),
        .s_axi_awqos(axi_smc_M00_AXI_AWQOS),
        .s_axi_awready(axi_smc_M00_AXI_AWREADY),
        .s_axi_awsize(axi_smc_M00_AXI_AWSIZE),
        .s_axi_awvalid(axi_smc_M00_AXI_AWVALID),
        .s_axi_bready(axi_smc_M00_AXI_BREADY),
        .s_axi_bresp(axi_smc_M00_AXI_BRESP),
        .s_axi_bvalid(axi_smc_M00_AXI_BVALID),
        .s_axi_rdata(axi_smc_M00_AXI_RDATA),
        .s_axi_rlast(axi_smc_M00_AXI_RLAST),
        .s_axi_rready(axi_smc_M00_AXI_RREADY),
        .s_axi_rresp(axi_smc_M00_AXI_RRESP),
        .s_axi_rvalid(axi_smc_M00_AXI_RVALID),
        .s_axi_wdata(axi_smc_M00_AXI_WDATA),
        .s_axi_wlast(axi_smc_M00_AXI_WLAST),
        .s_axi_wready(axi_smc_M00_AXI_WREADY),
        .s_axi_wstrb(axi_smc_M00_AXI_WSTRB),
        .s_axi_wvalid(axi_smc_M00_AXI_WVALID),
        .sys_clk_i(axi_ethernet_0_refclk_clk_200),
        .sys_rst(reset),
        .ui_clk(mig_7series_0_ui_clk),
        .ui_clk_sync_rst(mig_7series_0_ui_clk_sync_rst));
  design_1_proc_sys_reset_0_0 rst_clk_wiz_1_100M
       (.aux_reset_in(1'b1),
        .bus_struct_reset(rst_clk_wiz_1_100M_bus_struct_reset),
        .dcm_locked(axi_ethernet_0_refclk_locked),
        .ext_reset_in(reset),
        .mb_debug_sys_rst(mdm_1_Debug_SYS_Rst),
        .mb_reset(rst_clk_wiz_1_100M_mb_reset),
        .peripheral_aresetn(rst_mig_7series_0_100M_peripheral_aresetn),
        .slowest_sync_clk(axi_ethernet_0_refclk_clk_200));
  design_1_rst_mig_7series_0_100M_1 rst_mig_7series_0_100M
       (.aux_reset_in(1'b1),
        .dcm_locked(mig_7series_0_mmcm_locked),
        .ext_reset_in(mig_7series_0_ui_clk_sync_rst),
        .mb_debug_sys_rst(1'b0),
        .peripheral_aresetn(rst_mig_7series_0_100M_peripheral_aresetn1),
        .slowest_sync_clk(mig_7series_0_ui_clk));
  design_1_tokenizer_axi_lite_0_0 tokenizer_axi_lite_0
       (.m_axis_tdata(tokenizer_axi_lite_0_m_axis_TDATA),
        .m_axis_tlast(tokenizer_axi_lite_0_m_axis_TLAST),
        .m_axis_tready(tokenizer_axi_lite_0_m_axis_TREADY),
        .m_axis_tvalid(tokenizer_axi_lite_0_m_axis_TVALID),
        .s_axi_aclk(axi_ethernet_0_refclk_clk_200),
        .s_axi_araddr(microblaze_0_axi_periph_M05_AXI_ARADDR),
        .s_axi_aresetn(rst_mig_7series_0_100M_peripheral_aresetn),
        .s_axi_arready(microblaze_0_axi_periph_M05_AXI_ARREADY),
        .s_axi_arvalid(microblaze_0_axi_periph_M05_AXI_ARVALID),
        .s_axi_awaddr(microblaze_0_axi_periph_M05_AXI_AWADDR),
        .s_axi_awready(microblaze_0_axi_periph_M05_AXI_AWREADY),
        .s_axi_awvalid(microblaze_0_axi_periph_M05_AXI_AWVALID),
        .s_axi_bready(microblaze_0_axi_periph_M05_AXI_BREADY),
        .s_axi_bresp(microblaze_0_axi_periph_M05_AXI_BRESP),
        .s_axi_bvalid(microblaze_0_axi_periph_M05_AXI_BVALID),
        .s_axi_rdata(microblaze_0_axi_periph_M05_AXI_RDATA),
        .s_axi_rready(microblaze_0_axi_periph_M05_AXI_RREADY),
        .s_axi_rresp(microblaze_0_axi_periph_M05_AXI_RRESP),
        .s_axi_rvalid(microblaze_0_axi_periph_M05_AXI_RVALID),
        .s_axi_wdata(microblaze_0_axi_periph_M05_AXI_WDATA),
        .s_axi_wready(microblaze_0_axi_periph_M05_AXI_WREADY),
        .s_axi_wstrb(microblaze_0_axi_periph_M05_AXI_WSTRB),
        .s_axi_wvalid(microblaze_0_axi_periph_M05_AXI_WVALID),
        .s_axis_tdata(axi_dma_0_M_AXIS_MM2S_TDATA),
        .s_axis_tlast(axi_dma_0_M_AXIS_MM2S_TLAST),
        .s_axis_tready(axi_dma_0_M_AXIS_MM2S_TREADY),
        .s_axis_tvalid(axi_dma_0_M_AXIS_MM2S_TVALID));
endmodule

module microblaze_0_local_memory_imp_1K0VQXK
   (DLMB_abus,
    DLMB_addrstrobe,
    DLMB_be,
    DLMB_ce,
    DLMB_readdbus,
    DLMB_readstrobe,
    DLMB_ready,
    DLMB_ue,
    DLMB_wait,
    DLMB_writedbus,
    DLMB_writestrobe,
    ILMB_abus,
    ILMB_addrstrobe,
    ILMB_ce,
    ILMB_readdbus,
    ILMB_readstrobe,
    ILMB_ready,
    ILMB_ue,
    ILMB_wait,
    LMB_Clk,
    SYS_Rst);
  input [0:31]DLMB_abus;
  input DLMB_addrstrobe;
  input [0:3]DLMB_be;
  output DLMB_ce;
  output [0:31]DLMB_readdbus;
  input DLMB_readstrobe;
  output DLMB_ready;
  output DLMB_ue;
  output DLMB_wait;
  input [0:31]DLMB_writedbus;
  input DLMB_writestrobe;
  input [0:31]ILMB_abus;
  input ILMB_addrstrobe;
  output ILMB_ce;
  output [0:31]ILMB_readdbus;
  input ILMB_readstrobe;
  output ILMB_ready;
  output ILMB_ue;
  output ILMB_wait;
  input LMB_Clk;
  input SYS_Rst;

  wire [0:31]DLMB_abus;
  wire DLMB_addrstrobe;
  wire [0:3]DLMB_be;
  wire DLMB_ce;
  wire [0:31]DLMB_readdbus;
  wire DLMB_readstrobe;
  wire DLMB_ready;
  wire DLMB_ue;
  wire DLMB_wait;
  wire [0:31]DLMB_writedbus;
  wire DLMB_writestrobe;
  wire [0:31]ILMB_abus;
  wire ILMB_addrstrobe;
  wire ILMB_ce;
  wire [0:31]ILMB_readdbus;
  wire ILMB_readstrobe;
  wire ILMB_ready;
  wire ILMB_ue;
  wire ILMB_wait;
  wire LMB_Clk;
  wire SYS_Rst;
  wire [0:31]microblaze_0_dlmb_bus_ABUS;
  wire microblaze_0_dlmb_bus_ADDRSTROBE;
  wire [0:3]microblaze_0_dlmb_bus_BE;
  wire microblaze_0_dlmb_bus_CE;
  wire [0:31]microblaze_0_dlmb_bus_READDBUS;
  wire microblaze_0_dlmb_bus_READSTROBE;
  wire microblaze_0_dlmb_bus_READY;
  wire microblaze_0_dlmb_bus_UE;
  wire microblaze_0_dlmb_bus_WAIT;
  wire [0:31]microblaze_0_dlmb_bus_WRITEDBUS;
  wire microblaze_0_dlmb_bus_WRITESTROBE;
  wire [0:31]microblaze_0_dlmb_cntlr_ADDR;
  wire microblaze_0_dlmb_cntlr_CLK;
  wire [0:31]microblaze_0_dlmb_cntlr_DIN;
  wire [31:0]microblaze_0_dlmb_cntlr_DOUT;
  wire microblaze_0_dlmb_cntlr_EN;
  wire microblaze_0_dlmb_cntlr_RST;
  wire [0:3]microblaze_0_dlmb_cntlr_WE;
  wire [0:31]microblaze_0_ilmb_bus_ABUS;
  wire microblaze_0_ilmb_bus_ADDRSTROBE;
  wire [0:3]microblaze_0_ilmb_bus_BE;
  wire microblaze_0_ilmb_bus_CE;
  wire [0:31]microblaze_0_ilmb_bus_READDBUS;
  wire microblaze_0_ilmb_bus_READSTROBE;
  wire microblaze_0_ilmb_bus_READY;
  wire microblaze_0_ilmb_bus_UE;
  wire microblaze_0_ilmb_bus_WAIT;
  wire [0:31]microblaze_0_ilmb_bus_WRITEDBUS;
  wire microblaze_0_ilmb_bus_WRITESTROBE;
  wire [0:31]microblaze_0_ilmb_cntlr_ADDR;
  wire microblaze_0_ilmb_cntlr_CLK;
  wire [0:31]microblaze_0_ilmb_cntlr_DIN;
  wire [31:0]microblaze_0_ilmb_cntlr_DOUT;
  wire microblaze_0_ilmb_cntlr_EN;
  wire microblaze_0_ilmb_cntlr_RST;
  wire [0:3]microblaze_0_ilmb_cntlr_WE;

  (* BMM_INFO_ADDRESS_SPACE = "byte  0x00000000 32 > design_1 microblaze_0_local_memory/lmb_bram" *) 
  (* KEEP_HIERARCHY = "YES" *) 
  design_1_dlmb_bram_if_cntlr_1 dlmb_bram_if_cntlr
       (.BRAM_Addr_A(microblaze_0_dlmb_cntlr_ADDR),
        .BRAM_Clk_A(microblaze_0_dlmb_cntlr_CLK),
        .BRAM_Din_A({microblaze_0_dlmb_cntlr_DOUT[31],microblaze_0_dlmb_cntlr_DOUT[30],microblaze_0_dlmb_cntlr_DOUT[29],microblaze_0_dlmb_cntlr_DOUT[28],microblaze_0_dlmb_cntlr_DOUT[27],microblaze_0_dlmb_cntlr_DOUT[26],microblaze_0_dlmb_cntlr_DOUT[25],microblaze_0_dlmb_cntlr_DOUT[24],microblaze_0_dlmb_cntlr_DOUT[23],microblaze_0_dlmb_cntlr_DOUT[22],microblaze_0_dlmb_cntlr_DOUT[21],microblaze_0_dlmb_cntlr_DOUT[20],microblaze_0_dlmb_cntlr_DOUT[19],microblaze_0_dlmb_cntlr_DOUT[18],microblaze_0_dlmb_cntlr_DOUT[17],microblaze_0_dlmb_cntlr_DOUT[16],microblaze_0_dlmb_cntlr_DOUT[15],microblaze_0_dlmb_cntlr_DOUT[14],microblaze_0_dlmb_cntlr_DOUT[13],microblaze_0_dlmb_cntlr_DOUT[12],microblaze_0_dlmb_cntlr_DOUT[11],microblaze_0_dlmb_cntlr_DOUT[10],microblaze_0_dlmb_cntlr_DOUT[9],microblaze_0_dlmb_cntlr_DOUT[8],microblaze_0_dlmb_cntlr_DOUT[7],microblaze_0_dlmb_cntlr_DOUT[6],microblaze_0_dlmb_cntlr_DOUT[5],microblaze_0_dlmb_cntlr_DOUT[4],microblaze_0_dlmb_cntlr_DOUT[3],microblaze_0_dlmb_cntlr_DOUT[2],microblaze_0_dlmb_cntlr_DOUT[1],microblaze_0_dlmb_cntlr_DOUT[0]}),
        .BRAM_Dout_A(microblaze_0_dlmb_cntlr_DIN),
        .BRAM_EN_A(microblaze_0_dlmb_cntlr_EN),
        .BRAM_Rst_A(microblaze_0_dlmb_cntlr_RST),
        .BRAM_WEN_A(microblaze_0_dlmb_cntlr_WE),
        .LMB_ABus(microblaze_0_dlmb_bus_ABUS),
        .LMB_AddrStrobe(microblaze_0_dlmb_bus_ADDRSTROBE),
        .LMB_BE(microblaze_0_dlmb_bus_BE),
        .LMB_Clk(LMB_Clk),
        .LMB_ReadStrobe(microblaze_0_dlmb_bus_READSTROBE),
        .LMB_Rst(SYS_Rst),
        .LMB_WriteDBus(microblaze_0_dlmb_bus_WRITEDBUS),
        .LMB_WriteStrobe(microblaze_0_dlmb_bus_WRITESTROBE),
        .Sl_CE(microblaze_0_dlmb_bus_CE),
        .Sl_DBus(microblaze_0_dlmb_bus_READDBUS),
        .Sl_Ready(microblaze_0_dlmb_bus_READY),
        .Sl_UE(microblaze_0_dlmb_bus_UE),
        .Sl_Wait(microblaze_0_dlmb_bus_WAIT));
  design_1_dlmb_v10_1 dlmb_v10
       (.LMB_ABus(microblaze_0_dlmb_bus_ABUS),
        .LMB_AddrStrobe(microblaze_0_dlmb_bus_ADDRSTROBE),
        .LMB_BE(microblaze_0_dlmb_bus_BE),
        .LMB_CE(DLMB_ce),
        .LMB_Clk(LMB_Clk),
        .LMB_ReadDBus(DLMB_readdbus),
        .LMB_ReadStrobe(microblaze_0_dlmb_bus_READSTROBE),
        .LMB_Ready(DLMB_ready),
        .LMB_UE(DLMB_ue),
        .LMB_Wait(DLMB_wait),
        .LMB_WriteDBus(microblaze_0_dlmb_bus_WRITEDBUS),
        .LMB_WriteStrobe(microblaze_0_dlmb_bus_WRITESTROBE),
        .M_ABus(DLMB_abus),
        .M_AddrStrobe(DLMB_addrstrobe),
        .M_BE(DLMB_be),
        .M_DBus(DLMB_writedbus),
        .M_ReadStrobe(DLMB_readstrobe),
        .M_WriteStrobe(DLMB_writestrobe),
        .SYS_Rst(SYS_Rst),
        .Sl_CE(microblaze_0_dlmb_bus_CE),
        .Sl_DBus(microblaze_0_dlmb_bus_READDBUS),
        .Sl_Ready(microblaze_0_dlmb_bus_READY),
        .Sl_UE(microblaze_0_dlmb_bus_UE),
        .Sl_Wait(microblaze_0_dlmb_bus_WAIT));
  design_1_ilmb_bram_if_cntlr_1 ilmb_bram_if_cntlr
       (.BRAM_Addr_A(microblaze_0_ilmb_cntlr_ADDR),
        .BRAM_Clk_A(microblaze_0_ilmb_cntlr_CLK),
        .BRAM_Din_A({microblaze_0_ilmb_cntlr_DOUT[31],microblaze_0_ilmb_cntlr_DOUT[30],microblaze_0_ilmb_cntlr_DOUT[29],microblaze_0_ilmb_cntlr_DOUT[28],microblaze_0_ilmb_cntlr_DOUT[27],microblaze_0_ilmb_cntlr_DOUT[26],microblaze_0_ilmb_cntlr_DOUT[25],microblaze_0_ilmb_cntlr_DOUT[24],microblaze_0_ilmb_cntlr_DOUT[23],microblaze_0_ilmb_cntlr_DOUT[22],microblaze_0_ilmb_cntlr_DOUT[21],microblaze_0_ilmb_cntlr_DOUT[20],microblaze_0_ilmb_cntlr_DOUT[19],microblaze_0_ilmb_cntlr_DOUT[18],microblaze_0_ilmb_cntlr_DOUT[17],microblaze_0_ilmb_cntlr_DOUT[16],microblaze_0_ilmb_cntlr_DOUT[15],microblaze_0_ilmb_cntlr_DOUT[14],microblaze_0_ilmb_cntlr_DOUT[13],microblaze_0_ilmb_cntlr_DOUT[12],microblaze_0_ilmb_cntlr_DOUT[11],microblaze_0_ilmb_cntlr_DOUT[10],microblaze_0_ilmb_cntlr_DOUT[9],microblaze_0_ilmb_cntlr_DOUT[8],microblaze_0_ilmb_cntlr_DOUT[7],microblaze_0_ilmb_cntlr_DOUT[6],microblaze_0_ilmb_cntlr_DOUT[5],microblaze_0_ilmb_cntlr_DOUT[4],microblaze_0_ilmb_cntlr_DOUT[3],microblaze_0_ilmb_cntlr_DOUT[2],microblaze_0_ilmb_cntlr_DOUT[1],microblaze_0_ilmb_cntlr_DOUT[0]}),
        .BRAM_Dout_A(microblaze_0_ilmb_cntlr_DIN),
        .BRAM_EN_A(microblaze_0_ilmb_cntlr_EN),
        .BRAM_Rst_A(microblaze_0_ilmb_cntlr_RST),
        .BRAM_WEN_A(microblaze_0_ilmb_cntlr_WE),
        .LMB_ABus(microblaze_0_ilmb_bus_ABUS),
        .LMB_AddrStrobe(microblaze_0_ilmb_bus_ADDRSTROBE),
        .LMB_BE(microblaze_0_ilmb_bus_BE),
        .LMB_Clk(LMB_Clk),
        .LMB_ReadStrobe(microblaze_0_ilmb_bus_READSTROBE),
        .LMB_Rst(SYS_Rst),
        .LMB_WriteDBus(microblaze_0_ilmb_bus_WRITEDBUS),
        .LMB_WriteStrobe(microblaze_0_ilmb_bus_WRITESTROBE),
        .Sl_CE(microblaze_0_ilmb_bus_CE),
        .Sl_DBus(microblaze_0_ilmb_bus_READDBUS),
        .Sl_Ready(microblaze_0_ilmb_bus_READY),
        .Sl_UE(microblaze_0_ilmb_bus_UE),
        .Sl_Wait(microblaze_0_ilmb_bus_WAIT));
  design_1_ilmb_v10_1 ilmb_v10
       (.LMB_ABus(microblaze_0_ilmb_bus_ABUS),
        .LMB_AddrStrobe(microblaze_0_ilmb_bus_ADDRSTROBE),
        .LMB_BE(microblaze_0_ilmb_bus_BE),
        .LMB_CE(ILMB_ce),
        .LMB_Clk(LMB_Clk),
        .LMB_ReadDBus(ILMB_readdbus),
        .LMB_ReadStrobe(microblaze_0_ilmb_bus_READSTROBE),
        .LMB_Ready(ILMB_ready),
        .LMB_UE(ILMB_ue),
        .LMB_Wait(ILMB_wait),
        .LMB_WriteDBus(microblaze_0_ilmb_bus_WRITEDBUS),
        .LMB_WriteStrobe(microblaze_0_ilmb_bus_WRITESTROBE),
        .M_ABus(ILMB_abus),
        .M_AddrStrobe(ILMB_addrstrobe),
        .M_BE({1'b0,1'b0,1'b0,1'b0}),
        .M_DBus({1'b0,1'b0,1'b0,1'b0,1'b0,1'b0,1'b0,1'b0,1'b0,1'b0,1'b0,1'b0,1'b0,1'b0,1'b0,1'b0,1'b0,1'b0,1'b0,1'b0,1'b0,1'b0,1'b0,1'b0,1'b0,1'b0,1'b0,1'b0,1'b0,1'b0,1'b0,1'b0}),
        .M_ReadStrobe(ILMB_readstrobe),
        .M_WriteStrobe(1'b0),
        .SYS_Rst(SYS_Rst),
        .Sl_CE(microblaze_0_ilmb_bus_CE),
        .Sl_DBus(microblaze_0_ilmb_bus_READDBUS),
        .Sl_Ready(microblaze_0_ilmb_bus_READY),
        .Sl_UE(microblaze_0_ilmb_bus_UE),
        .Sl_Wait(microblaze_0_ilmb_bus_WAIT));
  design_1_lmb_bram_1 lmb_bram
       (.addra({microblaze_0_dlmb_cntlr_ADDR[0],microblaze_0_dlmb_cntlr_ADDR[1],microblaze_0_dlmb_cntlr_ADDR[2],microblaze_0_dlmb_cntlr_ADDR[3],microblaze_0_dlmb_cntlr_ADDR[4],microblaze_0_dlmb_cntlr_ADDR[5],microblaze_0_dlmb_cntlr_ADDR[6],microblaze_0_dlmb_cntlr_ADDR[7],microblaze_0_dlmb_cntlr_ADDR[8],microblaze_0_dlmb_cntlr_ADDR[9],microblaze_0_dlmb_cntlr_ADDR[10],microblaze_0_dlmb_cntlr_ADDR[11],microblaze_0_dlmb_cntlr_ADDR[12],microblaze_0_dlmb_cntlr_ADDR[13],microblaze_0_dlmb_cntlr_ADDR[14],microblaze_0_dlmb_cntlr_ADDR[15],microblaze_0_dlmb_cntlr_ADDR[16],microblaze_0_dlmb_cntlr_ADDR[17],microblaze_0_dlmb_cntlr_ADDR[18],microblaze_0_dlmb_cntlr_ADDR[19],microblaze_0_dlmb_cntlr_ADDR[20],microblaze_0_dlmb_cntlr_ADDR[21],microblaze_0_dlmb_cntlr_ADDR[22],microblaze_0_dlmb_cntlr_ADDR[23],microblaze_0_dlmb_cntlr_ADDR[24],microblaze_0_dlmb_cntlr_ADDR[25],microblaze_0_dlmb_cntlr_ADDR[26],microblaze_0_dlmb_cntlr_ADDR[27],microblaze_0_dlmb_cntlr_ADDR[28],microblaze_0_dlmb_cntlr_ADDR[29],microblaze_0_dlmb_cntlr_ADDR[30],microblaze_0_dlmb_cntlr_ADDR[31]}),
        .addrb({microblaze_0_ilmb_cntlr_ADDR[0],microblaze_0_ilmb_cntlr_ADDR[1],microblaze_0_ilmb_cntlr_ADDR[2],microblaze_0_ilmb_cntlr_ADDR[3],microblaze_0_ilmb_cntlr_ADDR[4],microblaze_0_ilmb_cntlr_ADDR[5],microblaze_0_ilmb_cntlr_ADDR[6],microblaze_0_ilmb_cntlr_ADDR[7],microblaze_0_ilmb_cntlr_ADDR[8],microblaze_0_ilmb_cntlr_ADDR[9],microblaze_0_ilmb_cntlr_ADDR[10],microblaze_0_ilmb_cntlr_ADDR[11],microblaze_0_ilmb_cntlr_ADDR[12],microblaze_0_ilmb_cntlr_ADDR[13],microblaze_0_ilmb_cntlr_ADDR[14],microblaze_0_ilmb_cntlr_ADDR[15],microblaze_0_ilmb_cntlr_ADDR[16],microblaze_0_ilmb_cntlr_ADDR[17],microblaze_0_ilmb_cntlr_ADDR[18],microblaze_0_ilmb_cntlr_ADDR[19],microblaze_0_ilmb_cntlr_ADDR[20],microblaze_0_ilmb_cntlr_ADDR[21],microblaze_0_ilmb_cntlr_ADDR[22],microblaze_0_ilmb_cntlr_ADDR[23],microblaze_0_ilmb_cntlr_ADDR[24],microblaze_0_ilmb_cntlr_ADDR[25],microblaze_0_ilmb_cntlr_ADDR[26],microblaze_0_ilmb_cntlr_ADDR[27],microblaze_0_ilmb_cntlr_ADDR[28],microblaze_0_ilmb_cntlr_ADDR[29],microblaze_0_ilmb_cntlr_ADDR[30],microblaze_0_ilmb_cntlr_ADDR[31]}),
        .clka(microblaze_0_dlmb_cntlr_CLK),
        .clkb(microblaze_0_ilmb_cntlr_CLK),
        .dina({microblaze_0_dlmb_cntlr_DIN[0],microblaze_0_dlmb_cntlr_DIN[1],microblaze_0_dlmb_cntlr_DIN[2],microblaze_0_dlmb_cntlr_DIN[3],microblaze_0_dlmb_cntlr_DIN[4],microblaze_0_dlmb_cntlr_DIN[5],microblaze_0_dlmb_cntlr_DIN[6],microblaze_0_dlmb_cntlr_DIN[7],microblaze_0_dlmb_cntlr_DIN[8],microblaze_0_dlmb_cntlr_DIN[9],microblaze_0_dlmb_cntlr_DIN[10],microblaze_0_dlmb_cntlr_DIN[11],microblaze_0_dlmb_cntlr_DIN[12],microblaze_0_dlmb_cntlr_DIN[13],microblaze_0_dlmb_cntlr_DIN[14],microblaze_0_dlmb_cntlr_DIN[15],microblaze_0_dlmb_cntlr_DIN[16],microblaze_0_dlmb_cntlr_DIN[17],microblaze_0_dlmb_cntlr_DIN[18],microblaze_0_dlmb_cntlr_DIN[19],microblaze_0_dlmb_cntlr_DIN[20],microblaze_0_dlmb_cntlr_DIN[21],microblaze_0_dlmb_cntlr_DIN[22],microblaze_0_dlmb_cntlr_DIN[23],microblaze_0_dlmb_cntlr_DIN[24],microblaze_0_dlmb_cntlr_DIN[25],microblaze_0_dlmb_cntlr_DIN[26],microblaze_0_dlmb_cntlr_DIN[27],microblaze_0_dlmb_cntlr_DIN[28],microblaze_0_dlmb_cntlr_DIN[29],microblaze_0_dlmb_cntlr_DIN[30],microblaze_0_dlmb_cntlr_DIN[31]}),
        .dinb({microblaze_0_ilmb_cntlr_DIN[0],microblaze_0_ilmb_cntlr_DIN[1],microblaze_0_ilmb_cntlr_DIN[2],microblaze_0_ilmb_cntlr_DIN[3],microblaze_0_ilmb_cntlr_DIN[4],microblaze_0_ilmb_cntlr_DIN[5],microblaze_0_ilmb_cntlr_DIN[6],microblaze_0_ilmb_cntlr_DIN[7],microblaze_0_ilmb_cntlr_DIN[8],microblaze_0_ilmb_cntlr_DIN[9],microblaze_0_ilmb_cntlr_DIN[10],microblaze_0_ilmb_cntlr_DIN[11],microblaze_0_ilmb_cntlr_DIN[12],microblaze_0_ilmb_cntlr_DIN[13],microblaze_0_ilmb_cntlr_DIN[14],microblaze_0_ilmb_cntlr_DIN[15],microblaze_0_ilmb_cntlr_DIN[16],microblaze_0_ilmb_cntlr_DIN[17],microblaze_0_ilmb_cntlr_DIN[18],microblaze_0_ilmb_cntlr_DIN[19],microblaze_0_ilmb_cntlr_DIN[20],microblaze_0_ilmb_cntlr_DIN[21],microblaze_0_ilmb_cntlr_DIN[22],microblaze_0_ilmb_cntlr_DIN[23],microblaze_0_ilmb_cntlr_DIN[24],microblaze_0_ilmb_cntlr_DIN[25],microblaze_0_ilmb_cntlr_DIN[26],microblaze_0_ilmb_cntlr_DIN[27],microblaze_0_ilmb_cntlr_DIN[28],microblaze_0_ilmb_cntlr_DIN[29],microblaze_0_ilmb_cntlr_DIN[30],microblaze_0_ilmb_cntlr_DIN[31]}),
        .douta(microblaze_0_dlmb_cntlr_DOUT),
        .doutb(microblaze_0_ilmb_cntlr_DOUT),
        .ena(microblaze_0_dlmb_cntlr_EN),
        .enb(microblaze_0_ilmb_cntlr_EN),
        .rsta(microblaze_0_dlmb_cntlr_RST),
        .rstb(microblaze_0_ilmb_cntlr_RST),
        .wea({microblaze_0_dlmb_cntlr_WE[0],microblaze_0_dlmb_cntlr_WE[1],microblaze_0_dlmb_cntlr_WE[2],microblaze_0_dlmb_cntlr_WE[3]}),
        .web({microblaze_0_ilmb_cntlr_WE[0],microblaze_0_ilmb_cntlr_WE[1],microblaze_0_ilmb_cntlr_WE[2],microblaze_0_ilmb_cntlr_WE[3]}));
endmodule
