talsh123/tokenizer-vivado/uart.gen/sources_1/bd/design_1/ip/design_1_smartconnect_0_0/bd_0/synth/bd_48ac.v

//Copyright 1986-2022 Xilinx, Inc. All Rights Reserved.
//Copyright 2022-2025 Advanced Micro Devices, Inc. All Rights Reserved.
//--------------------------------------------------------------------------------
//Command: generate_target bd_48ac.bd
//Design : bd_48ac
//Purpose: IP block netlist
//--------------------------------------------------------------------------------
`timescale 1 ps / 1 ps

(* CORE_GENERATION_INFO = "bd_48ac,IP_Integrator,{x_ipVendor=xilinx.com,x_ipLibrary=BlockDiagram,x_ipName=bd_48ac,x_ipVersion=1.00.a,x_ipLanguage=VERILOG,numBlks=94,numReposBlks=75,numNonXlnxBlks=0,numHierBlks=19,maxHierDepth=2,numSysgenBlks=0,numHlsBlks=0,numHdlrefBlks=0,numPkgbdBlks=0,bdsource=SBD,synth_mode=None}" *) (* HW_HANDOFF = "design_1_smartconnect_0_0.hwdef" *) 
module bd_48ac
   (M00_AXI_araddr,
    M00_AXI_arprot,
    M00_AXI_arready,
    M00_AXI_arvalid,
    M00_AXI_awaddr,
    M00_AXI_awprot,
    M00_AXI_awready,
    M00_AXI_awvalid,
    M00_AXI_bready,
    M00_AXI_bresp,
    M00_AXI_bvalid,
    M00_AXI_rdata,
    M00_AXI_rready,
    M00_AXI_rresp,
    M00_AXI_rvalid,
    M00_AXI_wdata,
    M00_AXI_wready,
    M00_AXI_wstrb,
    M00_AXI_wvalid,
    M01_AXI_araddr,
    M01_AXI_arprot,
    M01_AXI_arready,
    M01_AXI_arvalid,
    M01_AXI_awaddr,
    M01_AXI_awprot,
    M01_AXI_awready,
    M01_AXI_awvalid,
    M01_AXI_bready,
    M01_AXI_bresp,
    M01_AXI_bvalid,
    M01_AXI_rdata,
    M01_AXI_rready,
    M01_AXI_rresp,
    M01_AXI_rvalid,
    M01_AXI_wdata,
    M01_AXI_wready,
    M01_AXI_wstrb,
    M01_AXI_wvalid,
    M02_AXI_araddr,
    M02_AXI_arprot,
    M02_AXI_arready,
    M02_AXI_arvalid,
    M02_AXI_awaddr,
    M02_AXI_awprot,
    M02_AXI_awready,
    M02_AXI_awvalid,
    M02_AXI_bready,
    M02_AXI_bresp,
    M02_AXI_bvalid,
    M02_AXI_rdata,
    M02_AXI_rready,
    M02_AXI_rresp,
    M02_AXI_rvalid,
    M02_AXI_wdata,
    M02_AXI_wready,
    M02_AXI_wstrb,
    M02_AXI_wvalid,
    M03_AXI_araddr,
    M03_AXI_arprot,
    M03_AXI_arready,
    M03_AXI_arvalid,
    M03_AXI_awaddr,
    M03_AXI_awprot,
    M03_AXI_awready,
    M03_AXI_awvalid,
    M03_AXI_bready,
    M03_AXI_bresp,
    M03_AXI_bvalid,
    M03_AXI_rdata,
    M03_AXI_rready,
    M03_AXI_rresp,
    M03_AXI_rvalid,
    M03_AXI_wdata,
    M03_AXI_wready,
    M03_AXI_wstrb,
    M03_AXI_wvalid,
    M04_AXI_araddr,
    M04_AXI_arprot,
    M04_AXI_arready,
    M04_AXI_arvalid,
    M04_AXI_awaddr,
    M04_AXI_awprot,
    M04_AXI_awready,
    M04_AXI_awvalid,
    M04_AXI_bready,
    M04_AXI_bresp,
    M04_AXI_bvalid,
    M04_AXI_rdata,
    M04_AXI_rready,
    M04_AXI_rresp,
    M04_AXI_rvalid,
    M04_AXI_wdata,
    M04_AXI_wready,
    M04_AXI_wstrb,
    M04_AXI_wvalid,
    M05_AXI_araddr,
    M05_AXI_arprot,
    M05_AXI_arready,
    M05_AXI_arvalid,
    M05_AXI_awaddr,
    M05_AXI_awprot,
    M05_AXI_awready,
    M05_AXI_awvalid,
    M05_AXI_bready,
    M05_AXI_bresp,
    M05_AXI_bvalid,
    M05_AXI_rdata,
    M05_AXI_rready,
    M05_AXI_rresp,
    M05_AXI_rvalid,
    M05_AXI_wdata,
    M05_AXI_wready,
    M05_AXI_wstrb,
    M05_AXI_wvalid,
    M06_AXI_araddr,
    M06_AXI_arprot,
    M06_AXI_arready,
    M06_AXI_arvalid,
    M06_AXI_awaddr,
    M06_AXI_awprot,
    M06_AXI_awready,
    M06_AXI_awvalid,
    M06_AXI_bready,
    M06_AXI_bresp,
    M06_AXI_bvalid,
    M06_AXI_rdata,
    M06_AXI_rready,
    M06_AXI_rresp,
    M06_AXI_rvalid,
    M06_AXI_wdata,
    M06_AXI_wready,
    M06_AXI_wstrb,
    M06_AXI_wvalid,
    S00_AXI_araddr,
    S00_AXI_arprot,
    S00_AXI_arready,
    S00_AXI_arvalid,
    S00_AXI_awaddr,
    S00_AXI_awprot,
    S00_AXI_awready,
    S00_AXI_awvalid,
    S00_AXI_bready,
    S00_AXI_bresp,
    S00_AXI_bvalid,
    S00_AXI_rdata,
    S00_AXI_rready,
    S00_AXI_rresp,
    S00_AXI_rvalid,
    S00_AXI_wdata,
    S00_AXI_wready,
    S00_AXI_wstrb,
    S00_AXI_wvalid,
    aclk,
    aresetn);
  (* X_INTERFACE_INFO = "xilinx.com:interface:aximm:1.0 M00_AXI ARADDR" *) (* X_INTERFACE_MODE = "Master" *) (* X_INTERFACE_PARAMETER = "XIL_INTERFACENAME M00_AXI, ADDR_WIDTH 9, ARUSER_WIDTH 0, AWUSER_WIDTH 0, BUSER_WIDTH 0, CLK_DOMAIN /clk_wiz_1_clk_out1, DATA_WIDTH 32, FREQ_HZ 100000000, HAS_BRESP 1, HAS_BURST 0, HAS_CACHE 0, HAS_LOCK 0, HAS_PROT 1, HAS_QOS 0, HAS_REGION 0, HAS_RRESP 1, HAS_WSTRB 1, ID_WIDTH 0, INSERT_VIP 0, MAX_BURST_LENGTH 1, NUM_READ_OUTSTANDING 1, NUM_READ_THREADS 1, NUM_WRITE_OUTSTANDING 1, NUM_WRITE_THREADS 1, PHASE 0.0, PROTOCOL AXI4LITE, READ_WRITE_MODE READ_WRITE, RUSER_BITS_PER_BYTE 0, RUSER_WIDTH 0, SUPPORTS_NARROW_BURST 0, WUSER_BITS_PER_BYTE 0, WUSER_WIDTH 0" *) output [8:0]M00_AXI_araddr;
  (* X_INTERFACE_INFO = "xilinx.com:interface:aximm:1.0 M00_AXI ARPROT" *) output [2:0]M00_AXI_arprot;
  (* X_INTERFACE_INFO = "xilinx.com:interface:aximm:1.0 M00_AXI ARREADY" *) input M00_AXI_arready;
  (* X_INTERFACE_INFO = "xilinx.com:interface:aximm:1.0 M00_AXI ARVALID" *) output M00_AXI_arvalid;
  (* X_INTERFACE_INFO = "xilinx.com:interface:aximm:1.0 M00_AXI AWADDR" *) output [8:0]M00_AXI_awaddr;
  (* X_INTERFACE_INFO = "xilinx.com:interface:aximm:1.0 M00_AXI AWPROT" *) output [2:0]M00_AXI_awprot;
  (* X_INTERFACE_INFO = "xilinx.com:interface:aximm:1.0 M00_AXI AWREADY" *) input M00_AXI_awready;
  (* X_INTERFACE_INFO = "xilinx.com:interface:aximm:1.0 M00_AXI AWVALID" *) output M00_AXI_awvalid;
  (* X_INTERFACE_INFO = "xilinx.com:interface:aximm:1.0 M00_AXI BREADY" *) output M00_AXI_bready;
  (* X_INTERFACE_INFO = "xilinx.com:interface:aximm:1.0 M00_AXI BRESP" *) input [1:0]M00_AXI_bresp;
  (* X_INTERFACE_INFO = "xilinx.com:interface:aximm:1.0 M00_AXI BVALID" *) input M00_AXI_bvalid;
  (* X_INTERFACE_INFO = "xilinx.com:interface:aximm:1.0 M00_AXI RDATA" *) input [31:0]M00_AXI_rdata;
  (* X_INTERFACE_INFO = "xilinx.com:interface:aximm:1.0 M00_AXI RREADY" *) output M00_AXI_rready;
  (* X_INTERFACE_INFO = "xilinx.com:interface:aximm:1.0 M00_AXI RRESP" *) input [1:0]M00_AXI_rresp;
  (* X_INTERFACE_INFO = "xilinx.com:interface:aximm:1.0 M00_AXI RVALID" *) input M00_AXI_rvalid;
  (* X_INTERFACE_INFO = "xilinx.com:interface:aximm:1.0 M00_AXI WDATA" *) output [31:0]M00_AXI_wdata;
  (* X_INTERFACE_INFO = "xilinx.com:interface:aximm:1.0 M00_AXI WREADY" *) input M00_AXI_wready;
  (* X_INTERFACE_INFO = "xilinx.com:interface:aximm:1.0 M00_AXI WSTRB" *) output [3:0]M00_AXI_wstrb;
  (* X_INTERFACE_INFO = "xilinx.com:interface:aximm:1.0 M00_AXI WVALID" *) output M00_AXI_wvalid;
  (* X_INTERFACE_INFO = "xilinx.com:interface:aximm:1.0 M01_AXI ARADDR" *) (* X_INTERFACE_MODE = "Master" *) (* X_INTERFACE_PARAMETER = "XIL_INTERFACENAME M01_AXI, ADDR_WIDTH 18, ARUSER_WIDTH 0, AWUSER_WIDTH 0, BUSER_WIDTH 0, CLK_DOMAIN /clk_wiz_1_clk_out1, DATA_WIDTH 32, FREQ_HZ 100000000, HAS_BRESP 1, HAS_BURST 0, HAS_CACHE 0, HAS_LOCK 0, HAS_PROT 1, HAS_QOS 0, HAS_REGION 0, HAS_RRESP 1, HAS_WSTRB 1, ID_WIDTH 0, INSERT_VIP 0, MAX_BURST_LENGTH 1, NUM_READ_OUTSTANDING 1, NUM_READ_THREADS 1, NUM_WRITE_OUTSTANDING 1, NUM_WRITE_THREADS 1, PHASE 0.0, PROTOCOL AXI4LITE, READ_WRITE_MODE READ_WRITE, RUSER_BITS_PER_BYTE 0, RUSER_WIDTH 0, SUPPORTS_NARROW_BURST 0, WUSER_BITS_PER_BYTE 0, WUSER_WIDTH 0" *) output [17:0]M01_AXI_araddr;
  (* X_INTERFACE_INFO = "xilinx.com:interface:aximm:1.0 M01_AXI ARPROT" *) output [2:0]M01_AXI_arprot;
  (* X_INTERFACE_INFO = "xilinx.com:interface:aximm:1.0 M01_AXI ARREADY" *) input M01_AXI_arready;
  (* X_INTERFACE_INFO = "xilinx.com:interface:aximm:1.0 M01_AXI ARVALID" *) output M01_AXI_arvalid;
  (* X_INTERFACE_INFO = "xilinx.com:interface:aximm:1.0 M01_AXI AWADDR" *) output [17:0]M01_AXI_awaddr;
  (* X_INTERFACE_INFO = "xilinx.com:interface:aximm:1.0 M01_AXI AWPROT" *) output [2:0]M01_AXI_awprot;
  (* X_INTERFACE_INFO = "xilinx.com:interface:aximm:1.0 M01_AXI AWREADY" *) input M01_AXI_awready;
  (* X_INTERFACE_INFO = "xilinx.com:interface:aximm:1.0 M01_AXI AWVALID" *) output M01_AXI_awvalid;
  (* X_INTERFACE_INFO = "xilinx.com:interface:aximm:1.0 M01_AXI BREADY" *) output M01_AXI_bready;
  (* X_INTERFACE_INFO = "xilinx.com:interface:aximm:1.0 M01_AXI BRESP" *) input [1:0]M01_AXI_bresp;
  (* X_INTERFACE_INFO = "xilinx.com:interface:aximm:1.0 M01_AXI BVALID" *) input M01_AXI_bvalid;
  (* X_INTERFACE_INFO = "xilinx.com:interface:aximm:1.0 M01_AXI RDATA" *) input [31:0]M01_AXI_rdata;
  (* X_INTERFACE_INFO = "xilinx.com:interface:aximm:1.0 M01_AXI RREADY" *) output M01_AXI_rready;
  (* X_INTERFACE_INFO = "xilinx.com:interface:aximm:1.0 M01_AXI RRESP" *) input [1:0]M01_AXI_rresp;
  (* X_INTERFACE_INFO = "xilinx.com:interface:aximm:1.0 M01_AXI RVALID" *) input M01_AXI_rvalid;
  (* X_INTERFACE_INFO = "xilinx.com:interface:aximm:1.0 M01_AXI WDATA" *) output [31:0]M01_AXI_wdata;
  (* X_INTERFACE_INFO = "xilinx.com:interface:aximm:1.0 M01_AXI WREADY" *) input M01_AXI_wready;
  (* X_INTERFACE_INFO = "xilinx.com:interface:aximm:1.0 M01_AXI WSTRB" *) output [3:0]M01_AXI_wstrb;
  (* X_INTERFACE_INFO = "xilinx.com:interface:aximm:1.0 M01_AXI WVALID" *) output M01_AXI_wvalid;
  (* X_INTERFACE_INFO = "xilinx.com:interface:aximm:1.0 M02_AXI ARADDR" *) (* X_INTERFACE_MODE = "Master" *) (* X_INTERFACE_PARAMETER = "XIL_INTERFACENAME M02_AXI, ADDR_WIDTH 10, ARUSER_WIDTH 0, AWUSER_WIDTH 0, BUSER_WIDTH 0, CLK_DOMAIN /clk_wiz_1_clk_out1, DATA_WIDTH 32, FREQ_HZ 100000000, HAS_BRESP 1, HAS_BURST 0, HAS_CACHE 0, HAS_LOCK 0, HAS_PROT 1, HAS_QOS 0, HAS_REGION 0, HAS_RRESP 1, HAS_WSTRB 1, ID_WIDTH 0, INSERT_VIP 0, MAX_BURST_LENGTH 1, NUM_READ_OUTSTANDING 1, NUM_READ_THREADS 1, NUM_WRITE_OUTSTANDING 1, NUM_WRITE_THREADS 1, PHASE 0.0, PROTOCOL AXI4LITE, READ_WRITE_MODE READ_WRITE, RUSER_BITS_PER_BYTE 0, RUSER_WIDTH 0, SUPPORTS_NARROW_BURST 0, WUSER_BITS_PER_BYTE 0, WUSER_WIDTH 0" *) output [9:0]M02_AXI_araddr;
  (* X_INTERFACE_INFO = "xilinx.com:interface:aximm:1.0 M02_AXI ARPROT" *) output [2:0]M02_AXI_arprot;
  (* X_INTERFACE_INFO = "xilinx.com:interface:aximm:1.0 M02_AXI ARREADY" *) input M02_AXI_arready;
  (* X_INTERFACE_INFO = "xilinx.com:interface:aximm:1.0 M02_AXI ARVALID" *) output M02_AXI_arvalid;
  (* X_INTERFACE_INFO = "xilinx.com:interface:aximm:1.0 M02_AXI AWADDR" *) output [9:0]M02_AXI_awaddr;
  (* X_INTERFACE_INFO = "xilinx.com:interface:aximm:1.0 M02_AXI AWPROT" *) output [2:0]M02_AXI_awprot;
  (* X_INTERFACE_INFO = "xilinx.com:interface:aximm:1.0 M02_AXI AWREADY" *) input M02_AXI_awready;
  (* X_INTERFACE_INFO = "xilinx.com:interface:aximm:1.0 M02_AXI AWVALID" *) output M02_AXI_awvalid;
  (* X_INTERFACE_INFO = "xilinx.com:interface:aximm:1.0 M02_AXI BREADY" *) output M02_AXI_bready;
  (* X_INTERFACE_INFO = "xilinx.com:interface:aximm:1.0 M02_AXI BRESP" *) input [1:0]M02_AXI_bresp;
  (* X_INTERFACE_INFO = "xilinx.com:interface:aximm:1.0 M02_AXI BVALID" *) input M02_AXI_bvalid;
  (* X_INTERFACE_INFO = "xilinx.com:interface:aximm:1.0 M02_AXI RDATA" *) input [31:0]M02_AXI_rdata;
  (* X_INTERFACE_INFO = "xilinx.com:interface:aximm:1.0 M02_AXI RREADY" *) output M02_AXI_rready;
  (* X_INTERFACE_INFO = "xilinx.com:interface:aximm:1.0 M02_AXI RRESP" *) input [1:0]M02_AXI_rresp;
  (* X_INTERFACE_INFO = "xilinx.com:interface:aximm:1.0 M02_AXI RVALID" *) input M02_AXI_rvalid;
  (* X_INTERFACE_INFO = "xilinx.com:interface:aximm:1.0 M02_AXI WDATA" *) output [31:0]M02_AXI_wdata;
  (* X_INTERFACE_INFO = "xilinx.com:interface:aximm:1.0 M02_AXI WREADY" *) input M02_AXI_wready;
  (* X_INTERFACE_INFO = "xilinx.com:interface:aximm:1.0 M02_AXI WSTRB" *) output [3:0]M02_AXI_wstrb;
  (* X_INTERFACE_INFO = "xilinx.com:interface:aximm:1.0 M02_AXI WVALID" *) output M02_AXI_wvalid;
  (* X_INTERFACE_INFO = "xilinx.com:interface:aximm:1.0 M03_AXI ARADDR" *) (* X_INTERFACE_MODE = "Master" *) (* X_INTERFACE_PARAMETER = "XIL_INTERFACENAME M03_AXI, ADDR_WIDTH 5, ARUSER_WIDTH 0, AWUSER_WIDTH 0, BUSER_WIDTH 0, CLK_DOMAIN /clk_wiz_1_clk_out1, DATA_WIDTH 32, FREQ_HZ 100000000, HAS_BRESP 1, HAS_BURST 0, HAS_CACHE 0, HAS_LOCK 0, HAS_PROT 1, HAS_QOS 0, HAS_REGION 0, HAS_RRESP 1, HAS_WSTRB 1, ID_WIDTH 0, INSERT_VIP 0, MAX_BURST_LENGTH 1, NUM_READ_OUTSTANDING 1, NUM_READ_THREADS 1, NUM_WRITE_OUTSTANDING 1, NUM_WRITE_THREADS 1, PHASE 0.0, PROTOCOL AXI4LITE, READ_WRITE_MODE READ_WRITE, RUSER_BITS_PER_BYTE 0, RUSER_WIDTH 0, SUPPORTS_NARROW_BURST 0, WUSER_BITS_PER_BYTE 0, WUSER_WIDTH 0" *) output [4:0]M03_AXI_araddr;
  (* X_INTERFACE_INFO = "xilinx.com:interface:aximm:1.0 M03_AXI ARPROT" *) output [2:0]M03_AXI_arprot;
  (* X_INTERFACE_INFO = "xilinx.com:interface:aximm:1.0 M03_AXI ARREADY" *) input M03_AXI_arready;
  (* X_INTERFACE_INFO = "xilinx.com:interface:aximm:1.0 M03_AXI ARVALID" *) output M03_AXI_arvalid;
  (* X_INTERFACE_INFO = "xilinx.com:interface:aximm:1.0 M03_AXI AWADDR" *) output [4:0]M03_AXI_awaddr;
  (* X_INTERFACE_INFO = "xilinx.com:interface:aximm:1.0 M03_AXI AWPROT" *) output [2:0]M03_AXI_awprot;
  (* X_INTERFACE_INFO = "xilinx.com:interface:aximm:1.0 M03_AXI AWREADY" *) input M03_AXI_awready;
  (* X_INTERFACE_INFO = "xilinx.com:interface:aximm:1.0 M03_AXI AWVALID" *) output M03_AXI_awvalid;
  (* X_INTERFACE_INFO = "xilinx.com:interface:aximm:1.0 M03_AXI BREADY" *) output M03_AXI_bready;
  (* X_INTERFACE_INFO = "xilinx.com:interface:aximm:1.0 M03_AXI BRESP" *) input [1:0]M03_AXI_bresp;
  (* X_INTERFACE_INFO = "xilinx.com:interface:aximm:1.0 M03_AXI BVALID" *) input M03_AXI_bvalid;
  (* X_INTERFACE_INFO = "xilinx.com:interface:aximm:1.0 M03_AXI RDATA" *) input [31:0]M03_AXI_rdata;
  (* X_INTERFACE_INFO = "xilinx.com:interface:aximm:1.0 M03_AXI RREADY" *) output M03_AXI_rready;
  (* X_INTERFACE_INFO = "xilinx.com:interface:aximm:1.0 M03_AXI RRESP" *) input [1:0]M03_AXI_rresp;
  (* X_INTERFACE_INFO = "xilinx.com:interface:aximm:1.0 M03_AXI RVALID" *) input M03_AXI_rvalid;
  (* X_INTERFACE_INFO = "xilinx.com:interface:aximm:1.0 M03_AXI WDATA" *) output [31:0]M03_AXI_wdata;
  (* X_INTERFACE_INFO = "xilinx.com:interface:aximm:1.0 M03_AXI WREADY" *) input M03_AXI_wready;
  (* X_INTERFACE_INFO = "xilinx.com:interface:aximm:1.0 M03_AXI WSTRB" *) output [3:0]M03_AXI_wstrb;
  (* X_INTERFACE_INFO = "xilinx.com:interface:aximm:1.0 M03_AXI WVALID" *) output M03_AXI_wvalid;
  (* X_INTERFACE_INFO = "xilinx.com:interface:aximm:1.0 M04_AXI ARADDR" *) (* X_INTERFACE_MODE = "Master" *) (* X_INTERFACE_PARAMETER = "XIL_INTERFACENAME M04_AXI, ADDR_WIDTH 4, ARUSER_WIDTH 0, AWUSER_WIDTH 0, BUSER_WIDTH 0, CLK_DOMAIN /clk_wiz_1_clk_out1, DATA_WIDTH 32, FREQ_HZ 100000000, HAS_BRESP 1, HAS_BURST 0, HAS_CACHE 0, HAS_LOCK 0, HAS_PROT 1, HAS_QOS 0, HAS_REGION 0, HAS_RRESP 1, HAS_WSTRB 1, ID_WIDTH 0, INSERT_VIP 0, MAX_BURST_LENGTH 1, NUM_READ_OUTSTANDING 1, NUM_READ_THREADS 1, NUM_WRITE_OUTSTANDING 1, NUM_WRITE_THREADS 1, PHASE 0.0, PROTOCOL AXI4LITE, READ_WRITE_MODE READ_WRITE, RUSER_BITS_PER_BYTE 0, RUSER_WIDTH 0, SUPPORTS_NARROW_BURST 0, WUSER_BITS_PER_BYTE 0, WUSER_WIDTH 0" *) output [3:0]M04_AXI_araddr;
  (* X_INTERFACE_INFO = "xilinx.com:interface:aximm:1.0 M04_AXI ARPROT" *) output [2:0]M04_AXI_arprot;
  (* X_INTERFACE_INFO = "xilinx.com:interface:aximm:1.0 M04_AXI ARREADY" *) input M04_AXI_arready;
  (* X_INTERFACE_INFO = "xilinx.com:interface:aximm:1.0 M04_AXI ARVALID" *) output M04_AXI_arvalid;
  (* X_INTERFACE_INFO = "xilinx.com:interface:aximm:1.0 M04_AXI AWADDR" *) output [3:0]M04_AXI_awaddr;
  (* X_INTERFACE_INFO = "xilinx.com:interface:aximm:1.0 M04_AXI AWPROT" *) output [2:0]M04_AXI_awprot;
  (* X_INTERFACE_INFO = "xilinx.com:interface:aximm:1.0 M04_AXI AWREADY" *) input M04_AXI_awready;
  (* X_INTERFACE_INFO = "xilinx.com:interface:aximm:1.0 M04_AXI AWVALID" *) output M04_AXI_awvalid;
  (* X_INTERFACE_INFO = "xilinx.com:interface:aximm:1.0 M04_AXI BREADY" *) output M04_AXI_bready;
  (* X_INTERFACE_INFO = "xilinx.com:interface:aximm:1.0 M04_AXI BRESP" *) input [1:0]M04_AXI_bresp;
  (* X_INTERFACE_INFO = "xilinx.com:interface:aximm:1.0 M04_AXI BVALID" *) input M04_AXI_bvalid;
  (* X_INTERFACE_INFO = "xilinx.com:interface:aximm:1.0 M04_AXI RDATA" *) input [31:0]M04_AXI_rdata;
  (* X_INTERFACE_INFO = "xilinx.com:interface:aximm:1.0 M04_AXI RREADY" *) output M04_AXI_rready;
  (* X_INTERFACE_INFO = "xilinx.com:interface:aximm:1.0 M04_AXI RRESP" *) input [1:0]M04_AXI_rresp;
  (* X_INTERFACE_INFO = "xilinx.com:interface:aximm:1.0 M04_AXI RVALID" *) input M04_AXI_rvalid;
  (* X_INTERFACE_INFO = "xilinx.com:interface:aximm:1.0 M04_AXI WDATA" *) output [31:0]M04_AXI_wdata;
  (* X_INTERFACE_INFO = "xilinx.com:interface:aximm:1.0 M04_AXI WREADY" *) input M04_AXI_wready;
  (* X_INTERFACE_INFO = "xilinx.com:interface:aximm:1.0 M04_AXI WSTRB" *) output [3:0]M04_AXI_wstrb;
  (* X_INTERFACE_INFO = "xilinx.com:interface:aximm:1.0 M04_AXI WVALID" *) output M04_AXI_wvalid;
  (* X_INTERFACE_INFO = "xilinx.com:interface:aximm:1.0 M05_AXI ARADDR" *) (* X_INTERFACE_MODE = "Master" *) (* X_INTERFACE_PARAMETER = "XIL_INTERFACENAME M05_AXI, ADDR_WIDTH 4, ARUSER_WIDTH 0, AWUSER_WIDTH 0, BUSER_WIDTH 0, CLK_DOMAIN /clk_wiz_1_clk_out1, DATA_WIDTH 32, FREQ_HZ 100000000, HAS_BRESP 1, HAS_BURST 0, HAS_CACHE 0, HAS_LOCK 0, HAS_PROT 1, HAS_QOS 0, HAS_REGION 0, HAS_RRESP 1, HAS_WSTRB 1, ID_WIDTH 0, INSERT_VIP 0, MAX_BURST_LENGTH 1, NUM_READ_OUTSTANDING 1, NUM_READ_THREADS 1, NUM_WRITE_OUTSTANDING 1, NUM_WRITE_THREADS 1, PHASE 0.0, PROTOCOL AXI4LITE, READ_WRITE_MODE READ_WRITE, RUSER_BITS_PER_BYTE 0, RUSER_WIDTH 0, SUPPORTS_NARROW_BURST 0, WUSER_BITS_PER_BYTE 0, WUSER_WIDTH 0" *) output [3:0]M05_AXI_araddr;
  (* X_INTERFACE_INFO = "xilinx.com:interface:aximm:1.0 M05_AXI ARPROT" *) output [2:0]M05_AXI_arprot;
  (* X_INTERFACE_INFO = "xilinx.com:interface:aximm:1.0 M05_AXI ARREADY" *) input M05_AXI_arready;
  (* X_INTERFACE_INFO = "xilinx.com:interface:aximm:1.0 M05_AXI ARVALID" *) output M05_AXI_arvalid;
  (* X_INTERFACE_INFO = "xilinx.com:interface:aximm:1.0 M05_AXI AWADDR" *) output [3:0]M05_AXI_awaddr;
  (* X_INTERFACE_INFO = "xilinx.com:interface:aximm:1.0 M05_AXI AWPROT" *) output [2:0]M05_AXI_awprot;
  (* X_INTERFACE_INFO = "xilinx.com:interface:aximm:1.0 M05_AXI AWREADY" *) input M05_AXI_awready;
  (* X_INTERFACE_INFO = "xilinx.com:interface:aximm:1.0 M05_AXI AWVALID" *) output M05_AXI_awvalid;
  (* X_INTERFACE_INFO = "xilinx.com:interface:aximm:1.0 M05_AXI BREADY" *) output M05_AXI_bready;
  (* X_INTERFACE_INFO = "xilinx.com:interface:aximm:1.0 M05_AXI BRESP" *) input [1:0]M05_AXI_bresp;
  (* X_INTERFACE_INFO = "xilinx.com:interface:aximm:1.0 M05_AXI BVALID" *) input M05_AXI_bvalid;
  (* X_INTERFACE_INFO = "xilinx.com:interface:aximm:1.0 M05_AXI RDATA" *) input [31:0]M05_AXI_rdata;
  (* X_INTERFACE_INFO = "xilinx.com:interface:aximm:1.0 M05_AXI RREADY" *) output M05_AXI_rready;
  (* X_INTERFACE_INFO = "xilinx.com:interface:aximm:1.0 M05_AXI RRESP" *) input [1:0]M05_AXI_rresp;
  (* X_INTERFACE_INFO = "xilinx.com:interface:aximm:1.0 M05_AXI RVALID" *) input M05_AXI_rvalid;
  (* X_INTERFACE_INFO = "xilinx.com:interface:aximm:1.0 M05_AXI WDATA" *) output [31:0]M05_AXI_wdata;
  (* X_INTERFACE_INFO = "xilinx.com:interface:aximm:1.0 M05_AXI WREADY" *) input M05_AXI_wready;
  (* X_INTERFACE_INFO = "xilinx.com:interface:aximm:1.0 M05_AXI WSTRB" *) output [3:0]M05_AXI_wstrb;
  (* X_INTERFACE_INFO = "xilinx.com:interface:aximm:1.0 M05_AXI WVALID" *) output M05_AXI_wvalid;
  (* X_INTERFACE_INFO = "xilinx.com:interface:aximm:1.0 M06_AXI ARADDR" *) (* X_INTERFACE_MODE = "Master" *) (* X_INTERFACE_PARAMETER = "XIL_INTERFACENAME M06_AXI, ADDR_WIDTH 10, ARUSER_WIDTH 0, AWUSER_WIDTH 0, BUSER_WIDTH 0, CLK_DOMAIN /clk_wiz_1_clk_out1, DATA_WIDTH 32, FREQ_HZ 100000000, HAS_BRESP 1, HAS_BURST 0, HAS_CACHE 0, HAS_LOCK 0, HAS_PROT 1, HAS_QOS 0, HAS_REGION 0, HAS_RRESP 1, HAS_WSTRB 1, ID_WIDTH 0, INSERT_VIP 0, MAX_BURST_LENGTH 1, NUM_READ_OUTSTANDING 1, NUM_READ_THREADS 1, NUM_WRITE_OUTSTANDING 1, NUM_WRITE_THREADS 1, PHASE 0.0, PROTOCOL AXI4LITE, READ_WRITE_MODE READ_WRITE, RUSER_BITS_PER_BYTE 0, RUSER_WIDTH 0, SUPPORTS_NARROW_BURST 0, WUSER_BITS_PER_BYTE 0, WUSER_WIDTH 0" *) output [9:0]M06_AXI_araddr;
  (* X_INTERFACE_INFO = "xilinx.com:interface:aximm:1.0 M06_AXI ARPROT" *) output [2:0]M06_AXI_arprot;
  (* X_INTERFACE_INFO = "xilinx.com:interface:aximm:1.0 M06_AXI ARREADY" *) input M06_AXI_arready;
  (* X_INTERFACE_INFO = "xilinx.com:interface:aximm:1.0 M06_AXI ARVALID" *) output M06_AXI_arvalid;
  (* X_INTERFACE_INFO = "xilinx.com:interface:aximm:1.0 M06_AXI AWADDR" *) output [9:0]M06_AXI_awaddr;
  (* X_INTERFACE_INFO = "xilinx.com:interface:aximm:1.0 M06_AXI AWPROT" *) output [2:0]M06_AXI_awprot;
  (* X_INTERFACE_INFO = "xilinx.com:interface:aximm:1.0 M06_AXI AWREADY" *) input M06_AXI_awready;
  (* X_INTERFACE_INFO = "xilinx.com:interface:aximm:1.0 M06_AXI AWVALID" *) output M06_AXI_awvalid;
  (* X_INTERFACE_INFO = "xilinx.com:interface:aximm:1.0 M06_AXI BREADY" *) output M06_AXI_bready;
  (* X_INTERFACE_INFO = "xilinx.com:interface:aximm:1.0 M06_AXI BRESP" *) input [1:0]M06_AXI_bresp;
  (* X_INTERFACE_INFO = "xilinx.com:interface:aximm:1.0 M06_AXI BVALID" *) input M06_AXI_bvalid;
  (* X_INTERFACE_INFO = "xilinx.com:interface:aximm:1.0 M06_AXI RDATA" *) input [31:0]M06_AXI_rdata;
  (* X_INTERFACE_INFO = "xilinx.com:interface:aximm:1.0 M06_AXI RREADY" *) output M06_AXI_rready;
  (* X_INTERFACE_INFO = "xilinx.com:interface:aximm:1.0 M06_AXI RRESP" *) input [1:0]M06_AXI_rresp;
  (* X_INTERFACE_INFO = "xilinx.com:interface:aximm:1.0 M06_AXI RVALID" *) input M06_AXI_rvalid;
  (* X_INTERFACE_INFO = "xilinx.com:interface:aximm:1.0 M06_AXI WDATA" *) output [31:0]M06_AXI_wdata;
  (* X_INTERFACE_INFO = "xilinx.com:interface:aximm:1.0 M06_AXI WREADY" *) input M06_AXI_wready;
  (* X_INTERFACE_INFO = "xilinx.com:interface:aximm:1.0 M06_AXI WSTRB" *) output [3:0]M06_AXI_wstrb;
  (* X_INTERFACE_INFO = "xilinx.com:interface:aximm:1.0 M06_AXI WVALID" *) output M06_AXI_wvalid;
  (* X_INTERFACE_INFO = "xilinx.com:interface:aximm:1.0 S00_AXI ARADDR" *) (* X_INTERFACE_MODE = "Slave" *) (* X_INTERFACE_PARAMETER = "XIL_INTERFACENAME S00_AXI, ADDR_WIDTH 32, ARUSER_WIDTH 0, AWUSER_WIDTH 0, BUSER_WIDTH 0, CLK_DOMAIN /clk_wiz_1_clk_out1, DATA_WIDTH 32, FREQ_HZ 100000000, HAS_BRESP 1, HAS_BURST 0, HAS_CACHE 0, HAS_LOCK 0, HAS_PROT 1, HAS_QOS 0, HAS_REGION 0, HAS_RRESP 1, HAS_WSTRB 1, ID_WIDTH 0, INSERT_VIP 0, MAX_BURST_LENGTH 1, NUM_READ_OUTSTANDING 1, NUM_READ_THREADS 1, NUM_WRITE_OUTSTANDING 1, NUM_WRITE_THREADS 1, PHASE 0.0, PROTOCOL AXI4LITE, READ_WRITE_MODE READ_WRITE, RUSER_BITS_PER_BYTE 0, RUSER_WIDTH 0, SUPPORTS_NARROW_BURST 0, WUSER_BITS_PER_BYTE 0, WUSER_WIDTH 0" *) input [31:0]S00_AXI_araddr;
  (* X_INTERFACE_INFO = "xilinx.com:interface:aximm:1.0 S00_AXI ARPROT" *) input [2:0]S00_AXI_arprot;
  (* X_INTERFACE_INFO = "xilinx.com:interface:aximm:1.0 S00_AXI ARREADY" *) output S00_AXI_arready;
  (* X_INTERFACE_INFO = "xilinx.com:interface:aximm:1.0 S00_AXI ARVALID" *) input S00_AXI_arvalid;
  (* X_INTERFACE_INFO = "xilinx.com:interface:aximm:1.0 S00_AXI AWADDR" *) input [31:0]S00_AXI_awaddr;
  (* X_INTERFACE_INFO = "xilinx.com:interface:aximm:1.0 S00_AXI AWPROT" *) input [2:0]S00_AXI_awprot;
  (* X_INTERFACE_INFO = "xilinx.com:interface:aximm:1.0 S00_AXI AWREADY" *) output S00_AXI_awready;
  (* X_INTERFACE_INFO = "xilinx.com:interface:aximm:1.0 S00_AXI AWVALID" *) input S00_AXI_awvalid;
  (* X_INTERFACE_INFO = "xilinx.com:interface:aximm:1.0 S00_AXI BREADY" *) input S00_AXI_bready;
  (* X_INTERFACE_INFO = "xilinx.com:interface:aximm:1.0 S00_AXI BRESP" *) output [1:0]S00_AXI_bresp;
  (* X_INTERFACE_INFO = "xilinx.com:interface:aximm:1.0 S00_AXI BVALID" *) output S00_AXI_bvalid;
  (* X_INTERFACE_INFO = "xilinx.com:interface:aximm:1.0 S00_AXI RDATA" *) output [31:0]S00_AXI_rdata;
  (* X_INTERFACE_INFO = "xilinx.com:interface:aximm:1.0 S00_AXI RREADY" *) input S00_AXI_rready;
  (* X_INTERFACE_INFO = "xilinx.com:interface:aximm:1.0 S00_AXI RRESP" *) output [1:0]S00_AXI_rresp;
  (* X_INTERFACE_INFO = "xilinx.com:interface:aximm:1.0 S00_AXI RVALID" *) output S00_AXI_rvalid;
  (* X_INTERFACE_INFO = "xilinx.com:interface:aximm:1.0 S00_AXI WDATA" *) input [31:0]S00_AXI_wdata;
  (* X_INTERFACE_INFO = "xilinx.com:interface:aximm:1.0 S00_AXI WREADY" *) output S00_AXI_wready;
  (* X_INTERFACE_INFO = "xilinx.com:interface:aximm:1.0 S00_AXI WSTRB" *) input [3:0]S00_AXI_wstrb;
  (* X_INTERFACE_INFO = "xilinx.com:interface:aximm:1.0 S00_AXI WVALID" *) input S00_AXI_wvalid;
  (* X_INTERFACE_INFO = "xilinx.com:signal:clock:1.0 CLK.ACLK CLK" *) (* X_INTERFACE_PARAMETER = "XIL_INTERFACENAME CLK.ACLK, ASSOCIATED_BUSIF M00_AXI:M01_AXI:M02_AXI:M03_AXI:M04_AXI:M05_AXI:M06_AXI:S00_AXI, ASSOCIATED_CLKEN s_sc_aclken, CLK_DOMAIN /clk_wiz_1_clk_out1, FREQ_HZ 100000000, FREQ_TOLERANCE_HZ 0, INSERT_VIP 0, PHASE 0.0" *) input aclk;
  (* X_INTERFACE_INFO = "xilinx.com:signal:reset:1.0 RST.ARESETN RST" *) (* X_INTERFACE_PARAMETER = "XIL_INTERFACENAME RST.ARESETN, INSERT_VIP 0, POLARITY ACTIVE_LOW" *) input aresetn;

  wire [8:0]M00_AXI_araddr;
  wire [2:0]M00_AXI_arprot;
  wire M00_AXI_arready;
  wire M00_AXI_arvalid;
  wire [8:0]M00_AXI_awaddr;
  wire [2:0]M00_AXI_awprot;
  wire M00_AXI_awready;
  wire M00_AXI_awvalid;
  wire M00_AXI_bready;
  wire [1:0]M00_AXI_bresp;
  wire M00_AXI_bvalid;
  wire [31:0]M00_AXI_rdata;
  wire M00_AXI_rready;
  wire [1:0]M00_AXI_rresp;
  wire M00_AXI_rvalid;
  wire [31:0]M00_AXI_wdata;
  wire M00_AXI_wready;
  wire [3:0]M00_AXI_wstrb;
  wire M00_AXI_wvalid;
  wire [17:0]M01_AXI_araddr;
  wire [2:0]M01_AXI_arprot;
  wire M01_AXI_arready;
  wire M01_AXI_arvalid;
  wire [17:0]M01_AXI_awaddr;
  wire [2:0]M01_AXI_awprot;
  wire M01_AXI_awready;
  wire M01_AXI_awvalid;
  wire M01_AXI_bready;
  wire [1:0]M01_AXI_bresp;
  wire M01_AXI_bvalid;
  wire [31:0]M01_AXI_rdata;
  wire M01_AXI_rready;
  wire [1:0]M01_AXI_rresp;
  wire M01_AXI_rvalid;
  wire [31:0]M01_AXI_wdata;
  wire M01_AXI_wready;
  wire [3:0]M01_AXI_wstrb;
  wire M01_AXI_wvalid;
  wire [9:0]M02_AXI_araddr;
  wire [2:0]M02_AXI_arprot;
  wire M02_AXI_arready;
  wire M02_AXI_arvalid;
  wire [9:0]M02_AXI_awaddr;
  wire [2:0]M02_AXI_awprot;
  wire M02_AXI_awready;
  wire M02_AXI_awvalid;
  wire M02_AXI_bready;
  wire [1:0]M02_AXI_bresp;
  wire M02_AXI_bvalid;
  wire [31:0]M02_AXI_rdata;
  wire M02_AXI_rready;
  wire [1:0]M02_AXI_rresp;
  wire M02_AXI_rvalid;
  wire [31:0]M02_AXI_wdata;
  wire M02_AXI_wready;
  wire [3:0]M02_AXI_wstrb;
  wire M02_AXI_wvalid;
  wire [4:0]M03_AXI_araddr;
  wire [2:0]M03_AXI_arprot;
  wire M03_AXI_arready;
  wire M03_AXI_arvalid;
  wire [4:0]M03_AXI_awaddr;
  wire [2:0]M03_AXI_awprot;
  wire M03_AXI_awready;
  wire M03_AXI_awvalid;
  wire M03_AXI_bready;
  wire [1:0]M03_AXI_bresp;
  wire M03_AXI_bvalid;
  wire [31:0]M03_AXI_rdata;
  wire M03_AXI_rready;
  wire [1:0]M03_AXI_rresp;
  wire M03_AXI_rvalid;
  wire [31:0]M03_AXI_wdata;
  wire M03_AXI_wready;
  wire [3:0]M03_AXI_wstrb;
  wire M03_AXI_wvalid;
  wire [3:0]M04_AXI_araddr;
  wire [2:0]M04_AXI_arprot;
  wire M04_AXI_arready;
  wire M04_AXI_arvalid;
  wire [3:0]M04_AXI_awaddr;
  wire [2:0]M04_AXI_awprot;
  wire M04_AXI_awready;
  wire M04_AXI_awvalid;
  wire M04_AXI_bready;
  wire [1:0]M04_AXI_bresp;
  wire M04_AXI_bvalid;
  wire [31:0]M04_AXI_rdata;
  wire M04_AXI_rready;
  wire [1:0]M04_AXI_rresp;
  wire M04_AXI_rvalid;
  wire [31:0]M04_AXI_wdata;
  wire M04_AXI_wready;
  wire [3:0]M04_AXI_wstrb;
  wire M04_AXI_wvalid;
  wire [3:0]M05_AXI_araddr;
  wire [2:0]M05_AXI_arprot;
  wire M05_AXI_arready;
  wire M05_AXI_arvalid;
  wire [3:0]M05_AXI_awaddr;
  wire [2:0]M05_AXI_awprot;
  wire M05_AXI_awready;
  wire M05_AXI_awvalid;
  wire M05_AXI_bready;
  wire [1:0]M05_AXI_bresp;
  wire M05_AXI_bvalid;
  wire [31:0]M05_AXI_rdata;
  wire M05_AXI_rready;
  wire [1:0]M05_AXI_rresp;
  wire M05_AXI_rvalid;
  wire [31:0]M05_AXI_wdata;
  wire M05_AXI_wready;
  wire [3:0]M05_AXI_wstrb;
  wire M05_AXI_wvalid;
  wire [9:0]M06_AXI_araddr;
  wire [2:0]M06_AXI_arprot;
  wire M06_AXI_arready;
  wire M06_AXI_arvalid;
  wire [9:0]M06_AXI_awaddr;
  wire [2:0]M06_AXI_awprot;
  wire M06_AXI_awready;
  wire M06_AXI_awvalid;
  wire M06_AXI_bready;
  wire [1:0]M06_AXI_bresp;
  wire M06_AXI_bvalid;
  wire [31:0]M06_AXI_rdata;
  wire M06_AXI_rready;
  wire [1:0]M06_AXI_rresp;
  wire M06_AXI_rvalid;
  wire [31:0]M06_AXI_wdata;
  wire M06_AXI_wready;
  wire [3:0]M06_AXI_wstrb;
  wire M06_AXI_wvalid;
  wire [31:0]S00_AXI_araddr;
  wire [2:0]S00_AXI_arprot;
  wire S00_AXI_arready;
  wire S00_AXI_arvalid;
  wire [31:0]S00_AXI_awaddr;
  wire [2:0]S00_AXI_awprot;
  wire S00_AXI_awready;
  wire S00_AXI_awvalid;
  wire S00_AXI_bready;
  wire [1:0]S00_AXI_bresp;
  wire S00_AXI_bvalid;
  wire [31:0]S00_AXI_rdata;
  wire S00_AXI_rready;
  wire [1:0]S00_AXI_rresp;
  wire S00_AXI_rvalid;
  wire [31:0]S00_AXI_wdata;
  wire S00_AXI_wready;
  wire [3:0]S00_AXI_wstrb;
  wire S00_AXI_wvalid;
  wire [0:0]S_SC_AR_1_INFO;
  wire [145:0]S_SC_AR_1_PAYLD;
  wire [0:0]S_SC_AR_1_RECV;
  wire S_SC_AR_1_REQ;
  wire S_SC_AR_1_SEND;
  wire [0:0]S_SC_AR_2_INFO;
  wire [145:0]S_SC_AR_2_PAYLD;
  wire [0:0]S_SC_AR_2_RECV;
  wire [0:0]S_SC_AR_2_REQ;
  wire [0:0]S_SC_AR_2_SEND;
  wire [0:0]S_SC_AR_3_INFO;
  wire [145:0]S_SC_AR_3_PAYLD;
  wire [0:0]S_SC_AR_3_RECV;
  wire [0:0]S_SC_AR_3_REQ;
  wire [0:0]S_SC_AR_3_SEND;
  wire [0:0]S_SC_AR_4_INFO;
  wire [145:0]S_SC_AR_4_PAYLD;
  wire [0:0]S_SC_AR_4_RECV;
  wire [0:0]S_SC_AR_4_REQ;
  wire [0:0]S_SC_AR_4_SEND;
  wire [0:0]S_SC_AR_5_INFO;
  wire [145:0]S_SC_AR_5_PAYLD;
  wire [0:0]S_SC_AR_5_RECV;
  wire [0:0]S_SC_AR_5_REQ;
  wire [0:0]S_SC_AR_5_SEND;
  wire [0:0]S_SC_AR_6_INFO;
  wire [145:0]S_SC_AR_6_PAYLD;
  wire [0:0]S_SC_AR_6_RECV;
  wire [0:0]S_SC_AR_6_REQ;
  wire [0:0]S_SC_AR_6_SEND;
  wire [0:0]S_SC_AR_7_INFO;
  wire [145:0]S_SC_AR_7_PAYLD;
  wire [0:0]S_SC_AR_7_RECV;
  wire [0:0]S_SC_AR_7_REQ;
  wire [0:0]S_SC_AR_7_SEND;
  wire [0:0]S_SC_AR_8_INFO;
  wire [145:0]S_SC_AR_8_PAYLD;
  wire [0:0]S_SC_AR_8_RECV;
  wire [0:0]S_SC_AR_8_REQ;
  wire [0:0]S_SC_AR_8_SEND;
  wire [0:0]S_SC_AW_1_INFO;
  wire [145:0]S_SC_AW_1_PAYLD;
  wire [0:0]S_SC_AW_1_RECV;
  wire S_SC_AW_1_REQ;
  wire S_SC_AW_1_SEND;
  wire [0:0]S_SC_AW_2_INFO;
  wire [145:0]S_SC_AW_2_PAYLD;
  wire [0:0]S_SC_AW_2_RECV;
  wire [0:0]S_SC_AW_2_REQ;
  wire [0:0]S_SC_AW_2_SEND;
  wire [0:0]S_SC_AW_3_INFO;
  wire [145:0]S_SC_AW_3_PAYLD;
  wire [0:0]S_SC_AW_3_RECV;
  wire [0:0]S_SC_AW_3_REQ;
  wire [0:0]S_SC_AW_3_SEND;
  wire [0:0]S_SC_AW_4_INFO;
  wire [145:0]S_SC_AW_4_PAYLD;
  wire [0:0]S_SC_AW_4_RECV;
  wire [0:0]S_SC_AW_4_REQ;
  wire [0:0]S_SC_AW_4_SEND;
  wire [0:0]S_SC_AW_5_INFO;
  wire [145:0]S_SC_AW_5_PAYLD;
  wire [0:0]S_SC_AW_5_RECV;
  wire [0:0]S_SC_AW_5_REQ;
  wire [0:0]S_SC_AW_5_SEND;
  wire [0:0]S_SC_AW_6_INFO;
  wire [145:0]S_SC_AW_6_PAYLD;
  wire [0:0]S_SC_AW_6_RECV;
  wire [0:0]S_SC_AW_6_REQ;
  wire [0:0]S_SC_AW_6_SEND;
  wire [0:0]S_SC_AW_7_INFO;
  wire [145:0]S_SC_AW_7_PAYLD;
  wire [0:0]S_SC_AW_7_RECV;
  wire [0:0]S_SC_AW_7_REQ;
  wire [0:0]S_SC_AW_7_SEND;
  wire [0:0]S_SC_AW_8_INFO;
  wire [145:0]S_SC_AW_8_PAYLD;
  wire [0:0]S_SC_AW_8_RECV;
  wire [0:0]S_SC_AW_8_REQ;
  wire [0:0]S_SC_AW_8_SEND;
  wire [0:0]S_SC_B_1_INFO;
  wire [6:0]S_SC_B_1_PAYLD;
  wire [0:0]S_SC_B_1_RECV;
  wire [0:0]S_SC_B_1_REQ;
  wire [0:0]S_SC_B_1_SEND;
  wire [0:0]S_SC_B_2_INFO;
  wire [6:0]S_SC_B_2_PAYLD;
  wire [0:0]S_SC_B_2_RECV;
  wire S_SC_B_2_REQ;
  wire S_SC_B_2_SEND;
  wire [0:0]S_SC_B_3_INFO;
  wire [6:0]S_SC_B_3_PAYLD;
  wire [0:0]S_SC_B_3_RECV;
  wire S_SC_B_3_REQ;
  wire S_SC_B_3_SEND;
  wire [0:0]S_SC_B_4_INFO;
  wire [6:0]S_SC_B_4_PAYLD;
  wire [0:0]S_SC_B_4_RECV;
  wire S_SC_B_4_REQ;
  wire S_SC_B_4_SEND;
  wire [0:0]S_SC_B_5_INFO;
  wire [6:0]S_SC_B_5_PAYLD;
  wire [0:0]S_SC_B_5_RECV;
  wire S_SC_B_5_REQ;
  wire S_SC_B_5_SEND;
  wire [0:0]S_SC_B_6_INFO;
  wire [6:0]S_SC_B_6_PAYLD;
  wire [0:0]S_SC_B_6_RECV;
  wire S_SC_B_6_REQ;
  wire S_SC_B_6_SEND;
  wire [0:0]S_SC_B_7_INFO;
  wire [6:0]S_SC_B_7_PAYLD;
  wire [0:0]S_SC_B_7_RECV;
  wire S_SC_B_7_REQ;
  wire S_SC_B_7_SEND;
  wire [0:0]S_SC_B_8_INFO;
  wire [6:0]S_SC_B_8_PAYLD;
  wire [0:0]S_SC_B_8_RECV;
  wire S_SC_B_8_REQ;
  wire S_SC_B_8_SEND;
  wire [0:0]S_SC_R_1_INFO;
  wire [52:0]S_SC_R_1_PAYLD;
  wire [0:0]S_SC_R_1_RECV;
  wire [0:0]S_SC_R_1_REQ;
  wire [0:0]S_SC_R_1_SEND;
  wire [0:0]S_SC_R_2_INFO;
  wire [52:0]S_SC_R_2_PAYLD;
  wire [0:0]S_SC_R_2_RECV;
  wire S_SC_R_2_REQ;
  wire S_SC_R_2_SEND;
  wire [0:0]S_SC_R_3_INFO;
  wire [52:0]S_SC_R_3_PAYLD;
  wire [0:0]S_SC_R_3_RECV;
  wire S_SC_R_3_REQ;
  wire S_SC_R_3_SEND;
  wire [0:0]S_SC_R_4_INFO;
  wire [52:0]S_SC_R_4_PAYLD;
  wire [0:0]S_SC_R_4_RECV;
  wire S_SC_R_4_REQ;
  wire S_SC_R_4_SEND;
  wire [0:0]S_SC_R_5_INFO;
  wire [52:0]S_SC_R_5_PAYLD;
  wire [0:0]S_SC_R_5_RECV;
  wire S_SC_R_5_REQ;
  wire S_SC_R_5_SEND;
  wire [0:0]S_SC_R_6_INFO;
  wire [52:0]S_SC_R_6_PAYLD;
  wire [0:0]S_SC_R_6_RECV;
  wire S_SC_R_6_REQ;
  wire S_SC_R_6_SEND;
  wire [0:0]S_SC_R_7_INFO;
  wire [52:0]S_SC_R_7_PAYLD;
  wire [0:0]S_SC_R_7_RECV;
  wire S_SC_R_7_REQ;
  wire S_SC_R_7_SEND;
  wire [0:0]S_SC_R_8_INFO;
  wire [52:0]S_SC_R_8_PAYLD;
  wire [0:0]S_SC_R_8_RECV;
  wire S_SC_R_8_REQ;
  wire S_SC_R_8_SEND;
  wire [0:0]S_SC_W_1_INFO;
  wire [59:0]S_SC_W_1_PAYLD;
  wire [0:0]S_SC_W_1_RECV;
  wire S_SC_W_1_REQ;
  wire S_SC_W_1_SEND;
  wire [0:0]S_SC_W_2_INFO;
  wire [59:0]S_SC_W_2_PAYLD;
  wire [0:0]S_SC_W_2_RECV;
  wire [0:0]S_SC_W_2_REQ;
  wire [0:0]S_SC_W_2_SEND;
  wire [0:0]S_SC_W_3_INFO;
  wire [59:0]S_SC_W_3_PAYLD;
  wire [0:0]S_SC_W_3_RECV;
  wire [0:0]S_SC_W_3_REQ;
  wire [0:0]S_SC_W_3_SEND;
  wire [0:0]S_SC_W_4_INFO;
  wire [59:0]S_SC_W_4_PAYLD;
  wire [0:0]S_SC_W_4_RECV;
  wire [0:0]S_SC_W_4_REQ;
  wire [0:0]S_SC_W_4_SEND;
  wire [0:0]S_SC_W_5_INFO;
  wire [59:0]S_SC_W_5_PAYLD;
  wire [0:0]S_SC_W_5_RECV;
  wire [0:0]S_SC_W_5_REQ;
  wire [0:0]S_SC_W_5_SEND;
  wire [0:0]S_SC_W_6_INFO;
  wire [59:0]S_SC_W_6_PAYLD;
  wire [0:0]S_SC_W_6_RECV;
  wire [0:0]S_SC_W_6_REQ;
  wire [0:0]S_SC_W_6_SEND;
  wire [0:0]S_SC_W_7_INFO;
  wire [59:0]S_SC_W_7_PAYLD;
  wire [0:0]S_SC_W_7_RECV;
  wire [0:0]S_SC_W_7_REQ;
  wire [0:0]S_SC_W_7_SEND;
  wire [0:0]S_SC_W_8_INFO;
  wire [59:0]S_SC_W_8_PAYLD;
  wire [0:0]S_SC_W_8_RECV;
  wire [0:0]S_SC_W_8_REQ;
  wire [0:0]S_SC_W_8_SEND;
  wire aclk;
  wire aresetn;
  wire aresetn_net;
  wire clk_map_M00_ACLK;
  wire [0:0]clk_map_M00_ARESETN;
  wire clk_map_M01_ACLK;
  wire clk_map_M02_ACLK;
  wire clk_map_M03_ACLK;
  wire clk_map_M04_ACLK;
  wire clk_map_M05_ACLK;
  wire clk_map_M06_ACLK;
  wire clk_map_S00_ACLK;
  wire [0:0]clk_map_S00_ARESETN;
  wire [0:0]m00_nodes_M_SC_AR_INFO;
  wire [145:0]m00_nodes_M_SC_AR_PAYLD;
  wire m00_nodes_M_SC_AR_RECV;
  wire [0:0]m00_nodes_M_SC_AR_REQ;
  wire [0:0]m00_nodes_M_SC_AR_SEND;
  wire [0:0]m00_nodes_M_SC_AW_INFO;
  wire [145:0]m00_nodes_M_SC_AW_PAYLD;
  wire m00_nodes_M_SC_AW_RECV;
  wire [0:0]m00_nodes_M_SC_AW_REQ;
  wire [0:0]m00_nodes_M_SC_AW_SEND;
  wire [0:0]m00_nodes_M_SC_B_INFO;
  wire [6:0]m00_nodes_M_SC_B_PAYLD;
  wire [0:0]m00_nodes_M_SC_B_RECV;
  wire [0:0]m00_nodes_M_SC_B_REQ;
  wire [0:0]m00_nodes_M_SC_B_SEND;
  wire [0:0]m00_nodes_M_SC_R_INFO;
  wire [52:0]m00_nodes_M_SC_R_PAYLD;
  wire [0:0]m00_nodes_M_SC_R_RECV;
  wire [0:0]m00_nodes_M_SC_R_REQ;
  wire [0:0]m00_nodes_M_SC_R_SEND;
  wire [0:0]m00_nodes_M_SC_W_INFO;
  wire [59:0]m00_nodes_M_SC_W_PAYLD;
  wire m00_nodes_M_SC_W_RECV;
  wire [0:0]m00_nodes_M_SC_W_REQ;
  wire [0:0]m00_nodes_M_SC_W_SEND;
  wire [8:0]m00_sc2axi_M_AXI_ARADDR;
  wire [3:0]m00_sc2axi_M_AXI_ARCACHE;
  wire [0:0]m00_sc2axi_M_AXI_ARID;
  wire [7:0]m00_sc2axi_M_AXI_ARLEN;
  wire [0:0]m00_sc2axi_M_AXI_ARLOCK;
  wire [2:0]m00_sc2axi_M_AXI_ARPROT;
  wire [3:0]m00_sc2axi_M_AXI_ARQOS;
  wire m00_sc2axi_M_AXI_ARREADY;
  wire [1023:0]m00_sc2axi_M_AXI_ARUSER;
  wire m00_sc2axi_M_AXI_ARVALID;
  wire [8:0]m00_sc2axi_M_AXI_AWADDR;
  wire [3:0]m00_sc2axi_M_AXI_AWCACHE;
  wire [0:0]m00_sc2axi_M_AXI_AWID;
  wire [7:0]m00_sc2axi_M_AXI_AWLEN;
  wire [0:0]m00_sc2axi_M_AXI_AWLOCK;
  wire [2:0]m00_sc2axi_M_AXI_AWPROT;
  wire [3:0]m00_sc2axi_M_AXI_AWQOS;
  wire m00_sc2axi_M_AXI_AWREADY;
  wire [1023:0]m00_sc2axi_M_AXI_AWUSER;
  wire m00_sc2axi_M_AXI_AWVALID;
  wire [0:0]m00_sc2axi_M_AXI_BID;
  wire m00_sc2axi_M_AXI_BREADY;
  wire [1:0]m00_sc2axi_M_AXI_BRESP;
  wire [1023:0]m00_sc2axi_M_AXI_BUSER;
  wire m00_sc2axi_M_AXI_BVALID;
  wire [31:0]m00_sc2axi_M_AXI_RDATA;
  wire [0:0]m00_sc2axi_M_AXI_RID;
  wire m00_sc2axi_M_AXI_RLAST;
  wire m00_sc2axi_M_AXI_RREADY;
  wire [1:0]m00_sc2axi_M_AXI_RRESP;
  wire [1023:0]m00_sc2axi_M_AXI_RUSER;
  wire m00_sc2axi_M_AXI_RVALID;
  wire [31:0]m00_sc2axi_M_AXI_WDATA;
  wire m00_sc2axi_M_AXI_WLAST;
  wire m00_sc2axi_M_AXI_WREADY;
  wire [3:0]m00_sc2axi_M_AXI_WSTRB;
  wire [1023:0]m00_sc2axi_M_AXI_WUSER;
  wire m00_sc2axi_M_AXI_WVALID;
  wire [0:0]m01_nodes_M_SC_AR_INFO;
  wire [145:0]m01_nodes_M_SC_AR_PAYLD;
  wire m01_nodes_M_SC_AR_RECV;
  wire [0:0]m01_nodes_M_SC_AR_REQ;
  wire [0:0]m01_nodes_M_SC_AR_SEND;
  wire [0:0]m01_nodes_M_SC_AW_INFO;
  wire [145:0]m01_nodes_M_SC_AW_PAYLD;
  wire m01_nodes_M_SC_AW_RECV;
  wire [0:0]m01_nodes_M_SC_AW_REQ;
  wire [0:0]m01_nodes_M_SC_AW_SEND;
  wire [0:0]m01_nodes_M_SC_B_INFO;
  wire [6:0]m01_nodes_M_SC_B_PAYLD;
  wire [0:0]m01_nodes_M_SC_B_RECV;
  wire [0:0]m01_nodes_M_SC_B_REQ;
  wire [0:0]m01_nodes_M_SC_B_SEND;
  wire [0:0]m01_nodes_M_SC_R_INFO;
  wire [52:0]m01_nodes_M_SC_R_PAYLD;
  wire [0:0]m01_nodes_M_SC_R_RECV;
  wire [0:0]m01_nodes_M_SC_R_REQ;
  wire [0:0]m01_nodes_M_SC_R_SEND;
  wire [0:0]m01_nodes_M_SC_W_INFO;
  wire [59:0]m01_nodes_M_SC_W_PAYLD;
  wire m01_nodes_M_SC_W_RECV;
  wire [0:0]m01_nodes_M_SC_W_REQ;
  wire [0:0]m01_nodes_M_SC_W_SEND;
  wire [17:0]m01_sc2axi_M_AXI_ARADDR;
  wire [3:0]m01_sc2axi_M_AXI_ARCACHE;
  wire [0:0]m01_sc2axi_M_AXI_ARID;
  wire [7:0]m01_sc2axi_M_AXI_ARLEN;
  wire [0:0]m01_sc2axi_M_AXI_ARLOCK;
  wire [2:0]m01_sc2axi_M_AXI_ARPROT;
  wire [3:0]m01_sc2axi_M_AXI_ARQOS;
  wire m01_sc2axi_M_AXI_ARREADY;
  wire [1023:0]m01_sc2axi_M_AXI_ARUSER;
  wire m01_sc2axi_M_AXI_ARVALID;
  wire [17:0]m01_sc2axi_M_AXI_AWADDR;
  wire [3:0]m01_sc2axi_M_AXI_AWCACHE;
  wire [0:0]m01_sc2axi_M_AXI_AWID;
  wire [7:0]m01_sc2axi_M_AXI_AWLEN;
  wire [0:0]m01_sc2axi_M_AXI_AWLOCK;
  wire [2:0]m01_sc2axi_M_AXI_AWPROT;
  wire [3:0]m01_sc2axi_M_AXI_AWQOS;
  wire m01_sc2axi_M_AXI_AWREADY;
  wire [1023:0]m01_sc2axi_M_AXI_AWUSER;
  wire m01_sc2axi_M_AXI_AWVALID;
  wire [0:0]m01_sc2axi_M_AXI_BID;
  wire m01_sc2axi_M_AXI_BREADY;
  wire [1:0]m01_sc2axi_M_AXI_BRESP;
  wire [1023:0]m01_sc2axi_M_AXI_BUSER;
  wire m01_sc2axi_M_AXI_BVALID;
  wire [31:0]m01_sc2axi_M_AXI_RDATA;
  wire [0:0]m01_sc2axi_M_AXI_RID;
  wire m01_sc2axi_M_AXI_RLAST;
  wire m01_sc2axi_M_AXI_RREADY;
  wire [1:0]m01_sc2axi_M_AXI_RRESP;
  wire [1023:0]m01_sc2axi_M_AXI_RUSER;
  wire m01_sc2axi_M_AXI_RVALID;
  wire [31:0]m01_sc2axi_M_AXI_WDATA;
  wire m01_sc2axi_M_AXI_WLAST;
  wire m01_sc2axi_M_AXI_WREADY;
  wire [3:0]m01_sc2axi_M_AXI_WSTRB;
  wire [1023:0]m01_sc2axi_M_AXI_WUSER;
  wire m01_sc2axi_M_AXI_WVALID;
  wire [0:0]m02_nodes_M_SC_AR_INFO;
  wire [145:0]m02_nodes_M_SC_AR_PAYLD;
  wire m02_nodes_M_SC_AR_RECV;
  wire [0:0]m02_nodes_M_SC_AR_REQ;
  wire [0:0]m02_nodes_M_SC_AR_SEND;
  wire [0:0]m02_nodes_M_SC_AW_INFO;
  wire [145:0]m02_nodes_M_SC_AW_PAYLD;
  wire m02_nodes_M_SC_AW_RECV;
  wire [0:0]m02_nodes_M_SC_AW_REQ;
  wire [0:0]m02_nodes_M_SC_AW_SEND;
  wire [0:0]m02_nodes_M_SC_B_INFO;
  wire [6:0]m02_nodes_M_SC_B_PAYLD;
  wire [0:0]m02_nodes_M_SC_B_RECV;
  wire [0:0]m02_nodes_M_SC_B_REQ;
  wire [0:0]m02_nodes_M_SC_B_SEND;
  wire [0:0]m02_nodes_M_SC_R_INFO;
  wire [52:0]m02_nodes_M_SC_R_PAYLD;
  wire [0:0]m02_nodes_M_SC_R_RECV;
  wire [0:0]m02_nodes_M_SC_R_REQ;
  wire [0:0]m02_nodes_M_SC_R_SEND;
  wire [0:0]m02_nodes_M_SC_W_INFO;
  wire [59:0]m02_nodes_M_SC_W_PAYLD;
  wire m02_nodes_M_SC_W_RECV;
  wire [0:0]m02_nodes_M_SC_W_REQ;
  wire [0:0]m02_nodes_M_SC_W_SEND;
  wire [9:0]m02_sc2axi_M_AXI_ARADDR;
  wire [3:0]m02_sc2axi_M_AXI_ARCACHE;
  wire [0:0]m02_sc2axi_M_AXI_ARID;
  wire [7:0]m02_sc2axi_M_AXI_ARLEN;
  wire [0:0]m02_sc2axi_M_AXI_ARLOCK;
  wire [2:0]m02_sc2axi_M_AXI_ARPROT;
  wire [3:0]m02_sc2axi_M_AXI_ARQOS;
  wire m02_sc2axi_M_AXI_ARREADY;
  wire [1023:0]m02_sc2axi_M_AXI_ARUSER;
  wire m02_sc2axi_M_AXI_ARVALID;
  wire [9:0]m02_sc2axi_M_AXI_AWADDR;
  wire [3:0]m02_sc2axi_M_AXI_AWCACHE;
  wire [0:0]m02_sc2axi_M_AXI_AWID;
  wire [7:0]m02_sc2axi_M_AXI_AWLEN;
  wire [0:0]m02_sc2axi_M_AXI_AWLOCK;
  wire [2:0]m02_sc2axi_M_AXI_AWPROT;
  wire [3:0]m02_sc2axi_M_AXI_AWQOS;
  wire m02_sc2axi_M_AXI_AWREADY;
  wire [1023:0]m02_sc2axi_M_AXI_AWUSER;
  wire m02_sc2axi_M_AXI_AWVALID;
  wire [0:0]m02_sc2axi_M_AXI_BID;
  wire m02_sc2axi_M_AXI_BREADY;
  wire [1:0]m02_sc2axi_M_AXI_BRESP;
  wire [1023:0]m02_sc2axi_M_AXI_BUSER;
  wire m02_sc2axi_M_AXI_BVALID;
  wire [31:0]m02_sc2axi_M_AXI_RDATA;
  wire [0:0]m02_sc2axi_M_AXI_RID;
  wire m02_sc2axi_M_AXI_RLAST;
  wire m02_sc2axi_M_AXI_RREADY;
  wire [1:0]m02_sc2axi_M_AXI_RRESP;
  wire [1023:0]m02_sc2axi_M_AXI_RUSER;
  wire m02_sc2axi_M_AXI_RVALID;
  wire [31:0]m02_sc2axi_M_AXI_WDATA;
  wire m02_sc2axi_M_AXI_WLAST;
  wire m02_sc2axi_M_AXI_WREADY;
  wire [3:0]m02_sc2axi_M_AXI_WSTRB;
  wire [1023:0]m02_sc2axi_M_AXI_WUSER;
  wire m02_sc2axi_M_AXI_WVALID;
  wire [0:0]m03_nodes_M_SC_AR_INFO;
  wire [145:0]m03_nodes_M_SC_AR_PAYLD;
  wire m03_nodes_M_SC_AR_RECV;
  wire [0:0]m03_nodes_M_SC_AR_REQ;
  wire [0:0]m03_nodes_M_SC_AR_SEND;
  wire [0:0]m03_nodes_M_SC_AW_INFO;
  wire [145:0]m03_nodes_M_SC_AW_PAYLD;
  wire m03_nodes_M_SC_AW_RECV;
  wire [0:0]m03_nodes_M_SC_AW_REQ;
  wire [0:0]m03_nodes_M_SC_AW_SEND;
  wire [0:0]m03_nodes_M_SC_B_INFO;
  wire [6:0]m03_nodes_M_SC_B_PAYLD;
  wire [0:0]m03_nodes_M_SC_B_RECV;
  wire [0:0]m03_nodes_M_SC_B_REQ;
  wire [0:0]m03_nodes_M_SC_B_SEND;
  wire [0:0]m03_nodes_M_SC_R_INFO;
  wire [52:0]m03_nodes_M_SC_R_PAYLD;
  wire [0:0]m03_nodes_M_SC_R_RECV;
  wire [0:0]m03_nodes_M_SC_R_REQ;
  wire [0:0]m03_nodes_M_SC_R_SEND;
  wire [0:0]m03_nodes_M_SC_W_INFO;
  wire [59:0]m03_nodes_M_SC_W_PAYLD;
  wire m03_nodes_M_SC_W_RECV;
  wire [0:0]m03_nodes_M_SC_W_REQ;
  wire [0:0]m03_nodes_M_SC_W_SEND;
  wire [4:0]m03_sc2axi_M_AXI_ARADDR;
  wire [3:0]m03_sc2axi_M_AXI_ARCACHE;
  wire [0:0]m03_sc2axi_M_AXI_ARID;
  wire [7:0]m03_sc2axi_M_AXI_ARLEN;
  wire [0:0]m03_sc2axi_M_AXI_ARLOCK;
  wire [2:0]m03_sc2axi_M_AXI_ARPROT;
  wire [3:0]m03_sc2axi_M_AXI_ARQOS;
  wire m03_sc2axi_M_AXI_ARREADY;
  wire [1023:0]m03_sc2axi_M_AXI_ARUSER;
  wire m03_sc2axi_M_AXI_ARVALID;
  wire [4:0]m03_sc2axi_M_AXI_AWADDR;
  wire [3:0]m03_sc2axi_M_AXI_AWCACHE;
  wire [0:0]m03_sc2axi_M_AXI_AWID;
  wire [7:0]m03_sc2axi_M_AXI_AWLEN;
  wire [0:0]m03_sc2axi_M_AXI_AWLOCK;
  wire [2:0]m03_sc2axi_M_AXI_AWPROT;
  wire [3:0]m03_sc2axi_M_AXI_AWQOS;
  wire m03_sc2axi_M_AXI_AWREADY;
  wire [1023:0]m03_sc2axi_M_AXI_AWUSER;
  wire m03_sc2axi_M_AXI_AWVALID;
  wire [0:0]m03_sc2axi_M_AXI_BID;
  wire m03_sc2axi_M_AXI_BREADY;
  wire [1:0]m03_sc2axi_M_AXI_BRESP;
  wire [1023:0]m03_sc2axi_M_AXI_BUSER;
  wire m03_sc2axi_M_AXI_BVALID;
  wire [31:0]m03_sc2axi_M_AXI_RDATA;
  wire [0:0]m03_sc2axi_M_AXI_RID;
  wire m03_sc2axi_M_AXI_RLAST;
  wire m03_sc2axi_M_AXI_RREADY;
  wire [1:0]m03_sc2axi_M_AXI_RRESP;
  wire [1023:0]m03_sc2axi_M_AXI_RUSER;
  wire m03_sc2axi_M_AXI_RVALID;
  wire [31:0]m03_sc2axi_M_AXI_WDATA;
  wire m03_sc2axi_M_AXI_WLAST;
  wire m03_sc2axi_M_AXI_WREADY;
  wire [3:0]m03_sc2axi_M_AXI_WSTRB;
  wire [1023:0]m03_sc2axi_M_AXI_WUSER;
  wire m03_sc2axi_M_AXI_WVALID;
  wire [0:0]m04_nodes_M_SC_AR_INFO;
  wire [145:0]m04_nodes_M_SC_AR_PAYLD;
  wire m04_nodes_M_SC_AR_RECV;
  wire [0:0]m04_nodes_M_SC_AR_REQ;
  wire [0:0]m04_nodes_M_SC_AR_SEND;
  wire [0:0]m04_nodes_M_SC_AW_INFO;
  wire [145:0]m04_nodes_M_SC_AW_PAYLD;
  wire m04_nodes_M_SC_AW_RECV;
  wire [0:0]m04_nodes_M_SC_AW_REQ;
  wire [0:0]m04_nodes_M_SC_AW_SEND;
  wire [0:0]m04_nodes_M_SC_B_INFO;
  wire [6:0]m04_nodes_M_SC_B_PAYLD;
  wire [0:0]m04_nodes_M_SC_B_RECV;
  wire [0:0]m04_nodes_M_SC_B_REQ;
  wire [0:0]m04_nodes_M_SC_B_SEND;
  wire [0:0]m04_nodes_M_SC_R_INFO;
  wire [52:0]m04_nodes_M_SC_R_PAYLD;
  wire [0:0]m04_nodes_M_SC_R_RECV;
  wire [0:0]m04_nodes_M_SC_R_REQ;
  wire [0:0]m04_nodes_M_SC_R_SEND;
  wire [0:0]m04_nodes_M_SC_W_INFO;
  wire [59:0]m04_nodes_M_SC_W_PAYLD;
  wire m04_nodes_M_SC_W_RECV;
  wire [0:0]m04_nodes_M_SC_W_REQ;
  wire [0:0]m04_nodes_M_SC_W_SEND;
  wire [3:0]m04_sc2axi_M_AXI_ARADDR;
  wire [3:0]m04_sc2axi_M_AXI_ARCACHE;
  wire [0:0]m04_sc2axi_M_AXI_ARID;
  wire [7:0]m04_sc2axi_M_AXI_ARLEN;
  wire [0:0]m04_sc2axi_M_AXI_ARLOCK;
  wire [2:0]m04_sc2axi_M_AXI_ARPROT;
  wire [3:0]m04_sc2axi_M_AXI_ARQOS;
  wire m04_sc2axi_M_AXI_ARREADY;
  wire [1023:0]m04_sc2axi_M_AXI_ARUSER;
  wire m04_sc2axi_M_AXI_ARVALID;
  wire [3:0]m04_sc2axi_M_AXI_AWADDR;
  wire [3:0]m04_sc2axi_M_AXI_AWCACHE;
  wire [0:0]m04_sc2axi_M_AXI_AWID;
  wire [7:0]m04_sc2axi_M_AXI_AWLEN;
  wire [0:0]m04_sc2axi_M_AXI_AWLOCK;
  wire [2:0]m04_sc2axi_M_AXI_AWPROT;
  wire [3:0]m04_sc2axi_M_AXI_AWQOS;
  wire m04_sc2axi_M_AXI_AWREADY;
  wire [1023:0]m04_sc2axi_M_AXI_AWUSER;
  wire m04_sc2axi_M_AXI_AWVALID;
  wire [0:0]m04_sc2axi_M_AXI_BID;
  wire m04_sc2axi_M_AXI_BREADY;
  wire [1:0]m04_sc2axi_M_AXI_BRESP;
  wire [1023:0]m04_sc2axi_M_AXI_BUSER;
  wire m04_sc2axi_M_AXI_BVALID;
  wire [31:0]m04_sc2axi_M_AXI_RDATA;
  wire [0:0]m04_sc2axi_M_AXI_RID;
  wire m04_sc2axi_M_AXI_RLAST;
  wire m04_sc2axi_M_AXI_RREADY;
  wire [1:0]m04_sc2axi_M_AXI_RRESP;
  wire [1023:0]m04_sc2axi_M_AXI_RUSER;
  wire m04_sc2axi_M_AXI_RVALID;
  wire [31:0]m04_sc2axi_M_AXI_WDATA;
  wire m04_sc2axi_M_AXI_WLAST;
  wire m04_sc2axi_M_AXI_WREADY;
  wire [3:0]m04_sc2axi_M_AXI_WSTRB;
  wire [1023:0]m04_sc2axi_M_AXI_WUSER;
  wire m04_sc2axi_M_AXI_WVALID;
  wire [0:0]m05_nodes_M_SC_AR_INFO;
  wire [145:0]m05_nodes_M_SC_AR_PAYLD;
  wire m05_nodes_M_SC_AR_RECV;
  wire [0:0]m05_nodes_M_SC_AR_REQ;
  wire [0:0]m05_nodes_M_SC_AR_SEND;
  wire [0:0]m05_nodes_M_SC_AW_INFO;
  wire [145:0]m05_nodes_M_SC_AW_PAYLD;
  wire m05_nodes_M_SC_AW_RECV;
  wire [0:0]m05_nodes_M_SC_AW_REQ;
  wire [0:0]m05_nodes_M_SC_AW_SEND;
  wire [0:0]m05_nodes_M_SC_B_INFO;
  wire [6:0]m05_nodes_M_SC_B_PAYLD;
  wire [0:0]m05_nodes_M_SC_B_RECV;
  wire [0:0]m05_nodes_M_SC_B_REQ;
  wire [0:0]m05_nodes_M_SC_B_SEND;
  wire [0:0]m05_nodes_M_SC_R_INFO;
  wire [52:0]m05_nodes_M_SC_R_PAYLD;
  wire [0:0]m05_nodes_M_SC_R_RECV;
  wire [0:0]m05_nodes_M_SC_R_REQ;
  wire [0:0]m05_nodes_M_SC_R_SEND;
  wire [0:0]m05_nodes_M_SC_W_INFO;
  wire [59:0]m05_nodes_M_SC_W_PAYLD;
  wire m05_nodes_M_SC_W_RECV;
  wire [0:0]m05_nodes_M_SC_W_REQ;
  wire [0:0]m05_nodes_M_SC_W_SEND;
  wire [3:0]m05_sc2axi_M_AXI_ARADDR;
  wire [3:0]m05_sc2axi_M_AXI_ARCACHE;
  wire [0:0]m05_sc2axi_M_AXI_ARID;
  wire [7:0]m05_sc2axi_M_AXI_ARLEN;
  wire [0:0]m05_sc2axi_M_AXI_ARLOCK;
  wire [2:0]m05_sc2axi_M_AXI_ARPROT;
  wire [3:0]m05_sc2axi_M_AXI_ARQOS;
  wire m05_sc2axi_M_AXI_ARREADY;
  wire [1023:0]m05_sc2axi_M_AXI_ARUSER;
  wire m05_sc2axi_M_AXI_ARVALID;
  wire [3:0]m05_sc2axi_M_AXI_AWADDR;
  wire [3:0]m05_sc2axi_M_AXI_AWCACHE;
  wire [0:0]m05_sc2axi_M_AXI_AWID;
  wire [7:0]m05_sc2axi_M_AXI_AWLEN;
  wire [0:0]m05_sc2axi_M_AXI_AWLOCK;
  wire [2:0]m05_sc2axi_M_AXI_AWPROT;
  wire [3:0]m05_sc2axi_M_AXI_AWQOS;
  wire m05_sc2axi_M_AXI_AWREADY;
  wire [1023:0]m05_sc2axi_M_AXI_AWUSER;
  wire m05_sc2axi_M_AXI_AWVALID;
  wire [0:0]m05_sc2axi_M_AXI_BID;
  wire m05_sc2axi_M_AXI_BREADY;
  wire [1:0]m05_sc2axi_M_AXI_BRESP;
  wire [1023:0]m05_sc2axi_M_AXI_BUSER;
  wire m05_sc2axi_M_AXI_BVALID;
  wire [31:0]m05_sc2axi_M_AXI_RDATA;
  wire [0:0]m05_sc2axi_M_AXI_RID;
  wire m05_sc2axi_M_AXI_RLAST;
  wire m05_sc2axi_M_AXI_RREADY;
  wire [1:0]m05_sc2axi_M_AXI_RRESP;
  wire [1023:0]m05_sc2axi_M_AXI_RUSER;
  wire m05_sc2axi_M_AXI_RVALID;
  wire [31:0]m05_sc2axi_M_AXI_WDATA;
  wire m05_sc2axi_M_AXI_WLAST;
  wire m05_sc2axi_M_AXI_WREADY;
  wire [3:0]m05_sc2axi_M_AXI_WSTRB;
  wire [1023:0]m05_sc2axi_M_AXI_WUSER;
  wire m05_sc2axi_M_AXI_WVALID;
  wire [0:0]m06_nodes_M_SC_AR_INFO;
  wire [145:0]m06_nodes_M_SC_AR_PAYLD;
  wire m06_nodes_M_SC_AR_RECV;
  wire [0:0]m06_nodes_M_SC_AR_REQ;
  wire [0:0]m06_nodes_M_SC_AR_SEND;
  wire [0:0]m06_nodes_M_SC_AW_INFO;
  wire [145:0]m06_nodes_M_SC_AW_PAYLD;
  wire m06_nodes_M_SC_AW_RECV;
  wire [0:0]m06_nodes_M_SC_AW_REQ;
  wire [0:0]m06_nodes_M_SC_AW_SEND;
  wire [0:0]m06_nodes_M_SC_B_INFO;
  wire [6:0]m06_nodes_M_SC_B_PAYLD;
  wire [0:0]m06_nodes_M_SC_B_RECV;
  wire [0:0]m06_nodes_M_SC_B_REQ;
  wire [0:0]m06_nodes_M_SC_B_SEND;
  wire [0:0]m06_nodes_M_SC_R_INFO;
  wire [52:0]m06_nodes_M_SC_R_PAYLD;
  wire [0:0]m06_nodes_M_SC_R_RECV;
  wire [0:0]m06_nodes_M_SC_R_REQ;
  wire [0:0]m06_nodes_M_SC_R_SEND;
  wire [0:0]m06_nodes_M_SC_W_INFO;
  wire [59:0]m06_nodes_M_SC_W_PAYLD;
  wire m06_nodes_M_SC_W_RECV;
  wire [0:0]m06_nodes_M_SC_W_REQ;
  wire [0:0]m06_nodes_M_SC_W_SEND;
  wire [9:0]m06_sc2axi_M_AXI_ARADDR;
  wire [3:0]m06_sc2axi_M_AXI_ARCACHE;
  wire [0:0]m06_sc2axi_M_AXI_ARID;
  wire [7:0]m06_sc2axi_M_AXI_ARLEN;
  wire [0:0]m06_sc2axi_M_AXI_ARLOCK;
  wire [2:0]m06_sc2axi_M_AXI_ARPROT;
  wire [3:0]m06_sc2axi_M_AXI_ARQOS;
  wire m06_sc2axi_M_AXI_ARREADY;
  wire [1023:0]m06_sc2axi_M_AXI_ARUSER;
  wire m06_sc2axi_M_AXI_ARVALID;
  wire [9:0]m06_sc2axi_M_AXI_AWADDR;
  wire [3:0]m06_sc2axi_M_AXI_AWCACHE;
  wire [0:0]m06_sc2axi_M_AXI_AWID;
  wire [7:0]m06_sc2axi_M_AXI_AWLEN;
  wire [0:0]m06_sc2axi_M_AXI_AWLOCK;
  wire [2:0]m06_sc2axi_M_AXI_AWPROT;
  wire [3:0]m06_sc2axi_M_AXI_AWQOS;
  wire m06_sc2axi_M_AXI_AWREADY;
  wire [1023:0]m06_sc2axi_M_AXI_AWUSER;
  wire m06_sc2axi_M_AXI_AWVALID;
  wire [0:0]m06_sc2axi_M_AXI_BID;
  wire m06_sc2axi_M_AXI_BREADY;
  wire [1:0]m06_sc2axi_M_AXI_BRESP;
  wire [1023:0]m06_sc2axi_M_AXI_BUSER;
  wire m06_sc2axi_M_AXI_BVALID;
  wire [31:0]m06_sc2axi_M_AXI_RDATA;
  wire [0:0]m06_sc2axi_M_AXI_RID;
  wire m06_sc2axi_M_AXI_RLAST;
  wire m06_sc2axi_M_AXI_RREADY;
  wire [1:0]m06_sc2axi_M_AXI_RRESP;
  wire [1023:0]m06_sc2axi_M_AXI_RUSER;
  wire m06_sc2axi_M_AXI_RVALID;
  wire [31:0]m06_sc2axi_M_AXI_WDATA;
  wire m06_sc2axi_M_AXI_WLAST;
  wire m06_sc2axi_M_AXI_WREADY;
  wire [3:0]m06_sc2axi_M_AXI_WSTRB;
  wire [1023:0]m06_sc2axi_M_AXI_WUSER;
  wire m06_sc2axi_M_AXI_WVALID;
  wire [0:0]m_axi_aresetn_1;
  wire [0:0]m_axi_aresetn_2;
  wire [0:0]m_axi_aresetn_3;
  wire [0:0]m_axi_aresetn_4;
  wire [0:0]m_axi_aresetn_5;
  wire [0:0]m_axi_aresetn_6;
  wire [31:0]s00_entry_pipeline_m_axi_ARADDR;
  wire [3:0]s00_entry_pipeline_m_axi_ARCACHE;
  wire [0:0]s00_entry_pipeline_m_axi_ARID;
  wire [7:0]s00_entry_pipeline_m_axi_ARLEN;
  wire [0:0]s00_entry_pipeline_m_axi_ARLOCK;
  wire [2:0]s00_entry_pipeline_m_axi_ARPROT;
  wire [3:0]s00_entry_pipeline_m_axi_ARQOS;
  wire s00_entry_pipeline_m_axi_ARREADY;
  wire [1023:0]s00_entry_pipeline_m_axi_ARUSER;
  wire s00_entry_pipeline_m_axi_ARVALID;
  wire [31:0]s00_entry_pipeline_m_axi_AWADDR;
  wire [3:0]s00_entry_pipeline_m_axi_AWCACHE;
  wire [0:0]s00_entry_pipeline_m_axi_AWID;
  wire [7:0]s00_entry_pipeline_m_axi_AWLEN;
  wire [0:0]s00_entry_pipeline_m_axi_AWLOCK;
  wire [2:0]s00_entry_pipeline_m_axi_AWPROT;
  wire [3:0]s00_entry_pipeline_m_axi_AWQOS;
  wire s00_entry_pipeline_m_axi_AWREADY;
  wire [1023:0]s00_entry_pipeline_m_axi_AWUSER;
  wire s00_entry_pipeline_m_axi_AWVALID;
  wire [0:0]s00_entry_pipeline_m_axi_BID;
  wire s00_entry_pipeline_m_axi_BREADY;
  wire [1:0]s00_entry_pipeline_m_axi_BRESP;
  wire [1023:0]s00_entry_pipeline_m_axi_BUSER;
  wire s00_entry_pipeline_m_axi_BVALID;
  wire [31:0]s00_entry_pipeline_m_axi_RDATA;
  wire [0:0]s00_entry_pipeline_m_axi_RID;
  wire s00_entry_pipeline_m_axi_RLAST;
  wire s00_entry_pipeline_m_axi_RREADY;
  wire [1:0]s00_entry_pipeline_m_axi_RRESP;
  wire [1023:0]s00_entry_pipeline_m_axi_RUSER;
  wire s00_entry_pipeline_m_axi_RVALID;
  wire [31:0]s00_entry_pipeline_m_axi_WDATA;
  wire s00_entry_pipeline_m_axi_WLAST;
  wire s00_entry_pipeline_m_axi_WREADY;
  wire [3:0]s00_entry_pipeline_m_axi_WSTRB;
  wire [1023:0]s00_entry_pipeline_m_axi_WUSER;
  wire s00_entry_pipeline_m_axi_WVALID;
  wire [0:0]s00_nodes_M_SC_AR_INFO;
  wire [145:0]s00_nodes_M_SC_AR_PAYLD;
  wire [0:0]s00_nodes_M_SC_AR_RECV;
  wire [0:0]s00_nodes_M_SC_AR_REQ;
  wire [0:0]s00_nodes_M_SC_AR_SEND;
  wire [0:0]s00_nodes_M_SC_AW_INFO;
  wire [145:0]s00_nodes_M_SC_AW_PAYLD;
  wire [0:0]s00_nodes_M_SC_AW_RECV;
  wire [0:0]s00_nodes_M_SC_AW_REQ;
  wire [0:0]s00_nodes_M_SC_AW_SEND;
  wire [0:0]s00_nodes_M_SC_B_INFO;
  wire [6:0]s00_nodes_M_SC_B_PAYLD;
  wire s00_nodes_M_SC_B_RECV;
  wire [0:0]s00_nodes_M_SC_B_REQ;
  wire [0:0]s00_nodes_M_SC_B_SEND;
  wire [0:0]s00_nodes_M_SC_R_INFO;
  wire [52:0]s00_nodes_M_SC_R_PAYLD;
  wire s00_nodes_M_SC_R_RECV;
  wire [0:0]s00_nodes_M_SC_R_REQ;
  wire [0:0]s00_nodes_M_SC_R_SEND;
  wire [0:0]s00_nodes_M_SC_W_INFO;
  wire [59:0]s00_nodes_M_SC_W_PAYLD;
  wire [0:0]s00_nodes_M_SC_W_RECV;
  wire [0:0]s00_nodes_M_SC_W_REQ;
  wire [0:0]s00_nodes_M_SC_W_SEND;
  wire swbd_aclk_net;
  wire [0:0]swbd_aresetn_net;

  clk_map_imp_1NMB928 clk_map
       (.M00_ACLK(clk_map_M00_ACLK),
        .M00_ARESETN(clk_map_M00_ARESETN),
        .M01_ACLK(clk_map_M01_ACLK),
        .M01_ARESETN(m_axi_aresetn_1),
        .M02_ACLK(clk_map_M02_ACLK),
        .M02_ARESETN(m_axi_aresetn_2),
        .M03_ACLK(clk_map_M03_ACLK),
        .M03_ARESETN(m_axi_aresetn_3),
        .M04_ACLK(clk_map_M04_ACLK),
        .M04_ARESETN(m_axi_aresetn_4),
        .M05_ACLK(clk_map_M05_ACLK),
        .M05_ARESETN(m_axi_aresetn_5),
        .M06_ACLK(clk_map_M06_ACLK),
        .M06_ARESETN(m_axi_aresetn_6),
        .S00_ACLK(clk_map_S00_ACLK),
        .S00_ARESETN(clk_map_S00_ARESETN),
        .aclk(aclk),
        .aresetn(aresetn),
        .aresetn_out(aresetn_net),
        .swbd_aclk(swbd_aclk_net),
        .swbd_aresetn(swbd_aresetn_net));
  m00_exit_pipeline_imp_CVVFJV m00_exit_pipeline
       (.aclk(clk_map_M00_ACLK),
        .aresetn(clk_map_M00_ARESETN),
        .m_axi_araddr(M00_AXI_araddr),
        .m_axi_arprot(M00_AXI_arprot),
        .m_axi_arready(M00_AXI_arready),
        .m_axi_arvalid(M00_AXI_arvalid),
        .m_axi_awaddr(M00_AXI_awaddr),
        .m_axi_awprot(M00_AXI_awprot),
        .m_axi_awready(M00_AXI_awready),
        .m_axi_awvalid(M00_AXI_awvalid),
        .m_axi_bready(M00_AXI_bready),
        .m_axi_bresp(M00_AXI_bresp),
        .m_axi_bvalid(M00_AXI_bvalid),
        .m_axi_rdata(M00_AXI_rdata),
        .m_axi_rready(M00_AXI_rready),
        .m_axi_rresp(M00_AXI_rresp),
        .m_axi_rvalid(M00_AXI_rvalid),
        .m_axi_wdata(M00_AXI_wdata),
        .m_axi_wready(M00_AXI_wready),
        .m_axi_wstrb(M00_AXI_wstrb),
        .m_axi_wvalid(M00_AXI_wvalid),
        .s_axi_araddr(m00_sc2axi_M_AXI_ARADDR),
        .s_axi_arcache(m00_sc2axi_M_AXI_ARCACHE),
        .s_axi_arid(m00_sc2axi_M_AXI_ARID),
        .s_axi_arlen(m00_sc2axi_M_AXI_ARLEN),
        .s_axi_arlock(m00_sc2axi_M_AXI_ARLOCK),
        .s_axi_arprot(m00_sc2axi_M_AXI_ARPROT),
        .s_axi_arqos(m00_sc2axi_M_AXI_ARQOS),
        .s_axi_arready(m00_sc2axi_M_AXI_ARREADY),
        .s_axi_aruser(m00_sc2axi_M_AXI_ARUSER),
        .s_axi_arvalid(m00_sc2axi_M_AXI_ARVALID),
        .s_axi_awaddr(m00_sc2axi_M_AXI_AWADDR),
        .s_axi_awcache(m00_sc2axi_M_AXI_AWCACHE),
        .s_axi_awid(m00_sc2axi_M_AXI_AWID),
        .s_axi_awlen(m00_sc2axi_M_AXI_AWLEN),
        .s_axi_awlock(m00_sc2axi_M_AXI_AWLOCK),
        .s_axi_awprot(m00_sc2axi_M_AXI_AWPROT),
        .s_axi_awqos(m00_sc2axi_M_AXI_AWQOS),
        .s_axi_awready(m00_sc2axi_M_AXI_AWREADY),
        .s_axi_awuser(m00_sc2axi_M_AXI_AWUSER),
        .s_axi_awvalid(m00_sc2axi_M_AXI_AWVALID),
        .s_axi_bid(m00_sc2axi_M_AXI_BID),
        .s_axi_bready(m00_sc2axi_M_AXI_BREADY),
        .s_axi_bresp(m00_sc2axi_M_AXI_BRESP),
        .s_axi_buser(m00_sc2axi_M_AXI_BUSER),
        .s_axi_bvalid(m00_sc2axi_M_AXI_BVALID),
        .s_axi_rdata(m00_sc2axi_M_AXI_RDATA),
        .s_axi_rid(m00_sc2axi_M_AXI_RID),
        .s_axi_rlast(m00_sc2axi_M_AXI_RLAST),
        .s_axi_rready(m00_sc2axi_M_AXI_RREADY),
        .s_axi_rresp(m00_sc2axi_M_AXI_RRESP),
        .s_axi_ruser(m00_sc2axi_M_AXI_RUSER),
        .s_axi_rvalid(m00_sc2axi_M_AXI_RVALID),
        .s_axi_wdata(m00_sc2axi_M_AXI_WDATA),
        .s_axi_wlast(m00_sc2axi_M_AXI_WLAST),
        .s_axi_wready(m00_sc2axi_M_AXI_WREADY),
        .s_axi_wstrb(m00_sc2axi_M_AXI_WSTRB),
        .s_axi_wuser(m00_sc2axi_M_AXI_WUSER),
        .s_axi_wvalid(m00_sc2axi_M_AXI_WVALID));
  m00_nodes_imp_Z1B1P3 m00_nodes
       (.M_SC_AR_info(m00_nodes_M_SC_AR_INFO),
        .M_SC_AR_payld(m00_nodes_M_SC_AR_PAYLD),
        .M_SC_AR_recv(m00_nodes_M_SC_AR_RECV),
        .M_SC_AR_req(m00_nodes_M_SC_AR_REQ),
        .M_SC_AR_send(m00_nodes_M_SC_AR_SEND),
        .M_SC_AW_info(m00_nodes_M_SC_AW_INFO),
        .M_SC_AW_payld(m00_nodes_M_SC_AW_PAYLD),
        .M_SC_AW_recv(m00_nodes_M_SC_AW_RECV),
        .M_SC_AW_req(m00_nodes_M_SC_AW_REQ),
        .M_SC_AW_send(m00_nodes_M_SC_AW_SEND),
        .M_SC_B_info(m00_nodes_M_SC_B_INFO),
        .M_SC_B_payld(m00_nodes_M_SC_B_PAYLD),
        .M_SC_B_recv(m00_nodes_M_SC_B_RECV),
        .M_SC_B_req(m00_nodes_M_SC_B_REQ),
        .M_SC_B_send(m00_nodes_M_SC_B_SEND),
        .M_SC_R_info(m00_nodes_M_SC_R_INFO),
        .M_SC_R_payld(m00_nodes_M_SC_R_PAYLD),
        .M_SC_R_recv(m00_nodes_M_SC_R_RECV),
        .M_SC_R_req(m00_nodes_M_SC_R_REQ),
        .M_SC_R_send(m00_nodes_M_SC_R_SEND),
        .M_SC_W_info(m00_nodes_M_SC_W_INFO),
        .M_SC_W_payld(m00_nodes_M_SC_W_PAYLD),
        .M_SC_W_recv(m00_nodes_M_SC_W_RECV),
        .M_SC_W_req(m00_nodes_M_SC_W_REQ),
        .M_SC_W_send(m00_nodes_M_SC_W_SEND),
        .S_SC_AR_info(S_SC_AR_2_INFO),
        .S_SC_AR_payld(S_SC_AR_2_PAYLD),
        .S_SC_AR_recv(S_SC_AR_2_RECV),
        .S_SC_AR_req(S_SC_AR_2_REQ),
        .S_SC_AR_send(S_SC_AR_2_SEND),
        .S_SC_AW_info(S_SC_AW_2_INFO),
        .S_SC_AW_payld(S_SC_AW_2_PAYLD),
        .S_SC_AW_recv(S_SC_AW_2_RECV),
        .S_SC_AW_req(S_SC_AW_2_REQ),
        .S_SC_AW_send(S_SC_AW_2_SEND),
        .S_SC_B_info(S_SC_B_2_INFO),
        .S_SC_B_payld(S_SC_B_2_PAYLD),
        .S_SC_B_recv(S_SC_B_2_RECV),
        .S_SC_B_req(S_SC_B_2_REQ),
        .S_SC_B_send(S_SC_B_2_SEND),
        .S_SC_R_info(S_SC_R_2_INFO),
        .S_SC_R_payld(S_SC_R_2_PAYLD),
        .S_SC_R_recv(S_SC_R_2_RECV),
        .S_SC_R_req(S_SC_R_2_REQ),
        .S_SC_R_send(S_SC_R_2_SEND),
        .S_SC_W_info(S_SC_W_2_INFO),
        .S_SC_W_payld(S_SC_W_2_PAYLD),
        .S_SC_W_recv(S_SC_W_2_RECV),
        .S_SC_W_req(S_SC_W_2_REQ),
        .S_SC_W_send(S_SC_W_2_SEND),
        .m_axi_aclk(clk_map_M00_ACLK),
        .m_axi_aresetn(clk_map_M00_ARESETN),
        .s_axi_aclk(clk_map_M00_ACLK),
        .s_axi_aresetn(clk_map_M00_ARESETN));
  bd_48ac_m00s2a_0 m00_sc2axi
       (.aclk(clk_map_M00_ACLK),
        .m_axi_araddr(m00_sc2axi_M_AXI_ARADDR),
        .m_axi_arcache(m00_sc2axi_M_AXI_ARCACHE),
        .m_axi_arid(m00_sc2axi_M_AXI_ARID),
        .m_axi_arlen(m00_sc2axi_M_AXI_ARLEN),
        .m_axi_arlock(m00_sc2axi_M_AXI_ARLOCK),
        .m_axi_arprot(m00_sc2axi_M_AXI_ARPROT),
        .m_axi_arqos(m00_sc2axi_M_AXI_ARQOS),
        .m_axi_arready(m00_sc2axi_M_AXI_ARREADY),
        .m_axi_aruser(m00_sc2axi_M_AXI_ARUSER),
        .m_axi_arvalid(m00_sc2axi_M_AXI_ARVALID),
        .m_axi_awaddr(m00_sc2axi_M_AXI_AWADDR),
        .m_axi_awcache(m00_sc2axi_M_AXI_AWCACHE),
        .m_axi_awid(m00_sc2axi_M_AXI_AWID),
        .m_axi_awlen(m00_sc2axi_M_AXI_AWLEN),
        .m_axi_awlock(m00_sc2axi_M_AXI_AWLOCK),
        .m_axi_awprot(m00_sc2axi_M_AXI_AWPROT),
        .m_axi_awqos(m00_sc2axi_M_AXI_AWQOS),
        .m_axi_awready(m00_sc2axi_M_AXI_AWREADY),
        .m_axi_awuser(m00_sc2axi_M_AXI_AWUSER),
        .m_axi_awvalid(m00_sc2axi_M_AXI_AWVALID),
        .m_axi_bid(m00_sc2axi_M_AXI_BID),
        .m_axi_bready(m00_sc2axi_M_AXI_BREADY),
        .m_axi_bresp(m00_sc2axi_M_AXI_BRESP),
        .m_axi_buser(m00_sc2axi_M_AXI_BUSER),
        .m_axi_bvalid(m00_sc2axi_M_AXI_BVALID),
        .m_axi_rdata(m00_sc2axi_M_AXI_RDATA),
        .m_axi_rid(m00_sc2axi_M_AXI_RID),
        .m_axi_rlast(m00_sc2axi_M_AXI_RLAST),
        .m_axi_rready(m00_sc2axi_M_AXI_RREADY),
        .m_axi_rresp(m00_sc2axi_M_AXI_RRESP),
        .m_axi_ruser(m00_sc2axi_M_AXI_RUSER),
        .m_axi_rvalid(m00_sc2axi_M_AXI_RVALID),
        .m_axi_wdata(m00_sc2axi_M_AXI_WDATA),
        .m_axi_wlast(m00_sc2axi_M_AXI_WLAST),
        .m_axi_wready(m00_sc2axi_M_AXI_WREADY),
        .m_axi_wstrb(m00_sc2axi_M_AXI_WSTRB),
        .m_axi_wuser(m00_sc2axi_M_AXI_WUSER),
        .m_axi_wvalid(m00_sc2axi_M_AXI_WVALID),
        .m_sc_b_info(S_SC_B_2_INFO),
        .m_sc_b_payld(S_SC_B_2_PAYLD),
        .m_sc_b_recv(S_SC_B_2_RECV),
        .m_sc_b_req(S_SC_B_2_REQ),
        .m_sc_b_send(S_SC_B_2_SEND),
        .m_sc_r_info(S_SC_R_2_INFO),
        .m_sc_r_payld(S_SC_R_2_PAYLD),
        .m_sc_r_recv(S_SC_R_2_RECV),
        .m_sc_r_req(S_SC_R_2_REQ),
        .m_sc_r_send(S_SC_R_2_SEND),
        .s_sc_ar_info(m00_nodes_M_SC_AR_INFO),
        .s_sc_ar_payld(m00_nodes_M_SC_AR_PAYLD),
        .s_sc_ar_recv(m00_nodes_M_SC_AR_RECV),
        .s_sc_ar_req(m00_nodes_M_SC_AR_REQ),
        .s_sc_ar_send(m00_nodes_M_SC_AR_SEND),
        .s_sc_aw_info(m00_nodes_M_SC_AW_INFO),
        .s_sc_aw_payld(m00_nodes_M_SC_AW_PAYLD),
        .s_sc_aw_recv(m00_nodes_M_SC_AW_RECV),
        .s_sc_aw_req(m00_nodes_M_SC_AW_REQ),
        .s_sc_aw_send(m00_nodes_M_SC_AW_SEND),
        .s_sc_w_info(m00_nodes_M_SC_W_INFO),
        .s_sc_w_payld(m00_nodes_M_SC_W_PAYLD),
        .s_sc_w_recv(m00_nodes_M_SC_W_RECV),
        .s_sc_w_req(m00_nodes_M_SC_W_REQ),
        .s_sc_w_send(m00_nodes_M_SC_W_SEND));
  m01_exit_pipeline_imp_FWTRCR m01_exit_pipeline
       (.aclk(clk_map_M01_ACLK),
        .aresetn(m_axi_aresetn_1),
        .m_axi_araddr(M01_AXI_araddr),
        .m_axi_arprot(M01_AXI_arprot),
        .m_axi_arready(M01_AXI_arready),
        .m_axi_arvalid(M01_AXI_arvalid),
        .m_axi_awaddr(M01_AXI_awaddr),
        .m_axi_awprot(M01_AXI_awprot),
        .m_axi_awready(M01_AXI_awready),
        .m_axi_awvalid(M01_AXI_awvalid),
        .m_axi_bready(M01_AXI_bready),
        .m_axi_bresp(M01_AXI_bresp),
        .m_axi_bvalid(M01_AXI_bvalid),
        .m_axi_rdata(M01_AXI_rdata),
        .m_axi_rready(M01_AXI_rready),
        .m_axi_rresp(M01_AXI_rresp),
        .m_axi_rvalid(M01_AXI_rvalid),
        .m_axi_wdata(M01_AXI_wdata),
        .m_axi_wready(M01_AXI_wready),
        .m_axi_wstrb(M01_AXI_wstrb),
        .m_axi_wvalid(M01_AXI_wvalid),
        .s_axi_araddr(m01_sc2axi_M_AXI_ARADDR),
        .s_axi_arcache(m01_sc2axi_M_AXI_ARCACHE),
        .s_axi_arid(m01_sc2axi_M_AXI_ARID),
        .s_axi_arlen(m01_sc2axi_M_AXI_ARLEN),
        .s_axi_arlock(m01_sc2axi_M_AXI_ARLOCK),
        .s_axi_arprot(m01_sc2axi_M_AXI_ARPROT),
        .s_axi_arqos(m01_sc2axi_M_AXI_ARQOS),
        .s_axi_arready(m01_sc2axi_M_AXI_ARREADY),
        .s_axi_aruser(m01_sc2axi_M_AXI_ARUSER),
        .s_axi_arvalid(m01_sc2axi_M_AXI_ARVALID),
        .s_axi_awaddr(m01_sc2axi_M_AXI_AWADDR),
        .s_axi_awcache(m01_sc2axi_M_AXI_AWCACHE),
        .s_axi_awid(m01_sc2axi_M_AXI_AWID),
        .s_axi_awlen(m01_sc2axi_M_AXI_AWLEN),
        .s_axi_awlock(m01_sc2axi_M_AXI_AWLOCK),
        .s_axi_awprot(m01_sc2axi_M_AXI_AWPROT),
        .s_axi_awqos(m01_sc2axi_M_AXI_AWQOS),
        .s_axi_awready(m01_sc2axi_M_AXI_AWREADY),
        .s_axi_awuser(m01_sc2axi_M_AXI_AWUSER),
        .s_axi_awvalid(m01_sc2axi_M_AXI_AWVALID),
        .s_axi_bid(m01_sc2axi_M_AXI_BID),
        .s_axi_bready(m01_sc2axi_M_AXI_BREADY),
        .s_axi_bresp(m01_sc2axi_M_AXI_BRESP),
        .s_axi_buser(m01_sc2axi_M_AXI_BUSER),
        .s_axi_bvalid(m01_sc2axi_M_AXI_BVALID),
        .s_axi_rdata(m01_sc2axi_M_AXI_RDATA),
        .s_axi_rid(m01_sc2axi_M_AXI_RID),
        .s_axi_rlast(m01_sc2axi_M_AXI_RLAST),
        .s_axi_rready(m01_sc2axi_M_AXI_RREADY),
        .s_axi_rresp(m01_sc2axi_M_AXI_RRESP),
        .s_axi_ruser(m01_sc2axi_M_AXI_RUSER),
        .s_axi_rvalid(m01_sc2axi_M_AXI_RVALID),
        .s_axi_wdata(m01_sc2axi_M_AXI_WDATA),
        .s_axi_wlast(m01_sc2axi_M_AXI_WLAST),
        .s_axi_wready(m01_sc2axi_M_AXI_WREADY),
        .s_axi_wstrb(m01_sc2axi_M_AXI_WSTRB),
        .s_axi_wuser(m01_sc2axi_M_AXI_WUSER),
        .s_axi_wvalid(m01_sc2axi_M_AXI_WVALID));
  m01_nodes_imp_1R2BU3L m01_nodes
       (.M_SC_AR_info(m01_nodes_M_SC_AR_INFO),
        .M_SC_AR_payld(m01_nodes_M_SC_AR_PAYLD),
        .M_SC_AR_recv(m01_nodes_M_SC_AR_RECV),
        .M_SC_AR_req(m01_nodes_M_SC_AR_REQ),
        .M_SC_AR_send(m01_nodes_M_SC_AR_SEND),
        .M_SC_AW_info(m01_nodes_M_SC_AW_INFO),
        .M_SC_AW_payld(m01_nodes_M_SC_AW_PAYLD),
        .M_SC_AW_recv(m01_nodes_M_SC_AW_RECV),
        .M_SC_AW_req(m01_nodes_M_SC_AW_REQ),
        .M_SC_AW_send(m01_nodes_M_SC_AW_SEND),
        .M_SC_B_info(m01_nodes_M_SC_B_INFO),
        .M_SC_B_payld(m01_nodes_M_SC_B_PAYLD),
        .M_SC_B_recv(m01_nodes_M_SC_B_RECV),
        .M_SC_B_req(m01_nodes_M_SC_B_REQ),
        .M_SC_B_send(m01_nodes_M_SC_B_SEND),
        .M_SC_R_info(m01_nodes_M_SC_R_INFO),
        .M_SC_R_payld(m01_nodes_M_SC_R_PAYLD),
        .M_SC_R_recv(m01_nodes_M_SC_R_RECV),
        .M_SC_R_req(m01_nodes_M_SC_R_REQ),
        .M_SC_R_send(m01_nodes_M_SC_R_SEND),
        .M_SC_W_info(m01_nodes_M_SC_W_INFO),
        .M_SC_W_payld(m01_nodes_M_SC_W_PAYLD),
        .M_SC_W_recv(m01_nodes_M_SC_W_RECV),
        .M_SC_W_req(m01_nodes_M_SC_W_REQ),
        .M_SC_W_send(m01_nodes_M_SC_W_SEND),
        .S_SC_AR_info(S_SC_AR_3_INFO),
        .S_SC_AR_payld(S_SC_AR_3_PAYLD),
        .S_SC_AR_recv(S_SC_AR_3_RECV),
        .S_SC_AR_req(S_SC_AR_3_REQ),
        .S_SC_AR_send(S_SC_AR_3_SEND),
        .S_SC_AW_info(S_SC_AW_3_INFO),
        .S_SC_AW_payld(S_SC_AW_3_PAYLD),
        .S_SC_AW_recv(S_SC_AW_3_RECV),
        .S_SC_AW_req(S_SC_AW_3_REQ),
        .S_SC_AW_send(S_SC_AW_3_SEND),
        .S_SC_B_info(S_SC_B_3_INFO),
        .S_SC_B_payld(S_SC_B_3_PAYLD),
        .S_SC_B_recv(S_SC_B_3_RECV),
        .S_SC_B_req(S_SC_B_3_REQ),
        .S_SC_B_send(S_SC_B_3_SEND),
        .S_SC_R_info(S_SC_R_3_INFO),
        .S_SC_R_payld(S_SC_R_3_PAYLD),
        .S_SC_R_recv(S_SC_R_3_RECV),
        .S_SC_R_req(S_SC_R_3_REQ),
        .S_SC_R_send(S_SC_R_3_SEND),
        .S_SC_W_info(S_SC_W_3_INFO),
        .S_SC_W_payld(S_SC_W_3_PAYLD),
        .S_SC_W_recv(S_SC_W_3_RECV),
        .S_SC_W_req(S_SC_W_3_REQ),
        .S_SC_W_send(S_SC_W_3_SEND),
        .m_axi_aclk(clk_map_M01_ACLK),
        .m_axi_aresetn(m_axi_aresetn_1),
        .s_axi_aclk(clk_map_M00_ACLK),
        .s_axi_aresetn(clk_map_M00_ARESETN));
  bd_48ac_m01s2a_0 m01_sc2axi
       (.aclk(clk_map_M01_ACLK),
        .m_axi_araddr(m01_sc2axi_M_AXI_ARADDR),
        .m_axi_arcache(m01_sc2axi_M_AXI_ARCACHE),
        .m_axi_arid(m01_sc2axi_M_AXI_ARID),
        .m_axi_arlen(m01_sc2axi_M_AXI_ARLEN),
        .m_axi_arlock(m01_sc2axi_M_AXI_ARLOCK),
        .m_axi_arprot(m01_sc2axi_M_AXI_ARPROT),
        .m_axi_arqos(m01_sc2axi_M_AXI_ARQOS),
        .m_axi_arready(m01_sc2axi_M_AXI_ARREADY),
        .m_axi_aruser(m01_sc2axi_M_AXI_ARUSER),
        .m_axi_arvalid(m01_sc2axi_M_AXI_ARVALID),
        .m_axi_awaddr(m01_sc2axi_M_AXI_AWADDR),
        .m_axi_awcache(m01_sc2axi_M_AXI_AWCACHE),
        .m_axi_awid(m01_sc2axi_M_AXI_AWID),
        .m_axi_awlen(m01_sc2axi_M_AXI_AWLEN),
        .m_axi_awlock(m01_sc2axi_M_AXI_AWLOCK),
        .m_axi_awprot(m01_sc2axi_M_AXI_AWPROT),
        .m_axi_awqos(m01_sc2axi_M_AXI_AWQOS),
        .m_axi_awready(m01_sc2axi_M_AXI_AWREADY),
        .m_axi_awuser(m01_sc2axi_M_AXI_AWUSER),
        .m_axi_awvalid(m01_sc2axi_M_AXI_AWVALID),
        .m_axi_bid(m01_sc2axi_M_AXI_BID),
        .m_axi_bready(m01_sc2axi_M_AXI_BREADY),
        .m_axi_bresp(m01_sc2axi_M_AXI_BRESP),
        .m_axi_buser(m01_sc2axi_M_AXI_BUSER),
        .m_axi_bvalid(m01_sc2axi_M_AXI_BVALID),
        .m_axi_rdata(m01_sc2axi_M_AXI_RDATA),
        .m_axi_rid(m01_sc2axi_M_AXI_RID),
        .m_axi_rlast(m01_sc2axi_M_AXI_RLAST),
        .m_axi_rready(m01_sc2axi_M_AXI_RREADY),
        .m_axi_rresp(m01_sc2axi_M_AXI_RRESP),
        .m_axi_ruser(m01_sc2axi_M_AXI_RUSER),
        .m_axi_rvalid(m01_sc2axi_M_AXI_RVALID),
        .m_axi_wdata(m01_sc2axi_M_AXI_WDATA),
        .m_axi_wlast(m01_sc2axi_M_AXI_WLAST),
        .m_axi_wready(m01_sc2axi_M_AXI_WREADY),
        .m_axi_wstrb(m01_sc2axi_M_AXI_WSTRB),
        .m_axi_wuser(m01_sc2axi_M_AXI_WUSER),
        .m_axi_wvalid(m01_sc2axi_M_AXI_WVALID),
        .m_sc_b_info(S_SC_B_3_INFO),
        .m_sc_b_payld(S_SC_B_3_PAYLD),
        .m_sc_b_recv(S_SC_B_3_RECV),
        .m_sc_b_req(S_SC_B_3_REQ),
        .m_sc_b_send(S_SC_B_3_SEND),
        .m_sc_r_info(S_SC_R_3_INFO),
        .m_sc_r_payld(S_SC_R_3_PAYLD),
        .m_sc_r_recv(S_SC_R_3_RECV),
        .m_sc_r_req(S_SC_R_3_REQ),
        .m_sc_r_send(S_SC_R_3_SEND),
        .s_sc_ar_info(m01_nodes_M_SC_AR_INFO),
        .s_sc_ar_payld(m01_nodes_M_SC_AR_PAYLD),
        .s_sc_ar_recv(m01_nodes_M_SC_AR_RECV),
        .s_sc_ar_req(m01_nodes_M_SC_AR_REQ),
        .s_sc_ar_send(m01_nodes_M_SC_AR_SEND),
        .s_sc_aw_info(m01_nodes_M_SC_AW_INFO),
        .s_sc_aw_payld(m01_nodes_M_SC_AW_PAYLD),
        .s_sc_aw_recv(m01_nodes_M_SC_AW_RECV),
        .s_sc_aw_req(m01_nodes_M_SC_AW_REQ),
        .s_sc_aw_send(m01_nodes_M_SC_AW_SEND),
        .s_sc_w_info(m01_nodes_M_SC_W_INFO),
        .s_sc_w_payld(m01_nodes_M_SC_W_PAYLD),
        .s_sc_w_recv(m01_nodes_M_SC_W_RECV),
        .s_sc_w_req(m01_nodes_M_SC_W_REQ),
        .s_sc_w_send(m01_nodes_M_SC_W_SEND));
  m02_exit_pipeline_imp_19C6Z m02_exit_pipeline
       (.aclk(clk_map_M02_ACLK),
        .aresetn(m_axi_aresetn_2),
        .m_axi_araddr(M02_AXI_araddr),
        .m_axi_arprot(M02_AXI_arprot),
        .m_axi_arready(M02_AXI_arready),
        .m_axi_arvalid(M02_AXI_arvalid),
        .m_axi_awaddr(M02_AXI_awaddr),
        .m_axi_awprot(M02_AXI_awprot),
        .m_axi_awready(M02_AXI_awready),
        .m_axi_awvalid(M02_AXI_awvalid),
        .m_axi_bready(M02_AXI_bready),
        .m_axi_bresp(M02_AXI_bresp),
        .m_axi_bvalid(M02_AXI_bvalid),
        .m_axi_rdata(M02_AXI_rdata),
        .m_axi_rready(M02_AXI_rready),
        .m_axi_rresp(M02_AXI_rresp),
        .m_axi_rvalid(M02_AXI_rvalid),
        .m_axi_wdata(M02_AXI_wdata),
        .m_axi_wready(M02_AXI_wready),
        .m_axi_wstrb(M02_AXI_wstrb),
        .m_axi_wvalid(M02_AXI_wvalid),
        .s_axi_araddr(m02_sc2axi_M_AXI_ARADDR),
        .s_axi_arcache(m02_sc2axi_M_AXI_ARCACHE),
        .s_axi_arid(m02_sc2axi_M_AXI_ARID),
        .s_axi_arlen(m02_sc2axi_M_AXI_ARLEN),
        .s_axi_arlock(m02_sc2axi_M_AXI_ARLOCK),
        .s_axi_arprot(m02_sc2axi_M_AXI_ARPROT),
        .s_axi_arqos(m02_sc2axi_M_AXI_ARQOS),
        .s_axi_arready(m02_sc2axi_M_AXI_ARREADY),
        .s_axi_aruser(m02_sc2axi_M_AXI_ARUSER),
        .s_axi_arvalid(m02_sc2axi_M_AXI_ARVALID),
        .s_axi_awaddr(m02_sc2axi_M_AXI_AWADDR),
        .s_axi_awcache(m02_sc2axi_M_AXI_AWCACHE),
        .s_axi_awid(m02_sc2axi_M_AXI_AWID),
        .s_axi_awlen(m02_sc2axi_M_AXI_AWLEN),
        .s_axi_awlock(m02_sc2axi_M_AXI_AWLOCK),
        .s_axi_awprot(m02_sc2axi_M_AXI_AWPROT),
        .s_axi_awqos(m02_sc2axi_M_AXI_AWQOS),
        .s_axi_awready(m02_sc2axi_M_AXI_AWREADY),
        .s_axi_awuser(m02_sc2axi_M_AXI_AWUSER),
        .s_axi_awvalid(m02_sc2axi_M_AXI_AWVALID),
        .s_axi_bid(m02_sc2axi_M_AXI_BID),
        .s_axi_bready(m02_sc2axi_M_AXI_BREADY),
        .s_axi_bresp(m02_sc2axi_M_AXI_BRESP),
        .s_axi_buser(m02_sc2axi_M_AXI_BUSER),
        .s_axi_bvalid(m02_sc2axi_M_AXI_BVALID),
        .s_axi_rdata(m02_sc2axi_M_AXI_RDATA),
        .s_axi_rid(m02_sc2axi_M_AXI_RID),
        .s_axi_rlast(m02_sc2axi_M_AXI_RLAST),
        .s_axi_rready(m02_sc2axi_M_AXI_RREADY),
        .s_axi_rresp(m02_sc2axi_M_AXI_RRESP),
        .s_axi_ruser(m02_sc2axi_M_AXI_RUSER),
        .s_axi_rvalid(m02_sc2axi_M_AXI_RVALID),
        .s_axi_wdata(m02_sc2axi_M_AXI_WDATA),
        .s_axi_wlast(m02_sc2axi_M_AXI_WLAST),
        .s_axi_wready(m02_sc2axi_M_AXI_WREADY),
        .s_axi_wstrb(m02_sc2axi_M_AXI_WSTRB),
        .s_axi_wuser(m02_sc2axi_M_AXI_WUSER),
        .s_axi_wvalid(m02_sc2axi_M_AXI_WVALID));
  m02_nodes_imp_185W3JU m02_nodes
       (.M_SC_AR_info(m02_nodes_M_SC_AR_INFO),
        .M_SC_AR_payld(m02_nodes_M_SC_AR_PAYLD),
        .M_SC_AR_recv(m02_nodes_M_SC_AR_RECV),
        .M_SC_AR_req(m02_nodes_M_SC_AR_REQ),
        .M_SC_AR_send(m02_nodes_M_SC_AR_SEND),
        .M_SC_AW_info(m02_nodes_M_SC_AW_INFO),
        .M_SC_AW_payld(m02_nodes_M_SC_AW_PAYLD),
        .M_SC_AW_recv(m02_nodes_M_SC_AW_RECV),
        .M_SC_AW_req(m02_nodes_M_SC_AW_REQ),
        .M_SC_AW_send(m02_nodes_M_SC_AW_SEND),
        .M_SC_B_info(m02_nodes_M_SC_B_INFO),
        .M_SC_B_payld(m02_nodes_M_SC_B_PAYLD),
        .M_SC_B_recv(m02_nodes_M_SC_B_RECV),
        .M_SC_B_req(m02_nodes_M_SC_B_REQ),
        .M_SC_B_send(m02_nodes_M_SC_B_SEND),
        .M_SC_R_info(m02_nodes_M_SC_R_INFO),
        .M_SC_R_payld(m02_nodes_M_SC_R_PAYLD),
        .M_SC_R_recv(m02_nodes_M_SC_R_RECV),
        .M_SC_R_req(m02_nodes_M_SC_R_REQ),
        .M_SC_R_send(m02_nodes_M_SC_R_SEND),
        .M_SC_W_info(m02_nodes_M_SC_W_INFO),
        .M_SC_W_payld(m02_nodes_M_SC_W_PAYLD),
        .M_SC_W_recv(m02_nodes_M_SC_W_RECV),
        .M_SC_W_req(m02_nodes_M_SC_W_REQ),
        .M_SC_W_send(m02_nodes_M_SC_W_SEND),
        .S_SC_AR_info(S_SC_AR_4_INFO),
        .S_SC_AR_payld(S_SC_AR_4_PAYLD),
        .S_SC_AR_recv(S_SC_AR_4_RECV),
        .S_SC_AR_req(S_SC_AR_4_REQ),
        .S_SC_AR_send(S_SC_AR_4_SEND),
        .S_SC_AW_info(S_SC_AW_4_INFO),
        .S_SC_AW_payld(S_SC_AW_4_PAYLD),
        .S_SC_AW_recv(S_SC_AW_4_RECV),
        .S_SC_AW_req(S_SC_AW_4_REQ),
        .S_SC_AW_send(S_SC_AW_4_SEND),
        .S_SC_B_info(S_SC_B_4_INFO),
        .S_SC_B_payld(S_SC_B_4_PAYLD),
        .S_SC_B_recv(S_SC_B_4_RECV),
        .S_SC_B_req(S_SC_B_4_REQ),
        .S_SC_B_send(S_SC_B_4_SEND),
        .S_SC_R_info(S_SC_R_4_INFO),
        .S_SC_R_payld(S_SC_R_4_PAYLD),
        .S_SC_R_recv(S_SC_R_4_RECV),
        .S_SC_R_req(S_SC_R_4_REQ),
        .S_SC_R_send(S_SC_R_4_SEND),
        .S_SC_W_info(S_SC_W_4_INFO),
        .S_SC_W_payld(S_SC_W_4_PAYLD),
        .S_SC_W_recv(S_SC_W_4_RECV),
        .S_SC_W_req(S_SC_W_4_REQ),
        .S_SC_W_send(S_SC_W_4_SEND),
        .m_axi_aclk(clk_map_M02_ACLK),
        .m_axi_aresetn(m_axi_aresetn_2),
        .s_axi_aclk(clk_map_M00_ACLK),
        .s_axi_aresetn(clk_map_M00_ARESETN));
  bd_48ac_m02s2a_0 m02_sc2axi
       (.aclk(clk_map_M02_ACLK),
        .m_axi_araddr(m02_sc2axi_M_AXI_ARADDR),
        .m_axi_arcache(m02_sc2axi_M_AXI_ARCACHE),
        .m_axi_arid(m02_sc2axi_M_AXI_ARID),
        .m_axi_arlen(m02_sc2axi_M_AXI_ARLEN),
        .m_axi_arlock(m02_sc2axi_M_AXI_ARLOCK),
        .m_axi_arprot(m02_sc2axi_M_AXI_ARPROT),
        .m_axi_arqos(m02_sc2axi_M_AXI_ARQOS),
        .m_axi_arready(m02_sc2axi_M_AXI_ARREADY),
        .m_axi_aruser(m02_sc2axi_M_AXI_ARUSER),
        .m_axi_arvalid(m02_sc2axi_M_AXI_ARVALID),
        .m_axi_awaddr(m02_sc2axi_M_AXI_AWADDR),
        .m_axi_awcache(m02_sc2axi_M_AXI_AWCACHE),
        .m_axi_awid(m02_sc2axi_M_AXI_AWID),
        .m_axi_awlen(m02_sc2axi_M_AXI_AWLEN),
        .m_axi_awlock(m02_sc2axi_M_AXI_AWLOCK),
        .m_axi_awprot(m02_sc2axi_M_AXI_AWPROT),
        .m_axi_awqos(m02_sc2axi_M_AXI_AWQOS),
        .m_axi_awready(m02_sc2axi_M_AXI_AWREADY),
        .m_axi_awuser(m02_sc2axi_M_AXI_AWUSER),
        .m_axi_awvalid(m02_sc2axi_M_AXI_AWVALID),
        .m_axi_bid(m02_sc2axi_M_AXI_BID),
        .m_axi_bready(m02_sc2axi_M_AXI_BREADY),
        .m_axi_bresp(m02_sc2axi_M_AXI_BRESP),
        .m_axi_buser(m02_sc2axi_M_AXI_BUSER),
        .m_axi_bvalid(m02_sc2axi_M_AXI_BVALID),
        .m_axi_rdata(m02_sc2axi_M_AXI_RDATA),
        .m_axi_rid(m02_sc2axi_M_AXI_RID),
        .m_axi_rlast(m02_sc2axi_M_AXI_RLAST),
        .m_axi_rready(m02_sc2axi_M_AXI_RREADY),
        .m_axi_rresp(m02_sc2axi_M_AXI_RRESP),
        .m_axi_ruser(m02_sc2axi_M_AXI_RUSER),
        .m_axi_rvalid(m02_sc2axi_M_AXI_RVALID),
        .m_axi_wdata(m02_sc2axi_M_AXI_WDATA),
        .m_axi_wlast(m02_sc2axi_M_AXI_WLAST),
        .m_axi_wready(m02_sc2axi_M_AXI_WREADY),
        .m_axi_wstrb(m02_sc2axi_M_AXI_WSTRB),
        .m_axi_wuser(m02_sc2axi_M_AXI_WUSER),
        .m_axi_wvalid(m02_sc2axi_M_AXI_WVALID),
        .m_sc_b_info(S_SC_B_4_INFO),
        .m_sc_b_payld(S_SC_B_4_PAYLD),
        .m_sc_b_recv(S_SC_B_4_RECV),
        .m_sc_b_req(S_SC_B_4_REQ),
        .m_sc_b_send(S_SC_B_4_SEND),
        .m_sc_r_info(S_SC_R_4_INFO),
        .m_sc_r_payld(S_SC_R_4_PAYLD),
        .m_sc_r_recv(S_SC_R_4_RECV),
        .m_sc_r_req(S_SC_R_4_REQ),
        .m_sc_r_send(S_SC_R_4_SEND),
        .s_sc_ar_info(m02_nodes_M_SC_AR_INFO),
        .s_sc_ar_payld(m02_nodes_M_SC_AR_PAYLD),
        .s_sc_ar_recv(m02_nodes_M_SC_AR_RECV),
        .s_sc_ar_req(m02_nodes_M_SC_AR_REQ),
        .s_sc_ar_send(m02_nodes_M_SC_AR_SEND),
        .s_sc_aw_info(m02_nodes_M_SC_AW_INFO),
        .s_sc_aw_payld(m02_nodes_M_SC_AW_PAYLD),
        .s_sc_aw_recv(m02_nodes_M_SC_AW_RECV),
        .s_sc_aw_req(m02_nodes_M_SC_AW_REQ),
        .s_sc_aw_send(m02_nodes_M_SC_AW_SEND),
        .s_sc_w_info(m02_nodes_M_SC_W_INFO),
        .s_sc_w_payld(m02_nodes_M_SC_W_PAYLD),
        .s_sc_w_recv(m02_nodes_M_SC_W_RECV),
        .s_sc_w_req(m02_nodes_M_SC_W_REQ),
        .s_sc_w_send(m02_nodes_M_SC_W_SEND));
  m03_exit_pipeline_imp_6E233V m03_exit_pipeline
       (.aclk(clk_map_M03_ACLK),
        .aresetn(m_axi_aresetn_3),
        .m_axi_araddr(M03_AXI_araddr),
        .m_axi_arprot(M03_AXI_arprot),
        .m_axi_arready(M03_AXI_arready),
        .m_axi_arvalid(M03_AXI_arvalid),
        .m_axi_awaddr(M03_AXI_awaddr),
        .m_axi_awprot(M03_AXI_awprot),
        .m_axi_awready(M03_AXI_awready),
        .m_axi_awvalid(M03_AXI_awvalid),
        .m_axi_bready(M03_AXI_bready),
        .m_axi_bresp(M03_AXI_bresp),
        .m_axi_bvalid(M03_AXI_bvalid),
        .m_axi_rdata(M03_AXI_rdata),
        .m_axi_rready(M03_AXI_rready),
        .m_axi_rresp(M03_AXI_rresp),
        .m_axi_rvalid(M03_AXI_rvalid),
        .m_axi_wdata(M03_AXI_wdata),
        .m_axi_wready(M03_AXI_wready),
        .m_axi_wstrb(M03_AXI_wstrb),
        .m_axi_wvalid(M03_AXI_wvalid),
        .s_axi_araddr(m03_sc2axi_M_AXI_ARADDR),
        .s_axi_arcache(m03_sc2axi_M_AXI_ARCACHE),
        .s_axi_arid(m03_sc2axi_M_AXI_ARID),
        .s_axi_arlen(m03_sc2axi_M_AXI_ARLEN),
        .s_axi_arlock(m03_sc2axi_M_AXI_ARLOCK),
        .s_axi_arprot(m03_sc2axi_M_AXI_ARPROT),
        .s_axi_arqos(m03_sc2axi_M_AXI_ARQOS),
        .s_axi_arready(m03_sc2axi_M_AXI_ARREADY),
        .s_axi_aruser(m03_sc2axi_M_AXI_ARUSER),
        .s_axi_arvalid(m03_sc2axi_M_AXI_ARVALID),
        .s_axi_awaddr(m03_sc2axi_M_AXI_AWADDR),
        .s_axi_awcache(m03_sc2axi_M_AXI_AWCACHE),
        .s_axi_awid(m03_sc2axi_M_AXI_AWID),
        .s_axi_awlen(m03_sc2axi_M_AXI_AWLEN),
        .s_axi_awlock(m03_sc2axi_M_AXI_AWLOCK),
        .s_axi_awprot(m03_sc2axi_M_AXI_AWPROT),
        .s_axi_awqos(m03_sc2axi_M_AXI_AWQOS),
        .s_axi_awready(m03_sc2axi_M_AXI_AWREADY),
        .s_axi_awuser(m03_sc2axi_M_AXI_AWUSER),
        .s_axi_awvalid(m03_sc2axi_M_AXI_AWVALID),
        .s_axi_bid(m03_sc2axi_M_AXI_BID),
        .s_axi_bready(m03_sc2axi_M_AXI_BREADY),
        .s_axi_bresp(m03_sc2axi_M_AXI_BRESP),
        .s_axi_buser(m03_sc2axi_M_AXI_BUSER),
        .s_axi_bvalid(m03_sc2axi_M_AXI_BVALID),
        .s_axi_rdata(m03_sc2axi_M_AXI_RDATA),
        .s_axi_rid(m03_sc2axi_M_AXI_RID),
        .s_axi_rlast(m03_sc2axi_M_AXI_RLAST),
        .s_axi_rready(m03_sc2axi_M_AXI_RREADY),
        .s_axi_rresp(m03_sc2axi_M_AXI_RRESP),
        .s_axi_ruser(m03_sc2axi_M_AXI_RUSER),
        .s_axi_rvalid(m03_sc2axi_M_AXI_RVALID),
        .s_axi_wdata(m03_sc2axi_M_AXI_WDATA),
        .s_axi_wlast(m03_sc2axi_M_AXI_WLAST),
        .s_axi_wready(m03_sc2axi_M_AXI_WREADY),
        .s_axi_wstrb(m03_sc2axi_M_AXI_WSTRB),
        .s_axi_wuser(m03_sc2axi_M_AXI_WUSER),
        .s_axi_wvalid(m03_sc2axi_M_AXI_WVALID));
  m03_nodes_imp_LEW7G m03_nodes
       (.M_SC_AR_info(m03_nodes_M_SC_AR_INFO),
        .M_SC_AR_payld(m03_nodes_M_SC_AR_PAYLD),
        .M_SC_AR_recv(m03_nodes_M_SC_AR_RECV),
        .M_SC_AR_req(m03_nodes_M_SC_AR_REQ),
        .M_SC_AR_send(m03_nodes_M_SC_AR_SEND),
        .M_SC_AW_info(m03_nodes_M_SC_AW_INFO),
        .M_SC_AW_payld(m03_nodes_M_SC_AW_PAYLD),
        .M_SC_AW_recv(m03_nodes_M_SC_AW_RECV),
        .M_SC_AW_req(m03_nodes_M_SC_AW_REQ),
        .M_SC_AW_send(m03_nodes_M_SC_AW_SEND),
        .M_SC_B_info(m03_nodes_M_SC_B_INFO),
        .M_SC_B_payld(m03_nodes_M_SC_B_PAYLD),
        .M_SC_B_recv(m03_nodes_M_SC_B_RECV),
        .M_SC_B_req(m03_nodes_M_SC_B_REQ),
        .M_SC_B_send(m03_nodes_M_SC_B_SEND),
        .M_SC_R_info(m03_nodes_M_SC_R_INFO),
        .M_SC_R_payld(m03_nodes_M_SC_R_PAYLD),
        .M_SC_R_recv(m03_nodes_M_SC_R_RECV),
        .M_SC_R_req(m03_nodes_M_SC_R_REQ),
        .M_SC_R_send(m03_nodes_M_SC_R_SEND),
        .M_SC_W_info(m03_nodes_M_SC_W_INFO),
        .M_SC_W_payld(m03_nodes_M_SC_W_PAYLD),
        .M_SC_W_recv(m03_nodes_M_SC_W_RECV),
        .M_SC_W_req(m03_nodes_M_SC_W_REQ),
        .M_SC_W_send(m03_nodes_M_SC_W_SEND),
        .S_SC_AR_info(S_SC_AR_5_INFO),
        .S_SC_AR_payld(S_SC_AR_5_PAYLD),
        .S_SC_AR_recv(S_SC_AR_5_RECV),
        .S_SC_AR_req(S_SC_AR_5_REQ),
        .S_SC_AR_send(S_SC_AR_5_SEND),
        .S_SC_AW_info(S_SC_AW_5_INFO),
        .S_SC_AW_payld(S_SC_AW_5_PAYLD),
        .S_SC_AW_recv(S_SC_AW_5_RECV),
        .S_SC_AW_req(S_SC_AW_5_REQ),
        .S_SC_AW_send(S_SC_AW_5_SEND),
        .S_SC_B_info(S_SC_B_5_INFO),
        .S_SC_B_payld(S_SC_B_5_PAYLD),
        .S_SC_B_recv(S_SC_B_5_RECV),
        .S_SC_B_req(S_SC_B_5_REQ),
        .S_SC_B_send(S_SC_B_5_SEND),
        .S_SC_R_info(S_SC_R_5_INFO),
        .S_SC_R_payld(S_SC_R_5_PAYLD),
        .S_SC_R_recv(S_SC_R_5_RECV),
        .S_SC_R_req(S_SC_R_5_REQ),
        .S_SC_R_send(S_SC_R_5_SEND),
        .S_SC_W_info(S_SC_W_5_INFO),
        .S_SC_W_payld(S_SC_W_5_PAYLD),
        .S_SC_W_recv(S_SC_W_5_RECV),
        .S_SC_W_req(S_SC_W_5_REQ),
        .S_SC_W_send(S_SC_W_5_SEND),
        .m_axi_aclk(clk_map_M03_ACLK),
        .m_axi_aresetn(m_axi_aresetn_3),
        .s_axi_aclk(clk_map_M00_ACLK),
        .s_axi_aresetn(clk_map_M00_ARESETN));
  bd_48ac_m03s2a_0 m03_sc2axi
       (.aclk(clk_map_M03_ACLK),
        .m_axi_araddr(m03_sc2axi_M_AXI_ARADDR),
        .m_axi_arcache(m03_sc2axi_M_AXI_ARCACHE),
        .m_axi_arid(m03_sc2axi_M_AXI_ARID),
        .m_axi_arlen(m03_sc2axi_M_AXI_ARLEN),
        .m_axi_arlock(m03_sc2axi_M_AXI_ARLOCK),
        .m_axi_arprot(m03_sc2axi_M_AXI_ARPROT),
        .m_axi_arqos(m03_sc2axi_M_AXI_ARQOS),
        .m_axi_arready(m03_sc2axi_M_AXI_ARREADY),
        .m_axi_aruser(m03_sc2axi_M_AXI_ARUSER),
        .m_axi_arvalid(m03_sc2axi_M_AXI_ARVALID),
        .m_axi_awaddr(m03_sc2axi_M_AXI_AWADDR),
        .m_axi_awcache(m03_sc2axi_M_AXI_AWCACHE),
        .m_axi_awid(m03_sc2axi_M_AXI_AWID),
        .m_axi_awlen(m03_sc2axi_M_AXI_AWLEN),
        .m_axi_awlock(m03_sc2axi_M_AXI_AWLOCK),
        .m_axi_awprot(m03_sc2axi_M_AXI_AWPROT),
        .m_axi_awqos(m03_sc2axi_M_AXI_AWQOS),
        .m_axi_awready(m03_sc2axi_M_AXI_AWREADY),
        .m_axi_awuser(m03_sc2axi_M_AXI_AWUSER),
        .m_axi_awvalid(m03_sc2axi_M_AXI_AWVALID),
        .m_axi_bid(m03_sc2axi_M_AXI_BID),
        .m_axi_bready(m03_sc2axi_M_AXI_BREADY),
        .m_axi_bresp(m03_sc2axi_M_AXI_BRESP),
        .m_axi_buser(m03_sc2axi_M_AXI_BUSER),
        .m_axi_bvalid(m03_sc2axi_M_AXI_BVALID),
        .m_axi_rdata(m03_sc2axi_M_AXI_RDATA),
        .m_axi_rid(m03_sc2axi_M_AXI_RID),
        .m_axi_rlast(m03_sc2axi_M_AXI_RLAST),
        .m_axi_rready(m03_sc2axi_M_AXI_RREADY),
        .m_axi_rresp(m03_sc2axi_M_AXI_RRESP),
        .m_axi_ruser(m03_sc2axi_M_AXI_RUSER),
        .m_axi_rvalid(m03_sc2axi_M_AXI_RVALID),
        .m_axi_wdata(m03_sc2axi_M_AXI_WDATA),
        .m_axi_wlast(m03_sc2axi_M_AXI_WLAST),
        .m_axi_wready(m03_sc2axi_M_AXI_WREADY),
        .m_axi_wstrb(m03_sc2axi_M_AXI_WSTRB),
        .m_axi_wuser(m03_sc2axi_M_AXI_WUSER),
        .m_axi_wvalid(m03_sc2axi_M_AXI_WVALID),
        .m_sc_b_info(S_SC_B_5_INFO),
        .m_sc_b_payld(S_SC_B_5_PAYLD),
        .m_sc_b_recv(S_SC_B_5_RECV),
        .m_sc_b_req(S_SC_B_5_REQ),
        .m_sc_b_send(S_SC_B_5_SEND),
        .m_sc_r_info(S_SC_R_5_INFO),
        .m_sc_r_payld(S_SC_R_5_PAYLD),
        .m_sc_r_recv(S_SC_R_5_RECV),
        .m_sc_r_req(S_SC_R_5_REQ),
        .m_sc_r_send(S_SC_R_5_SEND),
        .s_sc_ar_info(m03_nodes_M_SC_AR_INFO),
        .s_sc_ar_payld(m03_nodes_M_SC_AR_PAYLD),
        .s_sc_ar_recv(m03_nodes_M_SC_AR_RECV),
        .s_sc_ar_req(m03_nodes_M_SC_AR_REQ),
        .s_sc_ar_send(m03_nodes_M_SC_AR_SEND),
        .s_sc_aw_info(m03_nodes_M_SC_AW_INFO),
        .s_sc_aw_payld(m03_nodes_M_SC_AW_PAYLD),
        .s_sc_aw_recv(m03_nodes_M_SC_AW_RECV),
        .s_sc_aw_req(m03_nodes_M_SC_AW_REQ),
        .s_sc_aw_send(m03_nodes_M_SC_AW_SEND),
        .s_sc_w_info(m03_nodes_M_SC_W_INFO),
        .s_sc_w_payld(m03_nodes_M_SC_W_PAYLD),
        .s_sc_w_recv(m03_nodes_M_SC_W_RECV),
        .s_sc_w_req(m03_nodes_M_SC_W_REQ),
        .s_sc_w_send(m03_nodes_M_SC_W_SEND));
  m04_exit_pipeline_imp_VUVFY3 m04_exit_pipeline
       (.aclk(clk_map_M04_ACLK),
        .aresetn(m_axi_aresetn_4),
        .m_axi_araddr(M04_AXI_araddr),
        .m_axi_arprot(M04_AXI_arprot),
        .m_axi_arready(M04_AXI_arready),
        .m_axi_arvalid(M04_AXI_arvalid),
        .m_axi_awaddr(M04_AXI_awaddr),
        .m_axi_awprot(M04_AXI_awprot),
        .m_axi_awready(M04_AXI_awready),
        .m_axi_awvalid(M04_AXI_awvalid),
        .m_axi_bready(M04_AXI_bready),
        .m_axi_bresp(M04_AXI_bresp),
        .m_axi_bvalid(M04_AXI_bvalid),
        .m_axi_rdata(M04_AXI_rdata),
        .m_axi_rready(M04_AXI_rready),
        .m_axi_rresp(M04_AXI_rresp),
        .m_axi_rvalid(M04_AXI_rvalid),
        .m_axi_wdata(M04_AXI_wdata),
        .m_axi_wready(M04_AXI_wready),
        .m_axi_wstrb(M04_AXI_wstrb),
        .m_axi_wvalid(M04_AXI_wvalid),
        .s_axi_araddr(m04_sc2axi_M_AXI_ARADDR),
        .s_axi_arcache(m04_sc2axi_M_AXI_ARCACHE),
        .s_axi_arid(m04_sc2axi_M_AXI_ARID),
        .s_axi_arlen(m04_sc2axi_M_AXI_ARLEN),
        .s_axi_arlock(m04_sc2axi_M_AXI_ARLOCK),
        .s_axi_arprot(m04_sc2axi_M_AXI_ARPROT),
        .s_axi_arqos(m04_sc2axi_M_AXI_ARQOS),
        .s_axi_arready(m04_sc2axi_M_AXI_ARREADY),
        .s_axi_aruser(m04_sc2axi_M_AXI_ARUSER),
        .s_axi_arvalid(m04_sc2axi_M_AXI_ARVALID),
        .s_axi_awaddr(m04_sc2axi_M_AXI_AWADDR),
        .s_axi_awcache(m04_sc2axi_M_AXI_AWCACHE),
        .s_axi_awid(m04_sc2axi_M_AXI_AWID),
        .s_axi_awlen(m04_sc2axi_M_AXI_AWLEN),
        .s_axi_awlock(m04_sc2axi_M_AXI_AWLOCK),
        .s_axi_awprot(m04_sc2axi_M_AXI_AWPROT),
        .s_axi_awqos(m04_sc2axi_M_AXI_AWQOS),
        .s_axi_awready(m04_sc2axi_M_AXI_AWREADY),
        .s_axi_awuser(m04_sc2axi_M_AXI_AWUSER),
        .s_axi_awvalid(m04_sc2axi_M_AXI_AWVALID),
        .s_axi_bid(m04_sc2axi_M_AXI_BID),
        .s_axi_bready(m04_sc2axi_M_AXI_BREADY),
        .s_axi_bresp(m04_sc2axi_M_AXI_BRESP),
        .s_axi_buser(m04_sc2axi_M_AXI_BUSER),
        .s_axi_bvalid(m04_sc2axi_M_AXI_BVALID),
        .s_axi_rdata(m04_sc2axi_M_AXI_RDATA),
        .s_axi_rid(m04_sc2axi_M_AXI_RID),
        .s_axi_rlast(m04_sc2axi_M_AXI_RLAST),
        .s_axi_rready(m04_sc2axi_M_AXI_RREADY),
        .s_axi_rresp(m04_sc2axi_M_AXI_RRESP),
        .s_axi_ruser(m04_sc2axi_M_AXI_RUSER),
        .s_axi_rvalid(m04_sc2axi_M_AXI_RVALID),
        .s_axi_wdata(m04_sc2axi_M_AXI_WDATA),
        .s_axi_wlast(m04_sc2axi_M_AXI_WLAST),
        .s_axi_wready(m04_sc2axi_M_AXI_WREADY),
        .s_axi_wstrb(m04_sc2axi_M_AXI_WSTRB),
        .s_axi_wuser(m04_sc2axi_M_AXI_WUSER),
        .s_axi_wvalid(m04_sc2axi_M_AXI_WVALID));
  m04_nodes_imp_STY0R0 m04_nodes
       (.M_SC_AR_info(m04_nodes_M_SC_AR_INFO),
        .M_SC_AR_payld(m04_nodes_M_SC_AR_PAYLD),
        .M_SC_AR_recv(m04_nodes_M_SC_AR_RECV),
        .M_SC_AR_req(m04_nodes_M_SC_AR_REQ),
        .M_SC_AR_send(m04_nodes_M_SC_AR_SEND),
        .M_SC_AW_info(m04_nodes_M_SC_AW_INFO),
        .M_SC_AW_payld(m04_nodes_M_SC_AW_PAYLD),
        .M_SC_AW_recv(m04_nodes_M_SC_AW_RECV),
        .M_SC_AW_req(m04_nodes_M_SC_AW_REQ),
        .M_SC_AW_send(m04_nodes_M_SC_AW_SEND),
        .M_SC_B_info(m04_nodes_M_SC_B_INFO),
        .M_SC_B_payld(m04_nodes_M_SC_B_PAYLD),
        .M_SC_B_recv(m04_nodes_M_SC_B_RECV),
        .M_SC_B_req(m04_nodes_M_SC_B_REQ),
        .M_SC_B_send(m04_nodes_M_SC_B_SEND),
        .M_SC_R_info(m04_nodes_M_SC_R_INFO),
        .M_SC_R_payld(m04_nodes_M_SC_R_PAYLD),
        .M_SC_R_recv(m04_nodes_M_SC_R_RECV),
        .M_SC_R_req(m04_nodes_M_SC_R_REQ),
        .M_SC_R_send(m04_nodes_M_SC_R_SEND),
        .M_SC_W_info(m04_nodes_M_SC_W_INFO),
        .M_SC_W_payld(m04_nodes_M_SC_W_PAYLD),
        .M_SC_W_recv(m04_nodes_M_SC_W_RECV),
        .M_SC_W_req(m04_nodes_M_SC_W_REQ),
        .M_SC_W_send(m04_nodes_M_SC_W_SEND),
        .S_SC_AR_info(S_SC_AR_6_INFO),
        .S_SC_AR_payld(S_SC_AR_6_PAYLD),
        .S_SC_AR_recv(S_SC_AR_6_RECV),
        .S_SC_AR_req(S_SC_AR_6_REQ),
        .S_SC_AR_send(S_SC_AR_6_SEND),
        .S_SC_AW_info(S_SC_AW_6_INFO),
        .S_SC_AW_payld(S_SC_AW_6_PAYLD),
        .S_SC_AW_recv(S_SC_AW_6_RECV),
        .S_SC_AW_req(S_SC_AW_6_REQ),
        .S_SC_AW_send(S_SC_AW_6_SEND),
        .S_SC_B_info(S_SC_B_6_INFO),
        .S_SC_B_payld(S_SC_B_6_PAYLD),
        .S_SC_B_recv(S_SC_B_6_RECV),
        .S_SC_B_req(S_SC_B_6_REQ),
        .S_SC_B_send(S_SC_B_6_SEND),
        .S_SC_R_info(S_SC_R_6_INFO),
        .S_SC_R_payld(S_SC_R_6_PAYLD),
        .S_SC_R_recv(S_SC_R_6_RECV),
        .S_SC_R_req(S_SC_R_6_REQ),
        .S_SC_R_send(S_SC_R_6_SEND),
        .S_SC_W_info(S_SC_W_6_INFO),
        .S_SC_W_payld(S_SC_W_6_PAYLD),
        .S_SC_W_recv(S_SC_W_6_RECV),
        .S_SC_W_req(S_SC_W_6_REQ),
        .S_SC_W_send(S_SC_W_6_SEND),
        .m_axi_aclk(clk_map_M04_ACLK),
        .m_axi_aresetn(m_axi_aresetn_4),
        .s_axi_aclk(clk_map_M00_ACLK),
        .s_axi_aresetn(clk_map_M00_ARESETN));
  bd_48ac_m04s2a_0 m04_sc2axi
       (.aclk(clk_map_M04_ACLK),
        .m_axi_araddr(m04_sc2axi_M_AXI_ARADDR),
        .m_axi_arcache(m04_sc2axi_M_AXI_ARCACHE),
        .m_axi_arid(m04_sc2axi_M_AXI_ARID),
        .m_axi_arlen(m04_sc2axi_M_AXI_ARLEN),
        .m_axi_arlock(m04_sc2axi_M_AXI_ARLOCK),
        .m_axi_arprot(m04_sc2axi_M_AXI_ARPROT),
        .m_axi_arqos(m04_sc2axi_M_AXI_ARQOS),
        .m_axi_arready(m04_sc2axi_M_AXI_ARREADY),
        .m_axi_aruser(m04_sc2axi_M_AXI_ARUSER),
        .m_axi_arvalid(m04_sc2axi_M_AXI_ARVALID),
        .m_axi_awaddr(m04_sc2axi_M_AXI_AWADDR),
        .m_axi_awcache(m04_sc2axi_M_AXI_AWCACHE),
        .m_axi_awid(m04_sc2axi_M_AXI_AWID),
        .m_axi_awlen(m04_sc2axi_M_AXI_AWLEN),
        .m_axi_awlock(m04_sc2axi_M_AXI_AWLOCK),
        .m_axi_awprot(m04_sc2axi_M_AXI_AWPROT),
        .m_axi_awqos(m04_sc2axi_M_AXI_AWQOS),
        .m_axi_awready(m04_sc2axi_M_AXI_AWREADY),
        .m_axi_awuser(m04_sc2axi_M_AXI_AWUSER),
        .m_axi_awvalid(m04_sc2axi_M_AXI_AWVALID),
        .m_axi_bid(m04_sc2axi_M_AXI_BID),
        .m_axi_bready(m04_sc2axi_M_AXI_BREADY),
        .m_axi_bresp(m04_sc2axi_M_AXI_BRESP),
        .m_axi_buser(m04_sc2axi_M_AXI_BUSER),
        .m_axi_bvalid(m04_sc2axi_M_AXI_BVALID),
        .m_axi_rdata(m04_sc2axi_M_AXI_RDATA),
        .m_axi_rid(m04_sc2axi_M_AXI_RID),
        .m_axi_rlast(m04_sc2axi_M_AXI_RLAST),
        .m_axi_rready(m04_sc2axi_M_AXI_RREADY),
        .m_axi_rresp(m04_sc2axi_M_AXI_RRESP),
        .m_axi_ruser(m04_sc2axi_M_AXI_RUSER),
        .m_axi_rvalid(m04_sc2axi_M_AXI_RVALID),
        .m_axi_wdata(m04_sc2axi_M_AXI_WDATA),
        .m_axi_wlast(m04_sc2axi_M_AXI_WLAST),
        .m_axi_wready(m04_sc2axi_M_AXI_WREADY),
        .m_axi_wstrb(m04_sc2axi_M_AXI_WSTRB),
        .m_axi_wuser(m04_sc2axi_M_AXI_WUSER),
        .m_axi_wvalid(m04_sc2axi_M_AXI_WVALID),
        .m_sc_b_info(S_SC_B_6_INFO),
        .m_sc_b_payld(S_SC_B_6_PAYLD),
        .m_sc_b_recv(S_SC_B_6_RECV),
        .m_sc_b_req(S_SC_B_6_REQ),
        .m_sc_b_send(S_SC_B_6_SEND),
        .m_sc_r_info(S_SC_R_6_INFO),
        .m_sc_r_payld(S_SC_R_6_PAYLD),
        .m_sc_r_recv(S_SC_R_6_RECV),
        .m_sc_r_req(S_SC_R_6_REQ),
        .m_sc_r_send(S_SC_R_6_SEND),
        .s_sc_ar_info(m04_nodes_M_SC_AR_INFO),
        .s_sc_ar_payld(m04_nodes_M_SC_AR_PAYLD),
        .s_sc_ar_recv(m04_nodes_M_SC_AR_RECV),
        .s_sc_ar_req(m04_nodes_M_SC_AR_REQ),
        .s_sc_ar_send(m04_nodes_M_SC_AR_SEND),
        .s_sc_aw_info(m04_nodes_M_SC_AW_INFO),
        .s_sc_aw_payld(m04_nodes_M_SC_AW_PAYLD),
        .s_sc_aw_recv(m04_nodes_M_SC_AW_RECV),
        .s_sc_aw_req(m04_nodes_M_SC_AW_REQ),
        .s_sc_aw_send(m04_nodes_M_SC_AW_SEND),
        .s_sc_w_info(m04_nodes_M_SC_W_INFO),
        .s_sc_w_payld(m04_nodes_M_SC_W_PAYLD),
        .s_sc_w_recv(m04_nodes_M_SC_W_RECV),
        .s_sc_w_req(m04_nodes_M_SC_W_REQ),
        .s_sc_w_send(m04_nodes_M_SC_W_SEND));
  m05_exit_pipeline_imp_SALEWR m05_exit_pipeline
       (.aclk(clk_map_M05_ACLK),
        .aresetn(m_axi_aresetn_5),
        .m_axi_araddr(M05_AXI_araddr),
        .m_axi_arprot(M05_AXI_arprot),
        .m_axi_arready(M05_AXI_arready),
        .m_axi_arvalid(M05_AXI_arvalid),
        .m_axi_awaddr(M05_AXI_awaddr),
        .m_axi_awprot(M05_AXI_awprot),
        .m_axi_awready(M05_AXI_awready),
        .m_axi_awvalid(M05_AXI_awvalid),
        .m_axi_bready(M05_AXI_bready),
        .m_axi_bresp(M05_AXI_bresp),
        .m_axi_bvalid(M05_AXI_bvalid),
        .m_axi_rdata(M05_AXI_rdata),
        .m_axi_rready(M05_AXI_rready),
        .m_axi_rresp(M05_AXI_rresp),
        .m_axi_rvalid(M05_AXI_rvalid),
        .m_axi_wdata(M05_AXI_wdata),
        .m_axi_wready(M05_AXI_wready),
        .m_axi_wstrb(M05_AXI_wstrb),
        .m_axi_wvalid(M05_AXI_wvalid),
        .s_axi_araddr(m05_sc2axi_M_AXI_ARADDR),
        .s_axi_arcache(m05_sc2axi_M_AXI_ARCACHE),
        .s_axi_arid(m05_sc2axi_M_AXI_ARID),
        .s_axi_arlen(m05_sc2axi_M_AXI_ARLEN),
        .s_axi_arlock(m05_sc2axi_M_AXI_ARLOCK),
        .s_axi_arprot(m05_sc2axi_M_AXI_ARPROT),
        .s_axi_arqos(m05_sc2axi_M_AXI_ARQOS),
        .s_axi_arready(m05_sc2axi_M_AXI_ARREADY),
        .s_axi_aruser(m05_sc2axi_M_AXI_ARUSER),
        .s_axi_arvalid(m05_sc2axi_M_AXI_ARVALID),
        .s_axi_awaddr(m05_sc2axi_M_AXI_AWADDR),
        .s_axi_awcache(m05_sc2axi_M_AXI_AWCACHE),
        .s_axi_awid(m05_sc2axi_M_AXI_AWID),
        .s_axi_awlen(m05_sc2axi_M_AXI_AWLEN),
        .s_axi_awlock(m05_sc2axi_M_AXI_AWLOCK),
        .s_axi_awprot(m05_sc2axi_M_AXI_AWPROT),
        .s_axi_awqos(m05_sc2axi_M_AXI_AWQOS),
        .s_axi_awready(m05_sc2axi_M_AXI_AWREADY),
        .s_axi_awuser(m05_sc2axi_M_AXI_AWUSER),
        .s_axi_awvalid(m05_sc2axi_M_AXI_AWVALID),
        .s_axi_bid(m05_sc2axi_M_AXI_BID),
        .s_axi_bready(m05_sc2axi_M_AXI_BREADY),
        .s_axi_bresp(m05_sc2axi_M_AXI_BRESP),
        .s_axi_buser(m05_sc2axi_M_AXI_BUSER),
        .s_axi_bvalid(m05_sc2axi_M_AXI_BVALID),
        .s_axi_rdata(m05_sc2axi_M_AXI_RDATA),
        .s_axi_rid(m05_sc2axi_M_AXI_RID),
        .s_axi_rlast(m05_sc2axi_M_AXI_RLAST),
        .s_axi_rready(m05_sc2axi_M_AXI_RREADY),
        .s_axi_rresp(m05_sc2axi_M_AXI_RRESP),
        .s_axi_ruser(m05_sc2axi_M_AXI_RUSER),
        .s_axi_rvalid(m05_sc2axi_M_AXI_RVALID),
        .s_axi_wdata(m05_sc2axi_M_AXI_WDATA),
        .s_axi_wlast(m05_sc2axi_M_AXI_WLAST),
        .s_axi_wready(m05_sc2axi_M_AXI_WREADY),
        .s_axi_wstrb(m05_sc2axi_M_AXI_WSTRB),
        .s_axi_wuser(m05_sc2axi_M_AXI_WUSER),
        .s_axi_wvalid(m05_sc2axi_M_AXI_WVALID));
  m05_nodes_imp_1XM6AEY m05_nodes
       (.M_SC_AR_info(m05_nodes_M_SC_AR_INFO),
        .M_SC_AR_payld(m05_nodes_M_SC_AR_PAYLD),
        .M_SC_AR_recv(m05_nodes_M_SC_AR_RECV),
        .M_SC_AR_req(m05_nodes_M_SC_AR_REQ),
        .M_SC_AR_send(m05_nodes_M_SC_AR_SEND),
        .M_SC_AW_info(m05_nodes_M_SC_AW_INFO),
        .M_SC_AW_payld(m05_nodes_M_SC_AW_PAYLD),
        .M_SC_AW_recv(m05_nodes_M_SC_AW_RECV),
        .M_SC_AW_req(m05_nodes_M_SC_AW_REQ),
        .M_SC_AW_send(m05_nodes_M_SC_AW_SEND),
        .M_SC_B_info(m05_nodes_M_SC_B_INFO),
        .M_SC_B_payld(m05_nodes_M_SC_B_PAYLD),
        .M_SC_B_recv(m05_nodes_M_SC_B_RECV),
        .M_SC_B_req(m05_nodes_M_SC_B_REQ),
        .M_SC_B_send(m05_nodes_M_SC_B_SEND),
        .M_SC_R_info(m05_nodes_M_SC_R_INFO),
        .M_SC_R_payld(m05_nodes_M_SC_R_PAYLD),
        .M_SC_R_recv(m05_nodes_M_SC_R_RECV),
        .M_SC_R_req(m05_nodes_M_SC_R_REQ),
        .M_SC_R_send(m05_nodes_M_SC_R_SEND),
        .M_SC_W_info(m05_nodes_M_SC_W_INFO),
        .M_SC_W_payld(m05_nodes_M_SC_W_PAYLD),
        .M_SC_W_recv(m05_nodes_M_SC_W_RECV),
        .M_SC_W_req(m05_nodes_M_SC_W_REQ),
        .M_SC_W_send(m05_nodes_M_SC_W_SEND),
        .S_SC_AR_info(S_SC_AR_7_INFO),
        .S_SC_AR_payld(S_SC_AR_7_PAYLD),
        .S_SC_AR_recv(S_SC_AR_7_RECV),
        .S_SC_AR_req(S_SC_AR_7_REQ),
        .S_SC_AR_send(S_SC_AR_7_SEND),
        .S_SC_AW_info(S_SC_AW_7_INFO),
        .S_SC_AW_payld(S_SC_AW_7_PAYLD),
        .S_SC_AW_recv(S_SC_AW_7_RECV),
        .S_SC_AW_req(S_SC_AW_7_REQ),
        .S_SC_AW_send(S_SC_AW_7_SEND),
        .S_SC_B_info(S_SC_B_7_INFO),
        .S_SC_B_payld(S_SC_B_7_PAYLD),
        .S_SC_B_recv(S_SC_B_7_RECV),
        .S_SC_B_req(S_SC_B_7_REQ),
        .S_SC_B_send(S_SC_B_7_SEND),
        .S_SC_R_info(S_SC_R_7_INFO),
        .S_SC_R_payld(S_SC_R_7_PAYLD),
        .S_SC_R_recv(S_SC_R_7_RECV),
        .S_SC_R_req(S_SC_R_7_REQ),
        .S_SC_R_send(S_SC_R_7_SEND),
        .S_SC_W_info(S_SC_W_7_INFO),
        .S_SC_W_payld(S_SC_W_7_PAYLD),
        .S_SC_W_recv(S_SC_W_7_RECV),
        .S_SC_W_req(S_SC_W_7_REQ),
        .S_SC_W_send(S_SC_W_7_SEND),
        .m_axi_aclk(clk_map_M05_ACLK),
        .m_axi_aresetn(m_axi_aresetn_5),
        .s_axi_aclk(clk_map_M00_ACLK),
        .s_axi_aresetn(clk_map_M00_ARESETN));
  bd_48ac_m05s2a_0 m05_sc2axi
       (.aclk(clk_map_M05_ACLK),
        .m_axi_araddr(m05_sc2axi_M_AXI_ARADDR),
        .m_axi_arcache(m05_sc2axi_M_AXI_ARCACHE),
        .m_axi_arid(m05_sc2axi_M_AXI_ARID),
        .m_axi_arlen(m05_sc2axi_M_AXI_ARLEN),
        .m_axi_arlock(m05_sc2axi_M_AXI_ARLOCK),
        .m_axi_arprot(m05_sc2axi_M_AXI_ARPROT),
        .m_axi_arqos(m05_sc2axi_M_AXI_ARQOS),
        .m_axi_arready(m05_sc2axi_M_AXI_ARREADY),
        .m_axi_aruser(m05_sc2axi_M_AXI_ARUSER),
        .m_axi_arvalid(m05_sc2axi_M_AXI_ARVALID),
        .m_axi_awaddr(m05_sc2axi_M_AXI_AWADDR),
        .m_axi_awcache(m05_sc2axi_M_AXI_AWCACHE),
        .m_axi_awid(m05_sc2axi_M_AXI_AWID),
        .m_axi_awlen(m05_sc2axi_M_AXI_AWLEN),
        .m_axi_awlock(m05_sc2axi_M_AXI_AWLOCK),
        .m_axi_awprot(m05_sc2axi_M_AXI_AWPROT),
        .m_axi_awqos(m05_sc2axi_M_AXI_AWQOS),
        .m_axi_awready(m05_sc2axi_M_AXI_AWREADY),
        .m_axi_awuser(m05_sc2axi_M_AXI_AWUSER),
        .m_axi_awvalid(m05_sc2axi_M_AXI_AWVALID),
        .m_axi_bid(m05_sc2axi_M_AXI_BID),
        .m_axi_bready(m05_sc2axi_M_AXI_BREADY),
        .m_axi_bresp(m05_sc2axi_M_AXI_BRESP),
        .m_axi_buser(m05_sc2axi_M_AXI_BUSER),
        .m_axi_bvalid(m05_sc2axi_M_AXI_BVALID),
        .m_axi_rdata(m05_sc2axi_M_AXI_RDATA),
        .m_axi_rid(m05_sc2axi_M_AXI_RID),
        .m_axi_rlast(m05_sc2axi_M_AXI_RLAST),
        .m_axi_rready(m05_sc2axi_M_AXI_RREADY),
        .m_axi_rresp(m05_sc2axi_M_AXI_RRESP),
        .m_axi_ruser(m05_sc2axi_M_AXI_RUSER),
        .m_axi_rvalid(m05_sc2axi_M_AXI_RVALID),
        .m_axi_wdata(m05_sc2axi_M_AXI_WDATA),
        .m_axi_wlast(m05_sc2axi_M_AXI_WLAST),
        .m_axi_wready(m05_sc2axi_M_AXI_WREADY),
        .m_axi_wstrb(m05_sc2axi_M_AXI_WSTRB),
        .m_axi_wuser(m05_sc2axi_M_AXI_WUSER),
        .m_axi_wvalid(m05_sc2axi_M_AXI_WVALID),
        .m_sc_b_info(S_SC_B_7_INFO),
        .m_sc_b_payld(S_SC_B_7_PAYLD),
        .m_sc_b_recv(S_SC_B_7_RECV),
        .m_sc_b_req(S_SC_B_7_REQ),
        .m_sc_b_send(S_SC_B_7_SEND),
        .m_sc_r_info(S_SC_R_7_INFO),
        .m_sc_r_payld(S_SC_R_7_PAYLD),
        .m_sc_r_recv(S_SC_R_7_RECV),
        .m_sc_r_req(S_SC_R_7_REQ),
        .m_sc_r_send(S_SC_R_7_SEND),
        .s_sc_ar_info(m05_nodes_M_SC_AR_INFO),
        .s_sc_ar_payld(m05_nodes_M_SC_AR_PAYLD),
        .s_sc_ar_recv(m05_nodes_M_SC_AR_RECV),
        .s_sc_ar_req(m05_nodes_M_SC_AR_REQ),
        .s_sc_ar_send(m05_nodes_M_SC_AR_SEND),
        .s_sc_aw_info(m05_nodes_M_SC_AW_INFO),
        .s_sc_aw_payld(m05_nodes_M_SC_AW_PAYLD),
        .s_sc_aw_recv(m05_nodes_M_SC_AW_RECV),
        .s_sc_aw_req(m05_nodes_M_SC_AW_REQ),
        .s_sc_aw_send(m05_nodes_M_SC_AW_SEND),
        .s_sc_w_info(m05_nodes_M_SC_W_INFO),
        .s_sc_w_payld(m05_nodes_M_SC_W_PAYLD),
        .s_sc_w_recv(m05_nodes_M_SC_W_RECV),
        .s_sc_w_req(m05_nodes_M_SC_W_REQ),
        .s_sc_w_send(m05_nodes_M_SC_W_SEND));
  m06_exit_pipeline_imp_PO10QJ m06_exit_pipeline
       (.aclk(clk_map_M06_ACLK),
        .aresetn(m_axi_aresetn_6),
        .m_axi_araddr(M06_AXI_araddr),
        .m_axi_arprot(M06_AXI_arprot),
        .m_axi_arready(M06_AXI_arready),
        .m_axi_arvalid(M06_AXI_arvalid),
        .m_axi_awaddr(M06_AXI_awaddr),
        .m_axi_awprot(M06_AXI_awprot),
        .m_axi_awready(M06_AXI_awready),
        .m_axi_awvalid(M06_AXI_awvalid),
        .m_axi_bready(M06_AXI_bready),
        .m_axi_bresp(M06_AXI_bresp),
        .m_axi_bvalid(M06_AXI_bvalid),
        .m_axi_rdata(M06_AXI_rdata),
        .m_axi_rready(M06_AXI_rready),
        .m_axi_rresp(M06_AXI_rresp),
        .m_axi_rvalid(M06_AXI_rvalid),
        .m_axi_wdata(M06_AXI_wdata),
        .m_axi_wready(M06_AXI_wready),
        .m_axi_wstrb(M06_AXI_wstrb),
        .m_axi_wvalid(M06_AXI_wvalid),
        .s_axi_araddr(m06_sc2axi_M_AXI_ARADDR),
        .s_axi_arcache(m06_sc2axi_M_AXI_ARCACHE),
        .s_axi_arid(m06_sc2axi_M_AXI_ARID),
        .s_axi_arlen(m06_sc2axi_M_AXI_ARLEN),
        .s_axi_arlock(m06_sc2axi_M_AXI_ARLOCK),
        .s_axi_arprot(m06_sc2axi_M_AXI_ARPROT),
        .s_axi_arqos(m06_sc2axi_M_AXI_ARQOS),
        .s_axi_arready(m06_sc2axi_M_AXI_ARREADY),
        .s_axi_aruser(m06_sc2axi_M_AXI_ARUSER),
        .s_axi_arvalid(m06_sc2axi_M_AXI_ARVALID),
        .s_axi_awaddr(m06_sc2axi_M_AXI_AWADDR),
        .s_axi_awcache(m06_sc2axi_M_AXI_AWCACHE),
        .s_axi_awid(m06_sc2axi_M_AXI_AWID),
        .s_axi_awlen(m06_sc2axi_M_AXI_AWLEN),
        .s_axi_awlock(m06_sc2axi_M_AXI_AWLOCK),
        .s_axi_awprot(m06_sc2axi_M_AXI_AWPROT),
        .s_axi_awqos(m06_sc2axi_M_AXI_AWQOS),
        .s_axi_awready(m06_sc2axi_M_AXI_AWREADY),
        .s_axi_awuser(m06_sc2axi_M_AXI_AWUSER),
        .s_axi_awvalid(m06_sc2axi_M_AXI_AWVALID),
        .s_axi_bid(m06_sc2axi_M_AXI_BID),
        .s_axi_bready(m06_sc2axi_M_AXI_BREADY),
        .s_axi_bresp(m06_sc2axi_M_AXI_BRESP),
        .s_axi_buser(m06_sc2axi_M_AXI_BUSER),
        .s_axi_bvalid(m06_sc2axi_M_AXI_BVALID),
        .s_axi_rdata(m06_sc2axi_M_AXI_RDATA),
        .s_axi_rid(m06_sc2axi_M_AXI_RID),
        .s_axi_rlast(m06_sc2axi_M_AXI_RLAST),
        .s_axi_rready(m06_sc2axi_M_AXI_RREADY),
        .s_axi_rresp(m06_sc2axi_M_AXI_RRESP),
        .s_axi_ruser(m06_sc2axi_M_AXI_RUSER),
        .s_axi_rvalid(m06_sc2axi_M_AXI_RVALID),
        .s_axi_wdata(m06_sc2axi_M_AXI_WDATA),
        .s_axi_wlast(m06_sc2axi_M_AXI_WLAST),
        .s_axi_wready(m06_sc2axi_M_AXI_WREADY),
        .s_axi_wstrb(m06_sc2axi_M_AXI_WSTRB),
        .s_axi_wuser(m06_sc2axi_M_AXI_WUSER),
        .s_axi_wvalid(m06_sc2axi_M_AXI_WVALID));
  m06_nodes_imp_11BS3XD m06_nodes
       (.M_SC_AR_info(m06_nodes_M_SC_AR_INFO),
        .M_SC_AR_payld(m06_nodes_M_SC_AR_PAYLD),
        .M_SC_AR_recv(m06_nodes_M_SC_AR_RECV),
        .M_SC_AR_req(m06_nodes_M_SC_AR_REQ),
        .M_SC_AR_send(m06_nodes_M_SC_AR_SEND),
        .M_SC_AW_info(m06_nodes_M_SC_AW_INFO),
        .M_SC_AW_payld(m06_nodes_M_SC_AW_PAYLD),
        .M_SC_AW_recv(m06_nodes_M_SC_AW_RECV),
        .M_SC_AW_req(m06_nodes_M_SC_AW_REQ),
        .M_SC_AW_send(m06_nodes_M_SC_AW_SEND),
        .M_SC_B_info(m06_nodes_M_SC_B_INFO),
        .M_SC_B_payld(m06_nodes_M_SC_B_PAYLD),
        .M_SC_B_recv(m06_nodes_M_SC_B_RECV),
        .M_SC_B_req(m06_nodes_M_SC_B_REQ),
        .M_SC_B_send(m06_nodes_M_SC_B_SEND),
        .M_SC_R_info(m06_nodes_M_SC_R_INFO),
        .M_SC_R_payld(m06_nodes_M_SC_R_PAYLD),
        .M_SC_R_recv(m06_nodes_M_SC_R_RECV),
        .M_SC_R_req(m06_nodes_M_SC_R_REQ),
        .M_SC_R_send(m06_nodes_M_SC_R_SEND),
        .M_SC_W_info(m06_nodes_M_SC_W_INFO),
        .M_SC_W_payld(m06_nodes_M_SC_W_PAYLD),
        .M_SC_W_recv(m06_nodes_M_SC_W_RECV),
        .M_SC_W_req(m06_nodes_M_SC_W_REQ),
        .M_SC_W_send(m06_nodes_M_SC_W_SEND),
        .S_SC_AR_info(S_SC_AR_8_INFO),
        .S_SC_AR_payld(S_SC_AR_8_PAYLD),
        .S_SC_AR_recv(S_SC_AR_8_RECV),
        .S_SC_AR_req(S_SC_AR_8_REQ),
        .S_SC_AR_send(S_SC_AR_8_SEND),
        .S_SC_AW_info(S_SC_AW_8_INFO),
        .S_SC_AW_payld(S_SC_AW_8_PAYLD),
        .S_SC_AW_recv(S_SC_AW_8_RECV),
        .S_SC_AW_req(S_SC_AW_8_REQ),
        .S_SC_AW_send(S_SC_AW_8_SEND),
        .S_SC_B_info(S_SC_B_8_INFO),
        .S_SC_B_payld(S_SC_B_8_PAYLD),
        .S_SC_B_recv(S_SC_B_8_RECV),
        .S_SC_B_req(S_SC_B_8_REQ),
        .S_SC_B_send(S_SC_B_8_SEND),
        .S_SC_R_info(S_SC_R_8_INFO),
        .S_SC_R_payld(S_SC_R_8_PAYLD),
        .S_SC_R_recv(S_SC_R_8_RECV),
        .S_SC_R_req(S_SC_R_8_REQ),
        .S_SC_R_send(S_SC_R_8_SEND),
        .S_SC_W_info(S_SC_W_8_INFO),
        .S_SC_W_payld(S_SC_W_8_PAYLD),
        .S_SC_W_recv(S_SC_W_8_RECV),
        .S_SC_W_req(S_SC_W_8_REQ),
        .S_SC_W_send(S_SC_W_8_SEND),
        .m_axi_aclk(clk_map_M06_ACLK),
        .m_axi_aresetn(m_axi_aresetn_6),
        .s_axi_aclk(clk_map_M00_ACLK),
        .s_axi_aresetn(clk_map_M00_ARESETN));
  bd_48ac_m06s2a_0 m06_sc2axi
       (.aclk(clk_map_M06_ACLK),
        .m_axi_araddr(m06_sc2axi_M_AXI_ARADDR),
        .m_axi_arcache(m06_sc2axi_M_AXI_ARCACHE),
        .m_axi_arid(m06_sc2axi_M_AXI_ARID),
        .m_axi_arlen(m06_sc2axi_M_AXI_ARLEN),
        .m_axi_arlock(m06_sc2axi_M_AXI_ARLOCK),
        .m_axi_arprot(m06_sc2axi_M_AXI_ARPROT),
        .m_axi_arqos(m06_sc2axi_M_AXI_ARQOS),
        .m_axi_arready(m06_sc2axi_M_AXI_ARREADY),
        .m_axi_aruser(m06_sc2axi_M_AXI_ARUSER),
        .m_axi_arvalid(m06_sc2axi_M_AXI_ARVALID),
        .m_axi_awaddr(m06_sc2axi_M_AXI_AWADDR),
        .m_axi_awcache(m06_sc2axi_M_AXI_AWCACHE),
        .m_axi_awid(m06_sc2axi_M_AXI_AWID),
        .m_axi_awlen(m06_sc2axi_M_AXI_AWLEN),
        .m_axi_awlock(m06_sc2axi_M_AXI_AWLOCK),
        .m_axi_awprot(m06_sc2axi_M_AXI_AWPROT),
        .m_axi_awqos(m06_sc2axi_M_AXI_AWQOS),
        .m_axi_awready(m06_sc2axi_M_AXI_AWREADY),
        .m_axi_awuser(m06_sc2axi_M_AXI_AWUSER),
        .m_axi_awvalid(m06_sc2axi_M_AXI_AWVALID),
        .m_axi_bid(m06_sc2axi_M_AXI_BID),
        .m_axi_bready(m06_sc2axi_M_AXI_BREADY),
        .m_axi_bresp(m06_sc2axi_M_AXI_BRESP),
        .m_axi_buser(m06_sc2axi_M_AXI_BUSER),
        .m_axi_bvalid(m06_sc2axi_M_AXI_BVALID),
        .m_axi_rdata(m06_sc2axi_M_AXI_RDATA),
        .m_axi_rid(m06_sc2axi_M_AXI_RID),
        .m_axi_rlast(m06_sc2axi_M_AXI_RLAST),
        .m_axi_rready(m06_sc2axi_M_AXI_RREADY),
        .m_axi_rresp(m06_sc2axi_M_AXI_RRESP),
        .m_axi_ruser(m06_sc2axi_M_AXI_RUSER),
        .m_axi_rvalid(m06_sc2axi_M_AXI_RVALID),
        .m_axi_wdata(m06_sc2axi_M_AXI_WDATA),
        .m_axi_wlast(m06_sc2axi_M_AXI_WLAST),
        .m_axi_wready(m06_sc2axi_M_AXI_WREADY),
        .m_axi_wstrb(m06_sc2axi_M_AXI_WSTRB),
        .m_axi_wuser(m06_sc2axi_M_AXI_WUSER),
        .m_axi_wvalid(m06_sc2axi_M_AXI_WVALID),
        .m_sc_b_info(S_SC_B_8_INFO),
        .m_sc_b_payld(S_SC_B_8_PAYLD),
        .m_sc_b_recv(S_SC_B_8_RECV),
        .m_sc_b_req(S_SC_B_8_REQ),
        .m_sc_b_send(S_SC_B_8_SEND),
        .m_sc_r_info(S_SC_R_8_INFO),
        .m_sc_r_payld(S_SC_R_8_PAYLD),
        .m_sc_r_recv(S_SC_R_8_RECV),
        .m_sc_r_req(S_SC_R_8_REQ),
        .m_sc_r_send(S_SC_R_8_SEND),
        .s_sc_ar_info(m06_nodes_M_SC_AR_INFO),
        .s_sc_ar_payld(m06_nodes_M_SC_AR_PAYLD),
        .s_sc_ar_recv(m06_nodes_M_SC_AR_RECV),
        .s_sc_ar_req(m06_nodes_M_SC_AR_REQ),
        .s_sc_ar_send(m06_nodes_M_SC_AR_SEND),
        .s_sc_aw_info(m06_nodes_M_SC_AW_INFO),
        .s_sc_aw_payld(m06_nodes_M_SC_AW_PAYLD),
        .s_sc_aw_recv(m06_nodes_M_SC_AW_RECV),
        .s_sc_aw_req(m06_nodes_M_SC_AW_REQ),
        .s_sc_aw_send(m06_nodes_M_SC_AW_SEND),
        .s_sc_w_info(m06_nodes_M_SC_W_INFO),
        .s_sc_w_payld(m06_nodes_M_SC_W_PAYLD),
        .s_sc_w_recv(m06_nodes_M_SC_W_RECV),
        .s_sc_w_req(m06_nodes_M_SC_W_REQ),
        .s_sc_w_send(m06_nodes_M_SC_W_SEND));
  bd_48ac_s00a2s_0 s00_axi2sc
       (.aclk(clk_map_S00_ACLK),
        .m_sc_ar_info(S_SC_AR_1_INFO),
        .m_sc_ar_payld(S_SC_AR_1_PAYLD),
        .m_sc_ar_recv(S_SC_AR_1_RECV),
        .m_sc_ar_req(S_SC_AR_1_REQ),
        .m_sc_ar_send(S_SC_AR_1_SEND),
        .m_sc_aw_info(S_SC_AW_1_INFO),
        .m_sc_aw_payld(S_SC_AW_1_PAYLD),
        .m_sc_aw_recv(S_SC_AW_1_RECV),
        .m_sc_aw_req(S_SC_AW_1_REQ),
        .m_sc_aw_send(S_SC_AW_1_SEND),
        .m_sc_w_info(S_SC_W_1_INFO),
        .m_sc_w_payld(S_SC_W_1_PAYLD),
        .m_sc_w_recv(S_SC_W_1_RECV),
        .m_sc_w_req(S_SC_W_1_REQ),
        .m_sc_w_send(S_SC_W_1_SEND),
        .s_axi_araddr(s00_entry_pipeline_m_axi_ARADDR),
        .s_axi_arcache(s00_entry_pipeline_m_axi_ARCACHE),
        .s_axi_arid(s00_entry_pipeline_m_axi_ARID),
        .s_axi_arlen(s00_entry_pipeline_m_axi_ARLEN),
        .s_axi_arlock(s00_entry_pipeline_m_axi_ARLOCK),
        .s_axi_arprot(s00_entry_pipeline_m_axi_ARPROT),
        .s_axi_arqos(s00_entry_pipeline_m_axi_ARQOS),
        .s_axi_arready(s00_entry_pipeline_m_axi_ARREADY),
        .s_axi_aruser(s00_entry_pipeline_m_axi_ARUSER),
        .s_axi_arvalid(s00_entry_pipeline_m_axi_ARVALID),
        .s_axi_awaddr(s00_entry_pipeline_m_axi_AWADDR),
        .s_axi_awcache(s00_entry_pipeline_m_axi_AWCACHE),
        .s_axi_awid(s00_entry_pipeline_m_axi_AWID),
        .s_axi_awlen(s00_entry_pipeline_m_axi_AWLEN),
        .s_axi_awlock(s00_entry_pipeline_m_axi_AWLOCK),
        .s_axi_awprot(s00_entry_pipeline_m_axi_AWPROT),
        .s_axi_awqos(s00_entry_pipeline_m_axi_AWQOS),
        .s_axi_awready(s00_entry_pipeline_m_axi_AWREADY),
        .s_axi_awuser(s00_entry_pipeline_m_axi_AWUSER),
        .s_axi_awvalid(s00_entry_pipeline_m_axi_AWVALID),
        .s_axi_bid(s00_entry_pipeline_m_axi_BID),
        .s_axi_bready(s00_entry_pipeline_m_axi_BREADY),
        .s_axi_bresp(s00_entry_pipeline_m_axi_BRESP),
        .s_axi_buser(s00_entry_pipeline_m_axi_BUSER),
        .s_axi_bvalid(s00_entry_pipeline_m_axi_BVALID),
        .s_axi_rdata(s00_entry_pipeline_m_axi_RDATA),
        .s_axi_rid(s00_entry_pipeline_m_axi_RID),
        .s_axi_rlast(s00_entry_pipeline_m_axi_RLAST),
        .s_axi_rready(s00_entry_pipeline_m_axi_RREADY),
        .s_axi_rresp(s00_entry_pipeline_m_axi_RRESP),
        .s_axi_ruser(s00_entry_pipeline_m_axi_RUSER),
        .s_axi_rvalid(s00_entry_pipeline_m_axi_RVALID),
        .s_axi_wdata(s00_entry_pipeline_m_axi_WDATA),
        .s_axi_wlast(s00_entry_pipeline_m_axi_WLAST),
        .s_axi_wready(s00_entry_pipeline_m_axi_WREADY),
        .s_axi_wstrb(s00_entry_pipeline_m_axi_WSTRB),
        .s_axi_wuser(s00_entry_pipeline_m_axi_WUSER),
        .s_axi_wvalid(s00_entry_pipeline_m_axi_WVALID),
        .s_sc_b_info(s00_nodes_M_SC_B_INFO),
        .s_sc_b_payld(s00_nodes_M_SC_B_PAYLD),
        .s_sc_b_recv(s00_nodes_M_SC_B_RECV),
        .s_sc_b_req(s00_nodes_M_SC_B_REQ),
        .s_sc_b_send(s00_nodes_M_SC_B_SEND),
        .s_sc_r_info(s00_nodes_M_SC_R_INFO),
        .s_sc_r_payld(s00_nodes_M_SC_R_PAYLD),
        .s_sc_r_recv(s00_nodes_M_SC_R_RECV),
        .s_sc_r_req(s00_nodes_M_SC_R_REQ),
        .s_sc_r_send(s00_nodes_M_SC_R_SEND));
  s00_entry_pipeline_imp_1C3JDRS s00_entry_pipeline
       (.aclk(clk_map_S00_ACLK),
        .aresetn(clk_map_S00_ARESETN),
        .m_axi_araddr(s00_entry_pipeline_m_axi_ARADDR),
        .m_axi_arcache(s00_entry_pipeline_m_axi_ARCACHE),
        .m_axi_arid(s00_entry_pipeline_m_axi_ARID),
        .m_axi_arlen(s00_entry_pipeline_m_axi_ARLEN),
        .m_axi_arlock(s00_entry_pipeline_m_axi_ARLOCK),
        .m_axi_arprot(s00_entry_pipeline_m_axi_ARPROT),
        .m_axi_arqos(s00_entry_pipeline_m_axi_ARQOS),
        .m_axi_arready(s00_entry_pipeline_m_axi_ARREADY),
        .m_axi_aruser(s00_entry_pipeline_m_axi_ARUSER),
        .m_axi_arvalid(s00_entry_pipeline_m_axi_ARVALID),
        .m_axi_awaddr(s00_entry_pipeline_m_axi_AWADDR),
        .m_axi_awcache(s00_entry_pipeline_m_axi_AWCACHE),
        .m_axi_awid(s00_entry_pipeline_m_axi_AWID),
        .m_axi_awlen(s00_entry_pipeline_m_axi_AWLEN),
        .m_axi_awlock(s00_entry_pipeline_m_axi_AWLOCK),
        .m_axi_awprot(s00_entry_pipeline_m_axi_AWPROT),
        .m_axi_awqos(s00_entry_pipeline_m_axi_AWQOS),
        .m_axi_awready(s00_entry_pipeline_m_axi_AWREADY),
        .m_axi_awuser(s00_entry_pipeline_m_axi_AWUSER),
        .m_axi_awvalid(s00_entry_pipeline_m_axi_AWVALID),
        .m_axi_bid(s00_entry_pipeline_m_axi_BID),
        .m_axi_bready(s00_entry_pipeline_m_axi_BREADY),
        .m_axi_bresp(s00_entry_pipeline_m_axi_BRESP),
        .m_axi_buser(s00_entry_pipeline_m_axi_BUSER),
        .m_axi_bvalid(s00_entry_pipeline_m_axi_BVALID),
        .m_axi_rdata(s00_entry_pipeline_m_axi_RDATA),
        .m_axi_rid(s00_entry_pipeline_m_axi_RID),
        .m_axi_rlast(s00_entry_pipeline_m_axi_RLAST),
        .m_axi_rready(s00_entry_pipeline_m_axi_RREADY),
        .m_axi_rresp(s00_entry_pipeline_m_axi_RRESP),
        .m_axi_ruser(s00_entry_pipeline_m_axi_RUSER),
        .m_axi_rvalid(s00_entry_pipeline_m_axi_RVALID),
        .m_axi_wdata(s00_entry_pipeline_m_axi_WDATA),
        .m_axi_wlast(s00_entry_pipeline_m_axi_WLAST),
        .m_axi_wready(s00_entry_pipeline_m_axi_WREADY),
        .m_axi_wstrb(s00_entry_pipeline_m_axi_WSTRB),
        .m_axi_wuser(s00_entry_pipeline_m_axi_WUSER),
        .m_axi_wvalid(s00_entry_pipeline_m_axi_WVALID),
        .s_axi_araddr(S00_AXI_araddr),
        .s_axi_arprot(S00_AXI_arprot),
        .s_axi_arready(S00_AXI_arready),
        .s_axi_arvalid(S00_AXI_arvalid),
        .s_axi_awaddr(S00_AXI_awaddr),
        .s_axi_awprot(S00_AXI_awprot),
        .s_axi_awready(S00_AXI_awready),
        .s_axi_awvalid(S00_AXI_awvalid),
        .s_axi_bready(S00_AXI_bready),
        .s_axi_bresp(S00_AXI_bresp),
        .s_axi_bvalid(S00_AXI_bvalid),
        .s_axi_rdata(S00_AXI_rdata),
        .s_axi_rready(S00_AXI_rready),
        .s_axi_rresp(S00_AXI_rresp),
        .s_axi_rvalid(S00_AXI_rvalid),
        .s_axi_wdata(S00_AXI_wdata),
        .s_axi_wready(S00_AXI_wready),
        .s_axi_wstrb(S00_AXI_wstrb),
        .s_axi_wvalid(S00_AXI_wvalid));
  s00_nodes_imp_1FAO4F6 s00_nodes
       (.M_SC_AR_info(s00_nodes_M_SC_AR_INFO),
        .M_SC_AR_payld(s00_nodes_M_SC_AR_PAYLD),
        .M_SC_AR_recv(s00_nodes_M_SC_AR_RECV),
        .M_SC_AR_req(s00_nodes_M_SC_AR_REQ),
        .M_SC_AR_send(s00_nodes_M_SC_AR_SEND),
        .M_SC_AW_info(s00_nodes_M_SC_AW_INFO),
        .M_SC_AW_payld(s00_nodes_M_SC_AW_PAYLD),
        .M_SC_AW_recv(s00_nodes_M_SC_AW_RECV),
        .M_SC_AW_req(s00_nodes_M_SC_AW_REQ),
        .M_SC_AW_send(s00_nodes_M_SC_AW_SEND),
        .M_SC_B_info(s00_nodes_M_SC_B_INFO),
        .M_SC_B_payld(s00_nodes_M_SC_B_PAYLD),
        .M_SC_B_recv(s00_nodes_M_SC_B_RECV),
        .M_SC_B_req(s00_nodes_M_SC_B_REQ),
        .M_SC_B_send(s00_nodes_M_SC_B_SEND),
        .M_SC_R_info(s00_nodes_M_SC_R_INFO),
        .M_SC_R_payld(s00_nodes_M_SC_R_PAYLD),
        .M_SC_R_recv(s00_nodes_M_SC_R_RECV),
        .M_SC_R_req(s00_nodes_M_SC_R_REQ),
        .M_SC_R_send(s00_nodes_M_SC_R_SEND),
        .M_SC_W_info(s00_nodes_M_SC_W_INFO),
        .M_SC_W_payld(s00_nodes_M_SC_W_PAYLD),
        .M_SC_W_recv(s00_nodes_M_SC_W_RECV),
        .M_SC_W_req(s00_nodes_M_SC_W_REQ),
        .M_SC_W_send(s00_nodes_M_SC_W_SEND),
        .S_SC_AR_info(S_SC_AR_1_INFO),
        .S_SC_AR_payld(S_SC_AR_1_PAYLD),
        .S_SC_AR_recv(S_SC_AR_1_RECV),
        .S_SC_AR_req(S_SC_AR_1_REQ),
        .S_SC_AR_send(S_SC_AR_1_SEND),
        .S_SC_AW_info(S_SC_AW_1_INFO),
        .S_SC_AW_payld(S_SC_AW_1_PAYLD),
        .S_SC_AW_recv(S_SC_AW_1_RECV),
        .S_SC_AW_req(S_SC_AW_1_REQ),
        .S_SC_AW_send(S_SC_AW_1_SEND),
        .S_SC_B_info(S_SC_B_1_INFO),
        .S_SC_B_payld(S_SC_B_1_PAYLD),
        .S_SC_B_recv(S_SC_B_1_RECV),
        .S_SC_B_req(S_SC_B_1_REQ),
        .S_SC_B_send(S_SC_B_1_SEND),
        .S_SC_R_info(S_SC_R_1_INFO),
        .S_SC_R_payld(S_SC_R_1_PAYLD),
        .S_SC_R_recv(S_SC_R_1_RECV),
        .S_SC_R_req(S_SC_R_1_REQ),
        .S_SC_R_send(S_SC_R_1_SEND),
        .S_SC_W_info(S_SC_W_1_INFO),
        .S_SC_W_payld(S_SC_W_1_PAYLD),
        .S_SC_W_recv(S_SC_W_1_RECV),
        .S_SC_W_req(S_SC_W_1_REQ),
        .S_SC_W_send(S_SC_W_1_SEND),
        .m_sc_clk(clk_map_S00_ACLK),
        .m_sc_resetn(clk_map_S00_ARESETN),
        .s_sc_clk(clk_map_S00_ACLK),
        .s_sc_resetn(clk_map_S00_ARESETN));
  switchboards_imp_1MKJLH2 switchboards
       (.M00_SC_AR_info(S_SC_AR_2_INFO),
        .M00_SC_AR_payld(S_SC_AR_2_PAYLD),
        .M00_SC_AR_recv(S_SC_AR_2_RECV),
        .M00_SC_AR_req(S_SC_AR_2_REQ),
        .M00_SC_AR_send(S_SC_AR_2_SEND),
        .M00_SC_AW_info(S_SC_AW_2_INFO),
        .M00_SC_AW_payld(S_SC_AW_2_PAYLD),
        .M00_SC_AW_recv(S_SC_AW_2_RECV),
        .M00_SC_AW_req(S_SC_AW_2_REQ),
        .M00_SC_AW_send(S_SC_AW_2_SEND),
        .M00_SC_B_info(S_SC_B_1_INFO),
        .M00_SC_B_payld(S_SC_B_1_PAYLD),
        .M00_SC_B_recv(S_SC_B_1_RECV),
        .M00_SC_B_req(S_SC_B_1_REQ),
        .M00_SC_B_send(S_SC_B_1_SEND),
        .M00_SC_R_info(S_SC_R_1_INFO),
        .M00_SC_R_payld(S_SC_R_1_PAYLD),
        .M00_SC_R_recv(S_SC_R_1_RECV),
        .M00_SC_R_req(S_SC_R_1_REQ),
        .M00_SC_R_send(S_SC_R_1_SEND),
        .M00_SC_W_info(S_SC_W_2_INFO),
        .M00_SC_W_payld(S_SC_W_2_PAYLD),
        .M00_SC_W_recv(S_SC_W_2_RECV),
        .M00_SC_W_req(S_SC_W_2_REQ),
        .M00_SC_W_send(S_SC_W_2_SEND),
        .M01_SC_AR_info(S_SC_AR_3_INFO),
        .M01_SC_AR_payld(S_SC_AR_3_PAYLD),
        .M01_SC_AR_recv(S_SC_AR_3_RECV),
        .M01_SC_AR_req(S_SC_AR_3_REQ),
        .M01_SC_AR_send(S_SC_AR_3_SEND),
        .M01_SC_AW_info(S_SC_AW_3_INFO),
        .M01_SC_AW_payld(S_SC_AW_3_PAYLD),
        .M01_SC_AW_recv(S_SC_AW_3_RECV),
        .M01_SC_AW_req(S_SC_AW_3_REQ),
        .M01_SC_AW_send(S_SC_AW_3_SEND),
        .M01_SC_W_info(S_SC_W_3_INFO),
        .M01_SC_W_payld(S_SC_W_3_PAYLD),
        .M01_SC_W_recv(S_SC_W_3_RECV),
        .M01_SC_W_req(S_SC_W_3_REQ),
        .M01_SC_W_send(S_SC_W_3_SEND),
        .M02_SC_AR_info(S_SC_AR_4_INFO),
        .M02_SC_AR_payld(S_SC_AR_4_PAYLD),
        .M02_SC_AR_recv(S_SC_AR_4_RECV),
        .M02_SC_AR_req(S_SC_AR_4_REQ),
        .M02_SC_AR_send(S_SC_AR_4_SEND),
        .M02_SC_AW_info(S_SC_AW_4_INFO),
        .M02_SC_AW_payld(S_SC_AW_4_PAYLD),
        .M02_SC_AW_recv(S_SC_AW_4_RECV),
        .M02_SC_AW_req(S_SC_AW_4_REQ),
        .M02_SC_AW_send(S_SC_AW_4_SEND),
        .M02_SC_W_info(S_SC_W_4_INFO),
        .M02_SC_W_payld(S_SC_W_4_PAYLD),
        .M02_SC_W_recv(S_SC_W_4_RECV),
        .M02_SC_W_req(S_SC_W_4_REQ),
        .M02_SC_W_send(S_SC_W_4_SEND),
        .M03_SC_AR_info(S_SC_AR_5_INFO),
        .M03_SC_AR_payld(S_SC_AR_5_PAYLD),
        .M03_SC_AR_recv(S_SC_AR_5_RECV),
        .M03_SC_AR_req(S_SC_AR_5_REQ),
        .M03_SC_AR_send(S_SC_AR_5_SEND),
        .M03_SC_AW_info(S_SC_AW_5_INFO),
        .M03_SC_AW_payld(S_SC_AW_5_PAYLD),
        .M03_SC_AW_recv(S_SC_AW_5_RECV),
        .M03_SC_AW_req(S_SC_AW_5_REQ),
        .M03_SC_AW_send(S_SC_AW_5_SEND),
        .M03_SC_W_info(S_SC_W_5_INFO),
        .M03_SC_W_payld(S_SC_W_5_PAYLD),
        .M03_SC_W_recv(S_SC_W_5_RECV),
        .M03_SC_W_req(S_SC_W_5_REQ),
        .M03_SC_W_send(S_SC_W_5_SEND),
        .M04_SC_AR_info(S_SC_AR_6_INFO),
        .M04_SC_AR_payld(S_SC_AR_6_PAYLD),
        .M04_SC_AR_recv(S_SC_AR_6_RECV),
        .M04_SC_AR_req(S_SC_AR_6_REQ),
        .M04_SC_AR_send(S_SC_AR_6_SEND),
        .M04_SC_AW_info(S_SC_AW_6_INFO),
        .M04_SC_AW_payld(S_SC_AW_6_PAYLD),
        .M04_SC_AW_recv(S_SC_AW_6_RECV),
        .M04_SC_AW_req(S_SC_AW_6_REQ),
        .M04_SC_AW_send(S_SC_AW_6_SEND),
        .M04_SC_W_info(S_SC_W_6_INFO),
        .M04_SC_W_payld(S_SC_W_6_PAYLD),
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
