talsh123/tokenizer-vivado/uart.gen/sources_1/bd/design_1/ip/design_1_smartconnect_0_0/synth/design_1_smartconnect_0_0.v

// (c) Copyright 1986-2022 Xilinx, Inc. All Rights Reserved.
// (c) Copyright 2022-2026 Advanced Micro Devices, Inc. All rights reserved.
// 
// This file contains confidential and proprietary information
// of AMD and is protected under U.S. and international copyright
// and other intellectual property laws.
// 
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
// CRITICAL APPLICATIONS
// AMD products are not designed or intended to be fail-
// safe, or for use in any application requiring fail-safe
// performance, such as life-support or safety devices or
// systems, Class III medical devices, nuclear facilities,
// applications related to the deployment of airbags, or any
// other applications that could lead to death, personal
// injury, or severe property or environmental damage
// (individually and collectively, "Critical
// Applications"). Customer assumes the sole risk and
// liability of any use of AMD products in Critical
// Applications, subject only to applicable laws and
// regulations governing limitations on product liability.
// 
// THIS COPYRIGHT NOTICE AND DISCLAIMER MUST BE RETAINED AS
// PART OF THIS FILE AT ALL TIMES.
// 
// DO NOT MODIFY THIS FILE.


// IP VLNV: xilinx.com:ip:smartconnect:1.0
// IP Revision: 28

(* X_CORE_INFO = "bd_48ac,Vivado 2025.2" *)
(* CHECK_LICENSE_TYPE = "design_1_smartconnect_0_0,bd_48ac,{}" *)
(* CORE_GENERATION_INFO = "design_1_smartconnect_0_0,bd_48ac,{x_ipProduct=Vivado 2025.2,x_ipVendor=xilinx.com,x_ipLibrary=ip,x_ipName=smartconnect,x_ipVersion=1.0,x_ipCoreRevision=28,x_ipLanguage=VERILOG,x_ipSimLanguage=MIXED}" *)
(* DowngradeIPIdentifiedWarnings = "yes" *)
module design_1_smartconnect_0_0 (
  aclk,
  aresetn,
  S00_AXI_awaddr,
  S00_AXI_awprot,
  S00_AXI_awvalid,
  S00_AXI_awready,
  S00_AXI_wdata,
  S00_AXI_wstrb,
  S00_AXI_wvalid,
  S00_AXI_wready,
  S00_AXI_bresp,
  S00_AXI_bvalid,
  S00_AXI_bready,
  S00_AXI_araddr,
  S00_AXI_arprot,
  S00_AXI_arvalid,
  S00_AXI_arready,
  S00_AXI_rdata,
  S00_AXI_rresp,
  S00_AXI_rvalid,
  S00_AXI_rready,
  M00_AXI_awaddr,
  M00_AXI_awprot,
  M00_AXI_awvalid,
  M00_AXI_awready,
  M00_AXI_wdata,
  M00_AXI_wstrb,
  M00_AXI_wvalid,
  M00_AXI_wready,
  M00_AXI_bresp,
  M00_AXI_bvalid,
  M00_AXI_bready,
  M00_AXI_araddr,
  M00_AXI_arprot,
  M00_AXI_arvalid,
  M00_AXI_arready,
  M00_AXI_rdata,
  M00_AXI_rresp,
  M00_AXI_rvalid,
  M00_AXI_rready,
  M01_AXI_awaddr,
  M01_AXI_awprot,
  M01_AXI_awvalid,
  M01_AXI_awready,
  M01_AXI_wdata,
  M01_AXI_wstrb,
  M01_AXI_wvalid,
  M01_AXI_wready,
  M01_AXI_bresp,
  M01_AXI_bvalid,
  M01_AXI_bready,
  M01_AXI_araddr,
  M01_AXI_arprot,
  M01_AXI_arvalid,
  M01_AXI_arready,
  M01_AXI_rdata,
  M01_AXI_rresp,
  M01_AXI_rvalid,
  M01_AXI_rready,
  M02_AXI_awaddr,
  M02_AXI_awprot,
  M02_AXI_awvalid,
  M02_AXI_awready,
  M02_AXI_wdata,
  M02_AXI_wstrb,
  M02_AXI_wvalid,
  M02_AXI_wready,
  M02_AXI_bresp,
  M02_AXI_bvalid,
  M02_AXI_bready,
  M02_AXI_araddr,
  M02_AXI_arprot,
  M02_AXI_arvalid,
  M02_AXI_arready,
  M02_AXI_rdata,
  M02_AXI_rresp,
  M02_AXI_rvalid,
  M02_AXI_rready,
  M03_AXI_awaddr,
  M03_AXI_awprot,
  M03_AXI_awvalid,
  M03_AXI_awready,
  M03_AXI_wdata,
  M03_AXI_wstrb,
  M03_AXI_wvalid,
  M03_AXI_wready,
  M03_AXI_bresp,
  M03_AXI_bvalid,
  M03_AXI_bready,
  M03_AXI_araddr,
  M03_AXI_arprot,
  M03_AXI_arvalid,
  M03_AXI_arready,
  M03_AXI_rdata,
  M03_AXI_rresp,
  M03_AXI_rvalid,
  M03_AXI_rready,
  M04_AXI_awaddr,
  M04_AXI_awprot,
  M04_AXI_awvalid,
  M04_AXI_awready,
  M04_AXI_wdata,
  M04_AXI_wstrb,
  M04_AXI_wvalid,
  M04_AXI_wready,
  M04_AXI_bresp,
  M04_AXI_bvalid,
  M04_AXI_bready,
  M04_AXI_araddr,
  M04_AXI_arprot,
  M04_AXI_arvalid,
  M04_AXI_arready,
  M04_AXI_rdata,
  M04_AXI_rresp,
  M04_AXI_rvalid,
  M04_AXI_rready,
  M05_AXI_awaddr,
  M05_AXI_awprot,
  M05_AXI_awvalid,
  M05_AXI_awready,
  M05_AXI_wdata,
  M05_AXI_wstrb,
  M05_AXI_wvalid,
  M05_AXI_wready,
  M05_AXI_bresp,
  M05_AXI_bvalid,
  M05_AXI_bready,
  M05_AXI_araddr,
  M05_AXI_arprot,
  M05_AXI_arvalid,
  M05_AXI_arready,
  M05_AXI_rdata,
  M05_AXI_rresp,
  M05_AXI_rvalid,
  M05_AXI_rready,
  M06_AXI_awaddr,
  M06_AXI_awprot,
  M06_AXI_awvalid,
  M06_AXI_awready,
  M06_AXI_wdata,
  M06_AXI_wstrb,
  M06_AXI_wvalid,
  M06_AXI_wready,
  M06_AXI_bresp,
  M06_AXI_bvalid,
  M06_AXI_bready,
  M06_AXI_araddr,
  M06_AXI_arprot,
  M06_AXI_arvalid,
  M06_AXI_arready,
  M06_AXI_rdata,
  M06_AXI_rresp,
  M06_AXI_rvalid,
  M06_AXI_rready
);

(* X_INTERFACE_INFO = "xilinx.com:signal:clock:1.0 CLK.aclk CLK" *)
(* X_INTERFACE_MODE = "slave" *)
(* X_INTERFACE_PARAMETER = "XIL_INTERFACENAME CLK.aclk, FREQ_HZ 100000000, FREQ_TOLERANCE_HZ 0, PHASE 0.0, CLK_DOMAIN /clk_wiz_1_clk_out1, ASSOCIATED_BUSIF M00_AXI:M01_AXI:M02_AXI:M03_AXI:M04_AXI:M05_AXI:M06_AXI:S00_AXI, INSERT_VIP 0, ASSOCIATED_CLKEN s_sc_aclken" *)
input wire aclk;
(* X_INTERFACE_INFO = "xilinx.com:signal:reset:1.0 RST.aresetn RST" *)
(* X_INTERFACE_MODE = "slave" *)
(* X_INTERFACE_PARAMETER = "XIL_INTERFACENAME RST.aresetn, POLARITY ACTIVE_LOW, INSERT_VIP 0" *)
input wire aresetn;
(* X_INTERFACE_INFO = "xilinx.com:interface:aximm:1.0 S00_AXI AWADDR" *)
(* X_INTERFACE_MODE = "slave" *)
(* X_INTERFACE_PARAMETER = "XIL_INTERFACENAME S00_AXI, DATA_WIDTH 32, PROTOCOL AXI4LITE, FREQ_HZ 100000000, ID_WIDTH 0, ADDR_WIDTH 32, AWUSER_WIDTH 0, ARUSER_WIDTH 0, WUSER_WIDTH 0, RUSER_WIDTH 0, BUSER_WIDTH 0, READ_WRITE_MODE READ_WRITE, HAS_BURST 0, HAS_LOCK 0, HAS_PROT 1, HAS_CACHE 0, HAS_QOS 0, HAS_REGION 0, HAS_WSTRB 1, HAS_BRESP 1, HAS_RRESP 1, SUPPORTS_NARROW_BURST 0, NUM_READ_OUTSTANDING 1, NUM_WRITE_OUTSTANDING 1, MAX_BURST_LENGTH 1, PHASE 0.0, CLK_DOMAIN /clk_wiz_1_clk_out1, NUM_READ_THREADS 1, NUM_WRITE_THREADS\
 1, RUSER_BITS_PER_BYTE 0, WUSER_BITS_PER_BYTE 0, INSERT_VIP 0" *)
input wire [31 : 0] S00_AXI_awaddr;
(* X_INTERFACE_INFO = "xilinx.com:interface:aximm:1.0 S00_AXI AWPROT" *)
input wire [2 : 0] S00_AXI_awprot;
(* X_INTERFACE_INFO = "xilinx.com:interface:aximm:1.0 S00_AXI AWVALID" *)
input wire S00_AXI_awvalid;
(* X_INTERFACE_INFO = "xilinx.com:interface:aximm:1.0 S00_AXI AWREADY" *)
output wire S00_AXI_awready;
(* X_INTERFACE_INFO = "xilinx.com:interface:aximm:1.0 S00_AXI WDATA" *)
input wire [31 : 0] S00_AXI_wdata;
(* X_INTERFACE_INFO = "xilinx.com:interface:aximm:1.0 S00_AXI WSTRB" *)
input wire [3 : 0] S00_AXI_wstrb;
(* X_INTERFACE_INFO = "xilinx.com:interface:aximm:1.0 S00_AXI WVALID" *)
input wire S00_AXI_wvalid;
(* X_INTERFACE_INFO = "xilinx.com:interface:aximm:1.0 S00_AXI WREADY" *)
output wire S00_AXI_wready;
(* X_INTERFACE_INFO = "xilinx.com:interface:aximm:1.0 S00_AXI BRESP" *)
output wire [1 : 0] S00_AXI_bresp;
(* X_INTERFACE_INFO = "xilinx.com:interface:aximm:1.0 S00_AXI BVALID" *)
output wire S00_AXI_bvalid;
(* X_INTERFACE_INFO = "xilinx.com:interface:aximm:1.0 S00_AXI BREADY" *)
input wire S00_AXI_bready;
(* X_INTERFACE_INFO = "xilinx.com:interface:aximm:1.0 S00_AXI ARADDR" *)
input wire [31 : 0] S00_AXI_araddr;
(* X_INTERFACE_INFO = "xilinx.com:interface:aximm:1.0 S00_AXI ARPROT" *)
input wire [2 : 0] S00_AXI_arprot;
(* X_INTERFACE_INFO = "xilinx.com:interface:aximm:1.0 S00_AXI ARVALID" *)
input wire S00_AXI_arvalid;
(* X_INTERFACE_INFO = "xilinx.com:interface:aximm:1.0 S00_AXI ARREADY" *)
output wire S00_AXI_arready;
(* X_INTERFACE_INFO = "xilinx.com:interface:aximm:1.0 S00_AXI RDATA" *)
output wire [31 : 0] S00_AXI_rdata;
(* X_INTERFACE_INFO = "xilinx.com:interface:aximm:1.0 S00_AXI RRESP" *)
output wire [1 : 0] S00_AXI_rresp;
(* X_INTERFACE_INFO = "xilinx.com:interface:aximm:1.0 S00_AXI RVALID" *)
output wire S00_AXI_rvalid;
(* X_INTERFACE_INFO = "xilinx.com:interface:aximm:1.0 S00_AXI RREADY" *)
input wire S00_AXI_rready;
(* X_INTERFACE_INFO = "xilinx.com:interface:aximm:1.0 M00_AXI AWADDR" *)
(* X_INTERFACE_MODE = "master" *)
(* X_INTERFACE_PARAMETER = "XIL_INTERFACENAME M00_AXI, DATA_WIDTH 32, PROTOCOL AXI4LITE, FREQ_HZ 100000000, ID_WIDTH 0, ADDR_WIDTH 9, AWUSER_WIDTH 0, ARUSER_WIDTH 0, WUSER_WIDTH 0, RUSER_WIDTH 0, BUSER_WIDTH 0, READ_WRITE_MODE READ_WRITE, HAS_BURST 0, HAS_LOCK 0, HAS_PROT 1, HAS_CACHE 0, HAS_QOS 0, HAS_REGION 0, HAS_WSTRB 1, HAS_BRESP 1, HAS_RRESP 1, SUPPORTS_NARROW_BURST 0, NUM_READ_OUTSTANDING 1, NUM_WRITE_OUTSTANDING 1, MAX_BURST_LENGTH 1, PHASE 0.0, CLK_DOMAIN /clk_wiz_1_clk_out1, NUM_READ_THREADS 1, NUM_WRITE_THREADS \
1, RUSER_BITS_PER_BYTE 0, WUSER_BITS_PER_BYTE 0, INSERT_VIP 0" *)
output wire [8 : 0] M00_AXI_awaddr;
(* X_INTERFACE_INFO = "xilinx.com:interface:aximm:1.0 M00_AXI AWPROT" *)
output wire [2 : 0] M00_AXI_awprot;
(* X_INTERFACE_INFO = "xilinx.com:interface:aximm:1.0 M00_AXI AWVALID" *)
output wire M00_AXI_awvalid;
(* X_INTERFACE_INFO = "xilinx.com:interface:aximm:1.0 M00_AXI AWREADY" *)
input wire M00_AXI_awready;
(* X_INTERFACE_INFO = "xilinx.com:interface:aximm:1.0 M00_AXI WDATA" *)
output wire [31 : 0] M00_AXI_wdata;
(* X_INTERFACE_INFO = "xilinx.com:interface:aximm:1.0 M00_AXI WSTRB" *)
output wire [3 : 0] M00_AXI_wstrb;
(* X_INTERFACE_INFO = "xilinx.com:interface:aximm:1.0 M00_AXI WVALID" *)
output wire M00_AXI_wvalid;
(* X_INTERFACE_INFO = "xilinx.com:interface:aximm:1.0 M00_AXI WREADY" *)
input wire M00_AXI_wready;
(* X_INTERFACE_INFO = "xilinx.com:interface:aximm:1.0 M00_AXI BRESP" *)
input wire [1 : 0] M00_AXI_bresp;
(* X_INTERFACE_INFO = "xilinx.com:interface:aximm:1.0 M00_AXI BVALID" *)
input wire M00_AXI_bvalid;
(* X_INTERFACE_INFO = "xilinx.com:interface:aximm:1.0 M00_AXI BREADY" *)
output wire M00_AXI_bready;
(* X_INTERFACE_INFO = "xilinx.com:interface:aximm:1.0 M00_AXI ARADDR" *)
output wire [8 : 0] M00_AXI_araddr;
(* X_INTERFACE_INFO = "xilinx.com:interface:aximm:1.0 M00_AXI ARPROT" *)
output wire [2 : 0] M00_AXI_arprot;
(* X_INTERFACE_INFO = "xilinx.com:interface:aximm:1.0 M00_AXI ARVALID" *)
output wire M00_AXI_arvalid;
(* X_INTERFACE_INFO = "xilinx.com:interface:aximm:1.0 M00_AXI ARREADY" *)
input wire M00_AXI_arready;
(* X_INTERFACE_INFO = "xilinx.com:interface:aximm:1.0 M00_AXI RDATA" *)
input wire [31 : 0] M00_AXI_rdata;
(* X_INTERFACE_INFO = "xilinx.com:interface:aximm:1.0 M00_AXI RRESP" *)
input wire [1 : 0] M00_AXI_rresp;
(* X_INTERFACE_INFO = "xilinx.com:interface:aximm:1.0 M00_AXI RVALID" *)
input wire M00_AXI_rvalid;
(* X_INTERFACE_INFO = "xilinx.com:interface:aximm:1.0 M00_AXI RREADY" *)
output wire M00_AXI_rready;
(* X_INTERFACE_INFO = "xilinx.com:interface:aximm:1.0 M01_AXI AWADDR" *)
(* X_INTERFACE_MODE = "master" *)
(* X_INTERFACE_PARAMETER = "XIL_INTERFACENAME M01_AXI, DATA_WIDTH 32, PROTOCOL AXI4LITE, FREQ_HZ 100000000, ID_WIDTH 0, ADDR_WIDTH 18, AWUSER_WIDTH 0, ARUSER_WIDTH 0, WUSER_WIDTH 0, RUSER_WIDTH 0, BUSER_WIDTH 0, READ_WRITE_MODE READ_WRITE, HAS_BURST 0, HAS_LOCK 0, HAS_PROT 1, HAS_CACHE 0, HAS_QOS 0, HAS_REGION 0, HAS_WSTRB 1, HAS_BRESP 1, HAS_RRESP 1, SUPPORTS_NARROW_BURST 0, NUM_READ_OUTSTANDING 1, NUM_WRITE_OUTSTANDING 1, MAX_BURST_LENGTH 1, PHASE 0.0, CLK_DOMAIN /clk_wiz_1_clk_out1, NUM_READ_THREADS 1, NUM_WRITE_THREADS\
 1, RUSER_BITS_PER_BYTE 0, WUSER_BITS_PER_BYTE 0, INSERT_VIP 0" *)
output wire [17 : 0] M01_AXI_awaddr;
(* X_INTERFACE_INFO = "xilinx.com:interface:aximm:1.0 M01_AXI AWPROT" *)
output wire [2 : 0] M01_AXI_awprot;
(* X_INTERFACE_INFO = "xilinx.com:interface:aximm:1.0 M01_AXI AWVALID" *)
output wire M01_AXI_awvalid;
(* X_INTERFACE_INFO = "xilinx.com:interface:aximm:1.0 M01_AXI AWREADY" *)
input wire M01_AXI_awready;
(* X_INTERFACE_INFO = "xilinx.com:interface:aximm:1.0 M01_AXI WDATA" *)
output wire [31 : 0] M01_AXI_wdata;
(* X_INTERFACE_INFO = "xilinx.com:interface:aximm:1.0 M01_AXI WSTRB" *)
output wire [3 : 0] M01_AXI_wstrb;
(* X_INTERFACE_INFO = "xilinx.com:interface:aximm:1.0 M01_AXI WVALID" *)
output wire M01_AXI_wvalid;
(* X_INTERFACE_INFO = "xilinx.com:interface:aximm:1.0 M01_AXI WREADY" *)
input wire M01_AXI_wready;
(* X_INTERFACE_INFO = "xilinx.com:interface:aximm:1.0 M01_AXI BRESP" *)
input wire [1 : 0] M01_AXI_bresp;
(* X_INTERFACE_INFO = "xilinx.com:interface:aximm:1.0 M01_AXI BVALID" *)
input wire M01_AXI_bvalid;
(* X_INTERFACE_INFO = "xilinx.com:interface:aximm:1.0 M01_AXI BREADY" *)
output wire M01_AXI_bready;
(* X_INTERFACE_INFO = "xilinx.com:interface:aximm:1.0 M01_AXI ARADDR" *)
output wire [17 : 0] M01_AXI_araddr;
(* X_INTERFACE_INFO = "xilinx.com:interface:aximm:1.0 M01_AXI ARPROT" *)
output wire [2 : 0] M01_AXI_arprot;
(* X_INTERFACE_INFO = "xilinx.com:interface:aximm:1.0 M01_AXI ARVALID" *)
output wire M01_AXI_arvalid;
(* X_INTERFACE_INFO = "xilinx.com:interface:aximm:1.0 M01_AXI ARREADY" *)
input wire M01_AXI_arready;
(* X_INTERFACE_INFO = "xilinx.com:interface:aximm:1.0 M01_AXI RDATA" *)
input wire [31 : 0] M01_AXI_rdata;
(* X_INTERFACE_INFO = "xilinx.com:interface:aximm:1.0 M01_AXI RRESP" *)
input wire [1 : 0] M01_AXI_rresp;
(* X_INTERFACE_INFO = "xilinx.com:interface:aximm:1.0 M01_AXI RVALID" *)
input wire M01_AXI_rvalid;
(* X_INTERFACE_INFO = "xilinx.com:interface:aximm:1.0 M01_AXI RREADY" *)
output wire M01_AXI_rready;
(* X_INTERFACE_INFO = "xilinx.com:interface:aximm:1.0 M02_AXI AWADDR" *)
(* X_INTERFACE_MODE = "master" *)
(* X_INTERFACE_PARAMETER = "XIL_INTERFACENAME M02_AXI, DATA_WIDTH 32, PROTOCOL AXI4LITE, FREQ_HZ 100000000, ID_WIDTH 0, ADDR_WIDTH 10, AWUSER_WIDTH 0, ARUSER_WIDTH 0, WUSER_WIDTH 0, RUSER_WIDTH 0, BUSER_WIDTH 0, READ_WRITE_MODE READ_WRITE, HAS_BURST 0, HAS_LOCK 0, HAS_PROT 1, HAS_CACHE 0, HAS_QOS 0, HAS_REGION 0, HAS_WSTRB 1, HAS_BRESP 1, HAS_RRESP 1, SUPPORTS_NARROW_BURST 0, NUM_READ_OUTSTANDING 1, NUM_WRITE_OUTSTANDING 1, MAX_BURST_LENGTH 1, PHASE 0.0, CLK_DOMAIN /clk_wiz_1_clk_out1, NUM_READ_THREADS 1, NUM_WRITE_THREADS\
 1, RUSER_BITS_PER_BYTE 0, WUSER_BITS_PER_BYTE 0, INSERT_VIP 0" *)
output wire [9 : 0] M02_AXI_awaddr;
(* X_INTERFACE_INFO = "xilinx.com:interface:aximm:1.0 M02_AXI AWPROT" *)
output wire [2 : 0] M02_AXI_awprot;
(* X_INTERFACE_INFO = "xilinx.com:interface:aximm:1.0 M02_AXI AWVALID" *)
output wire M02_AXI_awvalid;
(* X_INTERFACE_INFO = "xilinx.com:interface:aximm:1.0 M02_AXI AWREADY" *)
input wire M02_AXI_awready;
(* X_INTERFACE_INFO = "xilinx.com:interface:aximm:1.0 M02_AXI WDATA" *)
output wire [31 : 0] M02_AXI_wdata;
(* X_INTERFACE_INFO = "xilinx.com:interface:aximm:1.0 M02_AXI WSTRB" *)
output wire [3 : 0] M02_AXI_wstrb;
(* X_INTERFACE_INFO = "xilinx.com:interface:aximm:1.0 M02_AXI WVALID" *)
output wire M02_AXI_wvalid;
(* X_INTERFACE_INFO = "xilinx.com:interface:aximm:1.0 M02_AXI WREADY" *)
input wire M02_AXI_wready;
(* X_INTERFACE_INFO = "xilinx.com:interface:aximm:1.0 M02_AXI BRESP" *)
input wire [1 : 0] M02_AXI_bresp;
(* X_INTERFACE_INFO = "xilinx.com:interface:aximm:1.0 M02_AXI BVALID" *)
input wire M02_AXI_bvalid;
(* X_INTERFACE_INFO = "xilinx.com:interface:aximm:1.0 M02_AXI BREADY" *)
output wire M02_AXI_bready;
(* X_INTERFACE_INFO = "xilinx.com:interface:aximm:1.0 M02_AXI ARADDR" *)
output wire [9 : 0] M02_AXI_araddr;
(* X_INTERFACE_INFO = "xilinx.com:interface:aximm:1.0 M02_AXI ARPROT" *)
output wire [2 : 0] M02_AXI_arprot;
(* X_INTERFACE_INFO = "xilinx.com:interface:aximm:1.0 M02_AXI ARVALID" *)
output wire M02_AXI_arvalid;
(* X_INTERFACE_INFO = "xilinx.com:interface:aximm:1.0 M02_AXI ARREADY" *)
input wire M02_AXI_arready;
(* X_INTERFACE_INFO = "xilinx.com:interface:aximm:1.0 M02_AXI RDATA" *)
input wire [31 : 0] M02_AXI_rdata;
(* X_INTERFACE_INFO = "xilinx.com:interface:aximm:1.0 M02_AXI RRESP" *)
input wire [1 : 0] M02_AXI_rresp;
(* X_INTERFACE_INFO = "xilinx.com:interface:aximm:1.0 M02_AXI RVALID" *)
input wire M02_AXI_rvalid;
(* X_INTERFACE_INFO = "xilinx.com:interface:aximm:1.0 M02_AXI RREADY" *)
output wire M02_AXI_rready;
(* X_INTERFACE_INFO = "xilinx.com:interface:aximm:1.0 M03_AXI AWADDR" *)
(* X_INTERFACE_MODE = "master" *)
(* X_INTERFACE_PARAMETER = "XIL_INTERFACENAME M03_AXI, DATA_WIDTH 32, PROTOCOL AXI4LITE, FREQ_HZ 100000000, ID_WIDTH 0, ADDR_WIDTH 5, AWUSER_WIDTH 0, ARUSER_WIDTH 0, WUSER_WIDTH 0, RUSER_WIDTH 0, BUSER_WIDTH 0, READ_WRITE_MODE READ_WRITE, HAS_BURST 0, HAS_LOCK 0, HAS_PROT 1, HAS_CACHE 0, HAS_QOS 0, HAS_REGION 0, HAS_WSTRB 1, HAS_BRESP 1, HAS_RRESP 1, SUPPORTS_NARROW_BURST 0, NUM_READ_OUTSTANDING 1, NUM_WRITE_OUTSTANDING 1, MAX_BURST_LENGTH 1, PHASE 0.0, CLK_DOMAIN /clk_wiz_1_clk_out1, NUM_READ_THREADS 1, NUM_WRITE_THREADS \
1, RUSER_BITS_PER_BYTE 0, WUSER_BITS_PER_BYTE 0, INSERT_VIP 0" *)
output wire [4 : 0] M03_AXI_awaddr;
(* X_INTERFACE_INFO = "xilinx.com:interface:aximm:1.0 M03_AXI AWPROT" *)
output wire [2 : 0] M03_AXI_awprot;
(* X_INTERFACE_INFO = "xilinx.com:interface:aximm:1.0 M03_AXI AWVALID" *)
output wire M03_AXI_awvalid;
(* X_INTERFACE_INFO = "xilinx.com:interface:aximm:1.0 M03_AXI AWREADY" *)
input wire M03_AXI_awready;
(* X_INTERFACE_INFO = "xilinx.com:interface:aximm:1.0 M03_AXI WDATA" *)
output wire [31 : 0] M03_AXI_wdata;
(* X_INTERFACE_INFO = "xilinx.com:interface:aximm:1.0 M03_AXI WSTRB" *)
output wire [3 : 0] M03_AXI_wstrb;
(* X_INTERFACE_INFO = "xilinx.com:interface:aximm:1.0 M03_AXI WVALID" *)
output wire M03_AXI_wvalid;
(* X_INTERFACE_INFO = "xilinx.com:interface:aximm:1.0 M03_AXI WREADY" *)
input wire M03_AXI_wready;
(* X_INTERFACE_INFO = "xilinx.com:interface:aximm:1.0 M03_AXI BRESP" *)
input wire [1 : 0] M03_AXI_bresp;
(* X_INTERFACE_INFO = "xilinx.com:interface:aximm:1.0 M03_AXI BVALID" *)
input wire M03_AXI_bvalid;
(* X_INTERFACE_INFO = "xilinx.com:interface:aximm:1.0 M03_AXI BREADY" *)
output wire M03_AXI_bready;
(* X_INTERFACE_INFO = "xilinx.com:interface:aximm:1.0 M03_AXI ARADDR" *)
output wire [4 : 0] M03_AXI_araddr;
(* X_INTERFACE_INFO = "xilinx.com:interface:aximm:1.0 M03_AXI ARPROT" *)
output wire [2 : 0] M03_AXI_arprot;
(* X_INTERFACE_INFO = "xilinx.com:interface:aximm:1.0 M03_AXI ARVALID" *)
output wire M03_AXI_arvalid;
(* X_INTERFACE_INFO = "xilinx.com:interface:aximm:1.0 M03_AXI ARREADY" *)
input wire M03_AXI_arready;
(* X_INTERFACE_INFO = "xilinx.com:interface:aximm:1.0 M03_AXI RDATA" *)
input wire [31 : 0] M03_AXI_rdata;
(* X_INTERFACE_INFO = "xilinx.com:interface:aximm:1.0 M03_AXI RRESP" *)
input wire [1 : 0] M03_AXI_rresp;
(* X_INTERFACE_INFO = "xilinx.com:interface:aximm:1.0 M03_AXI RVALID" *)
input wire M03_AXI_rvalid;
(* X_INTERFACE_INFO = "xilinx.com:interface:aximm:1.0 M03_AXI RREADY" *)
output wire M03_AXI_rready;
(* X_INTERFACE_INFO = "xilinx.com:interface:aximm:1.0 M04_AXI AWADDR" *)
(* X_INTERFACE_MODE = "master" *)
(* X_INTERFACE_PARAMETER = "XIL_INTERFACENAME M04_AXI, DATA_WIDTH 32, PROTOCOL AXI4LITE, FREQ_HZ 100000000, ID_WIDTH 0, ADDR_WIDTH 4, AWUSER_WIDTH 0, ARUSER_WIDTH 0, WUSER_WIDTH 0, RUSER_WIDTH 0, BUSER_WIDTH 0, READ_WRITE_MODE READ_WRITE, HAS_BURST 0, HAS_LOCK 0, HAS_PROT 1, HAS_CACHE 0, HAS_QOS 0, HAS_REGION 0, HAS_WSTRB 1, HAS_BRESP 1, HAS_RRESP 1, SUPPORTS_NARROW_BURST 0, NUM_READ_OUTSTANDING 1, NUM_WRITE_OUTSTANDING 1, MAX_BURST_LENGTH 1, PHASE 0.0, CLK_DOMAIN /clk_wiz_1_clk_out1, NUM_READ_THREADS 1, NUM_WRITE_THREADS \
1, RUSER_BITS_PER_BYTE 0, WUSER_BITS_PER_BYTE 0, INSERT_VIP 0" *)
output wire [3 : 0] M04_AXI_awaddr;
(* X_INTERFACE_INFO = "xilinx.com:interface:aximm:1.0 M04_AXI AWPROT" *)
output wire [2 : 0] M04_AXI_awprot;
(* X_INTERFACE_INFO = "xilinx.com:interface:aximm:1.0 M04_AXI AWVALID" *)
output wire M04_AXI_awvalid;
(* X_INTERFACE_INFO = "xilinx.com:interface:aximm:1.0 M04_AXI AWREADY" *)
input wire M04_AXI_awready;
(* X_INTERFACE_INFO = "xilinx.com:interface:aximm:1.0 M04_AXI WDATA" *)
output wire [31 : 0] M04_AXI_wdata;
(* X_INTERFACE_INFO = "xilinx.com:interface:aximm:1.0 M04_AXI WSTRB" *)
output wire [3 : 0] M04_AXI_wstrb;
(* X_INTERFACE_INFO = "xilinx.com:interface:aximm:1.0 M04_AXI WVALID" *)
output wire M04_AXI_wvalid;
(* X_INTERFACE_INFO = "xilinx.com:interface:aximm:1.0 M04_AXI WREADY" *)
input wire M04_AXI_wready;
(* X_INTERFACE_INFO = "xilinx.com:interface:aximm:1.0 M04_AXI BRESP" *)
input wire [1 : 0] M04_AXI_bresp;
(* X_INTERFACE_INFO = "xilinx.com:interface:aximm:1.0 M04_AXI BVALID" *)
input wire M04_AXI_bvalid;
(* X_INTERFACE_INFO = "xilinx.com:interface:aximm:1.0 M04_AXI BREADY" *)
output wire M04_AXI_bready;
(* X_INTERFACE_INFO = "xilinx.com:interface:aximm:1.0 M04_AXI ARADDR" *)
output wire [3 : 0] M04_AXI_araddr;
(* X_INTERFACE_INFO = "xilinx.com:interface:aximm:1.0 M04_AXI ARPROT" *)
output wire [2 : 0] M04_AXI_arprot;
(* X_INTERFACE_INFO = "xilinx.com:interface:aximm:1.0 M04_AXI ARVALID" *)
output wire M04_AXI_arvalid;
(* X_INTERFACE_INFO = "xilinx.com:interface:aximm:1.0 M04_AXI ARREADY" *)
input wire M04_AXI_arready;
(* X_INTERFACE_INFO = "xilinx.com:interface:aximm:1.0 M04_AXI RDATA" *)
input wire [31 : 0] M04_AXI_rdata;
(* X_INTERFACE_INFO = "xilinx.com:interface:aximm:1.0 M04_AXI RRESP" *)
input wire [1 : 0] M04_AXI_rresp;
(* X_INTERFACE_INFO = "xilinx.com:interface:aximm:1.0 M04_AXI RVALID" *)
input wire M04_AXI_rvalid;
(* X_INTERFACE_INFO = "xilinx.com:interface:aximm:1.0 M04_AXI RREADY" *)
output wire M04_AXI_rready;
(* X_INTERFACE_INFO = "xilinx.com:interface:aximm:1.0 M05_AXI AWADDR" *)
(* X_INTERFACE_MODE = "master" *)
(* X_INTERFACE_PARAMETER = "XIL_INTERFACENAME M05_AXI, DATA_WIDTH 32, PROTOCOL AXI4LITE, FREQ_HZ 100000000, ID_WIDTH 0, ADDR_WIDTH 4, AWUSER_WIDTH 0, ARUSER_WIDTH 0, WUSER_WIDTH 0, RUSER_WIDTH 0, BUSER_WIDTH 0, READ_WRITE_MODE READ_WRITE, HAS_BURST 0, HAS_LOCK 0, HAS_PROT 1, HAS_CACHE 0, HAS_QOS 0, HAS_REGION 0, HAS_WSTRB 1, HAS_BRESP 1, HAS_RRESP 1, SUPPORTS_NARROW_BURST 0, NUM_READ_OUTSTANDING 1, NUM_WRITE_OUTSTANDING 1, MAX_BURST_LENGTH 1, PHASE 0.0, CLK_DOMAIN /clk_wiz_1_clk_out1, NUM_READ_THREADS 1, NUM_WRITE_THREADS \
1, RUSER_BITS_PER_BYTE 0, WUSER_BITS_PER_BYTE 0, INSERT_VIP 0" *)
output wire [3 : 0] M05_AXI_awaddr;
(* X_INTERFACE_INFO = "xilinx.com:interface:aximm:1.0 M05_AXI AWPROT" *)
output wire [2 : 0] M05_AXI_awprot;
(* X_INTERFACE_INFO = "xilinx.com:interface:aximm:1.0 M05_AXI AWVALID" *)
output wire M05_AXI_awvalid;
(* X_INTERFACE_INFO = "xilinx.com:interface:aximm:1.0 M05_AXI AWREADY" *)
input wire M05_AXI_awready;
(* X_INTERFACE_INFO = "xilinx.com:interface:aximm:1.0 M05_AXI WDATA" *)
output wire [31 : 0] M05_AXI_wdata;
(* X_INTERFACE_INFO = "xilinx.com:interface:aximm:1.0 M05_AXI WSTRB" *)
output wire [3 : 0] M05_AXI_wstrb;
(* X_INTERFACE_INFO = "xilinx.com:interface:aximm:1.0 M05_AXI WVALID" *)
output wire M05_AXI_wvalid;
(* X_INTERFACE_INFO = "xilinx.com:interface:aximm:1.0 M05_AXI WREADY" *)
input wire M05_AXI_wready;
(* X_INTERFACE_INFO = "xilinx.com:interface:aximm:1.0 M05_AXI BRESP" *)
input wire [1 : 0] M05_AXI_bresp;
(* X_INTERFACE_INFO = "xilinx.com:interface:aximm:1.0 M05_AXI BVALID" *)
input wire M05_AXI_bvalid;
(* X_INTERFACE_INFO = "xilinx.com:interface:aximm:1.0 M05_AXI BREADY" *)
output wire M05_AXI_bready;
(* X_INTERFACE_INFO = "xilinx.com:interface:aximm:1.0 M05_AXI ARADDR" *)
output wire [3 : 0] M05_AXI_araddr;
(* X_INTERFACE_INFO = "xilinx.com:interface:aximm:1.0 M05_AXI ARPROT" *)
output wire [2 : 0] M05_AXI_arprot;
(* X_INTERFACE_INFO = "xilinx.com:interface:aximm:1.0 M05_AXI ARVALID" *)
output wire M05_AXI_arvalid;
(* X_INTERFACE_INFO = "xilinx.com:interface:aximm:1.0 M05_AXI ARREADY" *)
input wire M05_AXI_arready;
(* X_INTERFACE_INFO = "xilinx.com:interface:aximm:1.0 M05_AXI RDATA" *)
input wire [31 : 0] M05_AXI_rdata;
(* X_INTERFACE_INFO = "xilinx.com:interface:aximm:1.0 M05_AXI RRESP" *)
input wire [1 : 0] M05_AXI_rresp;
(* X_INTERFACE_INFO = "xilinx.com:interface:aximm:1.0 M05_AXI RVALID" *)
input wire M05_AXI_rvalid;
(* X_INTERFACE_INFO = "xilinx.com:interface:aximm:1.0 M05_AXI RREADY" *)
output wire M05_AXI_rready;
(* X_INTERFACE_INFO = "xilinx.com:interface:aximm:1.0 M06_AXI AWADDR" *)
(* X_INTERFACE_MODE = "master" *)
(* X_INTERFACE_PARAMETER = "XIL_INTERFACENAME M06_AXI, DATA_WIDTH 32, PROTOCOL AXI4LITE, FREQ_HZ 100000000, ID_WIDTH 0, ADDR_WIDTH 10, AWUSER_WIDTH 0, ARUSER_WIDTH 0, WUSER_WIDTH 0, RUSER_WIDTH 0, BUSER_WIDTH 0, READ_WRITE_MODE READ_WRITE, HAS_BURST 0, HAS_LOCK 0, HAS_PROT 1, HAS_CACHE 0, HAS_QOS 0, HAS_REGION 0, HAS_WSTRB 1, HAS_BRESP 1, HAS_RRESP 1, SUPPORTS_NARROW_BURST 0, NUM_READ_OUTSTANDING 1, NUM_WRITE_OUTSTANDING 1, MAX_BURST_LENGTH 1, PHASE 0.0, CLK_DOMAIN /clk_wiz_1_clk_out1, NUM_READ_THREADS 1, NUM_WRITE_THREADS\
 1, RUSER_BITS_PER_BYTE 0, WUSER_BITS_PER_BYTE 0, INSERT_VIP 0" *)
output wire [9 : 0] M06_AXI_awaddr;
(* X_INTERFACE_INFO = "xilinx.com:interface:aximm:1.0 M06_AXI AWPROT" *)
output wire [2 : 0] M06_AXI_awprot;
(* X_INTERFACE_INFO = "xilinx.com:interface:aximm:1.0 M06_AXI AWVALID" *)
output wire M06_AXI_awvalid;
(* X_INTERFACE_INFO = "xilinx.com:interface:aximm:1.0 M06_AXI AWREADY" *)
input wire M06_AXI_awready;
(* X_INTERFACE_INFO = "xilinx.com:interface:aximm:1.0 M06_AXI WDATA" *)
output wire [31 : 0] M06_AXI_wdata;
(* X_INTERFACE_INFO = "xilinx.com:interface:aximm:1.0 M06_AXI WSTRB" *)
output wire [3 : 0] M06_AXI_wstrb;
(* X_INTERFACE_INFO = "xilinx.com:interface:aximm:1.0 M06_AXI WVALID" *)
output wire M06_AXI_wvalid;
(* X_INTERFACE_INFO = "xilinx.com:interface:aximm:1.0 M06_AXI WREADY" *)
input wire M06_AXI_wready;
(* X_INTERFACE_INFO = "xilinx.com:interface:aximm:1.0 M06_AXI BRESP" *)
input wire [1 : 0] M06_AXI_bresp;
(* X_INTERFACE_INFO = "xilinx.com:interface:aximm:1.0 M06_AXI BVALID" *)
input wire M06_AXI_bvalid;
(* X_INTERFACE_INFO = "xilinx.com:interface:aximm:1.0 M06_AXI BREADY" *)
output wire M06_AXI_bready;
(* X_INTERFACE_INFO = "xilinx.com:interface:aximm:1.0 M06_AXI ARADDR" *)
output wire [9 : 0] M06_AXI_araddr;
(* X_INTERFACE_INFO = "xilinx.com:interface:aximm:1.0 M06_AXI ARPROT" *)
output wire [2 : 0] M06_AXI_arprot;
(* X_INTERFACE_INFO = "xilinx.com:interface:aximm:1.0 M06_AXI ARVALID" *)
output wire M06_AXI_arvalid;
(* X_INTERFACE_INFO = "xilinx.com:interface:aximm:1.0 M06_AXI ARREADY" *)
input wire M06_AXI_arready;
(* X_INTERFACE_INFO = "xilinx.com:interface:aximm:1.0 M06_AXI RDATA" *)
input wire [31 : 0] M06_AXI_rdata;
(* X_INTERFACE_INFO = "xilinx.com:interface:aximm:1.0 M06_AXI RRESP" *)
input wire [1 : 0] M06_AXI_rresp;
(* X_INTERFACE_INFO = "xilinx.com:interface:aximm:1.0 M06_AXI RVALID" *)
input wire M06_AXI_rvalid;
(* X_INTERFACE_INFO = "xilinx.com:interface:aximm:1.0 M06_AXI RREADY" *)
output wire M06_AXI_rready;

  bd_48ac inst (
    .aclk(aclk),
    .aresetn(aresetn),
    .S00_AXI_awaddr(S00_AXI_awaddr),
    .S00_AXI_awprot(S00_AXI_awprot),
    .S00_AXI_awvalid(S00_AXI_awvalid),
    .S00_AXI_awready(S00_AXI_awready),
    .S00_AXI_wdata(S00_AXI_wdata),
    .S00_AXI_wstrb(S00_AXI_wstrb),
    .S00_AXI_wvalid(S00_AXI_wvalid),
    .S00_AXI_wready(S00_AXI_wready),
    .S00_AXI_bresp(S00_AXI_bresp),
    .S00_AXI_bvalid(S00_AXI_bvalid),
    .S00_AXI_bready(S00_AXI_bready),
    .S00_AXI_araddr(S00_AXI_araddr),
    .S00_AXI_arprot(S00_AXI_arprot),
    .S00_AXI_arvalid(S00_AXI_arvalid),
    .S00_AXI_arready(S00_AXI_arready),
    .S00_AXI_rdata(S00_AXI_rdata),
    .S00_AXI_rresp(S00_AXI_rresp),
    .S00_AXI_rvalid(S00_AXI_rvalid),
    .S00_AXI_rready(S00_AXI_rready),
    .M00_AXI_awaddr(M00_AXI_awaddr),
    .M00_AXI_awprot(M00_AXI_awprot),
    .M00_AXI_awvalid(M00_AXI_awvalid),
    .M00_AXI_awready(M00_AXI_awready),
    .M00_AXI_wdata(M00_AXI_wdata),
    .M00_AXI_wstrb(M00_AXI_wstrb),
    .M00_AXI_wvalid(M00_AXI_wvalid),
    .M00_AXI_wready(M00_AXI_wready),
    .M00_AXI_bresp(M00_AXI_bresp),
    .M00_AXI_bvalid(M00_AXI_bvalid),
    .M00_AXI_bready(M00_AXI_bready),
    .M00_AXI_araddr(M00_AXI_araddr),
    .M00_AXI_arprot(M00_AXI_arprot),
    .M00_AXI_arvalid(M00_AXI_arvalid),
    .M00_AXI_arready(M00_AXI_arready),
    .M00_AXI_rdata(M00_AXI_rdata),
    .M00_AXI_rresp(M00_AXI_rresp),
    .M00_AXI_rvalid(M00_AXI_rvalid),
    .M00_AXI_rready(M00_AXI_rready),
    .M01_AXI_awaddr(M01_AXI_awaddr),
    .M01_AXI_awprot(M01_AXI_awprot),
    .M01_AXI_awvalid(M01_AXI_awvalid),
    .M01_AXI_awready(M01_AXI_awready),
    .M01_AXI_wdata(M01_AXI_wdata),
    .M01_AXI_wstrb(M01_AXI_wstrb),
    .M01_AXI_wvalid(M01_AXI_wvalid),
    .M01_AXI_wready(M01_AXI_wready),
    .M01_AXI_bresp(M01_AXI_bresp),
    .M01_AXI_bvalid(M01_AXI_bvalid),
    .M01_AXI_bready(M01_AXI_bready),
    .M01_AXI_araddr(M01_AXI_araddr),
    .M01_AXI_arprot(M01_AXI_arprot),
    .M01_AXI_arvalid(M01_AXI_arvalid),
    .M01_AXI_arready(M01_AXI_arready),
    .M01_AXI_rdata(M01_AXI_rdata),
    .M01_AXI_rresp(M01_AXI_rresp),
    .M01_AXI_rvalid(M01_AXI_rvalid),
    .M01_AXI_rready(M01_AXI_rready),
    .M02_AXI_awaddr(M02_AXI_awaddr),
    .M02_AXI_awprot(M02_AXI_awprot),
    .M02_AXI_awvalid(M02_AXI_awvalid),
    .M02_AXI_awready(M02_AXI_awready),
    .M02_AXI_wdata(M02_AXI_wdata),
    .M02_AXI_wstrb(M02_AXI_wstrb),
    .M02_AXI_wvalid(M02_AXI_wvalid),
    .M02_AXI_wready(M02_AXI_wready),
    .M02_AXI_bresp(M02_AXI_bresp),
    .M02_AXI_bvalid(M02_AXI_bvalid),
    .M02_AXI_bready(M02_AXI_bready),
    .M02_AXI_araddr(M02_AXI_araddr),
    .M02_AXI_arprot(M02_AXI_arprot),
    .M02_AXI_arvalid(M02_AXI_arvalid),
    .M02_AXI_arready(M02_AXI_arready),
    .M02_AXI_rdata(M02_AXI_rdata),
    .M02_AXI_rresp(M02_AXI_rresp),
    .M02_AXI_rvalid(M02_AXI_rvalid),
    .M02_AXI_rready(M02_AXI_rready),
    .M03_AXI_awaddr(M03_AXI_awaddr),
    .M03_AXI_awprot(M03_AXI_awprot),
    .M03_AXI_awvalid(M03_AXI_awvalid),
    .M03_AXI_awready(M03_AXI_awready),
    .M03_AXI_wdata(M03_AXI_wdata),
    .M03_AXI_wstrb(M03_AXI_wstrb),
    .M03_AXI_wvalid(M03_AXI_wvalid),
    .M03_AXI_wready(M03_AXI_wready),
    .M03_AXI_bresp(M03_AXI_bresp),
    .M03_AXI_bvalid(M03_AXI_bvalid),
    .M03_AXI_bready(M03_AXI_bready),
    .M03_AXI_araddr(M03_AXI_araddr),
    .M03_AXI_arprot(M03_AXI_arprot),
    .M03_AXI_arvalid(M03_AXI_arvalid),
    .M03_AXI_arready(M03_AXI_arready),
    .M03_AXI_rdata(M03_AXI_rdata),
    .M03_AXI_rresp(M03_AXI_rresp),
    .M03_AXI_rvalid(M03_AXI_rvalid),
    .M03_AXI_rready(M03_AXI_rready),
    .M04_AXI_awaddr(M04_AXI_awaddr),
    .M04_AXI_awprot(M04_AXI_awprot),
    .M04_AXI_awvalid(M04_AXI_awvalid),
    .M04_AXI_awready(M04_AXI_awready),
    .M04_AXI_wdata(M04_AXI_wdata),
    .M04_AXI_wstrb(M04_AXI_wstrb),
    .M04_AXI_wvalid(M04_AXI_wvalid),
    .M04_AXI_wready(M04_AXI_wready),
    .M04_AXI_bresp(M04_AXI_bresp),
    .M04_AXI_bvalid(M04_AXI_bvalid),
    .M04_AXI_bready(M04_AXI_bready),
    .M04_AXI_araddr(M04_AXI_araddr),
    .M04_AXI_arprot(M04_AXI_arprot),
    .M04_AXI_arvalid(M04_AXI_arvalid),
    .M04_AXI_arready(M04_AXI_arready),
    .M04_AXI_rdata(M04_AXI_rdata),
    .M04_AXI_rresp(M04_AXI_rresp),
    .M04_AXI_rvalid(M04_AXI_rvalid),
    .M04_AXI_rready(M04_AXI_rready),
    .M05_AXI_awaddr(M05_AXI_awaddr),
    .M05_AXI_awprot(M05_AXI_awprot),
    .M05_AXI_awvalid(M05_AXI_awvalid),
    .M05_AXI_awready(M05_AXI_awready),
    .M05_AXI_wdata(M05_AXI_wdata),
    .M05_AXI_wstrb(M05_AXI_wstrb),
    .M05_AXI_wvalid(M05_AXI_wvalid),
    .M05_AXI_wready(M05_AXI_wready),
    .M05_AXI_bresp(M05_AXI_bresp),
    .M05_AXI_bvalid(M05_AXI_bvalid),
    .M05_AXI_bready(M05_AXI_bready),
    .M05_AXI_araddr(M05_AXI_araddr),
    .M05_AXI_arprot(M05_AXI_arprot),
    .M05_AXI_arvalid(M05_AXI_arvalid),
    .M05_AXI_arready(M05_AXI_arready),
    .M05_AXI_rdata(M05_AXI_rdata),
    .M05_AXI_rresp(M05_AXI_rresp),
    .M05_AXI_rvalid(M05_AXI_rvalid),
    .M05_AXI_rready(M05_AXI_rready),
    .M06_AXI_awaddr(M06_AXI_awaddr),
    .M06_AXI_awprot(M06_AXI_awprot),
    .M06_AXI_awvalid(M06_AXI_awvalid),
    .M06_AXI_awready(M06_AXI_awready),
    .M06_AXI_wdata(M06_AXI_wdata),
    .M06_AXI_wstrb(M06_AXI_wstrb),
    .M06_AXI_wvalid(M06_AXI_wvalid),
    .M06_AXI_wready(M06_AXI_wready),
    .M06_AXI_bresp(M06_AXI_bresp),
    .M06_AXI_bvalid(M06_AXI_bvalid),
    .M06_AXI_bready(M06_AXI_bready),
    .M06_AXI_araddr(M06_AXI_araddr),
    .M06_AXI_arprot(M06_AXI_arprot),
    .M06_AXI_arvalid(M06_AXI_arvalid),
    .M06_AXI_arready(M06_AXI_arready),
    .M06_AXI_rdata(M06_AXI_rdata),
    .M06_AXI_rresp(M06_AXI_rresp),
    .M06_AXI_rvalid(M06_AXI_rvalid),
    .M06_AXI_rready(M06_AXI_rready)
  );
endmodule
