talsh123/tokenizer-vivado/uart.gen/sources_1/bd/design_1/ip/design_1_smartconnect_0_1/bd_0/synth/bd_886d.v

//Copyright 1986-2022 Xilinx, Inc. All Rights Reserved.
//Copyright 2022-2025 Advanced Micro Devices, Inc. All Rights Reserved.
//--------------------------------------------------------------------------------
//Command: generate_target bd_886d.bd
//Design : bd_886d
//Purpose: IP block netlist
//--------------------------------------------------------------------------------
`timescale 1 ps / 1 ps

(* CORE_GENERATION_INFO = "bd_886d,IP_Integrator,{x_ipVendor=xilinx.com,x_ipLibrary=BlockDiagram,x_ipName=bd_886d,x_ipVersion=1.00.a,x_ipLanguage=VERILOG,numBlks=84,numReposBlks=66,numNonXlnxBlks=0,numHierBlks=18,maxHierDepth=1,numSysgenBlks=0,numHlsBlks=0,numHdlrefBlks=0,numPkgbdBlks=0,bdsource=SBD,synth_mode=None}" *) (* HW_HANDOFF = "design_1_smartconnect_0_1.hwdef" *) 
module bd_886d
   (M00_AXI_araddr,
    M00_AXI_arburst,
    M00_AXI_arcache,
    M00_AXI_arlen,
    M00_AXI_arlock,
    M00_AXI_arprot,
    M00_AXI_arqos,
    M00_AXI_arready,
    M00_AXI_arsize,
    M00_AXI_arvalid,
    M00_AXI_awaddr,
    M00_AXI_awburst,
    M00_AXI_awcache,
    M00_AXI_awlen,
    M00_AXI_awlock,
    M00_AXI_awprot,
    M00_AXI_awqos,
    M00_AXI_awready,
    M00_AXI_awsize,
    M00_AXI_awvalid,
    M00_AXI_bready,
    M00_AXI_bresp,
    M00_AXI_bvalid,
    M00_AXI_rdata,
    M00_AXI_rlast,
    M00_AXI_rready,
    M00_AXI_rresp,
    M00_AXI_rvalid,
    M00_AXI_wdata,
    M00_AXI_wlast,
    M00_AXI_wready,
    M00_AXI_wstrb,
    M00_AXI_wvalid,
    S00_AXI_araddr,
    S00_AXI_arburst,
    S00_AXI_arcache,
    S00_AXI_arlen,
    S00_AXI_arlock,
    S00_AXI_arprot,
    S00_AXI_arqos,
    S00_AXI_arready,
    S00_AXI_arsize,
    S00_AXI_arvalid,
    S00_AXI_awaddr,
    S00_AXI_awburst,
    S00_AXI_awcache,
    S00_AXI_awlen,
    S00_AXI_awlock,
    S00_AXI_awprot,
    S00_AXI_awqos,
    S00_AXI_awready,
    S00_AXI_awsize,
    S00_AXI_awvalid,
    S00_AXI_bready,
    S00_AXI_bresp,
    S00_AXI_bvalid,
    S00_AXI_rdata,
    S00_AXI_rlast,
    S00_AXI_rready,
    S00_AXI_rresp,
    S00_AXI_rvalid,
    S00_AXI_wdata,
    S00_AXI_wlast,
    S00_AXI_wready,
    S00_AXI_wstrb,
    S00_AXI_wvalid,
    S01_AXI_araddr,
    S01_AXI_arburst,
    S01_AXI_arcache,
    S01_AXI_arlen,
    S01_AXI_arlock,
    S01_AXI_arprot,
    S01_AXI_arqos,
    S01_AXI_arready,
    S01_AXI_arsize,
    S01_AXI_arvalid,
    S01_AXI_rdata,
    S01_AXI_rlast,
    S01_AXI_rready,
    S01_AXI_rresp,
    S01_AXI_rvalid,
    S02_AXI_araddr,
    S02_AXI_arburst,
    S02_AXI_arcache,
    S02_AXI_arlen,
    S02_AXI_arlock,
    S02_AXI_arprot,
    S02_AXI_arqos,
    S02_AXI_arready,
    S02_AXI_arsize,
    S02_AXI_arvalid,
    S02_AXI_rdata,
    S02_AXI_rlast,
    S02_AXI_rready,
    S02_AXI_rresp,
    S02_AXI_rvalid,
    S03_AXI_awaddr,
    S03_AXI_awburst,
    S03_AXI_awcache,
    S03_AXI_awlen,
    S03_AXI_awlock,
    S03_AXI_awprot,
    S03_AXI_awqos,
    S03_AXI_awready,
    S03_AXI_awsize,
    S03_AXI_awvalid,
    S03_AXI_bready,
    S03_AXI_bresp,
    S03_AXI_bvalid,
    S03_AXI_wdata,
    S03_AXI_wlast,
    S03_AXI_wready,
    S03_AXI_wstrb,
    S03_AXI_wvalid,
    S04_AXI_araddr,
    S04_AXI_arburst,
    S04_AXI_arcache,
    S04_AXI_arlen,
    S04_AXI_arlock,
    S04_AXI_arprot,
    S04_AXI_arqos,
    S04_AXI_arready,
    S04_AXI_arsize,
    S04_AXI_arvalid,
    S04_AXI_awaddr,
    S04_AXI_awburst,
    S04_AXI_awcache,
    S04_AXI_awlen,
    S04_AXI_awlock,
    S04_AXI_awprot,
    S04_AXI_awqos,
    S04_AXI_awready,
    S04_AXI_awsize,
    S04_AXI_awvalid,
    S04_AXI_bready,
    S04_AXI_bresp,
    S04_AXI_bvalid,
    S04_AXI_rdata,
    S04_AXI_rlast,
    S04_AXI_rready,
    S04_AXI_rresp,
    S04_AXI_rvalid,
    S04_AXI_wdata,
    S04_AXI_wlast,
    S04_AXI_wready,
    S04_AXI_wstrb,
    S04_AXI_wvalid,
    S05_AXI_araddr,
    S05_AXI_arburst,
    S05_AXI_arcache,
    S05_AXI_arlen,
    S05_AXI_arlock,
    S05_AXI_arprot,
    S05_AXI_arqos,
    S05_AXI_arready,
    S05_AXI_arsize,
    S05_AXI_arvalid,
    S05_AXI_rdata,
    S05_AXI_rlast,
    S05_AXI_rready,
    S05_AXI_rresp,
    S05_AXI_rvalid,
    S06_AXI_awaddr,
    S06_AXI_awburst,
    S06_AXI_awcache,
    S06_AXI_awlen,
    S06_AXI_awlock,
    S06_AXI_awprot,
    S06_AXI_awqos,
    S06_AXI_awready,
    S06_AXI_awsize,
    S06_AXI_awvalid,
    S06_AXI_bready,
    S06_AXI_bresp,
    S06_AXI_bvalid,
    S06_AXI_wdata,
    S06_AXI_wlast,
    S06_AXI_wready,
    S06_AXI_wstrb,
    S06_AXI_wvalid,
    aclk,
    aclk1,
    aresetn);
  (* X_INTERFACE_INFO = "xilinx.com:interface:aximm:1.0 M00_AXI ARADDR" *) (* X_INTERFACE_MODE = "Master" *) (* X_INTERFACE_PARAMETER = "XIL_INTERFACENAME M00_AXI, ADDR_WIDTH 29, ARUSER_WIDTH 0, AWUSER_WIDTH 0, BUSER_WIDTH 0, CLK_DOMAIN design_1_mig_7series_0_1_ui_clk, DATA_WIDTH 32, FREQ_HZ 100000000, HAS_BRESP 1, HAS_BURST 1, HAS_CACHE 1, HAS_LOCK 1, HAS_PROT 1, HAS_QOS 1, HAS_REGION 0, HAS_RRESP 1, HAS_WSTRB 1, ID_WIDTH 0, INSERT_VIP 0, MAX_BURST_LENGTH 16, NUM_READ_OUTSTANDING 16, NUM_READ_THREADS 1, NUM_WRITE_OUTSTANDING 32, NUM_WRITE_THREADS 1, PHASE 0, PROTOCOL AXI4, READ_WRITE_MODE READ_WRITE, RUSER_BITS_PER_BYTE 0, RUSER_WIDTH 0, SUPPORTS_NARROW_BURST 0, WUSER_BITS_PER_BYTE 0, WUSER_WIDTH 0" *) output [28:0]M00_AXI_araddr;
  (* X_INTERFACE_INFO = "xilinx.com:interface:aximm:1.0 M00_AXI ARBURST" *) output [1:0]M00_AXI_arburst;
  (* X_INTERFACE_INFO = "xilinx.com:interface:aximm:1.0 M00_AXI ARCACHE" *) output [3:0]M00_AXI_arcache;
  (* X_INTERFACE_INFO = "xilinx.com:interface:aximm:1.0 M00_AXI ARLEN" *) output [7:0]M00_AXI_arlen;
  (* X_INTERFACE_INFO = "xilinx.com:interface:aximm:1.0 M00_AXI ARLOCK" *) output [0:0]M00_AXI_arlock;
  (* X_INTERFACE_INFO = "xilinx.com:interface:aximm:1.0 M00_AXI ARPROT" *) output [2:0]M00_AXI_arprot;
  (* X_INTERFACE_INFO = "xilinx.com:interface:aximm:1.0 M00_AXI ARQOS" *) output [3:0]M00_AXI_arqos;
  (* X_INTERFACE_INFO = "xilinx.com:interface:aximm:1.0 M00_AXI ARREADY" *) input M00_AXI_arready;
  (* X_INTERFACE_INFO = "xilinx.com:interface:aximm:1.0 M00_AXI ARSIZE" *) output [2:0]M00_AXI_arsize;
  (* X_INTERFACE_INFO = "xilinx.com:interface:aximm:1.0 M00_AXI ARVALID" *) output M00_AXI_arvalid;
  (* X_INTERFACE_INFO = "xilinx.com:interface:aximm:1.0 M00_AXI AWADDR" *) output [28:0]M00_AXI_awaddr;
  (* X_INTERFACE_INFO = "xilinx.com:interface:aximm:1.0 M00_AXI AWBURST" *) output [1:0]M00_AXI_awburst;
  (* X_INTERFACE_INFO = "xilinx.com:interface:aximm:1.0 M00_AXI AWCACHE" *) output [3:0]M00_AXI_awcache;
  (* X_INTERFACE_INFO = "xilinx.com:interface:aximm:1.0 M00_AXI AWLEN" *) output [7:0]M00_AXI_awlen;
  (* X_INTERFACE_INFO = "xilinx.com:interface:aximm:1.0 M00_AXI AWLOCK" *) output [0:0]M00_AXI_awlock;
  (* X_INTERFACE_INFO = "xilinx.com:interface:aximm:1.0 M00_AXI AWPROT" *) output [2:0]M00_AXI_awprot;
  (* X_INTERFACE_INFO = "xilinx.com:interface:aximm:1.0 M00_AXI AWQOS" *) output [3:0]M00_AXI_awqos;
  (* X_INTERFACE_INFO = "xilinx.com:interface:aximm:1.0 M00_AXI AWREADY" *) input M00_AXI_awready;
  (* X_INTERFACE_INFO = "xilinx.com:interface:aximm:1.0 M00_AXI AWSIZE" *) output [2:0]M00_AXI_awsize;
  (* X_INTERFACE_INFO = "xilinx.com:interface:aximm:1.0 M00_AXI AWVALID" *) output M00_AXI_awvalid;
  (* X_INTERFACE_INFO = "xilinx.com:interface:aximm:1.0 M00_AXI BREADY" *) output M00_AXI_bready;
  (* X_INTERFACE_INFO = "xilinx.com:interface:aximm:1.0 M00_AXI BRESP" *) input [1:0]M00_AXI_bresp;
  (* X_INTERFACE_INFO = "xilinx.com:interface:aximm:1.0 M00_AXI BVALID" *) input M00_AXI_bvalid;
  (* X_INTERFACE_INFO = "xilinx.com:interface:aximm:1.0 M00_AXI RDATA" *) input [31:0]M00_AXI_rdata;
  (* X_INTERFACE_INFO = "xilinx.com:interface:aximm:1.0 M00_AXI RLAST" *) input M00_AXI_rlast;
  (* X_INTERFACE_INFO = "xilinx.com:interface:aximm:1.0 M00_AXI RREADY" *) output M00_AXI_rready;
  (* X_INTERFACE_INFO = "xilinx.com:interface:aximm:1.0 M00_AXI RRESP" *) input [1:0]M00_AXI_rresp;
  (* X_INTERFACE_INFO = "xilinx.com:interface:aximm:1.0 M00_AXI RVALID" *) input M00_AXI_rvalid;
  (* X_INTERFACE_INFO = "xilinx.com:interface:aximm:1.0 M00_AXI WDATA" *) output [31:0]M00_AXI_wdata;
  (* X_INTERFACE_INFO = "xilinx.com:interface:aximm:1.0 M00_AXI WLAST" *) output M00_AXI_wlast;
  (* X_INTERFACE_INFO = "xilinx.com:interface:aximm:1.0 M00_AXI WREADY" *) input M00_AXI_wready;
  (* X_INTERFACE_INFO = "xilinx.com:interface:aximm:1.0 M00_AXI WSTRB" *) output [3:0]M00_AXI_wstrb;
  (* X_INTERFACE_INFO = "xilinx.com:interface:aximm:1.0 M00_AXI WVALID" *) output M00_AXI_wvalid;
  (* X_INTERFACE_INFO = "xilinx.com:interface:aximm:1.0 S00_AXI ARADDR" *) (* X_INTERFACE_MODE = "Slave" *) (* X_INTERFACE_PARAMETER = "XIL_INTERFACENAME S00_AXI, ADDR_WIDTH 32, ARUSER_WIDTH 0, AWUSER_WIDTH 0, BUSER_WIDTH 0, CLK_DOMAIN /clk_wiz_1_clk_out1, DATA_WIDTH 32, FREQ_HZ 100000000, HAS_BRESP 1, HAS_BURST 1, HAS_CACHE 1, HAS_LOCK 1, HAS_PROT 1, HAS_QOS 1, HAS_REGION 0, HAS_RRESP 1, HAS_WSTRB 1, ID_WIDTH 0, INSERT_VIP 0, MAX_BURST_LENGTH 4, NUM_READ_OUTSTANDING 2, NUM_READ_THREADS 1, NUM_WRITE_OUTSTANDING 32, NUM_WRITE_THREADS 1, PHASE 0.0, PROTOCOL AXI4, READ_WRITE_MODE READ_WRITE, RUSER_BITS_PER_BYTE 0, RUSER_WIDTH 0, SUPPORTS_NARROW_BURST 0, WUSER_BITS_PER_BYTE 0, WUSER_WIDTH 0" *) input [31:0]S00_AXI_araddr;
  (* X_INTERFACE_INFO = "xilinx.com:interface:aximm:1.0 S00_AXI ARBURST" *) input [1:0]S00_AXI_arburst;
  (* X_INTERFACE_INFO = "xilinx.com:interface:aximm:1.0 S00_AXI ARCACHE" *) input [3:0]S00_AXI_arcache;
  (* X_INTERFACE_INFO = "xilinx.com:interface:aximm:1.0 S00_AXI ARLEN" *) input [7:0]S00_AXI_arlen;
  (* X_INTERFACE_INFO = "xilinx.com:interface:aximm:1.0 S00_AXI ARLOCK" *) input [0:0]S00_AXI_arlock;
  (* X_INTERFACE_INFO = "xilinx.com:interface:aximm:1.0 S00_AXI ARPROT" *) input [2:0]S00_AXI_arprot;
  (* X_INTERFACE_INFO = "xilinx.com:interface:aximm:1.0 S00_AXI ARQOS" *) input [3:0]S00_AXI_arqos;
  (* X_INTERFACE_INFO = "xilinx.com:interface:aximm:1.0 S00_AXI ARREADY" *) output S00_AXI_arready;
  (* X_INTERFACE_INFO = "xilinx.com:interface:aximm:1.0 S00_AXI ARSIZE" *) input [2:0]S00_AXI_arsize;
  (* X_INTERFACE_INFO = "xilinx.com:interface:aximm:1.0 S00_AXI ARVALID" *) input S00_AXI_arvalid;
  (* X_INTERFACE_INFO = "xilinx.com:interface:aximm:1.0 S00_AXI AWADDR" *) input [31:0]S00_AXI_awaddr;
  (* X_INTERFACE_INFO = "xilinx.com:interface:aximm:1.0 S00_AXI AWBURST" *) input [1:0]S00_AXI_awburst;
  (* X_INTERFACE_INFO = "xilinx.com:interface:aximm:1.0 S00_AXI AWCACHE" *) input [3:0]S00_AXI_awcache;
  (* X_INTERFACE_INFO = "xilinx.com:interface:aximm:1.0 S00_AXI AWLEN" *) input [7:0]S00_AXI_awlen;
  (* X_INTERFACE_INFO = "xilinx.com:interface:aximm:1.0 S00_AXI AWLOCK" *) input [0:0]S00_AXI_awlock;
  (* X_INTERFACE_INFO = "xilinx.com:interface:aximm:1.0 S00_AXI AWPROT" *) input [2:0]S00_AXI_awprot;
  (* X_INTERFACE_INFO = "xilinx.com:interface:aximm:1.0 S00_AXI AWQOS" *) input [3:0]S00_AXI_awqos;
  (* X_INTERFACE_INFO = "xilinx.com:interface:aximm:1.0 S00_AXI AWREADY" *) output S00_AXI_awready;
  (* X_INTERFACE_INFO = "xilinx.com:interface:aximm:1.0 S00_AXI AWSIZE" *) input [2:0]S00_AXI_awsize;
  (* X_INTERFACE_INFO = "xilinx.com:interface:aximm:1.0 S00_AXI AWVALID" *) input S00_AXI_awvalid;
  (* X_INTERFACE_INFO = "xilinx.com:interface:aximm:1.0 S00_AXI BREADY" *) input S00_AXI_bready;
  (* X_INTERFACE_INFO = "xilinx.com:interface:aximm:1.0 S00_AXI BRESP" *) output [1:0]S00_AXI_bresp;
  (* X_INTERFACE_INFO = "xilinx.com:interface:aximm:1.0 S00_AXI BVALID" *) output S00_AXI_bvalid;
  (* X_INTERFACE_INFO = "xilinx.com:interface:aximm:1.0 S00_AXI RDATA" *) output [31:0]S00_AXI_rdata;
  (* X_INTERFACE_INFO = "xilinx.com:interface:aximm:1.0 S00_AXI RLAST" *) output S00_AXI_rlast;
  (* X_INTERFACE_INFO = "xilinx.com:interface:aximm:1.0 S00_AXI RREADY" *) input S00_AXI_rready;
  (* X_INTERFACE_INFO = "xilinx.com:interface:aximm:1.0 S00_AXI RRESP" *) output [1:0]S00_AXI_rresp;
  (* X_INTERFACE_INFO = "xilinx.com:interface:aximm:1.0 S00_AXI RVALID" *) output S00_AXI_rvalid;
  (* X_INTERFACE_INFO = "xilinx.com:interface:aximm:1.0 S00_AXI WDATA" *) input [31:0]S00_AXI_wdata;
  (* X_INTERFACE_INFO = "xilinx.com:interface:aximm:1.0 S00_AXI WLAST" *) input S00_AXI_wlast;
  (* X_INTERFACE_INFO = "xilinx.com:interface:aximm:1.0 S00_AXI WREADY" *) output S00_AXI_wready;
  (* X_INTERFACE_INFO = "xilinx.com:interface:aximm:1.0 S00_AXI WSTRB" *) input [3:0]S00_AXI_wstrb;
  (* X_INTERFACE_INFO = "xilinx.com:interface:aximm:1.0 S00_AXI WVALID" *) input S00_AXI_wvalid;
  (* X_INTERFACE_INFO = "xilinx.com:interface:aximm:1.0 S01_AXI ARADDR" *) (* X_INTERFACE_MODE = "Slave" *) (* X_INTERFACE_PARAMETER = "XIL_INTERFACENAME S01_AXI, ADDR_WIDTH 32, ARUSER_WIDTH 0, AWUSER_WIDTH 0, BUSER_WIDTH 0, CLK_DOMAIN /clk_wiz_1_clk_out1, DATA_WIDTH 32, FREQ_HZ 100000000, HAS_BRESP 0, HAS_BURST 1, HAS_CACHE 1, HAS_LOCK 0, HAS_PROT 1, HAS_QOS 1, HAS_REGION 0, HAS_RRESP 1, HAS_WSTRB 0, ID_WIDTH 0, INSERT_VIP 0, MAX_BURST_LENGTH 4, NUM_READ_OUTSTANDING 2, NUM_READ_THREADS 1, NUM_WRITE_OUTSTANDING 2, NUM_WRITE_THREADS 1, PHASE 0.0, PROTOCOL AXI4, READ_WRITE_MODE READ_ONLY, RUSER_BITS_PER_BYTE 0, RUSER_WIDTH 0, SUPPORTS_NARROW_BURST 0, WUSER_BITS_PER_BYTE 0, WUSER_WIDTH 0" *) input [31:0]S01_AXI_araddr;
  (* X_INTERFACE_INFO = "xilinx.com:interface:aximm:1.0 S01_AXI ARBURST" *) input [1:0]S01_AXI_arburst;
  (* X_INTERFACE_INFO = "xilinx.com:interface:aximm:1.0 S01_AXI ARCACHE" *) input [3:0]S01_AXI_arcache;
  (* X_INTERFACE_INFO = "xilinx.com:interface:aximm:1.0 S01_AXI ARLEN" *) input [7:0]S01_AXI_arlen;
  (* X_INTERFACE_INFO = "xilinx.com:interface:aximm:1.0 S01_AXI ARLOCK" *) input [0:0]S01_AXI_arlock;
  (* X_INTERFACE_INFO = "xilinx.com:interface:aximm:1.0 S01_AXI ARPROT" *) input [2:0]S01_AXI_arprot;
  (* X_INTERFACE_INFO = "xilinx.com:interface:aximm:1.0 S01_AXI ARQOS" *) input [3:0]S01_AXI_arqos;
  (* X_INTERFACE_INFO = "xilinx.com:interface:aximm:1.0 S01_AXI ARREADY" *) output S01_AXI_arready;
  (* X_INTERFACE_INFO = "xilinx.com:interface:aximm:1.0 S01_AXI ARSIZE" *) input [2:0]S01_AXI_arsize;
  (* X_INTERFACE_INFO = "xilinx.com:interface:aximm:1.0 S01_AXI ARVALID" *) input S01_AXI_arvalid;
  (* X_INTERFACE_INFO = "xilinx.com:interface:aximm:1.0 S01_AXI RDATA" *) output [31:0]S01_AXI_rdata;
  (* X_INTERFACE_INFO = "xilinx.com:interface:aximm:1.0 S01_AXI RLAST" *) output S01_AXI_rlast;
  (* X_INTERFACE_INFO = "xilinx.com:interface:aximm:1.0 S01_AXI RREADY" *) input S01_AXI_rready;
  (* X_INTERFACE_INFO = "xilinx.com:interface:aximm:1.0 S01_AXI RRESP" *) output [1:0]S01_AXI_rresp;
  (* X_INTERFACE_INFO = "xilinx.com:interface:aximm:1.0 S01_AXI RVALID" *) output S01_AXI_rvalid;
  (* X_INTERFACE_INFO = "xilinx.com:interface:aximm:1.0 S02_AXI ARADDR" *) (* X_INTERFACE_MODE = "Slave" *) (* X_INTERFACE_PARAMETER = "XIL_INTERFACENAME S02_AXI, ADDR_WIDTH 32, ARUSER_WIDTH 0, AWUSER_WIDTH 0, BUSER_WIDTH 0, CLK_DOMAIN /clk_wiz_1_clk_out1, DATA_WIDTH 32, FREQ_HZ 100000000, HAS_BRESP 0, HAS_BURST 0, HAS_CACHE 1, HAS_LOCK 0, HAS_PROT 1, HAS_QOS 0, HAS_REGION 0, HAS_RRESP 1, HAS_WSTRB 0, ID_WIDTH 0, INSERT_VIP 0, MAX_BURST_LENGTH 16, NUM_READ_OUTSTANDING 16, NUM_READ_THREADS 1, NUM_WRITE_OUTSTANDING 2, NUM_WRITE_THREADS 1, PHASE 0.0, PROTOCOL AXI4, READ_WRITE_MODE READ_ONLY, RUSER_BITS_PER_BYTE 0, RUSER_WIDTH 0, SUPPORTS_NARROW_BURST 0, WUSER_BITS_PER_BYTE 0, WUSER_WIDTH 0" *) input [31:0]S02_AXI_araddr;
  (* X_INTERFACE_INFO = "xilinx.com:interface:aximm:1.0 S02_AXI ARBURST" *) input [1:0]S02_AXI_arburst;
  (* X_INTERFACE_INFO = "xilinx.com:interface:aximm:1.0 S02_AXI ARCACHE" *) input [3:0]S02_AXI_arcache;
  (* X_INTERFACE_INFO = "xilinx.com:interface:aximm:1.0 S02_AXI ARLEN" *) input [7:0]S02_AXI_arlen;
  (* X_INTERFACE_INFO = "xilinx.com:interface:aximm:1.0 S02_AXI ARLOCK" *) input [0:0]S02_AXI_arlock;
  (* X_INTERFACE_INFO = "xilinx.com:interface:aximm:1.0 S02_AXI ARPROT" *) input [2:0]S02_AXI_arprot;
  (* X_INTERFACE_INFO = "xilinx.com:interface:aximm:1.0 S02_AXI ARQOS" *) input [3:0]S02_AXI_arqos;
  (* X_INTERFACE_INFO = "xilinx.com:interface:aximm:1.0 S02_AXI ARREADY" *) output S02_AXI_arready;
  (* X_INTERFACE_INFO = "xilinx.com:interface:aximm:1.0 S02_AXI ARSIZE" *) input [2:0]S02_AXI_arsize;
  (* X_INTERFACE_INFO = "xilinx.com:interface:aximm:1.0 S02_AXI ARVALID" *) input S02_AXI_arvalid;
  (* X_INTERFACE_INFO = "xilinx.com:interface:aximm:1.0 S02_AXI RDATA" *) output [31:0]S02_AXI_rdata;
  (* X_INTERFACE_INFO = "xilinx.com:interface:aximm:1.0 S02_AXI RLAST" *) output S02_AXI_rlast;
  (* X_INTERFACE_INFO = "xilinx.com:interface:aximm:1.0 S02_AXI RREADY" *) input S02_AXI_rready;
  (* X_INTERFACE_INFO = "xilinx.com:interface:aximm:1.0 S02_AXI RRESP" *) output [1:0]S02_AXI_rresp;
  (* X_INTERFACE_INFO = "xilinx.com:interface:aximm:1.0 S02_AXI RVALID" *) output S02_AXI_rvalid;
  (* X_INTERFACE_INFO = "xilinx.com:interface:aximm:1.0 S03_AXI AWADDR" *) (* X_INTERFACE_MODE = "Slave" *) (* X_INTERFACE_PARAMETER = "XIL_INTERFACENAME S03_AXI, ADDR_WIDTH 32, ARUSER_WIDTH 0, AWUSER_WIDTH 0, BUSER_WIDTH 0, CLK_DOMAIN /clk_wiz_1_clk_out1, DATA_WIDTH 32, FREQ_HZ 100000000, HAS_BRESP 1, HAS_BURST 0, HAS_CACHE 1, HAS_LOCK 0, HAS_PROT 1, HAS_QOS 0, HAS_REGION 0, HAS_RRESP 0, HAS_WSTRB 1, ID_WIDTH 0, INSERT_VIP 0, MAX_BURST_LENGTH 16, NUM_READ_OUTSTANDING 2, NUM_READ_THREADS 1, NUM_WRITE_OUTSTANDING 16, NUM_WRITE_THREADS 1, PHASE 0.0, PROTOCOL AXI4, READ_WRITE_MODE WRITE_ONLY, RUSER_BITS_PER_BYTE 0, RUSER_WIDTH 0, SUPPORTS_NARROW_BURST 0, WUSER_BITS_PER_BYTE 0, WUSER_WIDTH 0" *) input [31:0]S03_AXI_awaddr;
  (* X_INTERFACE_INFO = "xilinx.com:interface:aximm:1.0 S03_AXI AWBURST" *) input [1:0]S03_AXI_awburst;
  (* X_INTERFACE_INFO = "xilinx.com:interface:aximm:1.0 S03_AXI AWCACHE" *) input [3:0]S03_AXI_awcache;
  (* X_INTERFACE_INFO = "xilinx.com:interface:aximm:1.0 S03_AXI AWLEN" *) input [7:0]S03_AXI_awlen;
  (* X_INTERFACE_INFO = "xilinx.com:interface:aximm:1.0 S03_AXI AWLOCK" *) input [0:0]S03_AXI_awlock;
  (* X_INTERFACE_INFO = "xilinx.com:interface:aximm:1.0 S03_AXI AWPROT" *) input [2:0]S03_AXI_awprot;
  (* X_INTERFACE_INFO = "xilinx.com:interface:aximm:1.0 S03_AXI AWQOS" *) input [3:0]S03_AXI_awqos;
  (* X_INTERFACE_INFO = "xilinx.com:interface:aximm:1.0 S03_AXI AWREADY" *) output S03_AXI_awready;
  (* X_INTERFACE_INFO = "xilinx.com:interface:aximm:1.0 S03_AXI AWSIZE" *) input [2:0]S03_AXI_awsize;
  (* X_INTERFACE_INFO = "xilinx.com:interface:aximm:1.0 S03_AXI AWVALID" *) input S03_AXI_awvalid;
  (* X_INTERFACE_INFO = "xilinx.com:interface:aximm:1.0 S03_AXI BREADY" *) input S03_AXI_bready;
  (* X_INTERFACE_INFO = "xilinx.com:interface:aximm:1.0 S03_AXI BRESP" *) output [1:0]S03_AXI_bresp;
  (* X_INTERFACE_INFO = "xilinx.com:interface:aximm:1.0 S03_AXI BVALID" *) output S03_AXI_bvalid;
  (* X_INTERFACE_INFO = "xilinx.com:interface:aximm:1.0 S03_AXI WDATA" *) input [31:0]S03_AXI_wdata;
  (* X_INTERFACE_INFO = "xilinx.com:interface:aximm:1.0 S03_AXI WLAST" *) input S03_AXI_wlast;
  (* X_INTERFACE_INFO = "xilinx.com:interface:aximm:1.0 S03_AXI WREADY" *) output S03_AXI_wready;
  (* X_INTERFACE_INFO = "xilinx.com:interface:aximm:1.0 S03_AXI WSTRB" *) input [3:0]S03_AXI_wstrb;
  (* X_INTERFACE_INFO = "xilinx.com:interface:aximm:1.0 S03_AXI WVALID" *) input S03_AXI_wvalid;
  (* X_INTERFACE_INFO = "xilinx.com:interface:aximm:1.0 S04_AXI ARADDR" *) (* X_INTERFACE_MODE = "Slave" *) (* X_INTERFACE_PARAMETER = "XIL_INTERFACENAME S04_AXI, ADDR_WIDTH 32, ARUSER_WIDTH 0, AWUSER_WIDTH 0, BUSER_WIDTH 0, CLK_DOMAIN /clk_wiz_1_clk_out1, DATA_WIDTH 32, FREQ_HZ 100000000, HAS_BRESP 1, HAS_BURST 0, HAS_CACHE 1, HAS_LOCK 0, HAS_PROT 1, HAS_QOS 0, HAS_REGION 0, HAS_RRESP 1, HAS_WSTRB 1, ID_WIDTH 0, INSERT_VIP 0, MAX_BURST_LENGTH 16, NUM_READ_OUTSTANDING 2, NUM_READ_THREADS 1, NUM_WRITE_OUTSTANDING 2, NUM_WRITE_THREADS 1, PHASE 0.0, PROTOCOL AXI4, READ_WRITE_MODE READ_WRITE, RUSER_BITS_PER_BYTE 0, RUSER_WIDTH 0, SUPPORTS_NARROW_BURST 0, WUSER_BITS_PER_BYTE 0, WUSER_WIDTH 0" *) input [31:0]S04_AXI_araddr;
  (* X_INTERFACE_INFO = "xilinx.com:interface:aximm:1.0 S04_AXI ARBURST" *) input [1:0]S04_AXI_arburst;
  (* X_INTERFACE_INFO = "xilinx.com:interface:aximm:1.0 S04_AXI ARCACHE" *) input [3:0]S04_AXI_arcache;
  (* X_INTERFACE_INFO = "xilinx.com:interface:aximm:1.0 S04_AXI ARLEN" *) input [7:0]S04_AXI_arlen;
  (* X_INTERFACE_INFO = "xilinx.com:interface:aximm:1.0 S04_AXI ARLOCK" *) input [0:0]S04_AXI_arlock;
  (* X_INTERFACE_INFO = "xilinx.com:interface:aximm:1.0 S04_AXI ARPROT" *) input [2:0]S04_AXI_arprot;
  (* X_INTERFACE_INFO = "xilinx.com:interface:aximm:1.0 S04_AXI ARQOS" *) input [3:0]S04_AXI_arqos;
  (* X_INTERFACE_INFO = "xilinx.com:interface:aximm:1.0 S04_AXI ARREADY" *) output S04_AXI_arready;
  (* X_INTERFACE_INFO = "xilinx.com:interface:aximm:1.0 S04_AXI ARSIZE" *) input [2:0]S04_AXI_arsize;
  (* X_INTERFACE_INFO = "xilinx.com:interface:aximm:1.0 S04_AXI ARVALID" *) input S04_AXI_arvalid;
  (* X_INTERFACE_INFO = "xilinx.com:interface:aximm:1.0 S04_AXI AWADDR" *) input [31:0]S04_AXI_awaddr;
  (* X_INTERFACE_INFO = "xilinx.com:interface:aximm:1.0 S04_AXI AWBURST" *) input [1:0]S04_AXI_awburst;
  (* X_INTERFACE_INFO = "xilinx.com:interface:aximm:1.0 S04_AXI AWCACHE" *) input [3:0]S04_AXI_awcache;
  (* X_INTERFACE_INFO = "xilinx.com:interface:aximm:1.0 S04_AXI AWLEN" *) input [7:0]S04_AXI_awlen;
  (* X_INTERFACE_INFO = "xilinx.com:interface:aximm:1.0 S04_AXI AWLOCK" *) input [0:0]S04_AXI_awlock;
  (* X_INTERFACE_INFO = "xilinx.com:interface:aximm:1.0 S04_AXI AWPROT" *) input [2:0]S04_AXI_awprot;
  (* X_INTERFACE_INFO = "xilinx.com:interface:aximm:1.0 S04_AXI AWQOS" *) input [3:0]S04_AXI_awqos;
  (* X_INTERFACE_INFO = "xilinx.com:interface:aximm:1.0 S04_AXI AWREADY" *) output S04_AXI_awready;
  (* X_INTERFACE_INFO = "xilinx.com:interface:aximm:1.0 S04_AXI AWSIZE" *) input [2:0]S04_AXI_awsize;
  (* X_INTERFACE_INFO = "xilinx.com:interface:aximm:1.0 S04_AXI AWVALID" *) input S04_AXI_awvalid;
  (* X_INTERFACE_INFO = "xilinx.com:interface:aximm:1.0 S04_AXI BREADY" *) input S04_AXI_bready;
  (* X_INTERFACE_INFO = "xilinx.com:interface:aximm:1.0 S04_AXI BRESP" *) output [1:0]S04_AXI_bresp;
  (* X_INTERFACE_INFO = "xilinx.com:interface:aximm:1.0 S04_AXI BVALID" *) output S04_AXI_bvalid;
  (* X_INTERFACE_INFO = "xilinx.com:interface:aximm:1.0 S04_AXI RDATA" *) output [31:0]S04_AXI_rdata;
  (* X_INTERFACE_INFO = "xilinx.com:interface:aximm:1.0 S04_AXI RLAST" *) output S04_AXI_rlast;
  (* X_INTERFACE_INFO = "xilinx.com:interface:aximm:1.0 S04_AXI RREADY" *) input S04_AXI_rready;
  (* X_INTERFACE_INFO = "xilinx.com:interface:aximm:1.0 S04_AXI RRESP" *) output [1:0]S04_AXI_rresp;
  (* X_INTERFACE_INFO = "xilinx.com:interface:aximm:1.0 S04_AXI RVALID" *) output S04_AXI_rvalid;
  (* X_INTERFACE_INFO = "xilinx.com:interface:aximm:1.0 S04_AXI WDATA" *) input [31:0]S04_AXI_wdata;
  (* X_INTERFACE_INFO = "xilinx.com:interface:aximm:1.0 S04_AXI WLAST" *) input S04_AXI_wlast;
  (* X_INTERFACE_INFO = "xilinx.com:interface:aximm:1.0 S04_AXI WREADY" *) output S04_AXI_wready;
  (* X_INTERFACE_INFO = "xilinx.com:interface:aximm:1.0 S04_AXI WSTRB" *) input [3:0]S04_AXI_wstrb;
  (* X_INTERFACE_INFO = "xilinx.com:interface:aximm:1.0 S04_AXI WVALID" *) input S04_AXI_wvalid;
  (* X_INTERFACE_INFO = "xilinx.com:interface:aximm:1.0 S05_AXI ARADDR" *) (* X_INTERFACE_MODE = "Slave" *) (* X_INTERFACE_PARAMETER = "XIL_INTERFACENAME S05_AXI, ADDR_WIDTH 32, ARUSER_WIDTH 0, AWUSER_WIDTH 0, BUSER_WIDTH 0, CLK_DOMAIN /clk_wiz_1_clk_out1, DATA_WIDTH 32, FREQ_HZ 100000000, HAS_BRESP 0, HAS_BURST 0, HAS_CACHE 1, HAS_LOCK 0, HAS_PROT 1, HAS_QOS 0, HAS_REGION 0, HAS_RRESP 1, HAS_WSTRB 0, ID_WIDTH 0, INSERT_VIP 0, MAX_BURST_LENGTH 16, NUM_READ_OUTSTANDING 16, NUM_READ_THREADS 1, NUM_WRITE_OUTSTANDING 2, NUM_WRITE_THREADS 1, PHASE 0.0, PROTOCOL AXI4, READ_WRITE_MODE READ_ONLY, RUSER_BITS_PER_BYTE 0, RUSER_WIDTH 0, SUPPORTS_NARROW_BURST 0, WUSER_BITS_PER_BYTE 0, WUSER_WIDTH 0" *) input [31:0]S05_AXI_araddr;
  (* X_INTERFACE_INFO = "xilinx.com:interface:aximm:1.0 S05_AXI ARBURST" *) input [1:0]S05_AXI_arburst;
  (* X_INTERFACE_INFO = "xilinx.com:interface:aximm:1.0 S05_AXI ARCACHE" *) input [3:0]S05_AXI_arcache;
  (* X_INTERFACE_INFO = "xilinx.com:interface:aximm:1.0 S05_AXI ARLEN" *) input [7:0]S05_AXI_arlen;
  (* X_INTERFACE_INFO = "xilinx.com:interface:aximm:1.0 S05_AXI ARLOCK" *) input [0:0]S05_AXI_arlock;
  (* X_INTERFACE_INFO = "xilinx.com:interface:aximm:1.0 S05_AXI ARPROT" *) input [2:0]S05_AXI_arprot;
  (* X_INTERFACE_INFO = "xilinx.com:interface:aximm:1.0 S05_AXI ARQOS" *) input [3:0]S05_AXI_arqos;
  (* X_INTERFACE_INFO = "xilinx.com:interface:aximm:1.0 S05_AXI ARREADY" *) output S05_AXI_arready;
  (* X_INTERFACE_INFO = "xilinx.com:interface:aximm:1.0 S05_AXI ARSIZE" *) input [2:0]S05_AXI_arsize;
  (* X_INTERFACE_INFO = "xilinx.com:interface:aximm:1.0 S05_AXI ARVALID" *) input S05_AXI_arvalid;
  (* X_INTERFACE_INFO = "xilinx.com:interface:aximm:1.0 S05_AXI RDATA" *) output [31:0]S05_AXI_rdata;
  (* X_INTERFACE_INFO = "xilinx.com:interface:aximm:1.0 S05_AXI RLAST" *) output S05_AXI_rlast;
  (* X_INTERFACE_INFO = "xilinx.com:interface:aximm:1.0 S05_AXI RREADY" *) input S05_AXI_rready;
  (* X_INTERFACE_INFO = "xilinx.com:interface:aximm:1.0 S05_AXI RRESP" *) output [1:0]S05_AXI_rresp;
  (* X_INTERFACE_INFO = "xilinx.com:interface:aximm:1.0 S05_AXI RVALID" *) output S05_AXI_rvalid;
  (* X_INTERFACE_INFO = "xilinx.com:interface:aximm:1.0 S06_AXI AWADDR" *) (* X_INTERFACE_MODE = "Slave" *) (* X_INTERFACE_PARAMETER = "XIL_INTERFACENAME S06_AXI, ADDR_WIDTH 32, ARUSER_WIDTH 0, AWUSER_WIDTH 0, BUSER_WIDTH 0, CLK_DOMAIN /clk_wiz_1_clk_out1, DATA_WIDTH 32, FREQ_HZ 100000000, HAS_BRESP 1, HAS_BURST 0, HAS_CACHE 1, HAS_LOCK 0, HAS_PROT 1, HAS_QOS 0, HAS_REGION 0, HAS_RRESP 0, HAS_WSTRB 1, ID_WIDTH 0, INSERT_VIP 0, MAX_BURST_LENGTH 16, NUM_READ_OUTSTANDING 2, NUM_READ_THREADS 1, NUM_WRITE_OUTSTANDING 16, NUM_WRITE_THREADS 1, PHASE 0.0, PROTOCOL AXI4, READ_WRITE_MODE WRITE_ONLY, RUSER_BITS_PER_BYTE 0, RUSER_WIDTH 0, SUPPORTS_NARROW_BURST 0, WUSER_BITS_PER_BYTE 0, WUSER_WIDTH 0" *) input [31:0]S06_AXI_awaddr;
  (* X_INTERFACE_INFO = "xilinx.com:interface:aximm:1.0 S06_AXI AWBURST" *) input [1:0]S06_AXI_awburst;
  (* X_INTERFACE_INFO = "xilinx.com:interface:aximm:1.0 S06_AXI AWCACHE" *) input [3:0]S06_AXI_awcache;
  (* X_INTERFACE_INFO = "xilinx.com:interface:aximm:1.0 S06_AXI AWLEN" *) input [7:0]S06_AXI_awlen;
  (* X_INTERFACE_INFO = "xilinx.com:interface:aximm:1.0 S06_AXI AWLOCK" *) input [0:0]S06_AXI_awlock;
  (* X_INTERFACE_INFO = "xilinx.com:interface:aximm:1.0 S06_AXI AWPROT" *) input [2:0]S06_AXI_awprot;
  (* X_INTERFACE_INFO = "xilinx.com:interface:aximm:1.0 S06_AXI AWQOS" *) input [3:0]S06_AXI_awqos;
  (* X_INTERFACE_INFO = "xilinx.com:interface:aximm:1.0 S06_AXI AWREADY" *) output S06_AXI_awready;
  (* X_INTERFACE_INFO = "xilinx.com:interface:aximm:1.0 S06_AXI AWSIZE" *) input [2:0]S06_AXI_awsize;
  (* X_INTERFACE_INFO = "xilinx.com:interface:aximm:1.0 S06_AXI AWVALID" *) input S06_AXI_awvalid;
  (* X_INTERFACE_INFO = "xilinx.com:interface:aximm:1.0 S06_AXI BREADY" *) input S06_AXI_bready;
  (* X_INTERFACE_INFO = "xilinx.com:interface:aximm:1.0 S06_AXI BRESP" *) output [1:0]S06_AXI_bresp;
  (* X_INTERFACE_INFO = "xilinx.com:interface:aximm:1.0 S06_AXI BVALID" *) output S06_AXI_bvalid;
  (* X_INTERFACE_INFO = "xilinx.com:interface:aximm:1.0 S06_AXI WDATA" *) input [31:0]S06_AXI_wdata;
  (* X_INTERFACE_INFO = "xilinx.com:interface:aximm:1.0 S06_AXI WLAST" *) input S06_AXI_wlast;
  (* X_INTERFACE_INFO = "xilinx.com:interface:aximm:1.0 S06_AXI WREADY" *) output S06_AXI_wready;
  (* X_INTERFACE_INFO = "xilinx.com:interface:aximm:1.0 S06_AXI WSTRB" *) input [3:0]S06_AXI_wstrb;
  (* X_INTERFACE_INFO = "xilinx.com:interface:aximm:1.0 S06_AXI WVALID" *) input S06_AXI_wvalid;
  (* X_INTERFACE_INFO = "xilinx.com:signal:clock:1.0 CLK.ACLK CLK" *) (* X_INTERFACE_PARAMETER = "XIL_INTERFACENAME CLK.ACLK, ASSOCIATED_BUSIF S00_AXI:S01_AXI:S02_AXI:S03_AXI:S04_AXI:S05_AXI:S06_AXI, ASSOCIATED_CLKEN m_sc_aclken, CLK_DOMAIN /clk_wiz_1_clk_out1, FREQ_HZ 100000000, FREQ_TOLERANCE_HZ 0, INSERT_VIP 0, PHASE 0.0" *) input aclk;
  (* X_INTERFACE_INFO = "xilinx.com:signal:clock:1.0 CLK.ACLK1 CLK" *) (* X_INTERFACE_PARAMETER = "XIL_INTERFACENAME CLK.ACLK1, ASSOCIATED_BUSIF M00_AXI, ASSOCIATED_CLKEN s_sc_aclken, CLK_DOMAIN design_1_mig_7series_0_1_ui_clk, FREQ_HZ 100000000, FREQ_TOLERANCE_HZ 0, INSERT_VIP 0, PHASE 0" *) input aclk1;
  (* X_INTERFACE_INFO = "xilinx.com:signal:reset:1.0 RST.ARESETN RST" *) (* X_INTERFACE_PARAMETER = "XIL_INTERFACENAME RST.ARESETN, INSERT_VIP 0, POLARITY ACTIVE_LOW" *) input aresetn;

  wire [28:0]M00_AXI_araddr;
  wire [1:0]M00_AXI_arburst;
  wire [3:0]M00_AXI_arcache;
  wire [7:0]M00_AXI_arlen;
  wire [0:0]M00_AXI_arlock;
  wire [2:0]M00_AXI_arprot;
  wire [3:0]M00_AXI_arqos;
  wire M00_AXI_arready;
  wire [2:0]M00_AXI_arsize;
  wire M00_AXI_arvalid;
  wire [28:0]M00_AXI_awaddr;
  wire [1:0]M00_AXI_awburst;
  wire [3:0]M00_AXI_awcache;
  wire [7:0]M00_AXI_awlen;
  wire [0:0]M00_AXI_awlock;
  wire [2:0]M00_AXI_awprot;
  wire [3:0]M00_AXI_awqos;
  wire M00_AXI_awready;
  wire [2:0]M00_AXI_awsize;
  wire M00_AXI_awvalid;
  wire M00_AXI_bready;
  wire [1:0]M00_AXI_bresp;
  wire M00_AXI_bvalid;
  wire [31:0]M00_AXI_rdata;
  wire M00_AXI_rlast;
  wire M00_AXI_rready;
  wire [1:0]M00_AXI_rresp;
  wire M00_AXI_rvalid;
  wire [31:0]M00_AXI_wdata;
  wire M00_AXI_wlast;
  wire M00_AXI_wready;
  wire [3:0]M00_AXI_wstrb;
  wire M00_AXI_wvalid;
  wire [31:0]S00_AXI_araddr;
  wire [1:0]S00_AXI_arburst;
  wire [3:0]S00_AXI_arcache;
  wire [7:0]S00_AXI_arlen;
  wire [0:0]S00_AXI_arlock;
  wire [2:0]S00_AXI_arprot;
  wire [3:0]S00_AXI_arqos;
  wire S00_AXI_arready;
  wire [2:0]S00_AXI_arsize;
  wire S00_AXI_arvalid;
  wire [31:0]S00_AXI_awaddr;
  wire [1:0]S00_AXI_awburst;
  wire [3:0]S00_AXI_awcache;
  wire [7:0]S00_AXI_awlen;
  wire [0:0]S00_AXI_awlock;
  wire [2:0]S00_AXI_awprot;
  wire [3:0]S00_AXI_awqos;
  wire S00_AXI_awready;
  wire [2:0]S00_AXI_awsize;
  wire S00_AXI_awvalid;
  wire S00_AXI_bready;
  wire [1:0]S00_AXI_bresp;
  wire S00_AXI_bvalid;
  wire [31:0]S00_AXI_rdata;
  wire S00_AXI_rlast;
  wire S00_AXI_rready;
  wire [1:0]S00_AXI_rresp;
  wire S00_AXI_rvalid;
  wire [31:0]S00_AXI_wdata;
  wire S00_AXI_wlast;
  wire S00_AXI_wready;
  wire [3:0]S00_AXI_wstrb;
  wire S00_AXI_wvalid;
  wire [31:0]S01_AXI_araddr;
  wire [1:0]S01_AXI_arburst;
  wire [3:0]S01_AXI_arcache;
  wire [7:0]S01_AXI_arlen;
  wire [0:0]S01_AXI_arlock;
  wire [2:0]S01_AXI_arprot;
  wire [3:0]S01_AXI_arqos;
  wire S01_AXI_arready;
  wire [2:0]S01_AXI_arsize;
  wire S01_AXI_arvalid;
  wire [31:0]S01_AXI_rdata;
  wire S01_AXI_rlast;
  wire S01_AXI_rready;
  wire [1:0]S01_AXI_rresp;
  wire S01_AXI_rvalid;
  wire [31:0]S02_AXI_araddr;
  wire [1:0]S02_AXI_arburst;
  wire [3:0]S02_AXI_arcache;
  wire [7:0]S02_AXI_arlen;
  wire [0:0]S02_AXI_arlock;
  wire [2:0]S02_AXI_arprot;
  wire [3:0]S02_AXI_arqos;
  wire S02_AXI_arready;
  wire [2:0]S02_AXI_arsize;
  wire S02_AXI_arvalid;
  wire [31:0]S02_AXI_rdata;
  wire S02_AXI_rlast;
  wire S02_AXI_rready;
  wire [1:0]S02_AXI_rresp;
  wire S02_AXI_rvalid;
  wire [31:0]S03_AXI_awaddr;
  wire [1:0]S03_AXI_awburst;
  wire [3:0]S03_AXI_awcache;
  wire [7:0]S03_AXI_awlen;
  wire [0:0]S03_AXI_awlock;
  wire [2:0]S03_AXI_awprot;
  wire [3:0]S03_AXI_awqos;
  wire S03_AXI_awready;
  wire [2:0]S03_AXI_awsize;
  wire S03_AXI_awvalid;
  wire S03_AXI_bready;
  wire [1:0]S03_AXI_bresp;
  wire S03_AXI_bvalid;
  wire [31:0]S03_AXI_wdata;
  wire S03_AXI_wlast;
  wire S03_AXI_wready;
  wire [3:0]S03_AXI_wstrb;
  wire S03_AXI_wvalid;
  wire [31:0]S04_AXI_araddr;
  wire [1:0]S04_AXI_arburst;
  wire [3:0]S04_AXI_arcache;
  wire [7:0]S04_AXI_arlen;
  wire [0:0]S04_AXI_arlock;
  wire [2:0]S04_AXI_arprot;
  wire [3:0]S04_AXI_arqos;
  wire S04_AXI_arready;
  wire [2:0]S04_AXI_arsize;
  wire S04_AXI_arvalid;
  wire [31:0]S04_AXI_awaddr;
  wire [1:0]S04_AXI_awburst;
  wire [3:0]S04_AXI_awcache;
  wire [7:0]S04_AXI_awlen;
  wire [0:0]S04_AXI_awlock;
  wire [2:0]S04_AXI_awprot;
  wire [3:0]S04_AXI_awqos;
  wire S04_AXI_awready;
  wire [2:0]S04_AXI_awsize;
  wire S04_AXI_awvalid;
  wire S04_AXI_bready;
  wire [1:0]S04_AXI_bresp;
  wire S04_AXI_bvalid;
  wire [31:0]S04_AXI_rdata;
  wire S04_AXI_rlast;
  wire S04_AXI_rready;
  wire [1:0]S04_AXI_rresp;
  wire S04_AXI_rvalid;
  wire [31:0]S04_AXI_wdata;
  wire S04_AXI_wlast;
  wire S04_AXI_wready;
  wire [3:0]S04_AXI_wstrb;
  wire S04_AXI_wvalid;
  wire [31:0]S05_AXI_araddr;
  wire [1:0]S05_AXI_arburst;
  wire [3:0]S05_AXI_arcache;
  wire [7:0]S05_AXI_arlen;
  wire [0:0]S05_AXI_arlock;
  wire [2:0]S05_AXI_arprot;
  wire [3:0]S05_AXI_arqos;
  wire S05_AXI_arready;
  wire [2:0]S05_AXI_arsize;
  wire S05_AXI_arvalid;
  wire [31:0]S05_AXI_rdata;
  wire S05_AXI_rlast;
  wire S05_AXI_rready;
  wire [1:0]S05_AXI_rresp;
  wire S05_AXI_rvalid;
  wire [31:0]S06_AXI_awaddr;
  wire [1:0]S06_AXI_awburst;
  wire [3:0]S06_AXI_awcache;
  wire [7:0]S06_AXI_awlen;
  wire [0:0]S06_AXI_awlock;
  wire [2:0]S06_AXI_awprot;
  wire [3:0]S06_AXI_awqos;
  wire S06_AXI_awready;
  wire [2:0]S06_AXI_awsize;
  wire S06_AXI_awvalid;
  wire S06_AXI_bready;
  wire [1:0]S06_AXI_bresp;
  wire S06_AXI_bvalid;
  wire [31:0]S06_AXI_wdata;
  wire S06_AXI_wlast;
  wire S06_AXI_wready;
  wire [3:0]S06_AXI_wstrb;
  wire S06_AXI_wvalid;
  wire [0:0]S_SC_AR_1_INFO;
  wire [141:0]S_SC_AR_1_PAYLD;
  wire [0:0]S_SC_AR_1_RECV;
  wire S_SC_AR_1_REQ;
  wire S_SC_AR_1_SEND;
  wire [0:0]S_SC_AR_2_INFO;
  wire [141:0]S_SC_AR_2_PAYLD;
  wire [0:0]S_SC_AR_2_RECV;
  wire S_SC_AR_2_REQ;
  wire S_SC_AR_2_SEND;
  wire [0:0]S_SC_AR_3_INFO;
  wire [141:0]S_SC_AR_3_PAYLD;
  wire [0:0]S_SC_AR_3_RECV;
  wire S_SC_AR_3_REQ;
  wire S_SC_AR_3_SEND;
  wire [0:0]S_SC_AR_4_INFO;
  wire [141:0]S_SC_AR_4_PAYLD;
  wire [0:0]S_SC_AR_4_RECV;
  wire S_SC_AR_4_REQ;
  wire S_SC_AR_4_SEND;
  wire [0:0]S_SC_AR_5_INFO;
  wire [141:0]S_SC_AR_5_PAYLD;
  wire [0:0]S_SC_AR_5_RECV;
  wire S_SC_AR_5_REQ;
  wire S_SC_AR_5_SEND;
  wire [6:0]S_SC_AR_6_INFO;
  wire [141:0]S_SC_AR_6_PAYLD;
  wire [6:0]S_SC_AR_6_RECV;
  wire [6:0]S_SC_AR_6_REQ;
  wire [6:0]S_SC_AR_6_SEND;
  wire [0:0]S_SC_AW_1_INFO;
  wire [141:0]S_SC_AW_1_PAYLD;
  wire [0:0]S_SC_AW_1_RECV;
  wire S_SC_AW_1_REQ;
  wire S_SC_AW_1_SEND;
  wire [0:0]S_SC_AW_2_INFO;
  wire [141:0]S_SC_AW_2_PAYLD;
  wire [0:0]S_SC_AW_2_RECV;
  wire S_SC_AW_2_REQ;
  wire S_SC_AW_2_SEND;
  wire [0:0]S_SC_AW_3_INFO;
  wire [141:0]S_SC_AW_3_PAYLD;
  wire [0:0]S_SC_AW_3_RECV;
  wire S_SC_AW_3_REQ;
  wire S_SC_AW_3_SEND;
  wire [0:0]S_SC_AW_4_INFO;
  wire [141:0]S_SC_AW_4_PAYLD;
  wire [0:0]S_SC_AW_4_RECV;
  wire S_SC_AW_4_REQ;
  wire S_SC_AW_4_SEND;
  wire [6:0]S_SC_AW_5_INFO;
  wire [141:0]S_SC_AW_5_PAYLD;
  wire [6:0]S_SC_AW_5_RECV;
  wire [6:0]S_SC_AW_5_REQ;
  wire [6:0]S_SC_AW_5_SEND;
  wire [0:0]S_SC_B_1_INFO;
  wire [12:0]S_SC_B_1_PAYLD;
  wire [0:0]S_SC_B_1_RECV;
  wire [0:0]S_SC_B_1_REQ;
  wire [0:0]S_SC_B_1_SEND;
  wire [0:0]S_SC_B_2_INFO;
  wire [12:0]S_SC_B_2_PAYLD;
  wire [0:0]S_SC_B_2_RECV;
  wire [0:0]S_SC_B_2_REQ;
  wire [0:0]S_SC_B_2_SEND;
  wire [0:0]S_SC_B_3_INFO;
  wire [12:0]S_SC_B_3_PAYLD;
  wire [0:0]S_SC_B_3_RECV;
  wire [0:0]S_SC_B_3_REQ;
  wire [0:0]S_SC_B_3_SEND;
  wire [0:0]S_SC_B_4_INFO;
  wire [12:0]S_SC_B_4_PAYLD;
  wire [0:0]S_SC_B_4_RECV;
  wire [0:0]S_SC_B_4_REQ;
  wire [0:0]S_SC_B_4_SEND;
  wire [0:0]S_SC_B_5_INFO;
  wire [12:0]S_SC_B_5_PAYLD;
  wire [0:0]S_SC_B_5_RECV;
  wire S_SC_B_5_REQ;
  wire S_SC_B_5_SEND;
  wire [0:0]S_SC_R_1_INFO;
  wire [58:0]S_SC_R_1_PAYLD;
  wire [0:0]S_SC_R_1_RECV;
  wire [0:0]S_SC_R_1_REQ;
  wire [0:0]S_SC_R_1_SEND;
  wire [0:0]S_SC_R_2_INFO;
  wire [58:0]S_SC_R_2_PAYLD;
  wire [0:0]S_SC_R_2_RECV;
  wire [0:0]S_SC_R_2_REQ;
  wire [0:0]S_SC_R_2_SEND;
  wire [0:0]S_SC_R_3_INFO;
  wire [58:0]S_SC_R_3_PAYLD;
  wire [0:0]S_SC_R_3_RECV;
  wire [0:0]S_SC_R_3_REQ;
  wire [0:0]S_SC_R_3_SEND;
  wire [0:0]S_SC_R_4_INFO;
  wire [58:0]S_SC_R_4_PAYLD;
  wire [0:0]S_SC_R_4_RECV;
  wire [0:0]S_SC_R_4_REQ;
  wire [0:0]S_SC_R_4_SEND;
  wire [0:0]S_SC_R_5_INFO;
  wire [58:0]S_SC_R_5_PAYLD;
  wire [0:0]S_SC_R_5_RECV;
  wire [0:0]S_SC_R_5_REQ;
  wire [0:0]S_SC_R_5_SEND;
  wire [0:0]S_SC_R_6_INFO;
  wire [58:0]S_SC_R_6_PAYLD;
  wire [0:0]S_SC_R_6_RECV;
  wire S_SC_R_6_REQ;
  wire S_SC_R_6_SEND;
  wire [0:0]S_SC_W_1_INFO;
  wire [51:0]S_SC_W_1_PAYLD;
  wire [0:0]S_SC_W_1_RECV;
  wire S_SC_W_1_REQ;
  wire S_SC_W_1_SEND;
  wire [0:0]S_SC_W_2_INFO;
  wire [51:0]S_SC_W_2_PAYLD;
  wire [0:0]S_SC_W_2_RECV;
  wire S_SC_W_2_REQ;
  wire S_SC_W_2_SEND;
  wire [0:0]S_SC_W_3_INFO;
  wire [51:0]S_SC_W_3_PAYLD;
  wire [0:0]S_SC_W_3_RECV;
  wire S_SC_W_3_REQ;
  wire S_SC_W_3_SEND;
  wire [0:0]S_SC_W_4_INFO;
  wire [51:0]S_SC_W_4_PAYLD;
  wire [0:0]S_SC_W_4_RECV;
  wire S_SC_W_4_REQ;
  wire S_SC_W_4_SEND;
  wire [6:0]S_SC_W_5_INFO;
  wire [51:0]S_SC_W_5_PAYLD;
  wire [6:0]S_SC_W_5_RECV;
  wire [6:0]S_SC_W_5_REQ;
  wire [6:0]S_SC_W_5_SEND;
  wire aclk;
  wire aclk1;
  wire aclk_1;
  wire aclk_2;
  wire aclk_3;
  wire aclk_4;
  wire aclk_5;
  wire aclk_6;
  wire aclk_7;
  wire aresetn;
  wire [0:0]aresetn_2;
  wire [0:0]aresetn_3;
  wire [0:0]aresetn_4;
  wire [0:0]aresetn_5;
  wire [0:0]aresetn_6;
  wire [0:0]aresetn_7;
  wire [0:0]aresetn_8;
  wire aresetn_net;
  wire clk_map_M00_ACLK;
  wire [0:0]m00_nodes_M_SC_AR_INFO;
  wire [141:0]m00_nodes_M_SC_AR_PAYLD;
  wire m00_nodes_M_SC_AR_RECV;
  wire [0:0]m00_nodes_M_SC_AR_REQ;
  wire [0:0]m00_nodes_M_SC_AR_SEND;
  wire [0:0]m00_nodes_M_SC_AW_INFO;
  wire [141:0]m00_nodes_M_SC_AW_PAYLD;
  wire m00_nodes_M_SC_AW_RECV;
  wire [0:0]m00_nodes_M_SC_AW_REQ;
  wire [0:0]m00_nodes_M_SC_AW_SEND;
  wire [6:0]m00_nodes_M_SC_B_INFO;
  wire [12:0]m00_nodes_M_SC_B_PAYLD;
  wire [6:0]m00_nodes_M_SC_B_RECV;
  wire [6:0]m00_nodes_M_SC_B_REQ;
  wire [6:0]m00_nodes_M_SC_B_SEND;
  wire [6:0]m00_nodes_M_SC_R_INFO;
  wire [58:0]m00_nodes_M_SC_R_PAYLD;
  wire [6:0]m00_nodes_M_SC_R_RECV;
  wire [6:0]m00_nodes_M_SC_R_REQ;
  wire [6:0]m00_nodes_M_SC_R_SEND;
  wire [0:0]m00_nodes_M_SC_W_INFO;
  wire [51:0]m00_nodes_M_SC_W_PAYLD;
  wire m00_nodes_M_SC_W_RECV;
  wire [0:0]m00_nodes_M_SC_W_REQ;
  wire [0:0]m00_nodes_M_SC_W_SEND;
  wire [28:0]m00_sc2axi_M_AXI_ARADDR;
  wire [3:0]m00_sc2axi_M_AXI_ARCACHE;
  wire [2:0]m00_sc2axi_M_AXI_ARID;
  wire [7:0]m00_sc2axi_M_AXI_ARLEN;
  wire [0:0]m00_sc2axi_M_AXI_ARLOCK;
  wire [2:0]m00_sc2axi_M_AXI_ARPROT;
  wire [3:0]m00_sc2axi_M_AXI_ARQOS;
  wire m00_sc2axi_M_AXI_ARREADY;
  wire [1023:0]m00_sc2axi_M_AXI_ARUSER;
  wire m00_sc2axi_M_AXI_ARVALID;
  wire [28:0]m00_sc2axi_M_AXI_AWADDR;
  wire [3:0]m00_sc2axi_M_AXI_AWCACHE;
  wire [2:0]m00_sc2axi_M_AXI_AWID;
  wire [7:0]m00_sc2axi_M_AXI_AWLEN;
  wire [0:0]m00_sc2axi_M_AXI_AWLOCK;
  wire [2:0]m00_sc2axi_M_AXI_AWPROT;
  wire [3:0]m00_sc2axi_M_AXI_AWQOS;
  wire m00_sc2axi_M_AXI_AWREADY;
  wire [1023:0]m00_sc2axi_M_AXI_AWUSER;
  wire m00_sc2axi_M_AXI_AWVALID;
  wire [2:0]m00_sc2axi_M_AXI_BID;
  wire m00_sc2axi_M_AXI_BREADY;
  wire [1:0]m00_sc2axi_M_AXI_BRESP;
  wire [1023:0]m00_sc2axi_M_AXI_BUSER;
  wire m00_sc2axi_M_AXI_BVALID;
  wire [31:0]m00_sc2axi_M_AXI_RDATA;
  wire [2:0]m00_sc2axi_M_AXI_RID;
  wire m00_sc2axi_M_AXI_RLAST;
  wire m00_sc2axi_M_AXI_RREADY;
  wire [1:0]m00_sc2axi_M_AXI_RRESP;
  wire [1023:0]m00_sc2axi_M_AXI_RUSER;
  wire m00_sc2axi_M_AXI_RVALID;
  wire [31:0]m00_sc2axi_M_AXI_WDATA;
  wire m00_sc2axi_M_AXI_WLAST;
  wire m00_sc2axi_M_AXI_WREADY;
  wire [3:0]m00_sc2axi_M_AXI_WSTRB;
  wire [1023:0]m00_sc2axi_M_AXI_WUSER;
  wire m00_sc2axi_M_AXI_WVALID;
  wire [0:0]m_axi_aresetn_1;
  wire [31:0]s00_entry_pipeline_m_axi_ARADDR;
  wire [3:0]s00_entry_pipeline_m_axi_ARCACHE;
  wire [2:0]s00_entry_pipeline_m_axi_ARID;
  wire [7:0]s00_entry_pipeline_m_axi_ARLEN;
  wire [0:0]s00_entry_pipeline_m_axi_ARLOCK;
  wire [2:0]s00_entry_pipeline_m_axi_ARPROT;
  wire [3:0]s00_entry_pipeline_m_axi_ARQOS;
  wire s00_entry_pipeline_m_axi_ARREADY;
  wire [1023:0]s00_entry_pipeline_m_axi_ARUSER;
  wire s00_entry_pipeline_m_axi_ARVALID;
  wire [31:0]s00_entry_pipeline_m_axi_AWADDR;
  wire [3:0]s00_entry_pipeline_m_axi_AWCACHE;
  wire [2:0]s00_entry_pipeline_m_axi_AWID;
  wire [7:0]s00_entry_pipeline_m_axi_AWLEN;
  wire [0:0]s00_entry_pipeline_m_axi_AWLOCK;
  wire [2:0]s00_entry_pipeline_m_axi_AWPROT;
  wire [3:0]s00_entry_pipeline_m_axi_AWQOS;
  wire s00_entry_pipeline_m_axi_AWREADY;
  wire [1023:0]s00_entry_pipeline_m_axi_AWUSER;
  wire s00_entry_pipeline_m_axi_AWVALID;
  wire [2:0]s00_entry_pipeline_m_axi_BID;
  wire s00_entry_pipeline_m_axi_BREADY;
  wire [1:0]s00_entry_pipeline_m_axi_BRESP;
  wire [1023:0]s00_entry_pipeline_m_axi_BUSER;
  wire s00_entry_pipeline_m_axi_BVALID;
  wire [31:0]s00_entry_pipeline_m_axi_RDATA;
  wire [2:0]s00_entry_pipeline_m_axi_RID;
  wire s00_entry_pipeline_m_axi_RLAST;
  wire s00_entry_pipeline_m_axi_RREADY;
  wire [1:0]s00_entry_pipeline_m_axi_RRESP;
  wire [1023:0]s00_entry_pipeline_m_axi_RUSER;
  wire s00_entry_pipeline_m_axi_RVALID;
  wire [31:0]s00_entry_pipeline_m_axi_WDATA;
  wire s00_entry_pipeline_m_axi_WLAST;
  wire s00_entry_pipeline_m_axi_WREADY;
  wire [3:0]s00_entry_pipeline_m_axi_WSTRB;
  wire [1023:0]s00_entry_pipeline_m_axi_WUSER;
  wire s00_entry_pipeline_m_axi_WVALID;
  wire [0:0]s00_nodes_M_SC_AR_INFO;
  wire [141:0]s00_nodes_M_SC_AR_PAYLD;
  wire [0:0]s00_nodes_M_SC_AR_RECV;
  wire [0:0]s00_nodes_M_SC_AR_REQ;
  wire [0:0]s00_nodes_M_SC_AR_SEND;
  wire [0:0]s00_nodes_M_SC_AW_INFO;
  wire [141:0]s00_nodes_M_SC_AW_PAYLD;
  wire [0:0]s00_nodes_M_SC_AW_RECV;
  wire [0:0]s00_nodes_M_SC_AW_REQ;
  wire [0:0]s00_nodes_M_SC_AW_SEND;
  wire [0:0]s00_nodes_M_SC_B_INFO;
  wire [12:0]s00_nodes_M_SC_B_PAYLD;
  wire s00_nodes_M_SC_B_RECV;
  wire [0:0]s00_nodes_M_SC_B_REQ;
  wire [0:0]s00_nodes_M_SC_B_SEND;
  wire [0:0]s00_nodes_M_SC_R_INFO;
  wire [58:0]s00_nodes_M_SC_R_PAYLD;
  wire s00_nodes_M_SC_R_RECV;
  wire [0:0]s00_nodes_M_SC_R_REQ;
  wire [0:0]s00_nodes_M_SC_R_SEND;
  wire [0:0]s00_nodes_M_SC_W_INFO;
  wire [51:0]s00_nodes_M_SC_W_PAYLD;
  wire [0:0]s00_nodes_M_SC_W_RECV;
  wire [0:0]s00_nodes_M_SC_W_REQ;
  wire [0:0]s00_nodes_M_SC_W_SEND;
  wire [31:0]s01_entry_pipeline_m_axi_ARADDR;
  wire [3:0]s01_entry_pipeline_m_axi_ARCACHE;
  wire [2:0]s01_entry_pipeline_m_axi_ARID;
  wire [7:0]s01_entry_pipeline_m_axi_ARLEN;
  wire [0:0]s01_entry_pipeline_m_axi_ARLOCK;
  wire [2:0]s01_entry_pipeline_m_axi_ARPROT;
  wire [3:0]s01_entry_pipeline_m_axi_ARQOS;
  wire s01_entry_pipeline_m_axi_ARREADY;
  wire [1023:0]s01_entry_pipeline_m_axi_ARUSER;
  wire s01_entry_pipeline_m_axi_ARVALID;
  wire [31:0]s01_entry_pipeline_m_axi_RDATA;
  wire [2:0]s01_entry_pipeline_m_axi_RID;
  wire s01_entry_pipeline_m_axi_RLAST;
  wire s01_entry_pipeline_m_axi_RREADY;
  wire [1:0]s01_entry_pipeline_m_axi_RRESP;
  wire [1023:0]s01_entry_pipeline_m_axi_RUSER;
  wire s01_entry_pipeline_m_axi_RVALID;
  wire [0:0]s01_nodes_M_SC_AR_INFO;
  wire [141:0]s01_nodes_M_SC_AR_PAYLD;
  wire [0:0]s01_nodes_M_SC_AR_RECV;
  wire [0:0]s01_nodes_M_SC_AR_REQ;
  wire [0:0]s01_nodes_M_SC_AR_SEND;
  wire [0:0]s01_nodes_M_SC_R_INFO;
  wire [58:0]s01_nodes_M_SC_R_PAYLD;
  wire s01_nodes_M_SC_R_RECV;
  wire [0:0]s01_nodes_M_SC_R_REQ;
  wire [0:0]s01_nodes_M_SC_R_SEND;
  wire [31:0]s02_entry_pipeline_m_axi_ARADDR;
  wire [3:0]s02_entry_pipeline_m_axi_ARCACHE;
  wire [2:0]s02_entry_pipeline_m_axi_ARID;
  wire [7:0]s02_entry_pipeline_m_axi_ARLEN;
  wire [0:0]s02_entry_pipeline_m_axi_ARLOCK;
  wire [2:0]s02_entry_pipeline_m_axi_ARPROT;
  wire [3:0]s02_entry_pipeline_m_axi_ARQOS;
  wire s02_entry_pipeline_m_axi_ARREADY;
  wire [1023:0]s02_entry_pipeline_m_axi_ARUSER;
  wire s02_entry_pipeline_m_axi_ARVALID;
  wire [31:0]s02_entry_pipeline_m_axi_RDATA;
  wire [2:0]s02_entry_pipeline_m_axi_RID;
  wire s02_entry_pipeline_m_axi_RLAST;
  wire s02_entry_pipeline_m_axi_RREADY;
  wire [1:0]s02_entry_pipeline_m_axi_RRESP;
  wire [1023:0]s02_entry_pipeline_m_axi_RUSER;
  wire s02_entry_pipeline_m_axi_RVALID;
  wire [0:0]s02_nodes_M_SC_AR_INFO;
  wire [141:0]s02_nodes_M_SC_AR_PAYLD;
  wire [0:0]s02_nodes_M_SC_AR_RECV;
  wire [0:0]s02_nodes_M_SC_AR_REQ;
  wire [0:0]s02_nodes_M_SC_AR_SEND;
  wire [0:0]s02_nodes_M_SC_R_INFO;
  wire [58:0]s02_nodes_M_SC_R_PAYLD;
  wire s02_nodes_M_SC_R_RECV;
  wire [0:0]s02_nodes_M_SC_R_REQ;
  wire [0:0]s02_nodes_M_SC_R_SEND;
  wire [31:0]s03_entry_pipeline_m_axi_AWADDR;
  wire [3:0]s03_entry_pipeline_m_axi_AWCACHE;
  wire [2:0]s03_entry_pipeline_m_axi_AWID;
  wire [7:0]s03_entry_pipeline_m_axi_AWLEN;
  wire [0:0]s03_entry_pipeline_m_axi_AWLOCK;
  wire [2:0]s03_entry_pipeline_m_axi_AWPROT;
  wire [3:0]s03_entry_pipeline_m_axi_AWQOS;
  wire s03_entry_pipeline_m_axi_AWREADY;
  wire [1023:0]s03_entry_pipeline_m_axi_AWUSER;
  wire s03_entry_pipeline_m_axi_AWVALID;
  wire [2:0]s03_entry_pipeline_m_axi_BID;
  wire s03_entry_pipeline_m_axi_BREADY;
  wire [1:0]s03_entry_pipeline_m_axi_BRESP;
  wire [1023:0]s03_entry_pipeline_m_axi_BUSER;
  wire s03_entry_pipeline_m_axi_BVALID;
  wire [31:0]s03_entry_pipeline_m_axi_WDATA;
  wire s03_entry_pipeline_m_axi_WLAST;
  wire s03_entry_pipeline_m_axi_WREADY;
  wire [3:0]s03_entry_pipeline_m_axi_WSTRB;
  wire [1023:0]s03_entry_pipeline_m_axi_WUSER;
  wire s03_entry_pipeline_m_axi_WVALID;
  wire [0:0]s03_nodes_M_SC_AW_INFO;
  wire [141:0]s03_nodes_M_SC_AW_PAYLD;
  wire [0:0]s03_nodes_M_SC_AW_RECV;
  wire [0:0]s03_nodes_M_SC_AW_REQ;
  wire [0:0]s03_nodes_M_SC_AW_SEND;
  wire [0:0]s03_nodes_M_SC_B_INFO;
  wire [12:0]s03_nodes_M_SC_B_PAYLD;
  wire s03_nodes_M_SC_B_RECV;
  wire [0:0]s03_nodes_M_SC_B_REQ;
  wire [0:0]s03_nodes_M_SC_B_SEND;
  wire [0:0]s03_nodes_M_SC_W_INFO;
  wire [51:0]s03_nodes_M_SC_W_PAYLD;
  wire [0:0]s03_nodes_M_SC_W_RECV;
  wire [0:0]s03_nodes_M_SC_W_REQ;
  wire [0:0]s03_nodes_M_SC_W_SEND;
  wire [31:0]s04_entry_pipeline_m_axi_ARADDR;
  wire [3:0]s04_entry_pipeline_m_axi_ARCACHE;
  wire [2:0]s04_entry_pipeline_m_axi_ARID;
  wire [7:0]s04_entry_pipeline_m_axi_ARLEN;
  wire [0:0]s04_entry_pipeline_m_axi_ARLOCK;
  wire [2:0]s04_entry_pipeline_m_axi_ARPROT;
  wire [3:0]s04_entry_pipeline_m_axi_ARQOS;
  wire s04_entry_pipeline_m_axi_ARREADY;
  wire [1023:0]s04_entry_pipeline_m_axi_ARUSER;
  wire s04_entry_pipeline_m_axi_ARVALID;
  wire [31:0]s04_entry_pipeline_m_axi_AWADDR;
  wire [3:0]s04_entry_pipeline_m_axi_AWCACHE;
  wire [2:0]s04_entry_pipeline_m_axi_AWID;
  wire [7:0]s04_entry_pipeline_m_axi_AWLEN;
  wire [0:0]s04_entry_pipeline_m_axi_AWLOCK;
  wire [2:0]s04_entry_pipeline_m_axi_AWPROT;
  wire [3:0]s04_entry_pipeline_m_axi_AWQOS;
  wire s04_entry_pipeline_m_axi_AWREADY;
  wire [1023:0]s04_entry_pipeline_m_axi_AWUSER;
  wire s04_entry_pipeline_m_axi_AWVALID;
  wire [2:0]s04_entry_pipeline_m_axi_BID;
  wire s04_entry_pipeline_m_axi_BREADY;
  wire [1:0]s04_entry_pipeline_m_axi_BRESP;
  wire [1023:0]s04_entry_pipeline_m_axi_BUSER;
  wire s04_entry_pipeline_m_axi_BVALID;
  wire [31:0]s04_entry_pipeline_m_axi_RDATA;
  wire [2:0]s04_entry_pipeline_m_axi_RID;
  wire s04_entry_pipeline_m_axi_RLAST;
  wire s04_entry_pipeline_m_axi_RREADY;
  wire [1:0]s04_entry_pipeline_m_axi_RRESP;
  wire [1023:0]s04_entry_pipeline_m_axi_RUSER;
  wire s04_entry_pipeline_m_axi_RVALID;
  wire [31:0]s04_entry_pipeline_m_axi_WDATA;
  wire s04_entry_pipeline_m_axi_WLAST;
  wire s04_entry_pipeline_m_axi_WREADY;
  wire [3:0]s04_entry_pipeline_m_axi_WSTRB;
  wire [1023:0]s04_entry_pipeline_m_axi_WUSER;
  wire s04_entry_pipeline_m_axi_WVALID;
  wire [0:0]s04_nodes_M_SC_AR_INFO;
  wire [141:0]s04_nodes_M_SC_AR_PAYLD;
  wire [0:0]s04_nodes_M_SC_AR_RECV;
  wire [0:0]s04_nodes_M_SC_AR_REQ;
  wire [0:0]s04_nodes_M_SC_AR_SEND;
  wire [0:0]s04_nodes_M_SC_AW_INFO;
  wire [141:0]s04_nodes_M_SC_AW_PAYLD;
  wire [0:0]s04_nodes_M_SC_AW_RECV;
  wire [0:0]s04_nodes_M_SC_AW_REQ;
  wire [0:0]s04_nodes_M_SC_AW_SEND;
  wire [0:0]s04_nodes_M_SC_B_INFO;
  wire [12:0]s04_nodes_M_SC_B_PAYLD;
  wire s04_nodes_M_SC_B_RECV;
  wire [0:0]s04_nodes_M_SC_B_REQ;
  wire [0:0]s04_nodes_M_SC_B_SEND;
  wire [0:0]s04_nodes_M_SC_R_INFO;
  wire [58:0]s04_nodes_M_SC_R_PAYLD;
  wire s04_nodes_M_SC_R_RECV;
  wire [0:0]s04_nodes_M_SC_R_REQ;
  wire [0:0]s04_nodes_M_SC_R_SEND;
  wire [0:0]s04_nodes_M_SC_W_INFO;
  wire [51:0]s04_nodes_M_SC_W_PAYLD;
  wire [0:0]s04_nodes_M_SC_W_RECV;
  wire [0:0]s04_nodes_M_SC_W_REQ;
  wire [0:0]s04_nodes_M_SC_W_SEND;
  wire [31:0]s05_entry_pipeline_m_axi_ARADDR;
  wire [3:0]s05_entry_pipeline_m_axi_ARCACHE;
  wire [2:0]s05_entry_pipeline_m_axi_ARID;
  wire [7:0]s05_entry_pipeline_m_axi_ARLEN;
  wire [0:0]s05_entry_pipeline_m_axi_ARLOCK;
  wire [2:0]s05_entry_pipeline_m_axi_ARPROT;
  wire [3:0]s05_entry_pipeline_m_axi_ARQOS;
  wire s05_entry_pipeline_m_axi_ARREADY;
  wire [1023:0]s05_entry_pipeline_m_axi_ARUSER;
  wire s05_entry_pipeline_m_axi_ARVALID;
  wire [31:0]s05_entry_pipeline_m_axi_RDATA;
  wire [2:0]s05_entry_pipeline_m_axi_RID;
  wire s05_entry_pipeline_m_axi_RLAST;
  wire s05_entry_pipeline_m_axi_RREADY;
  wire [1:0]s05_entry_pipeline_m_axi_RRESP;
  wire [1023:0]s05_entry_pipeline_m_axi_RUSER;
  wire s05_entry_pipeline_m_axi_RVALID;
  wire [0:0]s05_nodes_M_SC_AR_INFO;
  wire [141:0]s05_nodes_M_SC_AR_PAYLD;
  wire [0:0]s05_nodes_M_SC_AR_RECV;
  wire [0:0]s05_nodes_M_SC_AR_REQ;
  wire [0:0]s05_nodes_M_SC_AR_SEND;
  wire [0:0]s05_nodes_M_SC_R_INFO;
  wire [58:0]s05_nodes_M_SC_R_PAYLD;
  wire s05_nodes_M_SC_R_RECV;
  wire [0:0]s05_nodes_M_SC_R_REQ;
  wire [0:0]s05_nodes_M_SC_R_SEND;
  wire [31:0]s06_entry_pipeline_m_axi_AWADDR;
  wire [3:0]s06_entry_pipeline_m_axi_AWCACHE;
  wire [2:0]s06_entry_pipeline_m_axi_AWID;
  wire [7:0]s06_entry_pipeline_m_axi_AWLEN;
  wire [0:0]s06_entry_pipeline_m_axi_AWLOCK;
  wire [2:0]s06_entry_pipeline_m_axi_AWPROT;
  wire [3:0]s06_entry_pipeline_m_axi_AWQOS;
  wire s06_entry_pipeline_m_axi_AWREADY;
  wire [1023:0]s06_entry_pipeline_m_axi_AWUSER;
  wire s06_entry_pipeline_m_axi_AWVALID;
  wire [2:0]s06_entry_pipeline_m_axi_BID;
  wire s06_entry_pipeline_m_axi_BREADY;
  wire [1:0]s06_entry_pipeline_m_axi_BRESP;
  wire [1023:0]s06_entry_pipeline_m_axi_BUSER;
  wire s06_entry_pipeline_m_axi_BVALID;
  wire [31:0]s06_entry_pipeline_m_axi_WDATA;
  wire s06_entry_pipeline_m_axi_WLAST;
  wire s06_entry_pipeline_m_axi_WREADY;
  wire [3:0]s06_entry_pipeline_m_axi_WSTRB;
  wire [1023:0]s06_entry_pipeline_m_axi_WUSER;
  wire s06_entry_pipeline_m_axi_WVALID;
  wire [0:0]s06_nodes_M_SC_AW_INFO;
  wire [141:0]s06_nodes_M_SC_AW_PAYLD;
  wire [0:0]s06_nodes_M_SC_AW_RECV;
  wire [0:0]s06_nodes_M_SC_AW_REQ;
  wire [0:0]s06_nodes_M_SC_AW_SEND;
  wire [0:0]s06_nodes_M_SC_B_INFO;
  wire [12:0]s06_nodes_M_SC_B_PAYLD;
  wire s06_nodes_M_SC_B_RECV;
  wire [0:0]s06_nodes_M_SC_B_REQ;
  wire [0:0]s06_nodes_M_SC_B_SEND;
  wire [0:0]s06_nodes_M_SC_W_INFO;
  wire [51:0]s06_nodes_M_SC_W_PAYLD;
  wire [0:0]s06_nodes_M_SC_W_RECV;
  wire [0:0]s06_nodes_M_SC_W_REQ;
  wire [0:0]s06_nodes_M_SC_W_SEND;
  wire swbd_aclk_net;
  wire [0:0]swbd_aresetn_net;
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
