talsh123/tokenizer-vivado/uart.srcs/sources_1/new/pre_tokenizer.v

`timescale 1ns / 1ps // simulation time resolution: 1ns - time unit, 1ps - precision

// pre_tokenizer.v
// description:
// The Pre-Tokenizer sits between the input FIFO (tokenizer_axi_lite.v) and the trie engine (trie_engine.v).
// The main purpose of the Pre-Tokenizer is to take the raw ASCII bytes and prepare them for the trie engine.
// The 3 functions of the Pre-Tokenizer:
// 1. Lowercase conversion
// 2. Character Mapping
// 3. Word Boundary Detection

module pre_tokenizer #(
    // parameter section
    parameter CHAR_W = 10 // 10 bits of the alphabet index, 2^10 = 1024 > ~1008 unique characters
)(
    // inputs and outputs section
    input wire clk, // clk_100 100 MHz clock
    input wire rst, // synchronous active-high reset
    
    // upstream - data that comes from FIFO - which comes before the pre-tokenizer
    input wire [7:0] fifo_data, // 8 bits of raw ascii text (a single character)
    input wire fifo_valid, // a flag which says if the input FIFO buffer has a byte available for us
    output reg fifo_ready, // a flag which says that we are ready to consume that character
    
    // downstream - data that is being sent down to the trie engine - which comes after the pre-tokenizer
    output reg [CHAR_W-1:0] out_char, // this is the mapped alphabet index (10 bits)
    output reg out_char_valid, // a flag which pulses HIGH for 1 cycle when a character is ready
    output reg out_word_done, // a flag which pulses HIGH when a word boundary is detected
    
    // from Downstream to us - from the trie engine (backpressure)
    input wire trie_ready, // when trie_ready turns to 0, the trie is busy and can't accept new characters.
    output wire word_boundary_busy, // this goes out to the tokenizer_axi_lite - stops the input FIFO from sending new characters while the trie engine is still processing word boundary

    // tells the rest of the pipeline that the pre-tokenizer still has work in flight
    // (a character held for the trie, a pending word boundary, or a pulse being driven this cycle).
    // used by top_tokenizer to build the overall pipeline-busy status the firmware polls.
    output wire pt_busy
);
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
