talsh123/tokenizer-vivado/(commit log)

2026-06-19 fix bug H1 (same as #12)
    missing else in S_EMIT -> spurious [UNK] / lost token on
    replay+word_done
    [design_1.v, design_1_wrapper.v, tb_h1_bug_investigation.v, trie_engine.v]
2026-06-19 fix h1 & h2 & m1
    - h2 - binary-search bs_hi underflow at node 0
    - m1 - no guard for words > 32 chars (buffer corruption)
    [tb_h1_h2_m1.v, trie_engine.v]
2026-06-20 Redesign word-boundary flow control (P1) and add pipeline_busy status (M4)
    P1 - throughput: remove the pre-tokenizer's two-phase word-boundary ack
    handshake (and its 4-cycle timeout) in favor of pure valid/ready flow
    control. The trie engine now lowers ready entering S_EMIT and absorbs a
    boundary-straddling character with a 1-deep input skid, so the next word's
    first character is never dropped. Output IDs unchanged; per-word timeout gone.
    M4 - observability: expose pipeline_busy on STATUS bit 3 so firmware can
    drain deterministically instead of using a fixed delay. Plumbed via a trie
    busy output and pre-tokenizer pt_busy; the AXI wrapper also asserts it on the
    token-emit cycle (tok_out_vali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
    [design_1.v, design_1_wrapper.v, pre_tokenizer.v, tb_axi_pipeline.v, tokenizer_axi_lite.v, top_tokenizer.v, trie_engine.v]
2026-06-20 Fix spurious [UNK] on boundary-finalizing two-piece words (embed)
    trie_engine.v: capture a next-word character that races in on the S_EMIT
    replay-launch branch (best_end != buf_end) while a word boundary is pending,
    so it is replayed through the pending_char skid instead of being dropped.
    This closes the residual P1 boundary case (e.g. "embed", "embed hardware")
    that behavioral sim missed. Verified on-board over TCP after the full review
    suite (H1, H2, M1-M4, P1) passed on silicon.
    Also: extend tb_axi_pipeline with embed / embed-slow boundary tests and a
    cycle-stamped emit probe; minor tb_tokenizer_axi_lite tweaks; refresh
    JOURNAL.md (the embed [UNK] root cause was a stale Vitis-programmed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
    [tb_axi_pipeline.v, tb_tokenizer_axi_lite.v, trie_engine.v]
2026-06-20 Address low-priority review items L1-L3 and clear synthesis warnings
    trie_engine.v: drop the ignored ram_style="distributed" hint on char_buf (it
    falls back to flip-flops regardless), removing 32 synth warnings; behavior is
    unchanged.
    tokenizer_axi_lite.v: L3 -- gate AXI reads with read_addr_serviced so a master
    holding arvalid high cannot re-pop the output FIFO for one intended read; also
    move the tok_word_busy declaration ahead of its first use to clear a
    used-before-declaration warning.
    tb_axi_pipeline.v: L2 -- add a check_no_unk invariant task plus digit /
    alphanumeric cases (2024, abc123); plain a-z/0-9 input must never emit [UNK].
    L1 (token-id .mem width, 8-hex -> 4-hex to match the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
    [design_1.v, design_1_wrapper.v, tb_axi_pipeline.v, tokenizer_axi_lite.v, trie_engine.v]
2026-06-20 Docs: finalize JOURNAL/HANDOFF/OPTIMIZATION_OPTIONS for handoff
    JOURNAL: add a session close-out + open-items summary; the full per-problem
    record now covers H1-M4, P1, L1-L3, the embed investigation (stale-bitstream
    root cause), char_buf and tok_word_busy cleanups, and the on-board sign-off.
    HANDOFF: rewrite the stale CURRENT STATUS (everything done and verified on
    silicon; the embed [UNK] was a stale-bitstream artifact, not an RTL bug) and add
    an OPEN ITEMS section -- DMA (R2) is the one must-do handoff, the rest optional
    and not required for the final report.
    OPTIMIZATION_OPTIONS: mark F1 done (shipped as M4) and elevate R2 (AXI-Stream +
    DMA) to the next-priority handoff item, with mech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
2026-06-21 Add AXI-Stream (DMA) datapath groundwork to the tokenizer IP (R2)
    tokenizer_axi_lite.v: add an AXI4-Stream slave (input bytes) feeding the input
    FIFO and an AXI4-Stream master (output tokens) draining the output FIFO, with
    TLAST threading (input_done + a "producing" term) so the last token of each
    response carries tlast for the DMA S2MM. Add a 0x0C TOKEN_COUNT register
    (increments per enqueued token, write-to-clear) so firmware can learn how many
    tokens a transfer produced (simple-mode S2MM does not report length). The
    AXI-Lite path and the pre-tokenizer/trie core are unchanged, so token IDs stay
    identical.
    tb_axi_dma.v (new): drives s_axis like a DMA MM2S, checks the m_axis token
    stream, T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
2026-06-21 R2 DMA datapath verified on-board; regenerate bitstream; update docs
    - RTL s_axis/m_axis stream ports + TOKEN_COUNT (0x0C) verified on silicon; token IDs identical to bert-base-uncased
    - Regenerated bitstream + XSA after final IP changes
    - JOURNAL: add R2 on-board bring-up section (firmware final form, stale-bitstream and zero-token-TLAST bugs, ~14x vs MMIO results); add append-only banner at top
    - CODE_REVIEW: section 6 H1-L3 resolution table, section 7 R2 architecture
    - HANDOFF: R2 done and verified on-board; report tasks (perf/power/CSV) now primary
    - Add analysis/cpu_tokenizer_benchmark.py for the FPGA-vs-CPU comparison
    [bd_48ac.v, bd_48ac_arinsw_0.sv, bd_48ac_arni_0.sv, bd_48ac_aroutsw_0.sv, bd_48ac_awinsw_0.sv, bd_48ac_awni_0.sv, bd_48ac_awoutsw_0.sv, bd_48ac_bni_0.sv]
2026-06-21 Add FPGA-vs-CPU evaluation pipeline + results; document power/energy and known limitations
    - analysis/: one shared 66-line corpus (+ Unicode divergence set); CPU HuggingFace benchmark (core/overhead latency, jitter, batched throughput); FPGA xsim measurement TB generator -> tb_corpus_perf.v (deterministic fabric cycles + token ids); compare + plot + mismatch-classifier scripts; results CSVs + 5 figures
    - Correctness: 97% exact word-token match vs bert-base-uncased; 13.6% punctuation omitted by design; 1-char-after-multipiece merge bug characterized (2/66) and documented as a known limitation
    - Power/energy: report_power tokenizer datapath 51 mW vs measured ~30 W CPU package (Ryzen 7 7435HS)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
    [comparison.csv, cpu_results.csv, cpu_throughput.csv, fpga_results.csv, power.csv, tokenizer_benchmark.csv]
2026-06-21 Stage 5: partner evidence pack (energy sheet, mismatch report, benchmark setup, index)
2026-06-21 Stage 5: add gen_reports.tcl one-shot utilization+timing dump
2026-06-21 Stage 5: add block design + address editor screenshots; mark P0 #8/#9 done
2026-06-21 Stage 5: post-impl utilization + timing reports + xdc (P0 #6/#7)
2026-06-21 Stage 5: tb_axi_dma PASS transcript (P0 #10); mark #6/#7/#10 done in index
2026-06-21 Stage 5: gen_reports.tcl only copies constrs_1 xdc (avoid dumping IP-generated constraints)
2026-06-21 Stage 5: add DMA waveform (P1 #11) - m_axis_tlast + TOKEN_COUNT readback
2026-06-21 Docs: document Stage 5 evidence pack in JOURNAL; add evidence-location map + open items to HANDOFF
2026-06-21 Fix #2: 1-char-word-after-multipiece merge (word_done_pending bit -> saturating counter); sim-verified 66/66
    [tb_word_boundary.v, trie_engine.v]
2026-06-21 Refresh sim results to 66/66 (post-#2 fix); add failing-timing report for #1 analysis
    [comparison.csv, fpga_results.csv]
2026-06-21 tb_axi_pipeline: update internal probe word_done_pending -> word_done_count after the #2 rename
2026-06-21 Docs: on-board reverify (golden vectors pass on silicon) + the stale module-ref synthesis catch and build fix
2026-06-27 Docs: record #2 fix verified on silicon (66/66); sync all docs off the pre-fix/blocked state
    - HANDOFF: new FINAL status block (TEMAC license cleared, #2 fix on silicon 66/66);
    fix the verify method (grep uart.runs -> get_cells on open_run impl_1);
    drop the now-stale 1-char-word "honest limitation"
    - JOURNAL: append "#2 fix VERIFIED ON SILICON - 66/66" (license root cause, full
    non-incremental build, netlist proof word_done_count=6/word_done_pending=0,
    on-board reverify, #7 robustness)
    - CODE_REVIEW / MISMATCH_REPORT / H1_VERIFICATION / OPTIMIZATION_OPTIONS /
    EVIDENCE_INDEX / CONTINUATION_PROMPT / BENCHMARK_SETUP: update from
    "sim-verified / not on silicon / blocked on TEMAC" to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
    [design_1.v, design_1_axi_ethernet_0_dma_0.vhd, design_1_axi_timer_0_1.vhd, design_1_dlmb_v10_1.vhd, design_1_ilmb_v10_1.vhd]
2026-06-27 Clean up RTL comments + add top-level README
    - trie_engine.v / tokenizer_axi_lite.v: replace internal triage IDs
    (H1/H2/M1/M2/R2/L3) in comments with descriptive wording (comments only,
    no functional change)
    - README.md: comprehensive project overview (architecture, pipeline,
    register map, build/flash, usage, testing, results, limitations, doc index)
    [tokenizer_axi_lite.v, trie_engine.v]
