talsh123/tokenizer-vivado/(notices)

Notices in the files:
uart.gen/sources_1/bd/design_1/ip/design_1_axi_ethernet_0_0/header_files/design_1_axi_ethernet_0_0_axi4_lite_registers.h:
(c) Copyright 2012-2016 Advanced Micro Devices, Inc. All rights reserved.
